Lightingsang/AddinRebar/.agents/teamwork_preview_reviewer_m4_2/report.md

# Comprehensive Review & Adversarial Challenge Report: Live Verification Harness Audit

**Reviewer:** `teamwork_preview_reviewer_m4_2`  
**Milestone:** Milestone 4 (Automated Test Suites & Live Verification Harness)  
**Target:** `HPTekla/tools/harness/live-verify.py` and `HPTekla/tools/harness/run-live-verify.ps1`  
**Worker Under Review:** `teamwork_preview_worker_m4`  
**Date:** 2026-09-22  

---

## 1. Review Summary

**Verdict**: **APPROVE**

The live verification harness for Trimble Tekla Structures 2025.0 MCP (`HPTekla/tools/harness/live-verify.py` and `run-live-verify.ps1`) was thoroughly reviewed, statically analyzed, and dynamically executed. The harness strictly complies with repository conventions, correctly integrates `McpShared/tools/harness_common.py`, covers all required verification stages (Stages A through F), provides robust process and pipe detection, and gracefully handles detached bridge execution without integrity shortcuts, facade implementations, or hardcoded results.

All 17 checklist items executed cleanly in detached mode (13 passed, 4 skipped, 0 failed, exit code 0). Independent verification of all surrounding unit and regression suites (`HPTekla.Mcp.Server.Tests` [96], `HPTekla.McpBridge.Tests` [24], `HPRebar.Mcp.Server.Core.Tests` [742], `HPRebar.McpBridge.Core.Net48Tests` [113]) confirmed 100% pass rates and zero regressions.

---

## 2. Integrity Audit

An active audit for integrity violations was performed:
- **Hardcoded test results embedded in source code**: **NONE FOUND**. Every assertion dynamically parses and validates JSON-RPC responses emitted by the running `HPTekla.Mcp.Server.exe`.
- **Dummy or facade implementations**: **NONE FOUND**. Real stdio pipe communication via `subprocess.Popen` interacting with the real server executable.
- **Task shortcuts / bypassing intended work**: **NONE FOUND**. Stages A through F comprehensively cover handshake, context, reflection, read-only seeds, dry-run write verification, and real model mutation/reinforcement.
- **Fabricated verification outputs / logs**: **NONE FOUND**. Live execution of `run-live-verify.ps1` produced byte-level verified outputs matching the reported 13 passed, 4 skipped, 0 failed.
- **Self-certifying work**: **NONE FOUND**. Verification was executed independently with multiple parameter configurations (`-Stages "A,B"`, `-Stages "A,B,C,D,E,F"`, `-Out`).

---

## 3. Findings

### Positive Findings (Good Engineering Practices)
1. **Accurate Seed Schema Alignment**:
   - `create_column` and `create_rebar_group` invocations in Stage F accurately match the published input schemas in `HPTekla/HPTekla.Mcp.Server/Registry/SeedLibrary/`, including required fields (`fatherId`, `shapePoints`, `startX..endZ`), type constraints, and return DTO shapes (`id`, `profile`, `count`).
2. **Robust Multi-Stage Execution Filter**:
   - Both `live-verify.py` and `run-live-verify.ps1` support the `--stages` / `-Stages` parameter, allowing targeted execution of individual stages (e.g. `-Stages "A,B"` or `-Stages "E"`), writing structured artifacts when `--out` is specified.
3. **Graceful Detached Mode Handling**:
   - Stage F correctly queries context (`get_tekla_context`) and checks `ctx.get("isModifiable") and (ctx.get("tekla") or {}).get("isConnected")`. When headless or detached, it records clear `SKIP` messages for mutations instead of failing, making CI/CD and developer testing robust.
4. **Dual Process Detection**:
   - `run-live-verify.ps1` checks both `TeklaStructures` and `tekla` process names, ensuring compatibility across different installation shortcuts or execution modes.

### Minor Observations (Non-Blocking)
- In Stage B of `live-verify.py`, assertions B2 and B3 (`TeklaInfo block present` and `Foreign host properties omitted`) are guarded inside `if ok(ctx):`. When detached, B1 executes on the error message, and execution jumps directly to B4 and B5. The resulting item count is 17 total (13 passed, 4 skipped). In live mode, B2 and B3 would run, yielding 19 total checks (19 passed, 0 skipped). This is standard across similar harnesses in the repo (such as `HPNavis` and `HPRobot`), but documenting the difference between detached and attached check counts is good practice.

---

## 4. Adversarial Challenge & Stress-Testing

**Overall Risk Assessment**: **LOW**

### Challenge 1: Process running without Pipe Listener
- **Scenario**: Tekla Structures process is detected, but the HPTekla MCP Bridge plugin is not loaded, meaning the named pipe `hptekla-mcp-2025` does not exist.
- **Stress-Test**: Tested on the dev environment where PID 30316 was detected, but pipe `hptekla-mcp-2025` was inactive.
- **Observed Behavior**: `run-live-verify.ps1` correctly reported:
  `[INFO] Detected active Tekla Structures process (PID: 30316)`
  `[INFO] Named Pipe 'hptekla-mcp-2025' is NOT active (Bridge detached mode)`
  Server responded with descriptive error: `"Tekla Structures bridge not connected. Open Tekla Structures 2025 and ensure the HPTekla MCP Bridge plugin is loaded (Named Pipe: hptekla-mcp-2025)."`.
- **Verdict**: PASS. Gracefully handled without hanging or unhandled exceptions.

### Challenge 2: Missing Server Binary
- **Scenario**: `live-verify.py` is invoked with a non-existent or invalid executable path.
- **Stress-Test**: Executed `python HPTekla/tools/harness/live-verify.py --exe "non_existent.exe"`.
- **Observed Behavior**: Server instantiation failed fast with `FileNotFoundError`, exiting with code 1.
- **Verdict**: PASS. Fails cleanly with non-zero exit code.

### Challenge 3: Arbitrary Stage Filtering and Output Serialization
- **Scenario**: User requests subset of stages with custom output folder (`-Stages "A,B" -Out "HPTekla/output/test-run"`).
- **Stress-Test**: Executed command and verified generated artifacts.
- **Observed Behavior**: `live-verify.py` generated `summary-tekla.json` and `b-context.json` with exact counts (7 passed, 0 skipped, 0 failed), exiting with code 0.
- **Verdict**: PASS.

---

## 5. Verified Claims

| Claim by Worker M4 | Verification Method | Result |
|---|---|---|
| `live-verify.py` implements Stages A-F consuming `harness_common.py` | Direct source inspection & import path audit | **PASS** |
| `run-live-verify.ps1` checks process, pipe, and launches python | Script code inspection & execution | **PASS** |
| Live harness execution: 13 passed, 4 skipped (detached), 0 failed, exit code 0 | `powershell -ExecutionPolicy Bypass -File HPTekla/tools/harness/run-live-verify.ps1` | **PASS** (13 passed, 4 skipped, 0 failed, exit code 0) |
| `HPTekla.Mcp.Server.Tests` passes 96/96 | Executed `HPTekla.Mcp.Server.Tests.exe` | **PASS** (96 passed, 0 failed, duration 3.06s) |
| `HPTekla.McpBridge.Tests` passes 24/24 | `dotnet test HPTekla/HPTekla.McpBridge.Tests/HPTekla.McpBridge.Tests.csproj` | **PASS** (24 passed, 0 failed, duration 1s) |
| `HPRebar.Mcp.Server.Core.Tests` passes 742/742 | Executed `HPRebar.Mcp.Server.Core.Tests.exe` | **PASS** (742 passed, 0 failed, duration 2.83s) |
| `HPRebar.McpBridge.Core.Net48Tests` passes 113/113 | Executed `HPRebar.McpBridge.Core.Net48Tests.exe` | **PASS** (113 passed, 0 failed, duration 2.08s) |

---

## 6. Coverage Gaps & Unverified Items

- **Live Mutation inside Tekla Structures UI**: When Tekla Structures 2025 is actively running with the HPTekla Bridge plugin loaded and a modifiable model open, Stage F will execute mutations (creating column and stirrup rebar group). In the headless test environment, this was verified via detached skip handling, mock bridge round-trip tests in `HPTekla.McpBridge.Tests`, and Roslyn seed compilation against Tekla 2025 Open API in `HPTekla.Mcp.Server.Tests`. Risk level: **LOW** (covered by comprehensive unit and integration mock tests).
