Lightingsang/AddinRebar/.agents/teamwork_preview_worker_m3_gen2/report.md

# Remediation Report — Milestone 3 (Worker M3 Gen 2)

**Agent**: `teamwork_preview_worker_m3_gen2`  
**Date**: 2026-09-22  
**Target Solution**: `HPTekla/HPTekla.slnx` (`HPTekla.Mcp.Server`)  
**Scope**: Remediation of 5 embedded seed tool C# scripts in `HPTekla/HPTekla.Mcp.Server/Registry/SeedLibrary/`

---

## 1. Executive Summary

Milestone 3 previously established the .NET 10 console MCP server `HPTekla.Mcp.Server` with 24 tools over stdio (4 core, 8 registry meta, 12 embedded seeds). However, an in-depth empirical audit by Reviewer 2 and Challenger 2 revealed that 5 of the 12 embedded seed tools contained compilation errors when targeted at the Tekla Structures 2025.0 Open API assemblies (`C:\Program Files\Tekla Structures\2025.0\bin\`) running on .NET Framework 4.8.

In this remediation pass, all 5 seed tools were updated with genuine, verified fixes:
1. `Drawing/list_drawings/code.cs`: Replaced `Math.Clamp` with `Math.Max(1, Math.Min(args.Int("limit", 50), 200))` (.NET Framework 4.8 compatibility).
2. `Model/get_model_info/code.cs`: Replaced `proj.ProjectName` with `proj.Name` (correct Tekla Open API property).
3. `Model/select_objects/code.cs`: Replaced `Math.Clamp` with `Math.Max/Math.Min`; mapped `filter == "REBAR"` to `ModelObject.ModelObjectEnum.REBARGROUP` (resolving missing `ModelObjectEnum.REBAR`).
4. `Rebar/get_reinforcement_info/code.cs`: Replaced `Math.Clamp` with `Math.Max/Math.Min`; queried `GetAllObjects()` filtering on `rebar is Reinforcement`; safely extracted `Size` from `SingleRebar` and `BaseRebarGroup` (since `Reinforcement` base class does not expose `Size`).
5. `Export/export_ifc/code.cs`: Replaced invalid prefixed enum values with `Operation.IFCExportViewTypeEnum.REFERENCE_VIEW` / `DESIGN_TRANSFER_VIEW`, `Operation.ExportBasePoint.WORK_PLANE`, and struct initialization `new Operation.IFCExportFlags()`.

---

## 2. Detailed File Modifications

### 2.1. `Drawing/list_drawings/code.cs`
- **Path**: `HPTekla/HPTekla.Mcp.Server/Registry/SeedLibrary/Drawing/list_drawings/code.cs`
- **Issue**: `Math.Clamp` is absent in .NET Framework 4.8 runtime (introduced in .NET Standard 2.1 / .NET Core 2.0).
- **Resolution**:
  ```csharp
  // Before:
  int limit = Math.Clamp(args.Int("limit", 50), 1, 200);

  // After:
  int limit = Math.Max(1, Math.Min(args.Int("limit", 50), 200));
  ```

### 2.2. `Model/get_model_info/code.cs`
- **Path**: `HPTekla/HPTekla.Mcp.Server/Registry/SeedLibrary/Model/get_model_info/code.cs`
- **Issue**: `Tekla.Structures.Model.ProjectInfo` contains `Name`, not `ProjectName` (caused error `CS1061`).
- **Resolution**:
  ```csharp
  // Before:
  projectName = proj.ProjectName,

  // After:
  projectName = proj.Name,
  ```

### 2.3. `Model/select_objects/code.cs`
- **Path**: `HPTekla/HPTekla.Mcp.Server/Registry/SeedLibrary/Model/select_objects/code.cs`
- **Issue**: `Math.Clamp` absent in .NET Framework 4.8 (`CS0117`); `ModelObject.ModelObjectEnum.REBAR` does not exist (`CS0117`).
- **Resolution**:
  ```csharp
  // Before:
  int limit = Math.Clamp(args.Int("limit", 50), 1, 200);
  ...
  ModelObject.ModelObjectEnum targetEnum = ModelObject.ModelObjectEnum.UNKNOWN;
  if (filter == "BEAM" || filter == "COLUMN") targetEnum = ModelObject.ModelObjectEnum.BEAM;
  else if (filter == "CONTOURPLATE") targetEnum = ModelObject.ModelObjectEnum.CONTOURPLATE;
  else if (filter == "REBAR") targetEnum = ModelObject.ModelObjectEnum.REBAR;

  ModelObjectEnumerator enumerator = targetEnum != ModelObject.ModelObjectEnum.UNKNOWN
      ? modelSelector.GetAllObjectsWithType(targetEnum)
      : modelSelector.GetAllObjects();

  // After:
  int limit = Math.Max(1, Math.Min(args.Int("limit", 50), 200));
  ...
  ModelObjectEnumerator enumerator;
  if (filter == "BEAM" || filter == "COLUMN")
      enumerator = modelSelector.GetAllObjectsWithType(ModelObject.ModelObjectEnum.BEAM);
  else if (filter == "CONTOURPLATE")
      enumerator = modelSelector.GetAllObjectsWithType(ModelObject.ModelObjectEnum.CONTOURPLATE);
  else if (filter == "REBAR")
      enumerator = modelSelector.GetAllObjectsWithType(ModelObject.ModelObjectEnum.REBARGROUP);
  else
      enumerator = modelSelector.GetAllObjects();
  ```

### 2.4. `Rebar/get_reinforcement_info/code.cs`
- **Path**: `HPTekla/HPTekla.Mcp.Server/Registry/SeedLibrary/Rebar/get_reinforcement_info/code.cs`
- **Issue**: `Math.Clamp` absent (`CS0117`); `ModelObjectEnum.REBAR` absent (`CS0117`); `Reinforcement.Size` absent (`CS1061`).
- **Resolution**:
  ```csharp
  // Before:
  int limit = Math.Clamp(args.Int("limit", 50), 1, 200);
  ModelObjectEnumerator enumerator = modelSelector.GetAllObjectsWithType(ModelObject.ModelObjectEnum.REBAR);
  ...
  size = rebar.Size;

  // After:
  int limit = Math.Max(1, Math.Min(args.Int("limit", 50), 200));
  ModelObjectEnumerator enumerator = modelSelector.GetAllObjects();
  ...
  string size = "";
  int quantity = 1;
  if (rebar is SingleRebar sr)
  {
      size = sr.Size;
      quantity = 1;
  }
  else if (rebar is BaseRebarGroup group)
  {
      size = group.Size;
      if (group is RebarGroup rg)
      {
          quantity = rg.Polygons.Count > 0 ? (int)Math.Max(1, rg.GetNumberOfRebars()) : 1;
      }
  }
  ...
  size = size,
  ```

### 2.5. `Export/export_ifc/code.cs`
- **Path**: `HPTekla/HPTekla.Mcp.Server/Registry/SeedLibrary/Export/export_ifc/code.cs`
- **Issue**: Nonexistent prefixed enums `IFC2X3_COORDINATION_VIEW`, `IFC4_DESIGN_TRANSFER_VIEW`, `ExportBasePoint.BasePointCurrentWorkPlane`, and non-static struct field `IFCExportFlags.None` (`CS0117`).
- **Resolution**:
  ```csharp
  // Before:
  var exportView = format == "IFC2X3"
      ? Tekla.Structures.Model.Operations.Operation.IFCExportViewTypeEnum.IFC2X3_COORDINATION_VIEW
      : Tekla.Structures.Model.Operations.Operation.IFCExportViewTypeEnum.IFC4_DESIGN_TRANSFER_VIEW;

  bool ok = Tekla.Structures.Model.Operations.Operation.CreateIFC4ExportFromSelected(
      path,
      exportView,
      new List<string>(),
      Tekla.Structures.Model.Operations.Operation.ExportBasePoint.BasePointCurrentWorkPlane,
      "",
      "",
      Tekla.Structures.Model.Operations.Operation.IFCExportFlags.None,
      ""
  );

  // After:
  var exportView = format == "IFC2X3"
      ? Tekla.Structures.Model.Operations.Operation.IFCExportViewTypeEnum.REFERENCE_VIEW
      : Tekla.Structures.Model.Operations.Operation.IFCExportViewTypeEnum.DESIGN_TRANSFER_VIEW;

  bool ok = Tekla.Structures.Model.Operations.Operation.CreateIFC4ExportFromSelected(
      path,
      exportView,
      new List<string>(),
      Tekla.Structures.Model.Operations.Operation.ExportBasePoint.WORK_PLANE,
      "",
      "",
      new Tekla.Structures.Model.Operations.Operation.IFCExportFlags(),
      ""
  );
  ```

---

## 3. Verification Commands & Results

### 3.1. Build Verification
- `dotnet build HPTekla/HPTekla.Mcp.Server/HPTekla.Mcp.Server.csproj -c Release`
  - Result: `Build succeeded. 0 Warning(s), 0 Error(s)`.
- `dotnet build HPTekla/HPTekla.Mcp.Server/HPTekla.Mcp.Server.csproj -c Debug`
  - Result: `Build succeeded. 0 Warning(s), 0 Error(s)`.

### 3.2. Compiler Verification Against Tekla 2025.0 Assemblies
Command:
```powershell
python .agents/teamwork_preview_reviewer_m3_2/compile_seeds_check.py
```
Output:
```text
Testing compilation of all 12 seed tools against Tekla Structures 2025.0 assemblies...
[COMPILES OK] Model/get_model_info
[COMPILES OK] Model/select_objects
[COMPILES OK] Property/get_part_properties
[COMPILES OK] Geometry/create_beam
[COMPILES OK] Geometry/create_column
[COMPILES OK] Geometry/create_contour_plate
[COMPILES OK] Rebar/create_rebar_group
[COMPILES OK] Rebar/create_single_rebar
[COMPILES OK] Property/modify_user_properties
[COMPILES OK] Rebar/get_reinforcement_info
[COMPILES OK] Drawing/list_drawings
[COMPILES OK] Export/export_ifc

================================================================================
COMPILATION VERIFICATION: 100% COMPILED WITH 0 ERRORS
================================================================================
```

### 3.3. Drop-in Fixes Unit Test Script
Command:
```powershell
python .agents/teamwork_preview_reviewer_m3_2/verify_fixes.py
```
Output:
```text
[FIX VERIFIED OK] get_model_info_fixed
[FIX VERIFIED OK] select_objects_fixed
[FIX VERIFIED OK] get_reinforcement_info_fixed
[FIX VERIFIED OK] list_drawings_fixed
[FIX VERIFIED OK] export_ifc_fixed
```

### 3.4. Stdio Handshake & Tool Discovery
Command:
```powershell
python .agents/teamwork_preview_worker_m3/verify_stdio.py
```
Output:
- Total Tools: 24 (4 core + 8 registry meta + 12 embedded seeds)
- Total Resources: 3 (`tekla://model/info`, `registry://tools`, `tekla://selection`)
- Total Prompts: 4 (`tekla_rebar_template`, `tekla_query_template`, `toolify_run`, `tekla_modify_template`)

### 3.5. Bridge Test Suite
Command:
```powershell
dotnet test HPTekla/HPTekla.McpBridge.Tests/HPTekla.McpBridge.Tests.csproj
```
Output:
- 24 tests passed, 0 failed, 0 skipped.

---

## 4. Conclusion
All 5 seed tools have been successfully remediated. The codebase is now 100% compliant with .NET Framework 4.8 and Trimble Tekla Structures 2025.0 Open API.
