Lightingsang/AddinRebar/plans/reports/code-review-2026-09-17-aec-phase-g.md

# Code review — AEC Automation MCP (AutoCAD), phase G: MEP

Date 2026-09-17 · Plan `plans/260916-1140-aec-automation-mcp-autocad/` · Scope: `HPAutoCad.Aec` `Mep/{MepModel,MepNetworkBuilder,MepChecks}.cs`, `Cad/MepService.cs`, `AecTools.Mep.cs`, 3 seeds under `Registry/SeedLibrary/MEP/`, `AutocadHostProfile` (+MEP), `SeedLibraryTests` (43 seeds, shared detection pin), `HostProfileTests`, `MepTests` (4), harness step V (`aec-tools-live.py`).

Verified: `dotnet build HPAutoCad.slnx -c Debug -p:DeployBundle=false` 0 warnings · `dotnet test HPAutoCad.Aec.Tests` 195/195 · `dotnet test HPAutoCad.Mcp.Server.Tests` 241/241 · live harness not re-run (82/82 of 2026-09-17 taken as given; saved output `output/aec-tools-live/mep.json` read) · a scratchpad console against the built `HPAutoCad.Aec.dll` drove `MepNetworkBuilder.Build`, `MepChecks.Check`, `MepService.SystemOf/Describe` with synthetic `MepRun`/`MepNode`s (probes P1–P21, PERF A–E below) and serialised the envelopes with the bridge's options (camelCase + IgnoreCycles + WhenWritingNull; cap 65 536 B, budget 60 000 B).

> **Status 2026-09-17: fixed** — H1, H2, M1–M7, L1–L9 applied (see `plans/260916-1140-aec-automation-mcp-autocad/reports/phase-G-mep-live.md` § Review round); double-line ducts warned, not paired (as recommended); L10 closed by the report. Tests 197 + 241, live 83/83 + 89/89.

## Score: 5.5 / 10

The graph core does what the description says where it was probed: end-to-end joins, tees onto a body, ends inside a node box, crossings counted once per run pair and never connected, three stacked runs = three duplicates, a branch at the joint of two collinear mains joined to both, a zig-zag crossing twice = one crossing, `nearMissMm` below `endpointConnection` refused, near-miss partner chosen among runs and nodes, networks longest-first with ids stable on reversed input, issues after `AuditIssue.Ordered` with `MEP-nnn`, seeds thin shims with the three caps pinned, the shared `detection` block pinned across the three tools, culture-invariant descriptions, files ≤ 154 lines. Held back by two semantic defects that hit the default path of every real plan — a node a run passes *through* (an inline valve, pump, VAV, FCU drawn on a continuous line) is an `orphan_node` because nodes are only tested against run ends (H1); and a node merges every system that touches it, so supply + return + ducts through one AHU are one `mixed` network with a `mixed_system` info, on every piece of equipment (H2) — plus a 2 mm-off duplicate copy that reads as a tee with nothing reported (M1), two issues per facing gap (M2), an O(networks × endpoints) group loop that takes 21 s at the guard on disconnected runs and an O(pairs × segments²) pair phase (M3), and envelopes over the budget at the caps for `connectedTo`/`mixed_system` (M4).

## Findings

### High

| # | Where | Problem | Failure scenario | Pin |
|---|---|---|---|---|
| H1 | `Mep/MepNetworkBuilder.cs:59-70` (nodes tested only against the two run *ends*), `:97-101` (a node no end touched is an orphan), `MepChecks.cs:60-62`, seed `mep_connectivity_check` ("orphan_node … no run reaches") | A node the run passes through is never attached. P1: a 300 mm valve block and a 600 mm pump block centred on a continuous 10 m pipe → `orphans=[PUMP,VALVE]`, `orphan_node [PUMP] warning "equipment PUMP … no run reaches it"`, `orphan_node [VALVE] info`. P15: equipment the run crosses mid-body → warning. P19: a VAV box on the main with the branch ending inside it → **two networks** (`MAIN` alone; `BR+VAV`) although the main runs through the VAV. Inline valves, dampers, pumps, VAVs, FCUs drawn on an unbroken line are the norm in plumbing/HVAC plans. | `mep_connectivity_check {}` on a plumbing floor: one `orphan_node` info per inline valve (100+), one warning per inline pump/strainer/meter ("Draw the run to it"); `mep_detect_network` splits networks at every inline unit and lists the unit under `orphanHandles`. | xUnit: a fitting box centred on a continuous run → not an orphan, in the run's network; equipment the main passes through with a branch ending inside → one network. Fix: after the end pass, for every node query `runIndex` with the node's bounds expanded by `tol.EndpointConnection`, union when any run segment comes within `EndpointConnection` of the node's boundary or has a vertex inside it (`IntersectXY` against the ring's segments / `ContainsPointXY`); record the attachment (`end` / `inline`) on the node; `orphan_node` only when neither. |
| H2 | `MepNetworkBuilder.cs:67` (`union.Join(i, runs.Count + j)` whatever the systems), `MepModel.cs:78` (`System` = "mixed" when > 1), `MepChecks.cs:68-70`, `AecTools.Mep.cs:128` (`mixedNetworks`), plan phase G "networks by system" | A node unions every run that touches it, so systems merge through equipment. P2: CHWS + CHWR pipes and SA + RA ducts into one AHU → `N-001 system=mixed systems=[M-CHWR, M-CHWS, M-DUCT-RETN, M-DUCT-SUPL]` + `mixed_system` info "Check whether the runs really connect (a supply drawn onto a return) or whether the layers of one system are misnamed". Supply and return always meet at equipment; ducts and pipes always meet at an AHU/FCU. With the default (system = layer) every equipment-served network is mixed; a `detection.systems` map cannot help across disciplines. `bySystem` (per run) stays right, `items[].system`, `mixedNetworks` and the `mixed_system` list do not; the tool never delivers "networks by system". | `mep_detect_network {}` on an HVAC floor: one network per AHU cluster, every one `mixed`; `mep_connectivity_check {}` → one `mixed_system` info per AHU/FCU/pump (dozens), hiding the one real "supply drawn onto a return", which the description says the type is for. | xUnit: P2 → separate networks per system (CHW map: 2 networks — CHW pipes, and SA/RA still 2 unless mapped), `mixedNetworks 0`, no `mixed_system`; a CHWS run teeing into a CHWR run → one `mixed_system`. Fix: union runs through a node only when they share a system (group the node's touching runs by `run.System`); a node belongs to every network that touches it (listed in each `nodeHandles`); `mixed_system` fires only on run-to-run (joined/tee) connections across systems — exactly what the description promises. |

### Medium

| # | Where | Problem | Failure scenario | Pin |
|---|---|---|---|---|
| M1 | `MepNetworkBuilder.cs:125` (`IntersectXY(s, t, tol.PointEquality)` must return `Overlap` — collinear within 0.5 mm; `tol.Duplicate` only thresholds the overlap length), `:49-52` (an end within 10 mm of a body is a tee) | An offset copy is a tee, not a duplicate. P3: a 4 m copy of the main 2 mm off-axis → `COPY` ends `tee` to `MAIN` at both ends, `duplicates=0`, nothing reported, network `lengthMm` 14 000 for a 10 m main; at 0.4 mm it is a `duplicate_run`. The phase E M4 lesson (a copy not snapped is the common drafting artefact). | Copied runs a few mm off: no `duplicate_run`, totals inflated, both ends of the copy "connected". | xUnit: 2 mm-offset copy → `duplicate_run 4000`, ends not `tee`. Fix: a pair parallel within `parallelAngle` with offset ≤ `endpointConnection` and shared run > `tol.Duplicate` is a duplicate (compute the shared run by projection, as `CollinearOverlapXY` does); an end landing on a run its own segment is parallel to over > `tol.Duplicate` is not a tee. |
| M2 | `MepChecks.cs:49-53` (one `near_miss` per open end), `MepNetworkBuilder.cs:56,73` (each end finds the other) | A gap between two facing open ends is two issues naming each other. P21: `CHWS` end and `CHWR` start 30 mm apart → `MEP-001 near_miss [CHWR,CHWS] 30` + `MEP-002 near_miss [CHWS,CHWR] 30`; `summary.nearMisses = 2`. Two pipe pieces not snapped end to end is the most common gap. Phase F M2 class. | 40 unsnapped joints → 80 warnings, `nearMisses` doubled; `create_issue_markup` clouds every gap twice. | xUnit: P21 → one `near_miss`, both handles, location at the midpoint. Fix: when both ends are open and each is the other's nearest, emit once (unordered pair). |
| M3 | `MepNetworkBuilder.cs:99-106` (`endpoints.Where(e => e.IsOpen && handles.Contains(e.RunHandle))` per group — O(networks × endpoints), no `ct`), `:81-91` + `:120-136` (`LongestOverlap` and `Crosses` each walk `a.Segments × b.Segments` with no bounds check; `seen` is redundant — `Query` de-duplicates and `k <= i` skips) | PERF A: 20 000 disconnected 400 mm runs → **20.8 s** (5 000 → 1.0 s; 20 000 runs in 100 chains → 0.3 s) — the cost is the group loop, and it ignores `cancel_execution`. PERF D: 60 arcs (113 vertices each) whose bounds overlap → 5.5 s; PERF E: 200 sixty-vertex polyline routes in one plant room → 10.1 s; 400 stacked arcs → 237 s. The seed timeout is 60 s and `MaxElements` admits 20 000. | A tray/pipe plan drafted as thousands of unsnapped LINEs (the input a connectivity check exists for) or a plant room of long polyline routes / sampled arcs → 20–60 s on AutoCAD's main thread, uncancellable in the group phase. | Test: 20 000 disconnected runs < 2 s; 200 × 60-vertex routes < 2 s. Fix: group open ends by run handle once (dictionary) and build `open` per network from it; in the pair phase test segment bounds (or a per-shape segment index above ~16 segments) and compute overlap + crossing in one walk; `ct` in the group loop; drop `seen`. |
| M4 | `MepModel.cs:70` (`ConnectedTo` uncapped), `Cad/MepService.cs:121`, `MepChecks.cs:69` (`mixed_system` 8 handles + every system name in the description), `MepTests.cs:129` (3 `connectedTo`), no issues-page size test | Envelopes at the caps: `mep_endpoint_check` 200 endpoints with `connectedTo` of 6 handles → 57.9 KB (6-char handles), **64.3 KB** (10-char); 8 handles → **61.5 KB** (6-char). A header/manifold where 6–8 runs start at one point is ordinary. Issues page 100 × `mixed_system` (8 handles, 8 systems) → **61.0–65.8 KB**; 5 systems, 10-char handles 59.5 KB — at the budget; under H2 semantics `mixed_system` pages are realistic. | `mep_endpoint_check {includeConnected: true}` on a manifold plan → head-as-text; page 2+ of `mep_connectivity_check` on a plan with many AHUs → over the cap. | Size tests: endpoints at 200 with 8 `connectedTo`; issues at 100 `mixed_system` with 8 systems and 10-char handles < 60 000. Fix: cap `connectedTo` at 4 + `connectedCount`; `mixed_system` handles 4 and systems in the description ≤ 4 ("… and N more"). |
| M5 | `AecTools.Mep.cs:43` (the "no runs found" warning is in `MepDetectNetwork` only), `MepChecks.cs:60-62` (orphans reported whatever `Runs`) | With no runs (fixtures-only plumbing layout, the wrong layer names, `filter.layers` naming the equipment layer) `mep_connectivity_check` lists every fixture/terminal/equipment as an `orphan_node` **warning** and `mep_endpoint_check` says nothing. Phase E M2 class. | A fixture layout with 200 WC/basin blocks and no pipes → 200 warnings over two pages, `success: true`. | Test: `Runs == 0` → the same warning in all three tools and no `orphan_node` (or info). |
| M6 | Seed descriptions (nothing on drafting style; "a duct drawn as a closed rectangle is not a run here"), `Cad/MepService.cs:67` (only closed shapes are set aside) | Double-line ducts — how most 2D HVAC plans are drawn — read as two side-line networks. P9: a duct with an elbow drawn as four side lines → `N-001 [S2,S4]`, `N-002 [S1,S3]`, 4 open ends for 2 real ends, `lengthMm` doubled, no hint. | `mep_detect_network {}` on a double-line HVAC plan: networks per duct side, every real end twice under `open_end`, `totalLengthMm` ×2. | Description: single-line (centreline) drafting. Heuristic warning: when > 30 % of duct runs have a parallel duct run within ~1 500 mm over > 50 % of their length, warn "double-line duct drafting: networks and open ends are per side". Pairing sides into centrelines is a product decision (Unresolved). |
| M7 | `MepNetworkBuilder.cs:47` (`if (k == i) continue;` — the run's own body excluded from both the connection and the nearest search) | A ring main drawn as one polyline whose ends stop 60 mm apart (P4) is `disconnected_run` "connects to nothing at either end" with no near miss; a P-shaped polyline whose end lands on its own body (P5) is likewise disconnected. Phase F M3 class. | An almost-closed loop → the wrong issue type and no gap size; a loop drawn as one polyline is "loose at both ends". | xUnit: P4 → `near_miss 60` (or one `boundary`-style gap); P5 → the end `tee` onto its own body. Fix: test an end against its own segments except the adjacent one, and against its own other end. |

### Low

| # | Where | Problem |
|---|---|---|
| L1 | `MepNetworkBuilder.cs:89` (`MepDuplicate(runs[i].Handle, runs[k].Handle)` in input order), `:56,69` (`d < nearestGap` — first encountered wins a tie) | P16: reversed input → the same duplicates with `handles[0]`/`[1]` swapped → different `AuditIssue.Ordered` order and ids (networks and counts stable). Order the pair by handle; tie-break the nearest by handle. |
| L2 | `Cad/MepService.cs:35-40` (`SystemOf`: first declared pattern wins), `:22-33` (`ParseSystems` accepts a blank key after `Trim`) | P13/P13b: `{CHW:[M-CHW*], HHW:[M-*]}` → `M-CHWS` is CHW; reversed declaration → HHW. Undocumented; document "first match in declaration order" or refuse overlapping patterns; refuse blank system names. |
| L3 | `Cad/MepService.cs:47-56` (`examined` = pass 1; `Classify` builds the text index on each pass), `AecTools.Mep.cs:111` (one truncation text for both passes), `EntityQueryService.TryBuildSelection` (block names never reach the selection engine) | `mep.json`: `examined: 10` while pass 2 scanned every INSERT; the second pass post-filters *every* INSERT in the space by name, so on a furnished plan it hits `maxCandidates` first and the warning blames "runs beyond it"; the text index is built twice per call though no MEP rule uses text (`UsesNearbyText` is set-wide) — pass `(TextIndex.Empty, false)`; sum both passes into `examined`. |
| L4 | Rule set `m-duct-run` / `e-tray-run` (no `ARC`, no `SPLINE` anywhere; `m-duct-run` has no `closed: false`), `m-fitting-block` (`CO-*`, `*-CO-*` on any layer), no riser/cap rule | Description says "open lines, polylines, arcs" for all three run kinds — a curved duct/tray as an ARC is not a run; flex ducts (SPLINE) never are, so their diffusers are orphans; a closed outline on a duct layer is counted under `closedRunsIgnored`, on a pipe layer it is Unknown and not counted; a pipe ending at a riser circle (`M-PIPE-RISR`) is an `open_end`; any `CO-…` block anywhere becomes a Fitting → `orphan_node` info. |
| L5 | `Cad/MepService.cs:64-68` (only `IsPoint` skipped) | P8: a zero-length LINE is a run — alone it is `disconnected_run "0 mm"`, at a junction it joins the network. Drop runs shorter than `tol.TinySegment` with a `tinyRunsIgnored` count. |
| L6 | `Cad/MepService.cs:42` (no check), cf. `RoomService.cs:28` | `filter.space: "all"` merges model and every layout into one graph (riser diagrams in layouts share coordinates with the model). Refuse as the rooms do, or group by space. |
| L7 | `AecTools.Mep.cs:105` (`<` refused, `==` allowed), `MepNetworkBuilder.cs:73` | `nearMissMm == endpointConnection` disables near misses: P14 (10.5 mm gap, nearMissMm 10) → two `disconnected_run`. Say so in the description or require `>`. |
| L8 | `MepChecks.cs:69` (`n.BoundsMm.Center`), `AecTools.Mep.cs:126` (`bySystem` top 20), `SeedLibraryTests.cs:68-70` (comment lists 14 read-only seeds), seed schema `detection.systems` (`type: object`, no `additionalProperties`) | `mixed_system` location may lie on no run; `bySystem` cut undocumented; stale test comment; the AI cannot see the `systems` value shape (`{name: [wildcards]}`) except from example 2 — add `additionalProperties: {type: array, items: {type: string}}`. |
| L9 | `MepNetworkBuilder.cs:72` (`joined` > `tee` > `node`) | P6: two branches starting at one point on the main read `joined` (to each other) though what matters is the tee onto `MAIN` (in `connectedTo`). State = the first thing found; consider ranking the body connection or listing states. Cosmetic. |
| L10 | `phase-G-mep-network.md` (`status: pending`, success criterion unchecked), `plan.md:32` (pending), no `reports/phase-G-mep-live.md` | For the lead/project-manager, not a code finding. |

## Description ⇔ code

| Seed | Mismatch |
|---|---|
| `mep_detect_network` | "open lines, polylines, arcs" — ARC only in the pipe rule, no SPLINE (L4); "touches a node" / node handling — a run *through* a node is not a connection (H1); "system (one, or mixed)" — mixed on every equipment-served network (H2); "runs that only cross each other … counted" ✓ once per pair; `runHandles`/`nodeHandles` first 16, `openEndsMm` first 8 ✓ (52 KB at 30 with 5 systems / 3 kinds / 4 node kinds); summary keys ✓ (+ `examined`, `nearMissMm`, `systems`, `ruleSet`; `bySystem` top 20 unsaid); `filter` "empty = model space, narrowed…" ✓ (`space` alone still narrows); `detection.nearMissMm` "must be ≥" — equal disables (L7); "max 30 networks per page" ✓ pinned. |
| `mep_connectivity_check` | `orphan_node` "no run reaches" — false for inline nodes (H1); `mixed_system` "a network joining runs of several systems" — every network with equipment (H2); `duplicate_run` "drawn over each other" — collinear within 0.5 mm only (M1); `near_miss` — twice per facing gap (M2); `disconnected_run` "one issue for a run loose at both ends with nothing near" ✓ (also requires no branch landing on it — say so); "severity order", `MEP-nnn`, `create_issue_markup` ✓ (markup is category-agnostic); "max 100 issues per page" — 61–66 KB with `mixed_system` items (M4). |
| `mep_endpoint_check` | Item fields ✓; "near misses first" ✓; `connectedTo` uncapped (M4); summary ✓ (+ `examined`, `runs`, `nearMissMm`, `includeConnected`); "max 200 endpoints per page" — over budget at 6+ `connectedTo` (M4). Example 2 (`filter.layers`, `includeConnected`) keys real ✓. |

All three: `transaction: none` ✓, one `AecTools.*` call, every key read with a literal ✓, `limit.maximum` = engine cap ✓, `detection` keys = `MepDetectionKeys` ✓, category `MEP` added and pinned ✓, earlier seeds unchanged (40 → 43, 23 → 26 read-only) ✓.

## Tests — what `MepTests` pins and what is missing

Pinned (4): join / tee / node / crossing with 2 networks and 5 open ends; near miss 50 mm + `disconnected_run` once + duplicate 4000 + orphan terminal warning / fitting info + `MEP-001` + `nearMissMm 20` hides the miss; `SystemOf` wildcards and case, a two-system network `mixed` + `mixed_system`, a parallel run of another system not a duplicate; networks page at 30 and endpoints page at 200 (3 `connectedTo`, 2 systems, one kind) < 60 000 B. `SeedLibraryTests` pins shim shape, `transaction`, "Read-only", `limit.maximum`, the shared detection block, 43 seeds / 26 read-only; `HostProfileTests` pins the category.

Missing: inline node (valve on a continuous run, run through equipment); supply/return through one node; offset duplicate (2 mm); facing-gap pairing; self-gap / end on own body; zero-length run; reversed-input determinism of issues; `MaxElements` refusal; cancellation in the group loop; timing at the guard (20 000 disconnected runs, 60-vertex routes); issues-page size (`mixed_system` with 8 systems); endpoints page with 8 `connectedTo`; `ParseSystems` (scalar instead of array → message, duplicate key, blank key); `Describe(endpoint)` for a run absent from `runs`; `nearMissMm == endpointConnection`; `Narrow` (no layered MEP rules → null; user rule with types only dropped). Harness V never sends `includeConnected` with `offset`, `ruleSet`, `visibleOnly`, `space`, a closed polyline on a run layer, a fitting block by name (pass 2 found nothing — `examined: 10`), an ARC run, an inline node, or two systems through one piece of equipment — so H1/H2 and `closedRunsIgnored` are not exercised live.

## Positive

`MepNetworkBuilder` is short and readable: one spatial-index pass per end with `reach = max(nearMissMm, endpointConnection)`, union-find with path halving, deterministic handle ordering everywhere (`Length` then ordinal), networks id'd after sorting by length so ids survive reversed input (probed), crossings counted once per run pair through `CrossesProperlyXY` (a tee onto a body is not a crossing; a zig-zag crossing twice is one), duplicates require the same system (case-insensitive) and the shared stretch is reported with `from`/`to`; `MepChecks` reuses `AuditIssue`/`Ordered`/`IssueSeverity` so `create_issue_markup` consumes MEP issues unchanged, folds a loose run into one `disconnected_run` instead of two open ends, keeps a main whose branches tee in "attached", uses `CultureInfo.InvariantCulture`; `MepService.Narrow` spends `maxCandidates` on MEP layers/types and fitting block names when the filter names none (the phase F M11 lesson applied) and warns when it narrowed, truncated or dropped closed outlines; `ParseSystems` refuses an empty pattern list and a duplicate key with clear messages; `ReadMep` rejects unknown `detection` keys and `nearMissMm` below the connection tolerance as `ArgumentException`s; the three seeds are thin shims with `MaxNetworkLimit 30` / `MaxIssueLimit 100` / `MaxEndpointLimit 200` pinned to the schema maxima, one shared detection block pinned by a test, and the harness pins counts, handles, the 50 mm gap, the layer map, `endpointConnection 60` merging the short branch, `includeConnected`, and the `nearMissMm` refusal; every file is under 160 lines.

## Recommended order

1. H1 + H2 (one change in `Build`: a node-attachment pass over runs whose segments touch or enter the node; union through a node per system; `orphan_node` only when neither an end nor a body reaches it; `mixed_system` on run-to-run joins across systems only) with the P1/P2/P15/P19 cases as tests.
2. M1 + M2 + M7 (offset duplicates by parallel projection; a self-body test excluding the adjacent segment; pair facing near misses) — tests P3, P4, P5, P21.
3. M3 + M4 (group open ends per run once; segment bounds in the pair phase; `ct`; `connectedTo` ≤ 4 + count; `mixed_system` 4 handles / 4 systems) with the timing and size tests.
4. M5 + M6 + the Lows (no-runs warning in all three tools; single-line statement + double-line heuristic; handle-ordered duplicates and tie-breaks; `space: all` refused; `examined` both passes; empty text index; ARC/SPLINE in the duct/tray rules; tiny runs dropped; `systems` schema value shape), then re-run V with an inline valve on the pipe main, supply + return + duct through one AHU block, a 2 mm-offset copy, two facing ends 30 mm apart, a fitting block named `VALVE-DN50`, a closed polyline on `M-DUCT`, and a double-line duct.

## Unresolved (user decision)

- M6: should double-line ducts be supported (pair parallel side lines within a duct-width band into a centreline run, so networks, lengths and open ends are per duct) or should the tools state single-line drafting and warn when they detect double lines? Recommended: warn now, pair later as its own phase — pairing changes what `runHandles` means.
