Lightingsang/AddinRebar/plans/reports/code-review-2026-09-17-aec-phase-f.md

# Code review — AEC Automation MCP (AutoCAD), phase F: architecture

Date 2026-09-17 · Plan `plans/260916-1140-aec-automation-mcp-autocad/` · Scope: `HPAutoCad.Aec` `Architecture/{RoomLoopFinder,WallGraph,Room,RoomBoundaryChecks,AreaSchedule,AutoDimensionRules}.cs`, `Cad/{RoomService,RoomWriteService(+.Dimensions),EditContext.Layers}.cs`, `AecTools.Architecture.cs`, 5 seeds under `Registry/SeedLibrary/Architecture/`, `AutocadHostProfile` (+Architecture), `SeedLibraryTests` (40 seeds), `ArchitectureTests` (9), harness steps R (`aec-tools-live.py`) and A (`aec-edit-tools-live.py`), the shared `EnsureLayer` refactor in `IssueMarkupService` / `StructuralWriteService`.

Verified: `dotnet build HPAutoCad.slnx -c Debug -p:DeployBundle=false` 0 warnings · `dotnet test HPAutoCad.Aec.Tests` 188/188 · `dotnet test HPAutoCad.Mcp.Server.Tests` 221/221 · live harness not re-run (73/73 + 86/86 of 2026-09-17 taken as given; saved output `output/aec-tools-live/architecture.json` read) · a scratchpad console against the built `HPAutoCad.Aec.dll` drove `RoomLoopFinder`, `RoomBoundaryChecks`, `RoomLabels`, `AreaSchedule`, `AutoDimensionRules`, `RoomWriteService.Render` with synthetic `WallSegment`s (22 probes, P1–P22 below) and serialised the envelopes with the bridge's options (camelCase + IgnoreCycles + WhenWritingNull; cap 65 536 B, budget 60 000 B).

> **Status 2026-09-17: fixed** — H1–H5, M1–M12, L1–L9, L11, L12, L14 applied (see `plans/260916-1140-aec-automation-mcp-autocad/reports/phase-F-architecture-live.md` § Review round); openings, gross area and the number pattern decided as recommended; L10, L13 documented, L15 closed by the report. Tests 191 + 222, live 75/75 + 89/89.

## Score: 5 / 10

The planar-graph core is right where it was probed: crossings, T-junctions, collinear overlaps and coincident duplicates cut and merge into one edge with both handles; a zig-zag (a wall crossing another twice) yields the four faces; a figure-8 pinch node gives two rooms; snapping cascades converge; every directed edge is walked exactly once so a face can neither repeat nor loop forever; 20 000 unit segments build and walk in 0.5 s; ids are stable on reversed input (pinned). The writes are two-phase in the right order (`SpaceId` → layer check → render every tag → `GetObject(ForWrite)` → `EnsureLayer` → append; `SetDatabaseDefaults` before `LayerId`; a refusal leaves the counter at 0 — the harness pins `count() == n_a`), the seeds are thin shims, the read caps are pinned, and the shared `EnsureLayer` is byte-equivalent to the two copies it replaced. Held back by five things that hit the tool's own target inputs: the loop finder has no notion of an opening, so any plan whose walls stop at doors yields zero rooms (single-line) or one merged room per floor (double-line with jambs) (H1); two correctly tiled room outlines are a `room_overlap` warning because `SpatialRelation.Overlaps` counts a shared boundary run, so a plan drawn with outlines gets one warning per adjacent pair (H2); the `Nested` rule drops the room for any inner enclosure — a closet hung off the wall by one partition, a shaft in a hall — and reports only the closet (H3); `arch_auto_dimension_plan` at `MaxDimensions` 200 serialises to 64–66 KB, over the budget and over the cap with 7-digit coordinates, with the dimensions committed (H4, third phase in a row for a write tool); and the overshoot rule silently swallows a real gap whenever the nearest wall's foot coincides with the chain's junction (a jamb 100 mm from a partition end) while it reports an angled overshoot as `open_boundary` critical (H5).

## Findings

### High

| # | Where | Problem | Failure scenario | Pin |
|---|---|---|---|---|
| H1 | `Architecture/RoomLoopFinder.cs:40-67` (faces of the wall graph only), `WallGraph.cs:81-120` (every free end peeled), seed `arch_detect_rooms/tool.json` description ("every bounded face … is a room"; no word on doors), rule set `a-wall-run` (walls only; `a-door-*` objects never enter the graph) | There is no notion of an opening. Probe P2 (single-line room, 900 mm door in one wall): **0 rooms**, two `open_boundary` criticals "no wall within reach". P2b (two rooms, doors in the party wall and the outer wall): 0 rooms, 3 open ends + 1 silent "overshoot". P2c (double-line walls, 200 thick, jamb lines closing the wall cavity at a 900 door): **1 room of 22.98 m²** = both rooms merged through the opening, the outer ring dropped as nested. Walls that stop at door openings are how most plans are drafted; the harness scene has no door in a wall. | `arch_detect_rooms {}` on a real floor plan → `rooms: 0` + one critical per jamb (single-line) or `rooms: 1` per connected block of rooms (double-line); `arch_generate_area_schedule` sums the whole floor into one row; `arch_create_room_tags` puts one tag on the corridor. Explicit outlines still work, which is why the harness passes. | xUnit: P2 → 1 room 24 m² with `openings: 1` (900 mm, S1→S2); P2c → 2 rooms. Fix (recommended, see Unresolved): after peeling, bridge pairs of open ends that face each other within `maxOpeningMm` (default 1 300; collinear within `parallelAngle`, or jamb-to-jamb across a double-line opening) with a virtual edge, re-walk, and report `openings[{fromHandle, toHandle, widthMm}]`; additionally let `Door`-classified objects (swing arc / block bounds) close the gap they sit in. Until then the description must say walls have to be continuous through doors. |
| H2 | `Architecture/RoomBoundaryChecks.cs:68` (`SpatialPredicates.Evaluate(a, b, SpatialRelation.Overlaps)`), `Spatial/SpatialPredicates.cs:58-70` (`Overlaps` = `CollinearOverlaps(...).Count > 0` **or** any vertex inside incl. on the boundary) | Two outlines that share a wall edge — the correct way to draw room outlines — "overlap": probe P21, a 2×2 block of tiled outlines → **6 `room_overlap` warnings** (every pair, the diagonal pair sharing a single corner included). A room outline inside a zone outline reports nothing. | A 60-room plan drawn with `A-ROOM` polylines → ~150 warnings "Room outlines must tile the floor; trim them to the shared wall" for a plan that already does; two pages of noise hide the one real overlap. `create_issue_markup` of the result draws a cloud on every party wall. | xUnit: two outlines sharing an edge → no issue; sharing a corner → no issue; offset by 1 000 → `room_overlap`; one strictly inside the other → (new) `room_inside_room` info. Fix: in `RoomBoundaryChecks` test interior overlap only — a vertex of one strictly inside the other (`DistanceToBoundaryXY > tol.PointEquality`) or a proper crossing (`IntersectionPoints(proper: true)`), never a shared run. |
| H3 | `Architecture/RoomLoopFinder.cs:65` (`nested` = a loop that contains every vertex of another kept loop; `ContainsPointXY` counts boundary points as inside) | The rule meant for the outer line of a double-line wall fires on any inner enclosure. P5 (6×4 m room, a 1.5×1.5 m closet hung off the south wall by one partition): **only the closet is a room** (`nested: 1`), the 24 m² room is gone — the room's face ring runs around the closet, so every closet vertex lies *on* the room ring. P6 (12×8 m hall, free-standing 2×2 m shaft inside): only the shaft (4 m²); the 96 m² hall is dropped. | Any plan with a shaft, a WC cubicle, a kiosk or a duct riser drawn on the wall layer inside a larger room: the large room disappears from `arch_detect_rooms`, the area schedule and the tags; `unlabelled_room` fires for the closet. Undetectable from the summary (`nested` is just a count). | xUnit: P5 → 2 rooms (24 m² incl. or excl. the closet — see Unresolved) and P6 → 2 rooms; the pinned double-line case keeps `nested: 1`. Fix: a container is the outer line of a wall only when every vertex of the nested loop is within `MaxWallThicknessMm` (~500) of the container's ring (or the container's ring is entirely within that band of the nested ring); otherwise keep both, list the inner loop under `islands[]` and report `netAreaMm2`. Adjacent faces (sharing an edge) must never nest — test strictly inside. |
| H4 | `Cad/RoomWriteService.Dimensions.cs:12` (`MaxDimensions` 200), `:64` (`summary.dimensions` echoes every plan: rule, subject, side, 3 points, measurement ≈ 200 B), `AecTools.Architecture.cs:136-137` (200 plans reach the write) | Envelope at the cap: 200 dimensions with 6-digit coordinates **64 350 B**, with 7-digit coordinates (site plans, state-plane drawings in mm) **65 550 B > 65 536** — head-as-text with 200 DIMENSION entities committed; 150 → 49 200 B, 120 → 39 390 B. The comment says "each is ~150 B" — it is ~320 B (items + summary). Same class as phase E H1 / phase D. | `arch_auto_dimension_plan {rules:[{rule:"overall", sides:["bottom","top","left","right"]}]}` on 50 rooms = 200 plans → committed, envelope unreadable, `affectedHandles` lost. | xUnit like `EditResultTests`: `WriteDimensions`-shaped envelope at `MaxDimensions` with 7-digit coordinates < 60 000 B. Fix: `MaxDimensions` 120, and drop `summary.dimensions` when `apply` (items carry `changed: [rule:subject:side, N mm]`) or list only `bySubject`. |
| H5 | `WallGraph.cs:112-116` (overshoot ⇔ the nearest other wall's closest point to the tip is within `roomGap` of the chain's attachment node), `:153-170` (`Describe`: nearest point in any direction, `reach` = 12 × roomGap) | (a) A real gap is swallowed whenever the nearest wall's foot is the junction: P2b — the door-side end of wall `S2` stops 900 mm short, but partition `M1` stands 100 mm from that end and meets `S2` at the junction → `overshoots: 1`, **no open end reported**; P7a — a 150 mm stub hanging off the north wall that misses the partition it should meet by 200 → `overshoots: 1`, nothing reported. (b) An angled wall's overshoot is not recognised: P1 — a 45° wall crossing the room (`Z`, 500 mm past each wall) → 4 `open_boundary` criticals "no wall within reach" (the foot of the perpendicular is 500 mm from the crossing node; `reach` 300 hides the wall it crosses). | (a) `arch_room_boundary_check` says "0 open ends" for a plan whose doors sit next to partitions — exactly where gaps hide; (b) every diagonal wall that overshoots a corner is a critical. | xUnit: P2b → `S2@(3900,0)` reported as `boundary_gap`/`open_boundary`; P7a → `K` reported with `nearestGapMm 200`; P1 → `overshoots: 4`, no open end. Fix: overshoot ⇔ the peeled chain is a single handle whose wall continues past the attachment node (an edge with the same handle on the other side) **and** the chain is shorter than the reach; drop the nearest-foot heuristic. |

### Medium

| # | Where | Problem | Failure scenario | Pin |
|---|---|---|---|---|
| M1 | `WallGraph.cs:167` (`reach = Math.Max(gapMm, tol.RoomGap) * 12` — unnamed multiplier; `gapMm` is always `tol.RoomGap`), `RoomBoundaryChecks.cs:45` (`gap <= maxGapMm`), seed `arch_room_boundary_check` example 2 (`tolerance.roomGap: 0.5, maxGapMm: 500` — "walls up to 500 mm apart count as gaps") | The nearest wall is only reported within 300 mm whatever `maxGapMm` says; with `roomGap: 0.5` the reach is **6 mm**. P9: a 400 mm gap with `maxGapMm: 500` → two `open_boundary` criticals with `valueMm: null` "no wall within reach". The seed's own example never produces a `boundary_gap`. | `maxGapMm` > 300 is a no-op; `roomGap` < 25 turns every open end into "no wall within reach". | xUnit: 400 mm gap + `maxGapMm 500` → `boundary_gap` 400. Fix: pass `maxGapMm` into `Find`/`PeelDangling` as the reach (named constant for the default), independent of `roomGap`. |
| M2 | `RoomBoundaryChecks.cs:42-53` (one issue per open end), `WallGraph.cs:81-120` (both ends of one gap are tips) | One gap = two issues naming each other: P11 → `ARC-001 boundary_gap S+W @(0,0)` and `ARC-002 boundary_gap W+S @(0,200)`. Counts (`bySeverity`, `openEnds`) double; the harness pins `openEnds == 8` for 4 problems. | 30 gaps → 60 warnings, two pages. | xUnit: one gap → one `boundary_gap` (handles both, location at the midpoint or the first tip). Fix: pair open ends whose nearest is each other (unordered handle pair + points within `maxGapMm`) before emitting. |
| M3 | `WallGraph.cs:161` (`if (p.Handle == handle) continue;` in `Describe`), `RoomLoopFinder.cs:87` (`CloseGaps` skips only `ReferenceEquals(other, piece)`) | A polyline outline with a gap (one handle) closes its own gap ≤ roomGap (harness "openroom" 12 mm) but a wider one is reported as **two `open_boundary` criticals "no wall within reach"** because its own segments are excluded from the nearest search: P13 (200 mm gap) → `PL v=null` ×2. Inconsistent with the LINE case (`boundary_gap` 200). | The most common "almost closed" outline (an unclosed polyline) gets the wrong severity and no gap size. | xUnit: P13 → `boundary_gap 200`. Fix: exclude the tip's own *piece* (and its adjacent piece), not its handle. |
| M4 | Room ids are positional (`RoomService.cs:46,55`, sorted `RoomLoopFinder.cs:66`) but the tools that accept `roomIds` do not take the inputs that decide the set: `arch_create_room_tags` / `arch_generate_area_schedule` have no `tolerance` / `minAreaMm2` / `minWidthMm` (`AecTools.Architecture.cs:77,95` pass `ScriptArgs.Empty` / 0), `arch_auto_dimension_plan` has `tolerance` but not the size floors; `maxCandidates` differs (tags: ceiling 100 000; detect/dimension/schedule: 5 000 default) | `arch_detect_rooms {tolerance:{roomGap:50}}` (the seed's own example 2) lists `R-003`; `arch_create_room_tags {roomIds:["R-003"]}` detects with roomGap 25 → a different set → `R-003` is another room or "not a detected room". On a > 5 000-entity plan detect and tags disagree on the candidate set even with default args. | A tag lands on the wrong room; the schedule's `roomIds` filter names the wrong rows. Nothing in the envelope reveals the shift. | xUnit over `RoomService.Select` cannot catch it; pin at the seed level: the four tools share one `roomDetection` argument block (`tolerance`, `minAreaMm2`, `minWidthMm`, `maxCandidates`) — `SeedLibraryTests` asserts the same keys on all four; and/or make the id content-based (hash of the rounded inside point) so an id survives a tolerance change. |
| M5 | `Architecture/Room.cs:79` (`DefaultNumberPattern` `^[A-Z]{0,2}-?\d{1,4}[A-Z]?$`), `:112-116` (first match by distance to the centroid wins) | The default takes every mark: P14 — texts `B01`, `101`, `PHONG KHACH`, `D01`, `C1` in one room → `number = "B01"` (nearest to the centroid). It matches `C1`, `D01`, `W1`, `S-1`, `KT-12`, `R101`, `1` (a grid label) and **not** `P.101`, `1.01`, `01.02` (Vietnamese/European numbering) nor `PHONG 101`. The harness had to narrow it to `^\d{3}$`. | Any plan carrying door/column/window tags inside rooms: the room number is a mark; area rows read "B01 PHONG KHACH". | xUnit with the P14 text set → `101`. Fix (default only, still overridable): letters require a separator — `^(?:[A-Z]{1,3}[-.]\s?)?\d{2,4}[A-Z]?$` (`101`, `A-101`, `P.101`, `1.01` via `[-.]`… yes; `B01`, `C1`, `D01` no) — and expose `numberCandidates[]` so the caller sees what was skipped. |
| M6 | `Cad/RoomService.cs:62-65` (a label = one TEXT/MTEXT record), `Cad/EntityShapeReader.cs:153` (`MText.Text`), `RoomLabels.Apply` (whole string matched) | A two-line MTEXT room tag ("OFFICE\P101" — the usual single-MTEXT tag, and exactly what `arch_create_room_tags` writes) is one label: the number regex cannot match a string with a paragraph break, so `number = null` and `name = "OFFICE⏎101"` (P14b; `Name` carries the break into `{name}` of the next tag). Re-running detect after tagging therefore reads the tool's own tag "OFFICE⏎24 m²" as the name → the second `arch_create_room_tags` renders "OFFICE⏎24 m²\P24 m²" (idempotence). | Plans tagged with multi-line MTEXT (most) → unlabelled or garbage names; tag twice → nested tags. | xUnit: label text "OFFICE\n101" → number 101, name OFFICE. Fix: split MTEXT text on `\P` / `\n` into lines and treat each line as a label (same handle); optionally exclude texts on the tag layer from labelling. |
| M7 | `Room.cs:35-53` (`handles`, `textHandles` unbounded), `AecTools.Architecture.cs:17-18` ("~1.5 KB per room"), `ArchitectureTests.cs:180-195` (size test assumes 12 handles + 6 texts) | Both lists are uncapped and set by the drawing: P22 — 30 rooms × 32 vertices with 40 wall handles + 30 texts each → **60 591 B**; 4 vertices with 60 handles + 200 texts → **77 571 B** (an open-plan office with desk labels; a room drawn from many short wall pieces). The test's 12/6 assumption is the friendly case. | `arch_detect_rooms {}` on an open-plan floor → head-as-text. | Size test at 30 × (32 vertices, 40 handles, 100 texts) < 60 000. Fix: cap `handles` at 32 and `textHandles` at 16 with `handleCount` / `textCount`. |
| M8 | `Architecture/AreaSchedule.cs:12,29` (`MaxRoomsPerRow` 20 per row), `AecTools.Architecture.cs:27` (`MaxAreaRowLimit` 100) | 100 rows × 20 labels: 10-char labels 35.7 KB, 21-char ("A-1204 PHONG LAM VIEC") **57.7 KB**, 30-char **75.7 KB** (P22). Needs ≥ 100 groups of ≥ 20 rooms (a 2 000-room drawing), so rare, but the arithmetic of the two caps ignores the label. | `groupBy: department` on a hospital → over the cap. | Size test at 100 × 20 × 30 chars < 60 000. Fix: `MaxAreaRowLimit` 50, or list `rooms[]` only up to 500 labels per page (`roomsTruncated`). |
| M9 | `Cad/RoomWriteService.cs:38-43` (block existence only), `:93-95` (`BlockService.AppendAttributes` → unmatched tags **warn** after the INSERT is in the database), seed description "Two-phase: every tag renders before anything is written" | Attribute tags are never checked against the definition in phase 1: `attributes: {ROOMNAME: "{name}"}` on a block whose tag is `NAME` → 120 block references inserted with default attribute values, `success: true`, one grouped warning. Same for a block with no attributes at all. The preview (`apply: false`) shows `summary.tags[].text` = the MTEXT format, never the attribute values — a block-tag call cannot be previewed, and an unknown placeholder in the unused `format` refuses a block-tag call. | A typo in one attribute key = 120 useless inserts to undo. | xUnit (pure): `TagPlan` carries `Attributes` in the preview; live: unknown attribute key → `ArgumentException` before any write, `count() == n_a`. Fix: in phase 1 read `AttributeDefinitions(definition)` tags, refuse a key the block does not define (and a block with no attribute definitions when `attributes` is given); skip rendering `format` when `blockName` is set. |
| M10 | `RoomLoopFinder.cs:65` (`loops.Where(l => loops.Any(m => m.Ring.All(...)))` — O(loops² × ring)), `WallGraph.cs:159-165` (`Describe` scans every piece per tip — O(tips × pieces)); no `ct` in `PeelDangling` / `CloseGaps` | P10: graph build + face walk of 20 000 segments 0.5 s, but 1 000 kept faces 0.8 s, 2 025 faces 3.3 s, 4 000 faces 13.9 s, 10 000 faces **80 s** (> the seed's 60 s timeout); 18 000 pieces with 4 000 tips (2 000 door openings) 13.8 s in `Describe` alone, not cancellable. | A large plan with many openings (the H1 case) or many small faces (hatched wall patterns on a wall layer) times out or ignores `cancel_execution` for 14 s. | Test with a 4 000-face grid < 2 s. Fix: pre-filter the nested test by `Box` through `SpatialIndex` (bounds containment first), and query the index within the reach in `Describe` (the overshoot rule of H5 no longer needs the global nearest); `ct` in both loops. |
| M11 | `AecTools.Architecture.cs:146-156` (`ReadRooms` copies `Query.Errors/Warnings` only; `Classification.TextsTruncated` ignored), `Cad/RoomService.cs:27` (`Classify` over the whole filter — every entity type — with `maxCandidates` default 5 000) | (a) > 5 000 TEXT/MTEXT in the space → labels beyond the first 5 000 (handle order) silently missing → `unlabelled_room` info for rooms that are labelled; `classify_aec_entities` warns for the same condition, this tool does not. (b) `arch_detect_rooms {}` classifies *all* model-space entities (furniture, hatches, dimensions) against the 5 000 cap before it sees the last wall; only `truncated: true` says so, and the open ends it then reports are artefacts of the cap. | A furnished floor plan (typically 10–30 k entities) → half the walls missing → dozens of `open_boundary` criticals. | xUnit at the facade level is not possible (needs `Database`); pin by description + a warning string test. Fix: warn on `TextsTruncated` (text of `AecTools.Semantic.cs:43`); when the filter has no `layers`/`types`, pre-filter the query by the union of the rule set's wall + room layer patterns and types so the candidate cap counts walls, not chairs. |
| M12 | `Cad/RoomWriteService.cs:127-136` (`summary.tags[]` echoes room, name, number, text, atMm for every plan; `summary.written[]` echoes room, handle, text, atMm; `items[]` a third time), `AecTools.Architecture.cs:24` (`MaxRoomTags` 120 "each is echoed twice") | 120 tags with 45-char names → **51.4 KB**; a `{number} {name}\P{department}\P{areaM2} m²` format with long Vietnamese names lands within ~5 KB of the budget; the name appears three times per room. Under the cap today (phase E H1 fixed the same shape at 200), but with no margin. | — | Size test at 120 with 80-char texts < 60 000. Fix: after apply, drop `tags` (or keep only `room`, `text` in `written`). |

### Low

| # | Where | Problem |
|---|---|---|
| L1 | `RoomBoundaryChecks.cs:81-84` (`SameRing`: area within `PointEquality × vertexCount` mm²) | Dimensionally odd (mm vs mm²); works for the probed 0.1 mm noise only because the vertex check does the work. Use `tol.PointEquality × perimeter`. |
| L2 | `Cad/RoomService.cs:54` (`OutlineAreaMatch` 0.10) | An outline drawn on the wall centreline vs the inner-face loop of a 200 mm wall differs by ~12 % for a 3×4 m room → both kept (`R-001` outline 13.4 m², `R-002` walls 12 m²), area double-counted. Replace when the loop's inside point is in the outline and the loop's area is ≥ 60 % of the outline's (a zone outline is far larger). |
| L3 | `Cad/RoomService.cs:41-47`, `RoomBoundaryChecks.cs` | A zone/department outline on a room layer that contains room outlines is a room of its own (P21 "zone": no issue) → the schedule sums the zone and its rooms. Report `room_inside_room` info or exclude an outline that contains other outlines' inside points. |
| L4 | `Room.cs:49-50` | `includeOutline: false` → `outlineMm: []`, `outlineTruncated: true` for every room. Report `null`/false when no outline was asked for. |
| L5 | `AreaSchedule.cs:27` (`GroupBy(…, OrdinalIgnoreCase)`) | The group label is whichever spelling comes first (`office` / `Office` / `OFFICE` → "office", P18); rooms per row in input order. Normalise the label (upper-invariant) and sort rooms by id. |
| L6 | `RoomBoundaryChecks.cs:39,47,51,76` (`{g.GapMm:0.#}`, `{end.PointMm.X:0}` in descriptions) | Interpolated with the current culture (Vietnamese Windows → "12,5 mm"). `ValueMm` is numeric so nothing breaks; use `CultureInfo.InvariantCulture` as `Render` does. |
| L7 | `AecTools.Architecture.cs:138` (`probe.Errors` added after `Settle`), `:129-133` | `subject: entities` with an unresolvable handle → `success: true` + `errors: [INVALID_HANDLE]` (the settled flag ignores errors added later). Add them before `Settle` or as warnings. `WriteSpace`'s refusal text speaks of "members" and "marks" for the architecture tools. |
| L8 | `Cad/RoomService.cs:74` (`FirstOrDefault` on a handle shared by two rooms) | `roomIds: ["<party wall handle>"]` selects the first room only; a wall loop replaced by an outline loses its wall handles (`Handles = [outline]`), so "wall/outline handles from arch_detect_rooms" does not always resolve. Select every room carrying the handle. |
| L9 | `RoomLoopFinder.cs:35` (`DefaultMinWidthMm` 600 = area / half perimeter) | A square closet/WC between 0.71 and 1.2 m (area ≥ 0.5 m²) is dropped as a "cavity" (1.1 × 1.1 → 550). Wall cavities are ≤ 400 mm; 450 keeps 1 m closets. |
| L10 | `Cad/RoomWriteService.cs:87-91` | A tag block defined in another unit (`BlockTableRecord.Units`) is inserted at scale 1; positions are converted, the symbol is not (same as `insert_block`). Note in the description or scale by `Units`. `table.Has(blockName)` accepts `*Model_Space` / layout blocks → ARX exception. |
| L11 | `AutoDimensionRules.cs:69-77` (`Bounds` of the outline) | A rotated room (P19 diamond) gets its axis-aligned box dimensioned (5 000 × 5 000 for a 4 243-side square). `ShapeMetrics` has the main axis; the description says "extents of each outline" — say "of its bounding box" or use the OBB. |
| L12 | Rule set `a-wall-run` types `LINE, LWPOLYLINE, POLYLINE` | A curved wall drawn as an ARC is not a wall (harness: "arcs are not walls") → the room is open, two criticals. `EntityShapeReader` samples arcs; add `ARC` (and `ELLIPSE`) to the wall rule. |
| L13 | `RoomLoopFinder.cs:71-103` (`CloseGaps`: index boxes are not updated when an endpoint moves; a corner endpoint that touches its partner is never snapped to a third wall 2 mm away — P3b) | Cascades beyond one hop within `roomGap` can be missed; a room drawn 2 mm off its neighbour keeps a 2 mm sliver (still two rooms). Cosmetic. P8b shows a 500 mm stray line within 25 mm of a corner "stealing" the corner (ring kinked at (500, 17.5)). |
| L14 | `arch_detect_rooms` with `filter.space: "all"` | Walls of model and paper space share one graph (phase-D space-merging class). Group by space or refuse `all`. |
| L15 | `plans/260916-1140-aec-automation-mcp-autocad/plan.md:31`, `phase-F-architecture.md` (`status: pending`, success criterion "on a wall plan" unevidenced), no `reports/phase-F-architecture-live.md` | The plan still says pending; the only wall plan verified is the synthetic A-WALL scene (closed polylines, no door). For the lead/project-manager, not a code finding. |

## Description ⇔ code

| Seed | Mismatch |
|---|---|
| `arch_detect_rooms` | "every bounded face of the remaining plan is a room" — true only for walls continuous through doors (H1); "a wall overshooting a corner is not an open end" — perpendicular overshoots only, and real gaps beside junctions are swallowed too (H5); "faces enclosing another room … are dropped" — includes a room enclosing a closet or hung shaft (H3); `labels` default pattern takes marks (M5); one MTEXT = one label (M6); "max 30 rooms per page" — with uncapped `handles`/`textHandles` (M7); `maxCandidates` counts every entity, text index cap silent (M11); example 2's `tolerance.roomGap: 50` changes the ids the other tools see (M4). |
| `arch_room_boundary_check` | "open_boundary (… no wall within maxGapMm)" — within 300 mm (12 × roomGap), `maxGapMm` cannot widen it and `roomGap: 0.5` narrows it to 6 mm — example 2 is broken (M1); one gap = two `boundary_gap` (M2); a polyline's own gap is `open_boundary` with no value (M3); `room_overlap` on every adjacent outline pair (H2). "max 100 issues per page" ✓ (42.6 KB measured). |
| `arch_create_room_tags` | "Two-phase: every tag renders before anything is written" — attribute keys are checked after the INSERT (M9); "apply: false only decides (summary.tags lists room, name, number, text, atMm)" — for a block tag the attribute values are not listed (M9); `roomIds` "or wall/outline handles" — first room only, replaced loops lose wall handles (L8); tags read back as labels on the next run (M6). Layer/space/locked/frozen/off/Max 120/`dryRun` ✓. |
| `arch_generate_area_schedule` | "largest first" — by room the rows are id-ordered (fine, say so); "max 100 rows per page" — over the cap with 20 long labels per row (M8); group label case (L5). |
| `arch_auto_dimension_plan` | "Max 200 dimensions per call" — 64–66 KB at 200 (H4); "the extents of each outline" — of its bounding box (L11); `rules[].offsetMm` has no `exclusiveMinimum` although ≤ 0 is refused; `subject: entities` errors after `Settle` (L7). `rules` required + `rule` enum/required, examples' keys (`roomIds`, `rules`, `layer`, `subject`, `filter.layers/types`) all real ✓. |

## Tests — what `ArchitectureTests` pins and what is missing

Pinned (9): one rectangle → one 4-vertex room with sorted handles; T-junction + perpendicular overshoot; 20 mm gap closed as a corner / 200 mm gap → both tips open with the nearest named; L-room inside point; island tiny and not subtracted; double-line outer ring nested; collinear overlap + crossing + determinism on reversed input; labels number/name/department incl. custom patterns and an invalid regex; boundary check severity order + ids + duplicate outlines + unlabelled; area schedule by department with percentages + bad `groupBy`; overall rule sides/points + unknown rule/side/empty rules; room page size at 30 × 32 vertices (12 handles, 6 texts). `SeedLibraryTests` pins shim shape, `transaction`, description tokens, `limit.maximum` of the three read seeds, 40 seeds / 23 read-only; `HostProfileTests` pins the category.

Missing: any door opening (single-line, double-line with jambs); tiled outlines → no overlap; adjacent faces never nest / closet-by-stub / hall + shaft; angled overshoot; gap beside a junction (P2b, P7a); reach vs `maxGapMm` and `roomGap` < 25; one gap → one issue; polyline self-gap; default number pattern against marks and dotted numbers; multi-line MTEXT label; `Render` blank-line / fallback / case-insensitive placeholders (harness covers the unknown placeholder only); envelope sizes for boundary issues, area rows at 20 labels, tags at 120, dimensions at 200 with 7-digit coordinates; room page with 40 handles / 100 texts; `RoomService.Select` (unknown id, shared handle); `MaxSegments` refusal; nested-check and `Describe` timing guards; `AreaSchedule` case normalisation; U-shaped inside point (P20 passes: (1500, 1500), depth 1500); `Simplify` on a 179° corner with long legs (P17 passes: kept) and a 60 mm jog 1 mm off (removed — fine). Harness never sends `blockName`/`attributes`, `space`, `onlyUnlabelled`, `roomIds`, `subject: entities`, `layer`/`dimStyle` for dimensions, an explicit room outline, or a plan with a door.

## Positive

`WallGraph` is a clean planar-subdivision: cut parameters gathered through the spatial index, nodes merged by a tolerance grid, one undirected edge per node pair with every drawing handle kept, chains peeled by a queue that handles detached chains and Y-junctions correctly, faces walked by the leftmost turn over each directed edge once (probed: zig-zag → 4 faces, figure-8 → 2 rooms, coincident duplicates → merged handles, 2 mm-offset duplicates → still two rooms, cascading snaps converge, 20 000 unit walls in 0.5 s); `Simplify` keeps a 179° corner with real legs; `InsidePoint` finds a deep interior point of a U; `RoomLabelRules` compile with a 200 ms timeout and turn `RegexMatchTimeoutException` and parse errors into `ArgumentException`s (probed with `^(a+)+$`); `Render` drops blank lines, falls back to the id, is case-insensitive and names the unknown placeholder; `AutoDimensionRules` is a real registry with the rule name/sides/offset validated as the caller's errors and rotated/tiny subjects handled; `AreaSchedule` is pure with exact totals whatever the row cap; `RoomBoundaryChecks` reuses `AuditIssue.Ordered` and the `ARC-` prefix so `create_issue_markup` consumes it unchanged; `WriteTags`/`WriteDimensions` resolve the space id and the layer in phase 1, return before any write on `apply: false`, open the space and create the layer only in phase 2, `SetDatabaseDefaults` before `LayerId`, attributes appended after the reference is database-resident, `MaxRoomTags`/`MaxDimensions` refused before phase 1 with `ArgumentException`; `EditContext.Layers.cs` replaces two identical private copies with the same semantics (byte-equivalent body, colour parameterised) and nothing else in phases D/E changed; `WriteSpace` defaults to the space the rooms were read from (the phase-E M7 lesson applied); seeds are thin shims, every declared key is read with a literal, the Architecture category is added and pinned; the harness drives preview, dryRun, locked layer, unknown placeholder, apply, and the dimension plan/apply with `count()` assertions.

## Recommended order

1. H1 + H5 + M1 + M2 + M3 (one change in `WallGraph.PeelDangling`/`Describe`: reach = `maxGapMm`, pair the two tips of a gap, exclude the tip's own piece not its handle, overshoot = same handle continues past the junction, then bridge facing tips within `maxOpeningMm` / door objects and report `openings[]`).
2. H2 + H3 + L2/L3 (interior-only overlap; nested only within the wall-thickness band, `islands[]` + `netAreaMm2`).
3. H4 + M7 + M8 + M12 (caps: `MaxDimensions` 120 and no `summary.dimensions` after apply; `handles`/`textHandles` caps; area rows; drop `tags` after apply) with size tests pinned like `EditResultTests`.
4. M4 (shared room-detection argument block on all four tools, or content-based ids), M5 + M6 (default pattern with separator rule; MTEXT lines as labels; own tag layer excluded), M9 (attribute keys in phase 1; block preview), M10 + M11, then the Lows; re-run R/A with a scene that has a door in a single-line wall, a double-line wall with jambs, two tiled outlines, a closet hung off a wall, a two-line MTEXT tag, a block tag with a misspelt attribute key, and 7-digit coordinates.

## Unresolved (user decision)

- H1 policy: should rooms be closed across door openings by (a) `Door`-classified objects only, (b) any facing pair of open ends within `maxOpeningMm` (recommended default 1 300, reported as `openings[]`, both together), or should the tool require continuous walls and say so? (a)+(b) is recommended; it changes what "open end" means.
- H3 policy: when a room holds an inner enclosure (closet, shaft), report the room's **gross** area (ring), the **net** area (minus the enclosure), or both? Recommended: both (`areaMm2` gross as today + `netAreaMm2` + `islands[]`), so the schedule can pick.
- M5: is the separator rule (`B01`/`C1`/`D01` are marks, `A-101`/`P.101`/`101` are numbers) acceptable as the default, or should Vietnamese numbering (`P.101`, `1.01`) be preferred over `A-12`? The rule covers both.
