Lightingsang/AddinRebar/plans/reports/code-review-2026-09-17-aec-phase-e.md

# Code review — AEC Automation MCP (AutoCAD), phase E: structural

Date 2026-09-17 · Plan `plans/260916-1140-aec-automation-mcp-autocad/` · Scope: `HPAutoCad.Aec` `Structural/{StructuralMember,GridDetector,StructuralChecks,MemberTagging}.cs`, `Cad/{StructuralService,StructuralWriteService}.cs`, `AecTools.Structural.cs`, 7 seeds under `Registry/SeedLibrary/Structural/`, `AutocadHostProfile` (+Structural), `SeedLibraryTests` (35 seeds), `StructuralTests` (10), harness steps N (`aec-tools-live.py`) and M (`aec-edit-tools-live.py`).

Verified: `dotnet build HPAutoCad.slnx -c Debug -p:DeployBundle=false` 0 warnings · `dotnet test HPAutoCad.Aec.Tests` 170/170 · `dotnet test HPAutoCad.Mcp.Server.Tests` 192/192 · live harness not re-run (68/68 + 75/75 on 2026-09-17 taken as given) · a scratchpad console against the built `HPAutoCad.Aec.dll` ran `GridDetector`, `StructuralChecks`, `MemberTagging` and `StructuralMember.From` over synthetic objects and serialised the envelopes with the bridge's options (`BridgeJson.Options` + `IgnoreCycles`, `MaxDepth 8`; cap `MaxOutputBytes` 65 536 on the value alone, budget 60 000) · attribute/text reading checked in `EntityShapeReader` (INSERT → `Attributes`, `Text` null) and `ClassificationService.BuildTextIndex` (TEXT/MTEXT only).

> **Status 2026-09-17: fixed** — H1–H5, M1–M10, L2/L3/L4/L8/L9/L10/L11/L12/L13 applied (see `plans/260916-1140-aec-automation-mcp-autocad/reports/phase-E-structural-live.md` § Review round); H4 and M9 decided as recommended; L1, L5, L6, L7 documented. Tests 179 + 193, live 68/68 + 78/78.

## Score: 5 / 10

The pure core is the right shape: `StructuralMember` is a record with `Shape`/`Axis` `[JsonIgnore]`d and a `Describe` projection, the three checks are pure and `ct`-aware, ids are assigned after `AuditIssue.Ordered` (stable on reversed input, probed), `WriteTags` is two-phase (`SpaceId` in phase 1, `GetObject(ForWrite)` + `EnsureLayer` only after the atomic gate, `SetDatabaseDefaults` before `LayerId`), every seed is a thin shim with the caps of the check tools pinned to `MaxIssueLimit`, and the harness drives every tool live including apply/preview/idempotence. Held back by: a write tool with no cap on the members it tags whose envelope passes the 64 KB cap at ~250 members while the texts stay committed (H1); `structural_detect_grids` at `limit` > ~130 over the cap and its schema maximum unpinned (H2 — fifth phase in a row for this class); a block member's `MARK` attribute value never read as its existing mark, so `overwrite: false` overwrites it (H3); "overwritten" leaving the old mark text in the drawing (H4); and grid labels read from TEXT only, with no on-axis check, so block bubbles yield no labels and a line without its own bubble takes a perpendicular line's label (H5).

## Findings

### High

| # | Where | Problem | Failure scenario | Pin |
|---|---|---|---|---|
| H1 | `AecTools.Structural.cs:119` (`Read(…, MaxCandidatesCeiling)`, no member cap), `Cad/StructuralWriteService.cs:162-173` (`marks` + `written` per member), seed `structural_tag_members/tool.json` (no `maxCandidates`, no cap documented) | `structural_tag_members` tags every member the filter matches and echoes each three times (`items[]`, `summary.marks[]`, `summary.written[]`, ~245 B/member). Measured with the bridge options: 120 → 29 740 B, 200 → 49 455 B, **300 → 74 082 B, 500 → 123 356 B**. Over the cap the bridge returns head-as-text — but the TEXT entities and the layer are committed. `structural_detect_members` caps at `MaxMemberLimit` 120 for exactly this reason; the write tool has none. | `structural_tag_members {}` on a plan with 300 members (columns + beams + walls of one floor) → 300 texts written, envelope unreadable, `success`/`written` handles lost. | xUnit like `EditResultTests`: `WriteTags`-shaped envelope for N = cap must be < 60 000. Fix: `MaxTagMembers` (200 is 49 KB; 150 is safer) enforced before phase 1 with an `ArgumentException` naming `kinds`/`filter`; drop `summary.marks` when `written` is present (or list only non-assigned outcomes); add `maxCandidates` to the two write seeds. |
| H2 | `AecTools.Structural.cs:31` (`PageBounds(limit, 0, MaxLimit)` = 500), seed `structural_detect_grids/tool.json` `limit.maximum: 500`; `SeedLibraryTests.Aec_seed_page_limits…` has no `structural_detect_grids` row | A `GridLine` is 202 B, an intersection 98 B, and the summary always carries up to `MaxIntersectionsListed` 300 intersections + labels + spacings (~33 KB). Measured: 100 lines + 300 intersections 55 300 B; **200 lines 73 766 B; 500 lines 129 166 B**. No `offset` either, so lines beyond `limit` are unreachable. | A tower plan whose grid layer also carries extension stubs / dimension ticks (each a LINE > 5 mm → a grid line): 200+ "lines" → `structural_detect_grids {limit: 200}` → head-as-text. | Size test at the schema maximum; pin `limit.maximum` to a new `MaxGridLimit` (~120) in `SeedLibraryTests`; add `offset`; cap `intersections` in the summary at ~150 when `items` is a full page. |
| H3 | `Structural/StructuralMember.cs:88` (`Mark` from `Properties["text"]`), `Cad/StructuralService.cs:34,45-53` (`ExistingMark` = TEXT index only), `Classification/AecClassifier.cs:130-135` (`text` only from `record.Text`; attributes in `attributes`), `Cad/EntityShapeReader.cs:137-141` (INSERT → `Attributes`, `Text` null) | A block member's own `MARK` attribute is never its existing mark: `Mark` is null unless a TEXT sits within 300 mm. `Assign` then treats it as unmarked (`assigned`, `existing: null`) and phase 2 writes the new number **into that attribute** — with `overwrite: false`. The description promises "A member that already carries a mark … keeps it and reserves its number unless overwrite is true". | Column blocks with `MARK = C7…C24` (the usual template) → `structural_tag_members {kinds:["column"]}` → every attribute rewritten C1…C18 in reading order, `summary.overwritten = 0`, `keptExisting = 0`. Undo is the only way back. The harness's only attributed block is a door, never a member. | xUnit: `StructuralMember.From` of an INSERT with `Attributes {MARK: "C7"}` → `Mark == "C7"`; live: a column block with `MARK` → `structural_tag_members` → `keptExisting 1`, attribute unchanged. Fix: `Mark = record.Attributes?["MARK"] ?? text ?? ExistingMark(…)` (tag name = `MarkAttributeTag`). |
| H4 | `Cad/StructuralWriteService.cs:78-112` (never erases or edits an existing mark), `Structural/MemberTagging.cs:66` (`Overwritten`), seed description "Renumber members that already carry a mark", outcome `overwritten` | "Overwritten" writes a **second** TEXT at the member's centre and leaves the old one where it was; the old text's handle is not even in the envelope (`existing` is a string). The next `detect_members` picks the nearest text to the centre — the new one — so the tool looks idempotent while the drawing carries two marks per member. Also true for `overwrite: false` on a mark with another prefix (e.g. `C-12` vs prefix `C`, `MatchesPrefix` fails on the hyphen → `overwritten`). | Hand-marked plan (`C-1`…`C-30` beside each column) → `structural_tag_members {kinds:["column"]}` → 30 new `C1…C30` texts at the centres, 30 old `C-n` texts remain → the sheet shows two different marks on every column; `summary.overwritten = 30`. Harness M pins "again keeps 3" (new texts at the centre win), never the old text's fate. | Live: existing off-centre mark + `overwrite:true` → `query_entities {textContains:"C"}` count unchanged (old edited in place) or the old handle listed under `summary.marks[].existingHandle` with a warning. Fix: keep the source text handle on `StructuralMember` (`MarkHandle`); on `overwritten` update that TEXT's `TextString` (two-phase, layer check) instead of creating; for attribute marks the attribute already is the target. |
| H5 | `Structural/GridDetector.cs:47,53-56,86-94` (`LabelNear` over the TEXT index; nearest labelled bubble to either **end** within `reachMm`, no test that the bubble lies on the line's axis), `Cad/ClassificationService.cs:35-40` (index = TEXT/MTEXT) | (a) Bubbles that are INSERTs with an attribute label (the common template) get `Label = null` → `labels: []`, intersections named by handles (probe 2c). (b) A line with no labelled bubble of its own takes the nearest labelled bubble within 2 500 mm of either end **in any direction**: line A (end at 7 500, 0) took bubble "2" drawn at the bottom of grid 2 (6 000, −1 900), 2 421 mm away → `GA: label "2", bubbleHandle B2` (probe 2b). With the example's `reachMm: 4000` the radius covers most corner bubbles. | Mixed drawing (some bubbles blocks, some circles+TEXT) or any partial grid line without a bubble → wrong labels → `column_off_grid` descriptions name the wrong grid, `labels` lists duplicates, intersections `2/2`. | xUnit: INSERT bubble with `Attributes {GRID:"A"}` → label "A"; a line whose only bubble within reach sits off its axis (perpendicular offset > bubble radius) → label null. Fix: `LabelNear` also reads `Record.Attributes` values of INSERT bubbles (first value ≤ `MaxLabelChars`); require `DistanceToLineXY(axis, bubble.Center) ≤ bubble.Radius + tol.RoomGap` before a bubble may label a line. |

### Medium

| # | Where | Problem | Failure scenario | Pin |
|---|---|---|---|---|
| M1 | `GridDetector.cs:43` (every open run > `TinySegment` is a grid line), `:75-80` (spacing from positions), `:62-73` (pairwise intersections) | The short line that joins a bubble to its grid line (the normal way bubbles are attached) is a second grid line with the same label at the same position: probe 2a → 5 lines (`GBS:B:800`), **5 intersections** (`B/1` twice at the same point), `spacingMm.horizontal = [5010, 0]`. `intersectionCount` and `labels` inflate with every stub. | Any grid drawn with stubs; a 20×30 grid → 100 stubs → 100 extra "lines", `spacing` full of zeros, `intersectionCount` ×2. Harness N draws detached circles. | xUnit: line + 800 mm collinear stub + bubble → 1 line, 4 intersections, no 0 spacing. Fix: merge collinear runs of the same direction within `tol.Collinearity` before labelling (keep the longest handle, union the extent); de-duplicate intersections by point. |
| M2 | `StructuralChecks.cs:104-114` (`column_no_grid` per column), `AecTools.Structural.cs:92-100` (no guard when `Intersections.Count == 0`) | With no grid in the drawing (or none classified — wrong layer name) every column is a warning: probe 3b → 5/5 `column_no_grid`. A 400-column drawing returns 400 issues, `success: true`, four pages, all saying the same thing. Input that makes the run meaningless is an `ArgumentException` by the house rule, or one warning. | `structural_column_alignment_check {filter:{layers:["S-COL*"]}}` (grid layer excluded by the filter) → 400 warnings. | xUnit / live: no intersections → 0 issues + warning "no grid intersections found (…); nothing to align to" (or `ArgumentException`). |
| M3 | `StructuralChecks.cs:141-147` (`Intersects` incl. touching → `opening_through_column`) | Touching is intersecting for the predicate, so an opening sharing a column face or touching a corner is "cuts through column" (critical): probe 3c → `OE` (shares the east face) and `OC` (corner only) both `opening_through_column`. A shaft opening drawn tight against a column is the standard detail. | `structural_opening_conflict_check` on a core with 8 lift/shaft openings against the core columns → 8 critical false positives. | xUnit: opening sharing one face → `opening_near_column` with `valueMm 0` (or a `touches` variant, warning); only `Crosses` / vertex-inside → critical. |
| M4 | `StructuralChecks.cs:91` (exclude only `AreCollinearXY(…, tol.Collinearity = 1 mm)`) | A duplicate beam 2 mm beside the first is not collinear → it **supports** the first (gap 2 ≤ 10) and vice-versa: probe 3a → `BR`/`BR2` report nothing while the exact duplicate `BL`/`BR` reports `unsupported_end`. The most common drafting artefact (copy not snapped) hides unsupported ends; the exact one does not — inconsistent. | Beam layer with overlapping near-duplicates → connectivity passes clean. | xUnit: two parallel beams offset 2 mm, no columns → both ends of both beams `unsupported_end`. Fix: exclude a beam support when `AreParallelXY` and `DistanceToLineXY ≤ tol.EndpointConnection` (a parallel beam within the landing tolerance cannot be a support). |
| M5 | `MemberTagging.cs:48-51,63-65` (`taken` = strings; `MatchesPrefix` accepts any digit string) | Numbers are reserved as strings: existing `C01` + `digits 1` → `C1` assigned to another column (probe 4a: `B=C01 kept`, `A=C1`); existing `C2` + `digits 2` → `C02` assigned (4b). Duplicate existing marks (`C2` on two columns) are both `kept_existing` with no warning (4a). | Re-tag after a colleague tagged with a different padding → two columns carry number 1; a copied bay with duplicate marks stays duplicated and the schedule counts `C2` twice. | xUnit: `C01` + digits 1 → next assigned ≠ `C1`; `C2` + digits 2 → ≠ `C02`; duplicates → `summary.duplicateExisting[]` / warning. Fix: reserve `int.Parse(suffix)` per prefix, format on output. |
| M6 | `MemberTagging.cs:36,84` (`Band = Math.Round(y / bandMm)`), `AecTools.Structural.cs:122` (`bandMm = tol.RoomGap * 10`) | Rounding bands split a row at the band boundary: centres y = 124 / 126 / 124 (band 250) order as `HI(126), FAR(124), LO(124)` — the column 2 mm higher comes first, then the row restarts from the left (probe 4e). Boundaries fall on every odd multiple of 125 mm, i.e. on real grid lines (5 125, 7 375 …); a centroid 0.01 mm off flips the band. `× 10` is an unnamed multiplier. | Row of columns on grid y = 5 125: marks run `C1` at the far right, `C2…` from the left. Deterministic, so the harness (rows at 0 / 5 000) never sees it. | xUnit: three members y = 124/126/124 → left-to-right order. Fix: cluster by gap (sort by y desc, new band when the drop exceeds `bandMm`), name the constant (`RowBandMm`). |
| M7 | Seeds `structural_tag_members` / `structural_generate_member_schedule` (`space` default `current`), `StructuralWriteService.cs:30,123`, members read with `filter.Space` default `model` | Members come from model space; the texts/table go to the **current** space. With a layout tab active the marks land in paper space at model-mm coordinates (converted by INSUNITS) — the phase-D H4 class, fixed there with `space: "auto"`. | User on `Layout1` → `structural_tag_members` → 30 texts in paper space kilometres off-sheet, `success: true`. | Live: current tab = layout → texts in model space (or refusal). Fix: default `space` = the members' space (`filter.Space` when single; `auto` = each member's own space; refuse `all` without an explicit space). |
| M8 | `StructuralWriteService.cs:123` (`cx.Space(space)` opens the BTR **ForWrite** before `LayerForCreate` / arg checks), `:79-80` (`WriteTags` phase 2 opens the space and calls `EnsureLayer` even when every tag is `kept_existing`) | `WriteTable` refused on a locked layer has already opened the space for write → the bridge's change counter reports `modified = 1` for a run that wrote nothing (phase-C M2 / phase-D M8 class). `WriteTags` with nothing to write (harness "again") still opens the space and the layer table. | `structural_generate_member_schedule {writeTable:true, layer:"LOCKED"}` → `success:false`, `run.changed.modified = 1`. | Live: refused table → `run.changed.modified == 0`; re-tag with all kept → `changed` empty. Fix: `SpaceId` in phase 1, `GetObject(ForWrite)` in phase 2; skip phase 2 when no outcome is pending. |
| M9 | `Cad/StructuralService.cs:45-53` (`ExistingMark`: any text matching `^[A-Z]{1,3}-?\d{1,4}$` within 300 mm of the **bounds**, nearest to the centre, claimed independently by every member) | A text is claimed by every member within 300 mm of its bounds: a column's `C1` is also the existing mark of the two beams framing into it (a beam's reach box is 6.6 m × 0.6 m), a door tag `D01` or pipe tag `P1` qualifies. Effects: `detect_members.mark`/`marked` wrong, `schedule.marks` lists `C1` under beams, `tag_members` reports `overwritten` for beams that never had a mark (harness M pins "stray C3 text is overwritten"). | Plan with column marks only → `structural_detect_members {kinds:["beam"]}` shows `mark: "C3"` on most beams; `summary.marked` ≈ beams. | xUnit: column with `C1` text + beam ending on it → beam `Mark == null`. Fix: assign each text once to the member whose shape contains its position, else the nearest centre; and only accept prefixes that belong to some kind (`prefixes` ∪ defaults) unless `overwrite`. |
| M10 | `StructuralMember.cs:82-88` + `ShapeMetrics.cs:36-37` (INSERT stand-in = bounds; `GeometricExtents` of a BlockReference includes its attributes), `ShapeMetrics.cs:44-47` (circle → `diameter × diameter`) | A column block whose visible attribute sits beside the symbol measures as `400×900` with an axis (probe 4g) → wrong `section`, a spurious `orientationDeg`, a schedule row per label position. A round column reads `400×400` (probe 4f); `Metrics.IsCircular` is available and unused. (Attribute-in-extents: API behaviour taken from the ARX reference, not driven live.) | Column blocks with a `MARK` attribute placed to the right → `structural_detect_members` sections `400×900`, `400×950`… | Live: column block with an attribute → `section 400×400`; xUnit: CIRCLE column → `Ø400`. Fix: for INSERTs use the block definition's extents (no attributes) or `Bounds` of the reference minus attributes; `Section = "Ø{d}"` when `IsCircular`. |

### Low

| # | Where | Problem |
|---|---|---|
| L1 | `AecTools.Structural.cs:21-22`, seed description "items ~400 B" | Measured 462–467 B per member; 120 members + summary = 56 879–57 479 B — under the cap, 2.5 KB under the budget. Long layer names or `sections` with 20 entries take it over 60 000. Consider 100. |
| L2 | `GridDetector.cs:43` (`Seg(Start, End)`) | A multi-vertex grid polyline (L-shape, jogged line) becomes one skewed line start→end (probe 2e: `GPL` 4 243 mm at 45°). Split polylines into segments or take the longest segment. |
| L3 | `GridDetector.cs:56` (`LabelNear(texts, axis.Mid, tol.RoomGap * 2)`) | "a short TEXT … on the line" is within 50 mm of the exact midpoint; unnamed `× 2`. |
| L4 | `GridDetector.cs:42` + rule `s-grid-line` types `XLINE` | XLINE grids have no shape → silently skipped; the "No grid lines found … pass ruleSet or a filter" warning misleads. Count unbounded grid objects and say so. |
| L5 | `StructuralChecks.cs:44-97` | A wall drawn as a single centreline supports only ends on the line: a beam stopping at the wall **face** (100 mm from the line) is `unsupported_end` critical (probe 3a `BW`). Document, or treat open wall runs with a `wallFaceReachMm`. |
| L6 | `StructuralChecks.cs:69-76` | A free beam is three critical issues (`unsupported_end` × 2 + `beam_without_supports`, pinned by `A_beam_supported_nowhere…`); 200 leftover beam lines = 600 issues over six pages. One issue per beam would do. |
| L7 | `StructuralWriteService.cs:97-107` | A beam/wall tag sits exactly on the line at mid-span (middle-centred, no offset); a slab tag at the centroid of an L-shaped slab may fall outside it. |
| L8 | `AecTools.Structural.cs:121` (`ToDictionary` on `prefixes` keys), `:95-96,105,124,158-159` (≤ 0 → default silently), `StructuralWriteService.cs:127` (unreachable check) | `prefixes {Column, column}` → raw "An item with the same key has already been added" (probe 4h); negative `alignmentToleranceMm`/`clearanceMm`/`textHeightMm`/`rowHeightMm` fall back to defaults without a warning and the schemas carry no `minimum`. |
| L9 | `StructuralWriteService.cs:119-160`, `MemberTagging.cs:73-78` | Table: "Total length (m)" prints `0.00` for columns; the `Marks` cell is unbounded (800 marks → a 6 KB cell in a 3 000 mm column); `writeTable` with zero members draws a title + header table instead of refusing. |
| L10 | `AecTools.Structural.cs:24-54,111-164` | `structural_detect_grids` has no `offset`; `Query.Truncated` is ignored by tag/schedule (a capped scan silently drops members from the schedule); a bubble without text yields `bubbleHandle: null` although the bubble exists. |
| L11 | `AecTools.Structural.cs:95,122`, `GridDetector.cs:47,56` | `alignmentToleranceMm` default = `RoomGap`; band = `RoomGap × 10`; bubble label radius `Max(radius, RoomGap)`; label-on-line `RoomGap × 2` — a room-gap tolerance reused as four unrelated structural constants. Name them. |
| L12 | `StructuralMember.cs:74,85-87` | A closed beam outline reads `300×6000` (probe 4f) where the description promises "L <length> for a run"; beams drawn as lines and as outlines never share a schedule row. `Section` for run-like closed outlines should be width + length. |
| L13 | `StructuralWriteService.cs:89` (`cx.Upgrade(block, out _)`), `:34-38` (layer OFF not warned) | Upgrade failure ignored (attribute write then throws raw); tags on an OFF layer are invisible with no warning (phase-D L7 class). |

## Description ⇔ code

| Seed | Mismatch |
|---|---|
| `structural_detect_grids` | "a short TEXT inside a bubble … or on the line" — attribute labels never read (H5), "on the line" = 50 mm of the midpoint (L3); a bubble in any direction within `reachMm` of an end may label a line (H5); `limit` max 500 breaches the cap, no `offset` (H2); stubs count as lines (M1); XLINE dropped silently (L4). |
| `structural_detect_members` | "mark — an existing mark text … on or within 300 mm of the member" — claimed by every member in reach (M9), a block's own attribute ignored (H3); "items ~400 B" → 462 B (L1); "L <length> for a run" — closed beam outlines report `w×L` (L12); round columns `d×d` (M10). |
| `structural_member_connectivity_check` | "Duplicates of the same beam on the same axis do not count as supports" — only within 1 mm; 2 mm beside, they do (M4). Walls as lines: face landings critical (L5). |
| `structural_column_alignment_check` | ok; with no grid every column is an issue (M2). |
| `structural_opening_conflict_check` | "opening_through_column when the outline intersects a column footprint" — touching a face/corner is "cuts through" (M3). |
| `structural_tag_members` | "keeps it and reserves its number" — the string, not the number (M5); "overwritten" — the old text stays (H4); "into a block reference's MARK attribute when it has one" — but its current value is never the existing mark (H3); `space` default `current` vs members in model (M7); no member cap / `maxCandidates` (H1). Examples nest keys the code reads (`prefixes.column`, `digits`, `textHeightMm`, `overwrite`, `apply`) — ok. |
| `structural_generate_member_schedule` | ok; `writeTable` with no rows draws an empty table (L9); `Total length (m)` 0.00 for footprints (L9). |

## Tests — what `StructuralTests` pins and what is missing

Pinned (10): grid labels/directions/intersections/spacing on a friendly detached-bubble grid; reach extension + far bubble ignored; sections/axes/default prefixes; connectivity landed / 20 mm gap / free end / exact duplicate ignored; free beam = 3 criticals; alignment loose/tight/no-grid-for-one-column; opening through/near/outside; reading order + kept + reserved + renumber + bad `sortBy`; schedule rows. `SeedLibraryTests` pins shim shape, `transaction`, caps of the five read tools (not grids).

Missing: envelope size at the cap for members/grids/tags; INSERT bubble with attribute label; off-axis bubble; collinear stub; multi-vertex grid polyline; near-collinear duplicate beam; beam at a line-wall face; no grid at all; opening touching a face/corner; opening inside a closed wall outline (works, unpinned); `From` for INSERT (attribute mark, bounds) and CIRCLE; `C01` vs digits 1; duplicate existing marks; band boundary order; `start`/`digits` bounds (`ArgumentException`); `ParseKinds` unknown kind warning; `Describe` key set (the description's field list).

## Positive

`StructuralMember.From` derives footprint/run/axis from `ShapeMetrics` with the dominant-direction rule, so a square column has no axis to mis-align on; `Section` is a computed property, `Shape`/`Axis` `[JsonIgnore]`d and never serialised (the item projection is explicit in `Describe`); `MemberKind.Rank`/`DefaultPrefix`/`Supports` centralise the vocabulary and the schedule order; `GridDetector` extends lines by the reach so bubbled lines cross (pinned), sorts by direction → position → handle and names intersections `A/1` with both handles; `StructuralChecks` are pure, `ct`-aware, use the spatial index for supports, exclude the exact self-duplicate, carry a real `locationMm` and a measured `valueMm`, and number after `AuditIssue.Ordered` (critical first, ids stable on reversed input); `MemberTagging.Assign` skips taken numbers per kind and keeps existing marks with a matching prefix; `WriteTags` is two-phase in the right order (`SpaceId` → validation → atomic gate → `GetObject(ForWrite)` → `EnsureLayer` → append), `SetDatabaseDefaults` before `LayerId`, `AdjustAlignment` after append, `apply: false` returns before anything is opened for write, a locked/frozen tag layer is a structured `LAYER_LOCKED`/`LAYER_FROZEN`; attribute writes reuse `BlockService.ValidateAttributes`/`WriteAttributes` (attribute layer checked); `start`/`digits`/`sortBy`/`space`/layer-name refusals are `ArgumentException`s; `StructuralInputs` reports unknown filter/tolerance keys; seeds are thin shims, every declared arg is read with a literal, `Structural` category added and pinned; harness N/M cover every tool live including preview, apply, idempotence, dryRun and the table.

## Recommended order

1. H3 + H4 (one change: `MarkHandle`/attribute provenance on `StructuralMember`, edit in place on overwrite, attribute value as existing mark) with M5 (numeric reservation) and M9 (one owner per text) — they share the "existing mark" model.
2. H1 + H2 (caps: `MaxTagMembers`, `MaxGridLimit` + `offset`, intersections cap, size tests pinned in `SeedLibraryTests`/`EditResultTests`) — one afternoon, same recipe as phases A–D.
3. H5 + M1 (attribute labels, on-axis rule, merge collinear stubs, de-duplicate intersections).
4. M2, M3, M4, M6, M7, M8, M10, then the Lows; re-run N/M with a scene that has block bubbles with attributes, stubs, a column block with `MARK`, an off-centre hand mark, a shaft opening against a column, ≥ 150 grid lines, and the active tab on a layout.

## Unresolved (user decision)

- H4 policy: on `overwrite: true` (and on a mark with another prefix), should the tool **edit the existing TEXT/attribute in place** (recommended — one mark per member, the drafter's placement kept), erase it and write at the centre, or leave it and report its handle so the AI can erase it?
- M9 policy: should an existing mark be accepted only when its letters match a known prefix of *some* kind (defaults ∪ `prefixes`) — recommended, with other short texts reported as `nearbyText` — or keep the regex-only rule?
