Lightingsang/AddinRebar/plans/reports/code-review-2026-09-16-aec-phase-a.md

# Code review — AEC Automation MCP for AutoCAD, phase A (uncommitted)

Date 2026-09-16 · reviewer code-reviewer · read-only (no host launched, no `*.ps1` run) · plan `plans/260916-1140-aec-automation-mcp-autocad/`

## Scope

| Item | Value |
|---|---|
| New | `HPAutoCad/HPAutoCad.Aec/` (23 files, ~2 680 LOC), `HPAutoCad/HPAutoCad.Aec.Tests/` (45 xUnit v3), 5 seeds (`Drawing/get_drawing_context`, `Data/query_entities`, `Data/query_entities_spatial`, `Geometry/measure_geometry`, `Audit/detect_geometry_issues`), harness `tools/harness/aec-tools-live.py` + `run-aec-tools-live.ps1` |
| Modified | `HPAutoCad.McpBridge.csproj`, `BridgeEntry.cs`, `ScriptingSelfCheck.cs`, `AutocadHostProfile.cs`, `HPAutoCad.slnx`, `HPAutoCad.Mcp.Server.Tests/{csproj,SeedLibraryTests.cs}`, `McpShared/HPRebar.Mcp.Contracts/HostScriptContracts.cs` |
| Evidence (controller) | build 0 warnings; 45 + 83 + 128 + 60 + 109 tests green; live AutoCAD 2026 `run-aec-tools-live.ps1` 33/33; regressions 21/21 + 22/22 |
| Evidence (reviewer) | `dotnet build HPAutoCad.Aec` 0 warnings + `dotnet test HPAutoCad.Aec.Tests` 45/45 re-run at 21:05 after the `EntityShapeReader` split (files touched 21:00, i.e. during this review); scratchpad probe against the built `HPAutoCad.Aec.dll` reproduced findings H1, M1, M2, M3, L6, L7 below |
| Not covered | runtime behaviour on mirrored arcs, bulge polylines, hatches with islands, dynamic blocks, paper-space filters (none in the harness scene) |

## Acceptance criteria

| # | Criterion | Verdict | Evidence |
|---|---|---|---|
| a | Geometry maths with tolerances | Pass with edge cases | `IntersectXY` non-parallel branch correct (`GeometryMath.cs:45-52`); collinear branch + `CollinearOverlapXY` touch/overlap split correct (`:39-42`, `:81-87`); `CrossesProperlyXY` excludes endpoints (`:56-63`); `ContainsPointXY` even-odd + boundary robust to a repeated last vertex (`:178-192`); `CentroidXY` uses signed area, sign-correct for CW rings (`:152-175`); `ArcPoints` sagitta step `2·acos(1−e/r)` correct, negative sweep honoured, full circle yields a ring (`PlanShape.cs:85-105`); `Seg.DistanceXY(Seg)` correct incl. degenerate. Edge cases: parallel test is an absolute `1e-12` on a mm² cross product (M1), degenerate-segment asymmetry (L6), `double.Epsilon` as zero test (L8) |
| b | Predicate consistency, `DistanceXY` = 0 on containment, index | **Fail (H1)** on the index; semantics partly inconsistent (M1) | `DistanceXY` returns 0 for containment via `AnyVertexInside` (`SpatialPredicates.cs:20`); `touches` excludes proper crossing and containment (`:48-55`) but **includes collinear overlap**; near-parallel overlapping lines give `intersects=false, overlaps=true, touches=true` (probe); two rings sharing an edge are `overlaps=true` by design (`:56-68`). Index: cell = 2×median clamped (`SpatialIndex.cs:60-62`); `Query` de-dups via `seen` (`:46`); **4096-cell cap truncates coverage to a 64×64 corner and drops hits** (`:69-73`, H1); `Query` walks every cell in range (M3) |
| c | Issue detector | **Fail (H1)** pair miss; semantics OK | pair enumeration `index.Query(a.Bounds, reach)` + `j <= i` skip (`GeometryIssueDetector.cs:104-106`) — correct with a correct index, but with H1 a (small, big) pair is missed whenever the small entity was inserted first (probe: found with BIG first, missed otherwise). `SameVertices` rings any rotation/reversal, chains both directions (`:163-183`); "connected pairs are not gaps" rule correct (`:146`); cap = `Take(maxIssues)` after the fact, ids contiguous (`:46`, `:192`); tessellated/bbox shapes feed `tiny_segment`/`overlapping_segments` false positives (M2) |
| d | AutoCAD adapters | Pass with one **High (H2)** | `ReadPolyline`: arc samples via `GetArcSegmentAt` + `GetSamplePoints(steps+1)` dropping the end point; closed ring with a trailing arc segment correct, no repeated vertex (`EntityShapeReader.cs:201-235`; `:218` is dead code); areas `Mm(area)·MmPerUnit` = du²·mm/du² correct (`:231`, `:240`, `Helpers.cs:30`, `MeasureService.cs:214`); `using var geCurve` (`Helpers.cs:22`); only `Autodesk.AutoCAD.Runtime.Exception` caught — sufficient for `GeometricExtents` (eNullExtents/eInvalidExtents are that type); `SpaceOf` cached by `OwnerId` (`:42-60`), `IsVisible` by layer name (`:63-82`). **`Arc` tessellated from OCS angles as if Normal = +Z (`:122-125`, H2)**. `EntityQueryService`: `DxfCode.BlockName` (2) is the INSERT name — correct, but anonymous for dynamic blocks (M4); `space=current` via `LayoutManager.Current.CurrentLayout` correct ("Model" when the Model tab is active); paging `matched <= offset` / `Records.Count >= limit` keeps counting — correct (`:71-78`); handle-path post-filter re-implements wildcards with `*`/`?` only (L11); `TextOf` on INSERT does a full `Read` (cost, L12). `HandleResolver`: `TryGetObjectId` + `IsErased` correct (`:36-52`). `MeasureService`: `ExactLength`, `ExactArea` (Curve.Closed/Hatch/Region), `GetClosestPointTo(du,false)`, `IntersectWith(OnBothOperands, IntPtr.Zero, IntPtr.Zero)` all correct; success rule OK; `distance` loses handle errors (M5). `DrawingContextReader`: everything that can throw is under `Safe()` or `try`; `ed.CurrentUserCoordinateSystem`/`db.*` cannot throw; counting loops are per-BTR with `ct` per table (acceptable) |
| e | Read-only guarantee | Pass | grep `ForWrite|UpgradeOpen|Erase|AppendEntity|Commit` over `HPAutoCad.Aec/` → 0 hits; all five `tool.json` declare `"transaction": "none"`; `SeedLibraryTests.Aec_seed_is_a_thin_shim_over_the_engine` pins it |
| f | AecTools clamping / warnings / ADR-02 policy | Pass with Low | limits clamped (`AecTools.cs:42-44, 86-87, 133-134`), unknown filter/tolerance/property/issueType keys warned; `ArgumentException` for un-startable requests, `errors[]` for per-handle problems — consistent except M5, L3 (`Math.Clamp` min > max), L4 (handles silently replace filter) |
| g | Contract / compat | Pass | 24 existing seeds untouched (`git status`); `HostScriptContracts.AutocadImports` += `"HPAutoCad.Aec"` only (additive; ADR-01 mentioned `HPAutoCad.Aec.Cad` too — not needed, `AecTools` lives in the root namespace); `AutocadHostProfile.Categories` += Geometry, Audit; bridge `CompilerReferences` adds `typeof(AecTools).Assembly` (`BridgeEntry.cs:118`) and `SeedLibraryTests` adds the same assembly as metadata (`:251`) — mirror holds; analyzer captures any `args.X("literal")` incl. `DoubleOrNull` (`ScriptAnalyzer.cs:93-99`) |
| h | Output size vs 64 KB cap | **Fail (H3)** | compact JSON, nulls dropped (`BridgeJson.cs:14-23`), cap 65 536 B → head-as-text (`AutocadResultSerializer.cs:57-59`). Measured: `detect_geometry_issues` item ≈ 330–352 B → default `limit 200` ≈ 70 KB **over cap**; `query_entities` summary item 188 B (100 → 19 KB OK) but detail item with one tessellated circle ≈ 5.2 KB → 12 items fill the cap, default 100 in detail mode is 8× over |
| i | Repo rules | Pass with Low | file-scoped namespaces, `nullable enable`, `sealed`/`record`/static throughout; all files < 300 lines (largest `EntityShapeReader.cs` 265 after the split, `MeasureService.cs` 272); XML docs on public types; plan references in comments (L9); a few engineering constants outside `GeometryTolerance` (L10) |
| j | Harness | Pass with Low | mm scene via `units.ToDrawing` so imperial templates exercise conversion; isolated registry root, kills only its AutoCAD, drawing never saved; brittle spots: L13 |

## Findings

### High

**H1 — `SpatialIndex` silently drops an oversized item from all but its first 64×64 cells → missed pairs and missed spatial matches**
`HPAutoCad/HPAutoCad.Aec/Spatial/SpatialIndex.cs:69-73`. When a box spans > 4096 cells the loop clamps `x1 = x0 + 63; y1 = y0 + 63`, so the item is only registered in the bottom-left corner of its extent. Cell size = 2 × median item size (`:62`), so in any drawing where small entities dominate (text, symbols, short wall lines → cell 0.4–4 m) every outline/frame/site boundary larger than ~64 cells on both axes is truncated. Probe (200 boxes of 200 mm + one 30 m ring, cell 400): `Query` at the far corner does not return the ring. Consequences: (1) `query_entities_spatial` `within/contains/intersects/…` misses the big target for every source outside that corner (`SpatialQueryService.cs:43,61`); (2) `GeometryIssueDetector.PairwiseChecks` (`GeometryIssueDetector.cs:104-106`) only checks a pair when `Query(a)` returns `b` with `j > i` — probe: `overlapping_segments` between a line and the ring is found when the ring is inserted first and **missed when it is inserted after** (drawing order = insertion order, so results depend on creation order). Fix: keep oversized items in a separate `_oversized` list that `Query` always tests with `Bounds.IntersectsXY(expanded)` (three lines), or rebuild with a larger cell when any item exceeds the cap. Add a test: many small + one huge, query far corner.

**H2 — `Arc` entities are tessellated in the OCS as if the normal were +Z; mirrored arcs come out mirrored**
`HPAutoCad/HPAutoCad.Aec/Cad/EntityShapeReader.cs:122-125`. `Arc.StartAngle/EndAngle` are measured in the entity's OCS; `Arc.Center` is WCS. For `Normal = (0,0,-1)` (every arc produced by MIRROR, common for door swings) the OCS X axis is WCS −X, so `ArcPoints(center, r, startAngle, sweep)` produces the reflection of the real arc about the vertical through the centre: wrong endpoints (→ false `endpoint_gap`), wrong crossings/containment, wrong `closestPoint` fallback. `Circle` (`:118-121`) is only orientation-flipped (harmless). The polyline path is correct because `GetArcSegmentAt` returns a WCS `CircularArc3d`. Fix: sample through `arc.GetGeCurve()` exactly as `SampleCurve` does (`Helpers.cs:14-34`), or transform with `Matrix3d.PlaneToWorld(arc.Normal)`; keep `Mm(arc.Length)` as the exact length. Add a harness scene arc with `Normal = -Vector3d.ZAxis` and assert `measure_geometry closestPoint` / `detect_geometry_issues endpoint_gap` against its `StartPoint`.

**H3 — Default limits breach the bridge's 64 KB output cap; the AI then receives truncated text instead of JSON**
`HPAutoCad.Mcp.Server/Registry/SeedLibrary/Audit/detect_geometry_issues/tool.json:162` (`"default": 200`) and `HPAutoCad/HPAutoCad.Aec/AecTools.cs:22` (`DefaultLimit = 100` also for `mode: detail`), `Model/AecEntityRecord.cs:59-62` (`ToGeometry` emits every tessellated vertex). Measured with realistic handles/layer names: one issue = 330–352 B → 200 issues ≈ 70 KB; one detail record with a tessellated circle (141 vertices at the default chord error) ≈ 5.2 KB, a 10 m circle ≈ 13 KB, a spline up to 15 KB → 12 items fill the cap. Over the cap `AutocadResultSerializer` returns the head as a string (`:57-59`), so `success/count/truncated` are lost. Fix: issues default `limit` 100 (150 max safe); in detail mode cap `geometry.vertices` (e.g. 64, with `verticesTruncated: true` and the count) or lower the detail default to 20; add a size guard test that serialises a worst-case page with `BridgeJson.Options` and asserts `< 60 KB`.

### Medium

**M1 — Predicate semantics are not mutually consistent for near-collinear and edge-sharing geometry**
`Geometry/GeometryMath.cs:33` treats "parallel" as `|r × q| ≤ 1e-12` (absolute, in mm²) — effectively bit-exact. Two lines drawn on top of each other from different sources (`(0,0)-(1000,0)` vs `(500,0.001)-(1500,0.0011)`) take the non-parallel branch, `v` falls outside the slack and `IntersectXY` returns `None`, so `intersects = false` while `overlaps = true` and `touches = true` (probe). Also `touches` (`SpatialPredicates.cs:48-55`) does not exclude collinear overlap, so two overlapping wall lines and two adjacent rooms sharing an edge are both "touches" and "overlaps" (`:56-68`). Suggest: parallel test relative to `tol.ParallelAngle` (`|r×q| ≤ sin(angleTol)·|r|·|q|`), then the collinear branch applies its distance tolerance; `touches` = `distance ≤ EndpointConnection && !proper && !contained && CollinearOverlaps().Count == 0`; document (tool description) that `overlaps` on rings includes shared edges, or split into `shares_edge`.

**M2 — `tiny_segment`/`zero_length`/`overlapping_segments` fire on tessellation chords and bounding-box rectangles**
`Issues/GeometryIssueDetector.cs:60-71, 137-143`; shapes from `EntityShapeReader.cs:118-125` (circles/arcs) and `:136,141,146,151,160` (INSERT/TEXT/MTEXT/DIMENSION/other as bbox rectangles). Chord length at the default chord error is ≈ √(2r) mm, so every circle/arc with r ≤ 12.5 mm (bolt holes, fillets, rebar bends) reports up to 5 `tiny_segment` issues (probe: r = 10 mm circle → 5 issues). A block/text bbox edge lying on a wall/grid line produces `overlapping_segments LINE × INSERT`; a flat block reports `zero_length`. Fix: give `PlanShape` a `Source` (`Exact | Tessellated | BoundingBox`) or `IsApproximate` flag set by the reader; skip the single-shape segment checks for tessellated/bbox shapes and `overlapping_segments` when either side is a bbox.

**M3 — Unbounded cell walks and full pairwise `nearest`**
`Spatial/SpatialIndex.cs:38-50` iterates every cell in the query range: with a small cell (many tiny items) a large query box or a large `maxDistance` costs millions of dictionary lookups per source (probe: 100 items, cell 20, one 200 km query → 2.4 s). `SpatialQueryService.cs:61` uses `index.All()` for `nearest` without `maxDistance` → O(sources × targets) with per-pair segment maths (fine for the 1000×1000 lines in the harness, not for polylines/circles). Fix: in `Query`, if `(cells in range) > _items.Count` scan `_items` linearly; for `nearest` without a radius, search expanding rings around the source cell and stop once the ring distance exceeds the best distance.

**M4 — Dynamic block instances are invisible to `blockNames` filters**
`Cad/EntityQueryService.cs:103` (`DxfCode.BlockName` sees the anonymous `*U12` name) and `:148` (`block.Name` on the handle path), while the record's `blockName` reports the dynamic block's original name (`EntityShapeReader.Helpers.cs:50-61`). A user filtering `blockNames: ["DOOR*"]` gets zero dynamic doors although `query_entities` labels them `DOOR`. Fix: when `BlockNames` is set, drop it from the `SelectionFilter` (keep type INSERT) and post-filter on `BlockName(block)`; or include `*U*` in the selection and post-filter.

**M5 — `measure_geometry distance` hides the real cause when a handle fails**
`Cad/MeasureService.cs:141-160`: with two handles where one is invalid, `entities.Count == 1` and `pointsMm` empty → `throw new ArgumentException("distance needs two points, two handles, or one handle and one point.")` while `result.Errors` already holds the `INVALID_HANDLE`/`ERASED` entry that is then discarded. Same pattern for `intersections` (`:176`). Fix: if `result.Errors.Count > 0` return the envelope with `Success = false` (or include the codes in the exception message).

### Low

- **L1** `Cad/EntityShapeReader.cs:243-250` — hatch footprint takes the first polyline loop regardless of `HatchLoopTypes.Outermost`, and drops `BulgeVertex.Bulge` (rounded loops become chords).
- **L2** `Cad/MeasureService.cs:259` — `Point3dCollection` is a native wrapper; wrap in `using`.
- **L3** `AecTools.cs:44` — `Math.Clamp(maxCandidates, limit + offset, 100_000)` throws `ArgumentException("min > max")` when `offset > 99 900`; clamp offset first or use `Math.Max(maxCandidates, Math.Min(limit + offset, 100_000))`.
- **L4** `AecTools.cs:118` — `handles[]` replaces the whole `filter` object without a warning that `filter.*` was ignored.
- **L5** `Geometry/GeometryTolerance.cs:50` — a non-positive override (`pointEquality: 0`) silently falls back to the default; warn like unknown keys.
- **L6** `Geometry/GeometryMath.cs:36-39` — `IntersectXY(degenerate, seg)` → `None` but `IntersectXY(seg, degenerate)` → `Point` (probe); symmetric callers (`Seg.DistanceXY`) are unaffected, `IntersectionPoints` is not symmetric.
- **L7** `Spatial/SpatialPredicates.cs:98-105` — `IsWithin` on a concave ring accepts a chord whose ends touch the boundary and whose middle is outside (probe: L-shape). Add a midpoint-inside check per inner segment.
- **L8** `Geometry/GeometryMath.cs:156` (+8 other sites) — `<= double.Epsilon` is `== 0`; for `CentroidXY` a ring with area 1e-10 mm² divides by ~0. Use a tolerance-derived epsilon (`tol.PointEquality²`).
- **L9** Plan references in code, against `.claude/rules/review-audit-self-decision.md` §5: `Model/AnalysisResult.cs:41` ("phase C onward" — and `EditResult` is unused in phase A, YAGNI), `HPAutoCad.Mcp.Server.Tests/SeedLibraryTests.cs:68` ("phase-4 / phase-A"), `HPAutoCad.Mcp.Server/Hosts/AutocadHostProfile.cs:31` ("later AEC phases"), harness docstring/header. Reword to describe the why.
- **L10** Engineering constants outside `GeometryTolerance`: `SpatialIndex.cs:62,69,71` (10 / 1 000 000 / 4096 / 63 / median fallback 1000), `PlanShape.cs:92` (720), `Helpers.cs:23` (`ChordError * 20`, 8, 512), `SpatialQueryService.cs:71` (`Take(8)`), `AecTools.cs:70,140` (`Take(20)`, `limit * 4`). Name them (`MaxCellsPerItem`, `MaxArcSteps`, `MaxCurveSamples`, `MaxPointsPerMatch`).
- **L11** `Model/EntityFilter.cs:87-92` — the handle-path post-filter supports only `*`/`?`, while the `SelectionFilter` path honours AutoCAD's full wildcard grammar (`~`, `#`, `@`, `[…]`, `,`); the same pattern can select differently on the two paths.
- **L12** `Cad/EntityQueryService.cs:169-184` — `textContains` on INSERT runs a full `reader.Read` (extents + attributes) per candidate and again for the returned page; read attributes only.
- **L13** Harness `tools/harness/aec-tools-live.py`: `:234` "read-only" check inspects only `ctx` and `badm` (assert `changed.added == 0` on every AEC result instead); `:186` exact float equality `== 5600` / `== 700` after a mm→in→mm round trip (use a tolerance); `:243,248,253` wall-clock thresholds will flake on a slow machine; scene has only a +Z arc, no bulge polyline, hatch, block-with-attributes or paper-space entity, so H2/M2/M4 are unobservable.
- **L14** `Cad/EntityShapeReader.cs:218` — `if (isLast && !pl.Closed)` inside the arc branch is unreachable (an open polyline's last vertex never enters it); delete.
- **L15** `Cad/EntityQueryService.cs:117-119` — an unknown layout name yields a silent empty result; warn "layout X not found".
- **L16** Public mutable arrays (`SpatialRelations.Names`, `GeometryIssueType.All`, `MeasureService.Measures`, `EntityQueryService.PropertyNames`, `EntityFilter.KnownKeys`) — expose as `IReadOnlyList<string>` / `ImmutableArray`.
- **L17** Commit hygiene: `git status` also shows `.mcp.json`, `.mcp.json.bak-20260914-234501`, `.codex/config.toml`, `.claude/hooks/.logs/hook-log.jsonl` — none belong to phase A; do not stage them (CLAUDE.md: never commit local `.mcp.json` edits). `docs/` (codebase summary / architecture) is in the phase file's modify list and is untouched.

## Positive observations

- Clean split: `Geometry/Spatial/Issues/Model` never touch an AutoCAD type and are covered by 45 focused tests; adapters are thin and every AutoCAD call that can throw is contained per entity (`GeometryNote` instead of a failed run).
- Seeds are genuinely data + a shim (`SeedLibraryTests.Aec_seed_is_a_thin_shim_over_the_engine` pins ≤ 12 lines, one `AecTools.` call, `transaction none`, "Read-only" in the description); the bridge/test compile references mirror each other exactly.
- Units contract honoured end to end (`Mm()` at every boundary, areas × `MmPerUnit²`, verified live on an imperial template).
- Exact AutoCAD maths where it matters (`GetDistanceAtParameter`, `Curve.Area`, `GetClosestPointTo`, `IntersectWith`) with the tessellated engine as a documented fallback.
- Handle resolution is typed (`INVALID_HANDLE`/`ERASED`/`NOT_AN_ENTITY`) and never leaks `ObjectId`; paging keeps counting after the page so `count` is exact; `maxCandidates` + `truncated` avoid silent full-drawing walks.
- `ScriptingSelfCheck` now proves the Aec assembly resolves in the bridge's load context, and the harness greps the log line for it.

## Score and verdict

**7 / 10.** The engine is well-structured, tested and read-only by construction, and the five tools work live. Three defects should be fixed before this lands because they invalidate results silently: the spatial index truncation (H1 — order-dependent misses in two tools), mirrored arcs (H2 — wrong geometry for a common entity), and the default page sizes that exceed the 64 KB serializer cap (H3 — the AI gets a string, not JSON). All three are small, local changes with an obvious unit test each; M1–M5 can follow in a phase-A.1 tidy-up before phase B builds classification on top of the same predicates.

**Verdict:** DONE_WITH_CONCERNS — fix H1, H2, H3 (and re-run `HPAutoCad.Aec.Tests` + `run-aec-tools-live.ps1`) before commit; M1/M2 before phase B relies on `touches`/`overlaps` and on the issue detector.
