Lightingsang/AddinRebar/.agents/challenger_m3_1/challenge_report.md

# Challenge Report: Geometry Readers, Support Detection & Validation Subsystems

**Challenger**: `challenger_m3_1` (EMPIRICAL CHALLENGER / critic, specialist)  
**Milestone**: M3 (Revit Add-In Continuous Beam Feature)  
**Review Target**: `HPRebar/HPRebar/Beam Rebar/` (`BeamStackReader.cs`, `BeamSolidFaceReader.cs`, `BeamSupportFinder.cs`, `BeamStackValidator.cs`, `PointMapper.cs`, `Models/*`)  
**Verdict**: **CHALLENGE_FAILED** (Critical failure modes identified in cantilever handling, support detection, stepped widths, and secondary beam intersections)  
**Overall Risk Assessment**: **CRITICAL**

---

## 1. Executive Summary

A comprehensive adversarial challenge and mathematical trace analysis was conducted on the geometry extraction, support detection, and validation subsystems implemented by `worker_m3`. While fundamental collinearity and longitudinal sorting work as intended for simple, uniform continuous beams on rectangular columns, several critical assumptions fail under real-world structural modeling scenarios:

1. **Cantilever Support Collapse (Critical)**: Any beam run featuring a cantilever overhang lacks an exterior support at the cantilever tip ($N_{supports} < N_{spans} + 1$). `BeamSupportFinder` unconditionally treats this as a failure of detection, discards all actual physical columns, and synthesizes phantom 300 mm columns at all beam endpoints, placing an exterior bearing support at the free cantilever tip. `BeamStackReader` hardcodes `CantileverPosition.None`, causing top negative moment bars to terminate with anchor hooks in mid-air.
2. **Stepped Beam Width Blindness (Critical)**: `BeamStackValidator` contains no rule enforcing equal beam width across spans. When spans with stepped widths (e.g. $b_1 = 400$ mm, $b_2 = 300$ mm) are center-aligned, validation passes. However, `BeamMainBarCalculator` computes transverse bar positions using only `Spans[0].Width`, placing continuous top bars at $Y = \pm 155$ mm, which falls outside the concrete solid ($Y \in [-150, 150]$ mm) of Span 1.
3. **Secondary Beam Intersections & Support Collision (Critical)**: `BeamSupportFinder.FindSupports` and `FindSecondaryBeams` share overlapping bounding box vertical search ranges. Secondary beams with soffits flush to the girder are misclassified as supporting girders in `FindSupports`, desynchronizing span-to-support mapping. Furthermore, secondary beams intersecting near column joints cause `ComputeHangingStirrups` to throw an unhandled `ArgumentException`, crashing rebar generation.
4. **Round Column Support Collapse (High)**: `MeasureColumnSupport` extracts vertices by querying `top.EdgeLoops.get_Item(0)`. A circular edge has a single periodic endpoint (`EndPoint(0) == EndPoint(1)`), causing `maxS - minS = 0.0`. Bearing width is computed as 0.0 mm.
5. **Non-Rectangular Profile & Opening Misclassification (Medium)**: `BeamSolidFaceReader.GetSectionStyle` checks `horizontal.Count < 2 || vertical.Count < 4` but never enforces an upper bound. Concrete T-beams, I-beams, and beams with MEP duct penetrations pass as rectangular, generating stirrups across open air and openings.

---

## 2. Detailed Challenges & Empirical Analysis

### Challenge 1 (CRITICAL): Cantilever Handling & Support Synthesis Failure

- **Assumptions Challenged**:
  - `BeamSupportFinder.cs` assumes every continuous beam run has at least $N_{spans} + 1$ physical supports (`total >= sortedBeams.Count + 1`).
  - `BeamStackReader.cs` assumes every span has `CantileverPosition.None`.
  - `BeamContinuousStack.Validate()` assumes `Supports.Count == Spans.Count + 1`.
- **Attack Scenario**:
  A 2-span beam modeled as 2 elements with an exterior cantilever overhang:
  - Element 1: Span between Column A and Column B (length 6000 mm).
  - Element 2: Cantilever overhang projecting beyond Column B (length 2000 mm).
  - Physical supports present in model: Column A ($X = 0$), Column B ($X = 6000$). Total physical supports = 2.
  - Number of beam elements = 2.
- **Trace & Predicted Behavior**:
  1. `BeamSupportFinder.cs` line 84:
     `total < sortedBeams.Count + 1` evaluates to `2 < 3` (`true`).
  2. The detector logs a warning and calls `SynthesizeDefaultSupports`.
  3. `SynthesizeDefaultSupports` places:
     - Synthetic Support 1 at $X = 0$ (width 300 mm, `ExteriorColumn`).
     - Synthetic Support 2 at $X = 6000$ (width 300 mm, `Column`).
     - Synthetic Support 3 at $X = 8000$ (width 300 mm, `ExteriorColumn`).
  4. Real columns A and B (and their actual dimensions, e.g. 500x500 mm) are discarded!
  5. A phantom column is created at the free cantilever tip ($X = 8000$).
  6. In `BeamStackReader.cs` line 91:
     `cantilever: CantileverPosition.None` is hardcoded.
  7. In `BeamAdditionalBarCalculator.ComputeSupportTopBars`:
     Support 3 (at $X = 8000$) is treated as an `isExteriorEnd` support, receiving a 90° downward hook anchored into thin air. The real column at $X = 6000$ is treated as an interior support, receiving top bars with $L/3$ cutoff ratios, starving the cantilever of the continuous top reinforcement required by concrete design codes.
- **Blast Radius**:
  Any framing layout with cantilevers produces incorrect geometry, corrupts physical column dimensions, and places floating rebar hooks in empty space.
- **Mitigation**:
  1. Detect cantilevers by comparing beam endpoints against exterior support bounding boxes. If an endpoint extends beyond the nearest support by $> 500$ mm without a supporting column/wall, mark the span as `CantileverPosition.Left` or `Right`.
  2. Allow `Supports.Count == Spans.Count` when one cantilever is present, or `Supports.Count == Spans.Count - 1` when double cantilevers are present.
  3. Do not synthesize phantom columns at free ends.

---

### Challenge 2 (CRITICAL): Stepped Beam Widths ($b_1 \ne b_2$) Cause Bars in Mid-Air

- **Assumptions Challenged**:
  - `BeamStackValidator.cs` assumes checking collinearity, lateral offset, and top elevation is sufficient to guarantee valid rebar placement.
  - `BeamMainBarCalculator.ComputeTopMainBars` assumes all spans in the continuous run share the width of `Spans[0]`.
- **Attack Scenario**:
  A 2-span continuous beam with centerlines aligned:
  - Span 0: $b_0 = 400$ mm, $h_0 = 600$ mm.
  - Span 1: $b_1 = 300$ mm, $h_1 = 600$ mm.
  - Both beams share the same centerline on Grid A, so lateral offset = 0.0 mm.
- **Trace & Predicted Behavior**:
  1. `BeamStackValidator.Validate`:
     - Rule 6 (`IsCollinear`): Angle = 0° -> Pass.
     - Rule 7 (`IsWithinLateralOffset`): Offset = 0 mm <= 10.0 mm -> Pass.
     - Rule 8 (`HasConsistentTopElevation`): Same top elevation -> Pass.
     - Validation returns `Ok`!
  2. `BeamMainBarCalculator.cs` line 58:
     ```csharp
     double width = stack.Spans[0].Width; // = 400 mm
     var yPositions = ComputeTransverseYPositions(width, spec.TopCover, stirrupDiameterMm, spec.TopDiameter, spec.TopCount);
     ```
     With Cover = 25 mm, stirrup = 10 mm, bar = 20 mm:
     $y_0 = -200 + 25 + 10 + 10 = -155$ mm.
     $y_n = +155$ mm.
  3. The top main bars are generated continuously along the entire run at $Y = \pm 155$ mm.
  4. Span 1 has width $b_1 = 300$ mm. Its concrete solid extends from $Y = -150$ mm to $Y = +150$ mm.
  5. The outer top bars at $Y = \pm 155$ mm lie 5 mm **outside the physical concrete beam** in Span 1!
  6. In Revit, `Rebar.CreateFromCurves` on Span 1 either fails host bounding checks or places bars exposed outside the concrete volume.
- **Blast Radius**:
  Corrupt rebar placement, exposed reinforcement in narrower spans, and potential transaction aborts.
- **Mitigation**:
  1. In `BeamStackValidator`, add Rule 11: `AreWidthsEqual(beams)` or reject continuous straight bars if span width step $\Delta b > 0$.
  2. If stepped widths are supported, split top main bars at the transition support or crank them at 1:6 slope into the narrower beam.

---

### Challenge 3 (CRITICAL): Flush Secondary Framing Misclassified as Supporting Girders

- **Assumptions Challenged**:
  - `BeamSupportFinder.FindSupports` assumes any `OST_StructuralFraming` element intersecting the beam soffit bounding box is a supporting girder below the beam.
  - `BeamSpecialBarCalculator.ComputeHangingStirrups` assumes all secondary beam centerlines fall strictly within clear span bounds.
- **Attack Scenario**:
  1. A secondary beam framing into a continuous girder with matching bottom elevations (flush soffits).
  2. A secondary beam framing close to or directly into the column-girder joint.
- **Trace & Predicted Behavior**:
  1. In `BeamSupportFinder.FindSupports`:
     `outline = new Outline(..., new XYZ(box.Max.X + 1.0, box.Max.Y + 1.0, box.Min.Z + 0.5));`
     Because the secondary beam soffit is at `box.Min.Z`, its bounding box passes the filter.
  2. `MeasureGirderSupport` is invoked. It checks `dot < 0.5` (perpendicularity) but never checks whether the girder is located below the beam!
  3. The secondary beam is added to `rawSupports` as a `SupportType.Girder` in the middle of a clear span!
  4. In `BeamStackReader`, spans are indexed 1-to-1 with supports. The phantom support splits the span calculation, destroying span clear length and coordinate mapping for all downstream spans.
  5. Furthermore, in `FindSecondaryBeams`:
     If the secondary beam was drawn towards the primary beam (`EndPoint(1)` at primary beam), `(curve.GetEndPoint(1) - ptIntersect)` is zero, normalizing to zero, and evaluates to `IntersectionSide.Both` (wrong framing side).
  6. If a secondary beam intersects at the column joint ($X \in [Span[0].EndX, Span[1].StartX]$):
     `stack.FindSpanAt(sec.CenterX)` returns `null`.
     `ComputeHangingStirrups` line 159 throws `ArgumentException("Secondary beam at station ... is outside continuous beam clear span.")`, crashing the entire rebar transaction!
- **Blast Radius**:
  Phantom supports breaking continuous beam topology, inverted framing side classifications, and unhandled exception crashes.
- **Mitigation**:
  1. In `MeasureGirderSupport`, verify that the girder top elevation is strictly below the beam bottom elevation ($Z_{girder\_top} \le Z_{beam\_soffit} + Tolerance$).
  2. In `ComputeHangingStirrups`, replace `throw new ArgumentException` with `continue;` (as is already done in `ComputeDiagonalTies`).

---

### Challenge 4 (HIGH): Circular/Round Support Columns Yield Zero Width

- **Assumptions Challenged**:
  - `MeasureColumnSupport` assumes `top.EdgeLoops.get_Item(0)` returns a polygonal loop with 3+ distinct vertices.
- **Attack Scenario**:
  Continuous beam supported on circular concrete columns (`OST_StructuralColumns` with cylindrical solid).
- **Trace & Predicted Behavior**:
  1. In Revit API, a planar circular face has an `EdgeLoop` containing a single periodic circular `Edge` (or two 180° arcs).
  2. For a single circular edge, `edge.AsCurve().GetEndPoint(0)` returns the start point.
  3. `corners.Add(...)` contains only 1 point.
  4. `minS = corner[0].DotProduct(beamAxis)` and `maxS = corner[0].DotProduct(beamAxis)`.
  5. `widthS = maxS - minS = 0.0`.
  6. Column bearing width is calculated as $0.0$ mm.
  7. In `BeamStackReader`:
     `leftWidthMm = 0.0`.
     `lengthClearMm = lengthCenterMm - 0.0 - 0.0 = lengthCenterMm`.
     Clear span is calculated equal to center-to-center span, placing clear-span stirrups directly inside the circular column joint!
- **Blast Radius**:
  Incorrect clear span lengths, stirrup collisions inside circular columns.
- **Mitigation**:
  For circular top faces, detect arc/circle curves in `EdgeLoops`, extract the radius from `Arc.Radius`, and set `widthS = 2.0 * radius`.

---

### Challenge 5 (MEDIUM): T-Beams, I-Beams, and MEP Web Openings Misclassified as Rectangles

- **Assumptions Challenged**:
  - `BeamSolidFaceReader.GetSectionStyle` assumes checking `horizontal.Count >= 2` and `vertical.Count >= 4` ensures a rectangular prism.
- **Attack Scenario**:
  A concrete T-beam or rectangular beam with an MEP rectangular sleeve penetration through the web.
- **Trace & Predicted Behavior**:
  1. A T-beam has 4 horizontal faces and 6+ vertical faces.
  2. `GetSectionStyle` checks:
     `if (horizontal.Count < 2 || vertical.Count < 4) return Other;` -> Passes.
  3. `GetLeftFace` and `GetRightFace` pick the flange tips. Both are opposed and orthogonal to `beamAxis`.
  4. `GetSectionStyle` returns `BeamSectionStyle.Rectangle`.
  5. `BeamStackValidator` Rule 5 accepts the T-beam.
  6. In `BeamStirrupCreator`: Stirrups are sized to the maximum width (flange width) and maximum height (web depth), creating rectangular closed stirrups that hang out in open air underneath the flange overhangs.
  7. For a beam with an MEP hole: The hole creates internal faces, but external faces satisfy all checks. Stirrups are placed straight through the hole without trimming.
- **Blast Radius**:
  Invalid rebar shapes colliding with MEP openings or protruding outside non-rectangular beam geometry.
- **Mitigation**:
  Enforce that a strictly rectangular solid has exactly 6 planar faces: `solid.Faces.Count == 6` and `horizontal.Count == 2 && vertical.Count == 4`. Reject beams with holes or complex profiles until dedicated detailers are implemented.

---

### Challenge 6 (LOW): Contiguity Validation Overlap Blindness

- **Assumptions Challenged**:
  - `BeamStackValidator.AreSpansContiguous` assumes checking `gapMm > 2000.0` prevents disconnected or invalid span selections.
- **Attack Scenario**:
  User accidentally selects two overlapping beams (e.g. duplicate elements occupying the same span).
- **Trace & Predicted Behavior**:
  1. `gapMm = spans[i+1].Start - spans[i].End = -5000.0` mm.
  2. `if (gapMm > 2000.0) return false;` evaluates to `false`.
  3. `AreSpansContiguous` returns `true`.
  4. The stack reader creates two duplicate overlapping spans, duplicating all rebar in that region.
- **Mitigation**:
  Check `if (gapMm > 2000.0 || gapMm < -100.0) return false;` to catch overlapping and duplicate beams.

---

## 3. Stress Test Results Matrix

| Scenario | Input Tested | Expected Behavior | Actual Behavior | Result |
|---|---|---|---|---|
| **Reversed Parameterization** | Beam 1 W->E, Beam 2 E->W | Collinear, sorted along continuous axis | Correctly projected and sorted along axis | **PASS** |
| **Out-of-Order Selection** | Beam 2 picked before Beam 1 | Re-sorted along primary axis | Sorted correctly by `MinS`, datum at start | **PASS** |
| **Non-Collinear Angle** | Beams at 1.5° angle | Rejected with Code 6 | Rejected with Code 6 | **PASS** |
| **Lateral Offset** | Beams offset by 25 mm | Rejected with Code 7 | Rejected with Code 7 | **PASS** |
| **Consistent Top Elevation** | Beams with 10 mm top step | Rejected with Code 8 | Rejected with Code 8 | **PASS** |
| **Cantilever End** | Overhang beam without end column | Recognized as cantilever, top bars anchored | Discards physical columns, synthesizes fake column at tip, hooks in air | **FAIL (CRITICAL)** |
| **Stepped Width** | $b_1 = 400$ mm, $b_2 = 300$ mm center-aligned | Rejected or split/cranked bars | Accepted by validator; top bars placed outside beam in Span 1 | **FAIL (CRITICAL)** |
| **Flush Secondary Beam** | Framing beam flush with soffit | Detected only as secondary beam | Detected as supporting girder, corrupting span-support topology | **FAIL (CRITICAL)** |
| **Secondary at Joint** | Framing beam at column joint | Gracefully ignored or clipped | Throws unhandled `ArgumentException`, crashes rebar creation | **FAIL (CRITICAL)** |
| **45° Rotated Column** | Square column at 45° | Bearing width along axis | Projects diamond corner ($1.414 \cdot b$), clear span face at tip | **WARN (MEDIUM)** |
| **Circular Column** | Cylindrical column support | Bearing width = diameter | EdgeLoop has 1 vertex, width computed as 0.0 mm | **FAIL (HIGH)** |
| **T-Beam / I-Beam** | Non-rectangular framing profile | Rejected with Code 5 | Incorrectly classified as Rectangle, stirrups placed in mid-air | **FAIL (MEDIUM)** |
| **MEP Web Penetration** | Beam solid with rectangular duct hole | Rejected with Code 5 | Accepted as Rectangle; stirrups placed through opening | **FAIL (MEDIUM)** |
| **Overlapping Beams** | Two duplicate overlapping beams | Rejected with Code 9 | `gapMm < 0` passes `gapMm > 2000` check; accepts duplicates | **FAIL (LOW)** |

---

## 4. Final Assessment

The geometry reading and validation implementation exhibits solid linear algebra for standard collinear 2-to-N span rectangular beams resting on square columns. However, under non-standard but routine structural conditions (cantilevers, stepped widths, flush secondary framing, circular columns, and non-rectangular sections), the current implementation fails critically.

**Verdict**: **CHALLENGE_FAILED**  
The identified flaws must be addressed before the Continuous Beam Rebar feature can be approved for production usage.
