Lightingsang/AddinRebar/HPCivil3d/README.md

# HPCivil3d — Civil 3D 2026 MCP

The fifth HP MCP host: an AI agent scripts **Autodesk Civil 3D 2026** through the shared HP MCP engine (`../McpShared/`).
**Plan complete 2026-09-18** — phases 0–5, verified live on the dev machine (`../plans/260917-1633-civil3d-mcp-2026/reports/phase-04-live-verify.md`).
Civil 3D is an AutoCAD vertical — the same `acad.exe`, R25.1, .NET 8 — so this folder is the AutoCAD bridge
(`../HPAutoCad/`) copied with Civil tokens plus the Civil API on top; it never references `HPAutoCad/`, and a mirror
test (phase 2) keeps the copied files in step. Plan: `../plans/260917-1633-civil3d-mcp-2026/`.

```
Claude Code ──stdio──▶ HPCivil3d.Mcp.Server.exe (net10)  ──pipe hpcivil3d-mcp-2026──▶ HPCivil3d.McpBridge (inside acad.exe /product C3D)
                                                                              guard (AutoCAD + Civil denials) → Roslyn 5.9 in its own load context → Idle → tr → Civil API
```

| Project | TFM | What |
|---|---|---|
| `HPCivil3d.McpBridge.Loader` | net8.0-windows | The assembly the autoloader NETLOADs (`Bundle/PackageContents.xml`, `Platform="Civil3D"`). Creates the isolated load context, starts the bridge by reflection, owns the commands `HPC3DMCPBRIDGE` / `HPC3DMCPSTART` / `HPC3DMCPSTOP` / `HPC3DMCPSTATUS` and the ribbon tab **HPCivil3d ▸ MCP ▸ MCP Bridge**. |
| `HPCivil3d.McpBridge` | net8.0-windows | The bridge: pipe host, script runner (outer/inner transaction, dryRun = abort), `civil` global (`CivilDocument`), Civil units, context, serializer, status window. References `AeccDbMgd`, `AeccPressurePipesMgd`, `AecBaseMgd` from the **installed** Civil 3D (`Directory.Build.props`, never copied). |
| `HPCivil3d.Mcp.Server` | net10 | The stdio MCP server exe: `Civil3dHostProfile`, `execute_civil3d_code`, `get_civil3d_context`, the engine's `inspect_type`/`cancel_execution` + 8 registry tools, prompts `civil3d_query_template`/`civil3d_modify_template`/`toolify_run`, resources `civil3d://document/info`/`civil3d://selection`, and **12 embedded seed tools** (`Registry/SeedLibrary/<Category>/<name>/`, generated by `tools/generate-seed-library.py`) — `tools/list` = 24. Never references the AutoCAD or Civil API. |
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
