Lightingsang/AddinRebar/HPEtabs/HPEtabs.McpBridge/Resources/HPEtabsMcpBridge_256.png

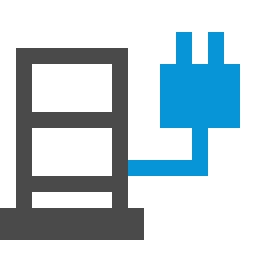
HPEtabs/HPEtabs.McpBridge/Resources/HPEtabsMcpBridge_256.png
