Lightingsang/AddinRebar/HPExcel/HPExcel.McpBridge/Resources/HPExcelMcpBridge_256.png

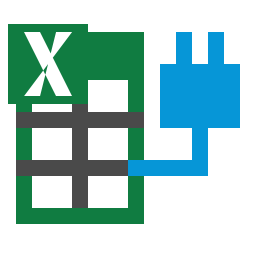
HPExcel/HPExcel.McpBridge/Resources/HPExcelMcpBridge_256.png
