Lightingsang/AddinRebar/HPKata/Distribution/Assets/IMG/Kata-00.png

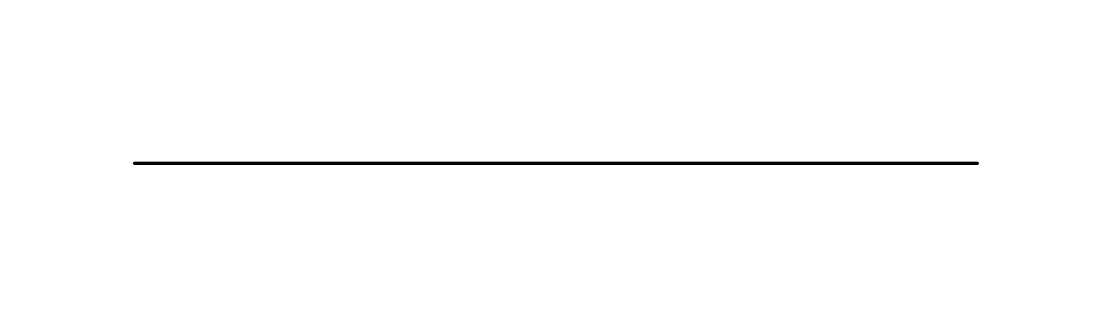
HPKata/Distribution/Assets/IMG/Kata-00.png
