Lightingsang/AddinRebar/HPKata/Distribution/Assets/IMG/Kata-11.png

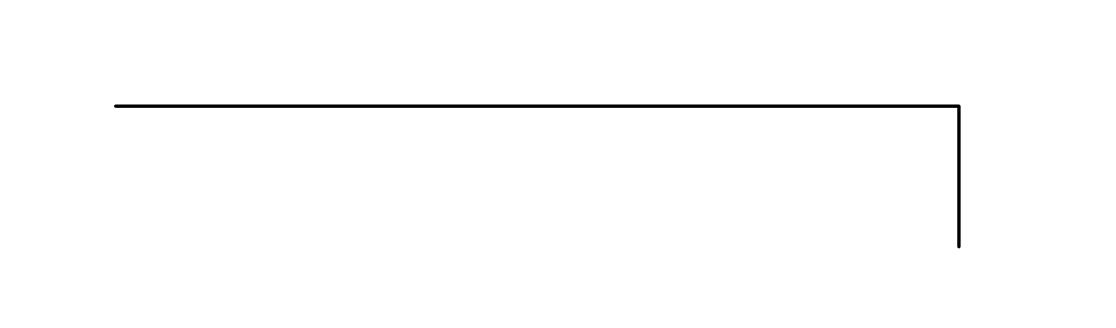
HPKata/Distribution/Assets/IMG/Kata-11.png
