Lightingsang/AddinRebar/HPKata/Distribution/Assets/IMG/Kata-15.png

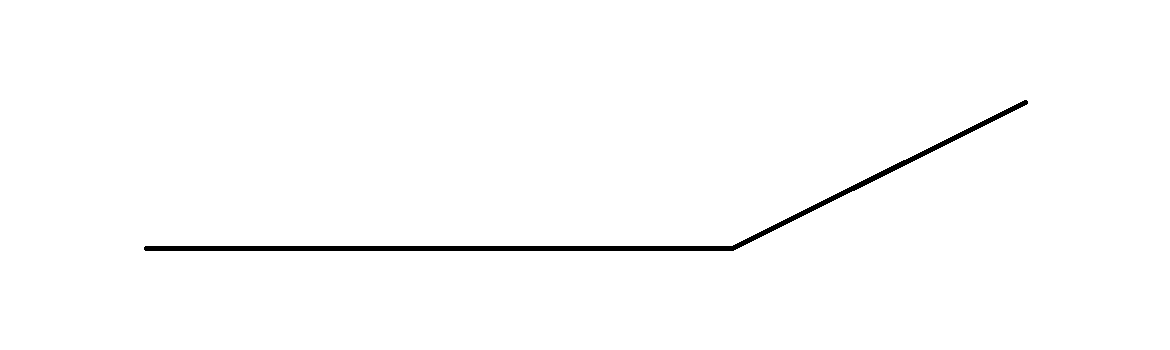
HPKata/Distribution/Assets/IMG/Kata-15.png
