Lightingsang/AddinRebar/HPKata/Distribution/Assets/IMG/Kata-21.PNG

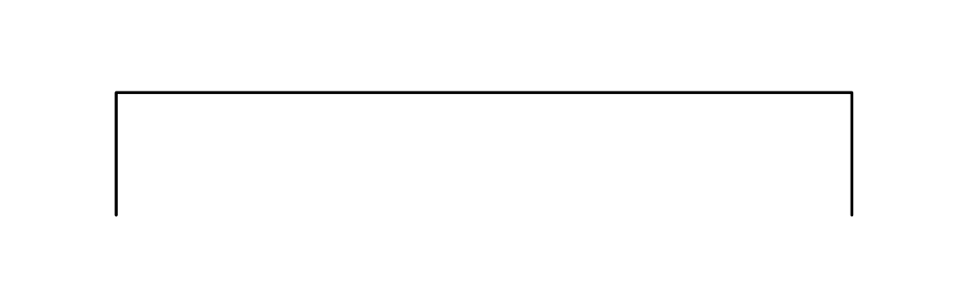
HPKata/Distribution/Assets/IMG/Kata-21.PNG
