Lightingsang/AddinRebar/HPKata/Distribution/Assets/IMG/Kata-22.PNG

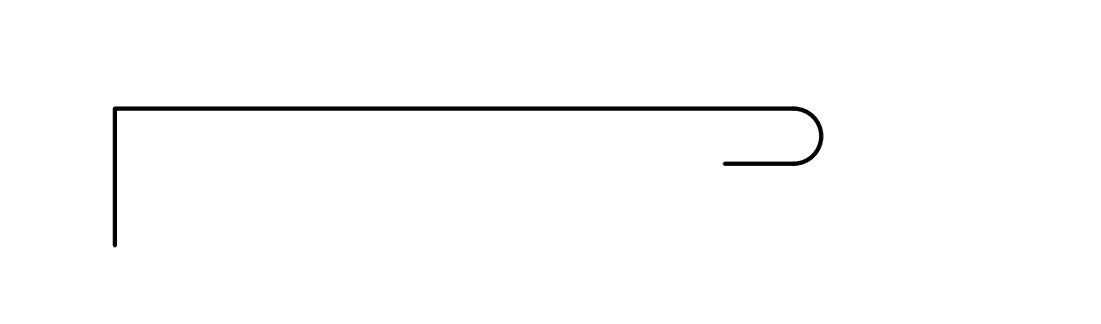
HPKata/Distribution/Assets/IMG/Kata-22.PNG
