Lightingsang/AddinRebar/HPKata/Distribution/Assets/IMG/Kata-24.png

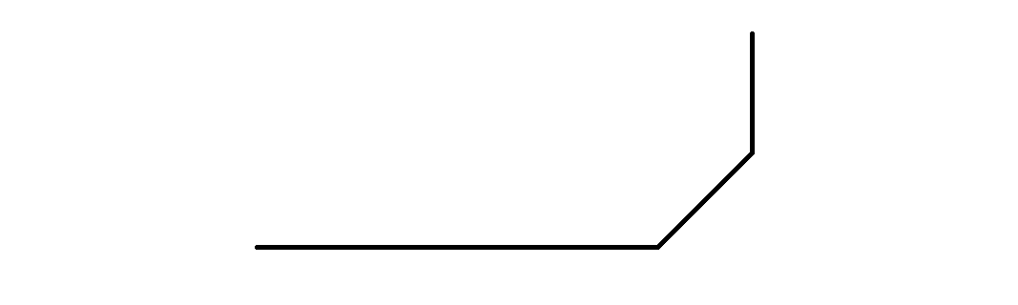
HPKata/Distribution/Assets/IMG/Kata-24.png
