Lightingsang/AddinRebar/HPKata/Distribution/Assets/IMG/Kata-25.png

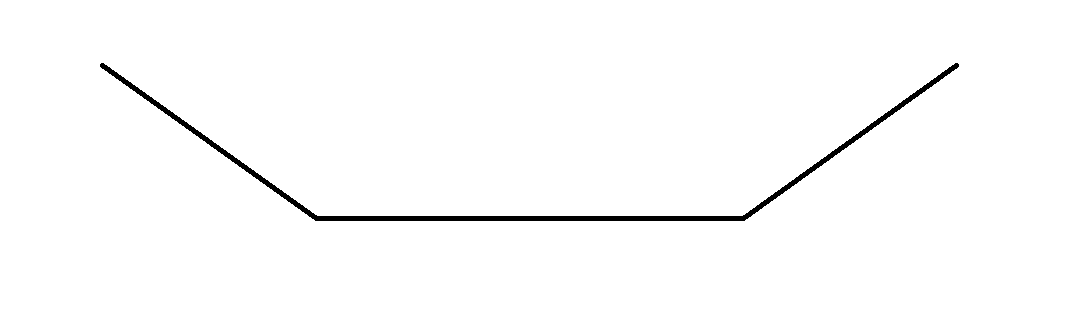
HPKata/Distribution/Assets/IMG/Kata-25.png
