Lightingsang/AddinRebar/HPKata/Distribution/Assets/IMG/Kata-26.PNG

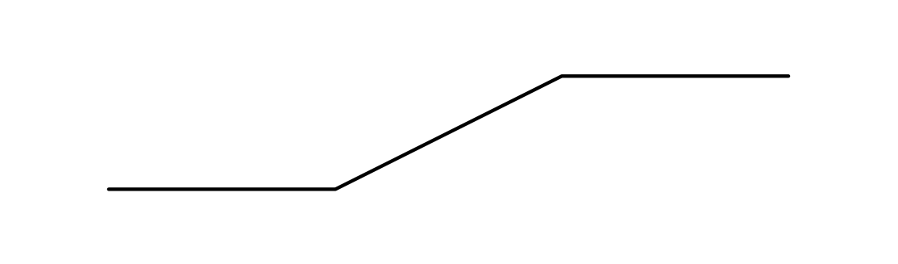
HPKata/Distribution/Assets/IMG/Kata-26.PNG
