Lightingsang/AddinRebar/HPKata/Distribution/Assets/IMG/Kata-27.png

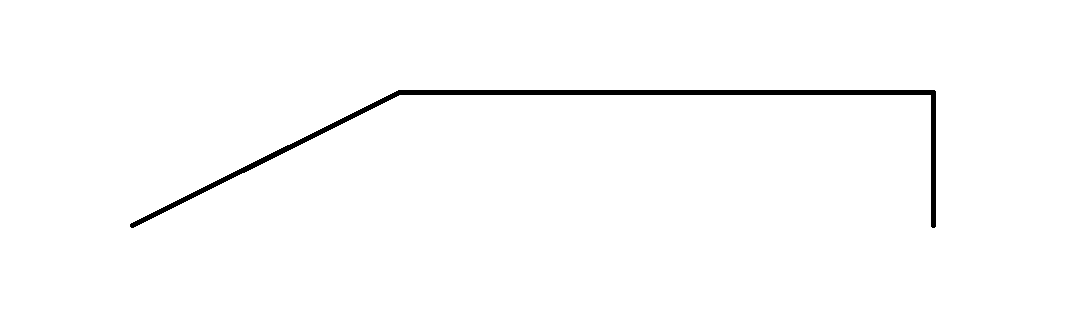
HPKata/Distribution/Assets/IMG/Kata-27.png
