Lightingsang/AddinRebar/HPKata/Distribution/Assets/IMG/Kata-28.png

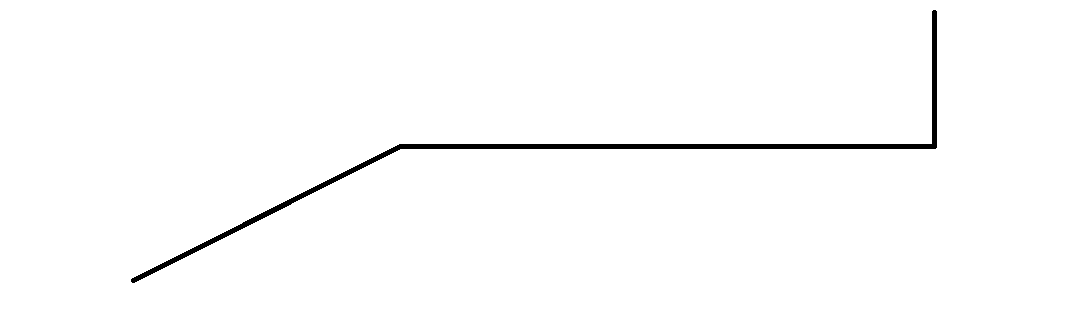
HPKata/Distribution/Assets/IMG/Kata-28.png
