Lightingsang/AddinRebar/HPKata/Distribution/Assets/IMG/Kata-31.png

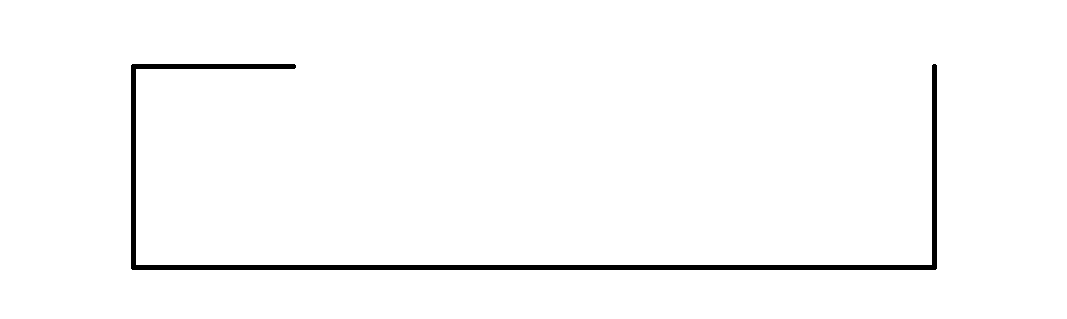
HPKata/Distribution/Assets/IMG/Kata-31.png
