Lightingsang/AddinRebar/HPKata/Distribution/Assets/IMG/Kata-34.PNG

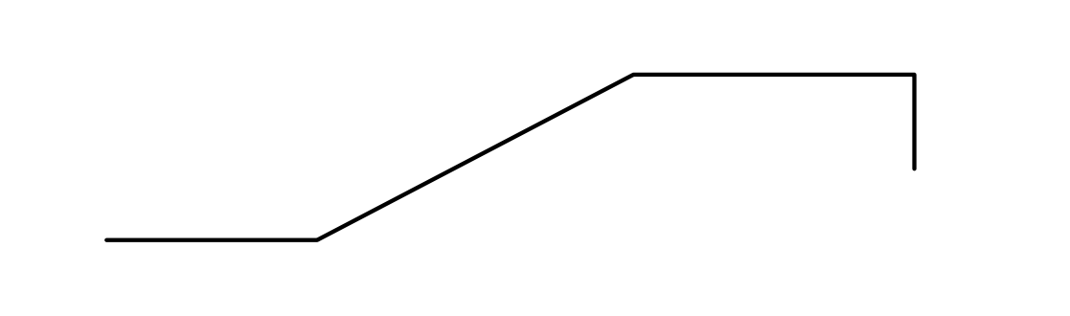
HPKata/Distribution/Assets/IMG/Kata-34.PNG
