Lightingsang/AddinRebar/HPKata/Distribution/Assets/IMG/Kata-35.PNG

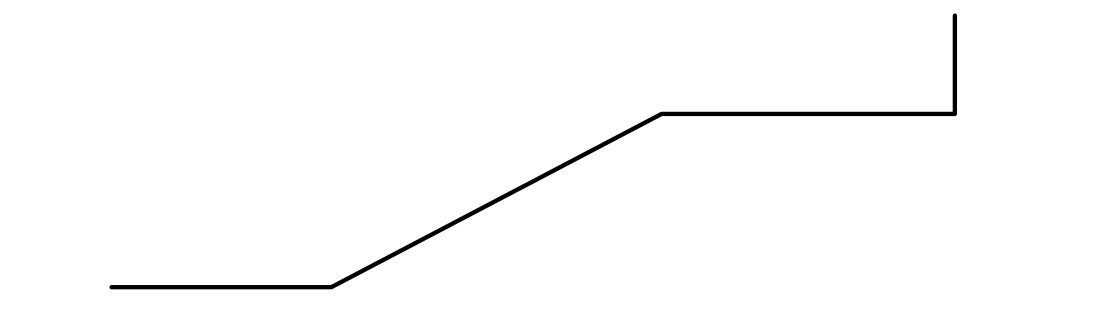
HPKata/Distribution/Assets/IMG/Kata-35.PNG
