Lightingsang/AddinRebar/HPKata/Distribution/Assets/IMG/Kata-36.png

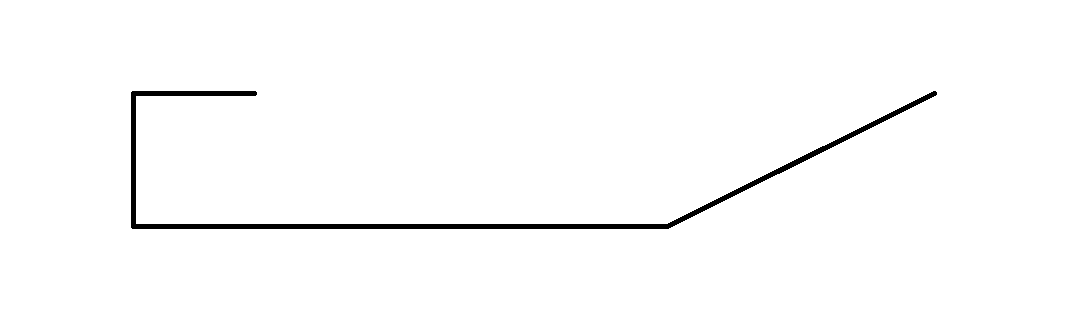
HPKata/Distribution/Assets/IMG/Kata-36.png
