Lightingsang/AddinRebar/HPKata/Distribution/Assets/IMG/Kata-44.png

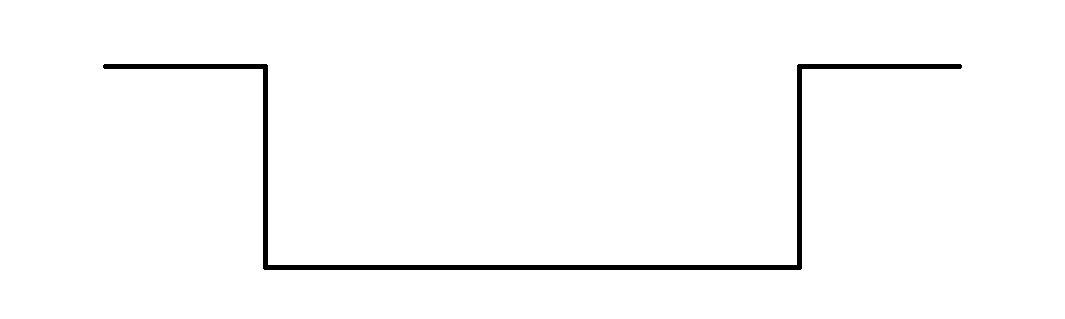
HPKata/Distribution/Assets/IMG/Kata-44.png
