Lightingsang/AddinRebar/HPKata/Distribution/Assets/IMG/Kata-46.PNG

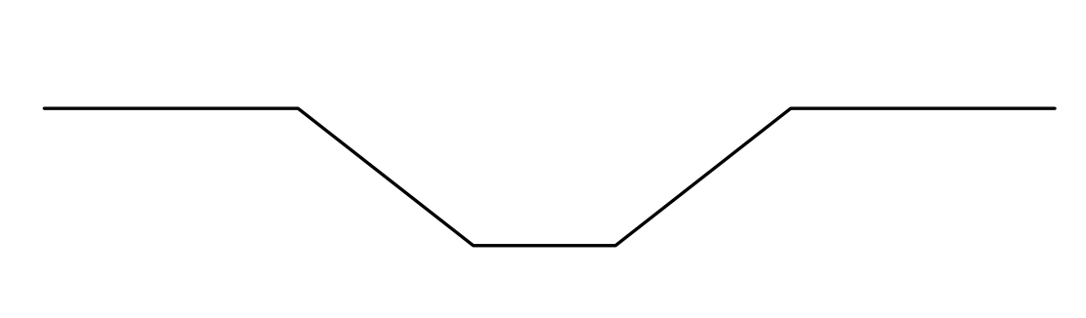
HPKata/Distribution/Assets/IMG/Kata-46.PNG
