Lightingsang/AddinRebar/HPKata/Distribution/Assets/IMG/Kata-47.PNG

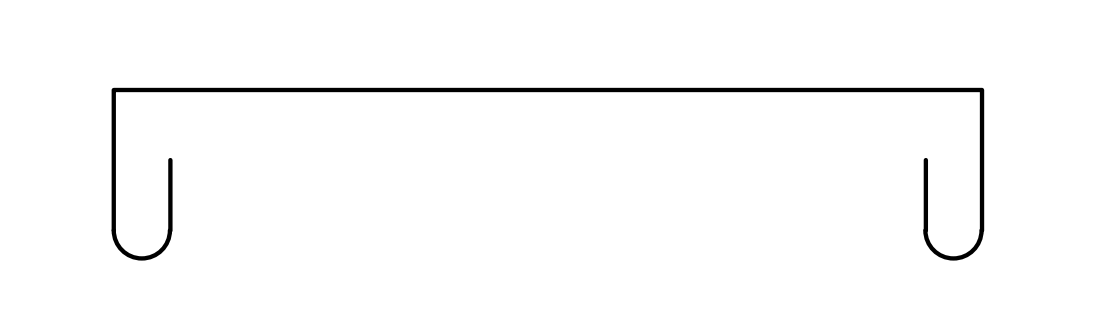
HPKata/Distribution/Assets/IMG/Kata-47.PNG
