Lightingsang/AddinRebar/HPKata/Distribution/Assets/IMG/Kata-51.PNG

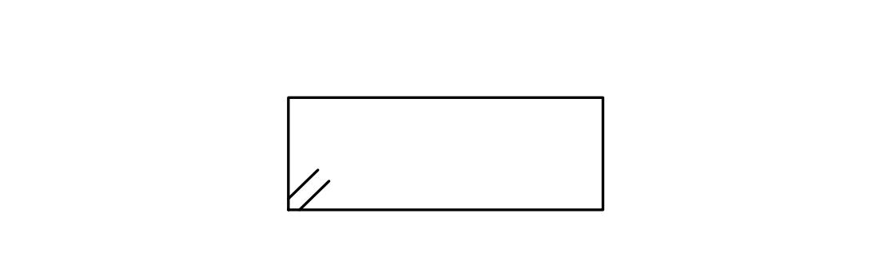
HPKata/Distribution/Assets/IMG/Kata-51.PNG
