Lightingsang/AddinRebar/HPKata/Distribution/Assets/IMG/Kata-67.png

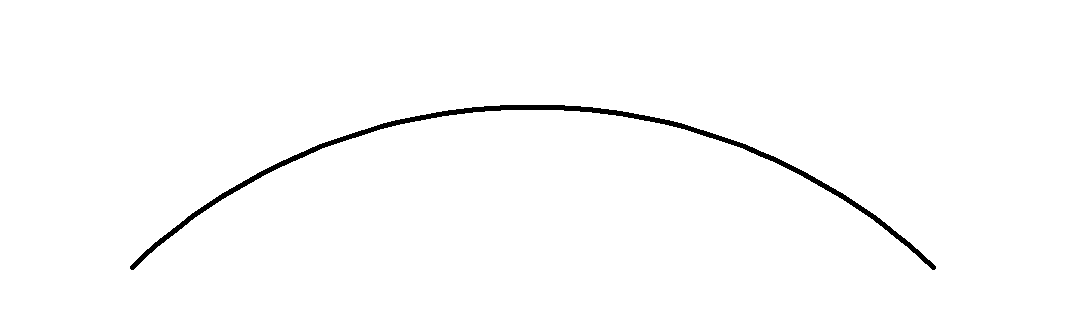
HPKata/Distribution/Assets/IMG/Kata-67.png
