Lightingsang/AddinRebar/HPKata/Distribution/Assets/IMG/Kata-75.png

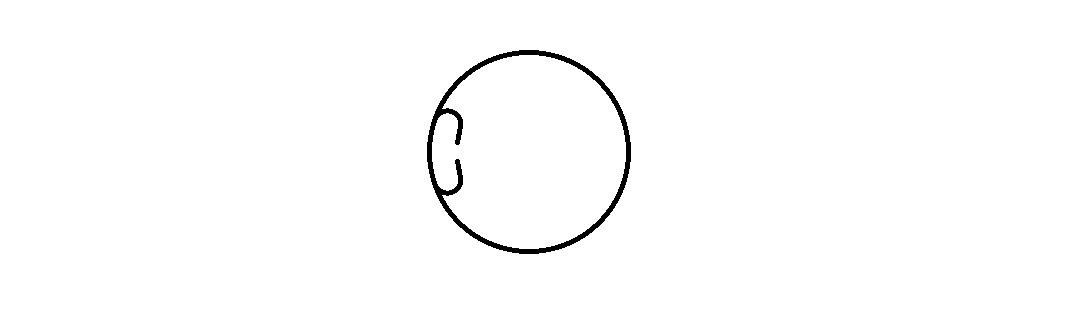
HPKata/Distribution/Assets/IMG/Kata-75.png
