Lightingsang/AddinRebar/HPKata/Distribution/Assets/IMG/Kata-77.png

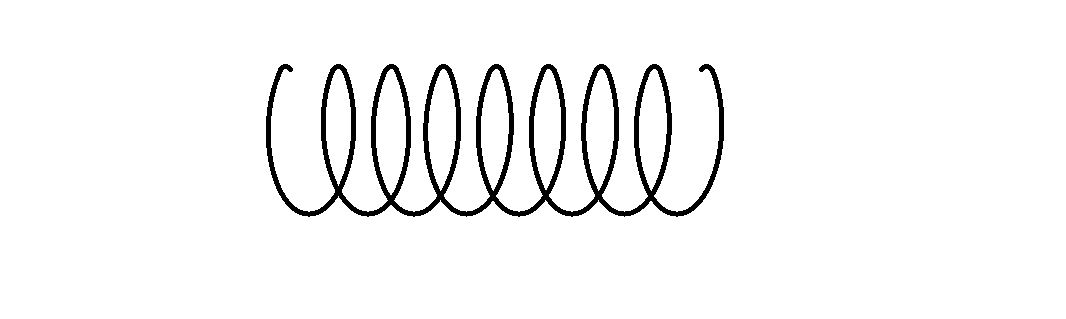
HPKata/Distribution/Assets/IMG/Kata-77.png
