Lightingsang/AddinRebar/HPKata/Distribution/Assets/IMG/Kata-78.png

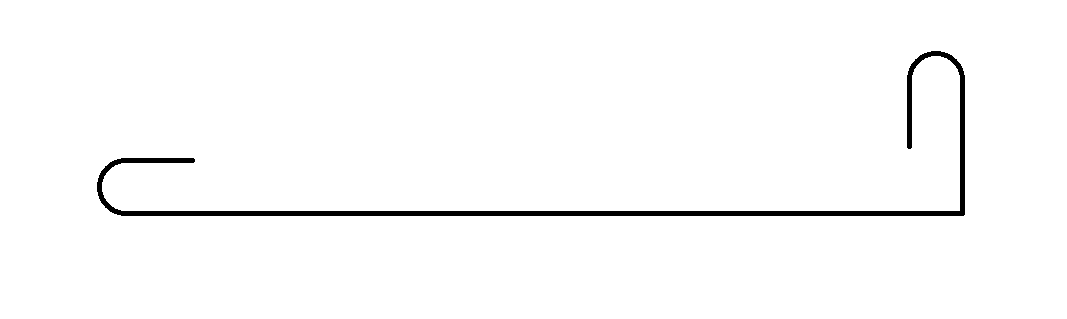
HPKata/Distribution/Assets/IMG/Kata-78.png
