Lightingsang/AddinRebar/HPKata/Distribution/Assets/IMG/Kata-99-13.PNG

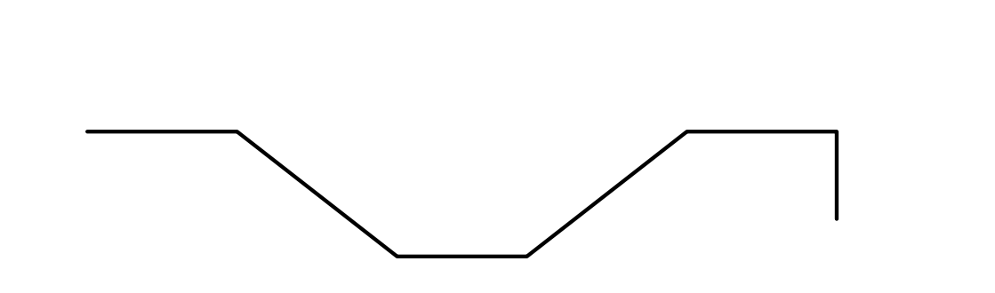
HPKata/Distribution/Assets/IMG/Kata-99-13.PNG
