Lightingsang/AddinRebar/HPKata/Distribution/Assets/IMG/Kata-99-13a.PNG

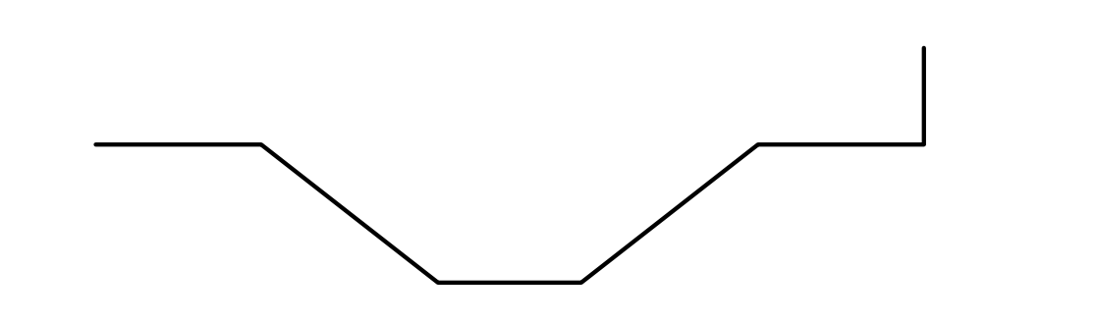
HPKata/Distribution/Assets/IMG/Kata-99-13a.PNG
