Lightingsang/AddinRebar/HPKata/Distribution/Assets/IMG/Kata-99-21.PNG

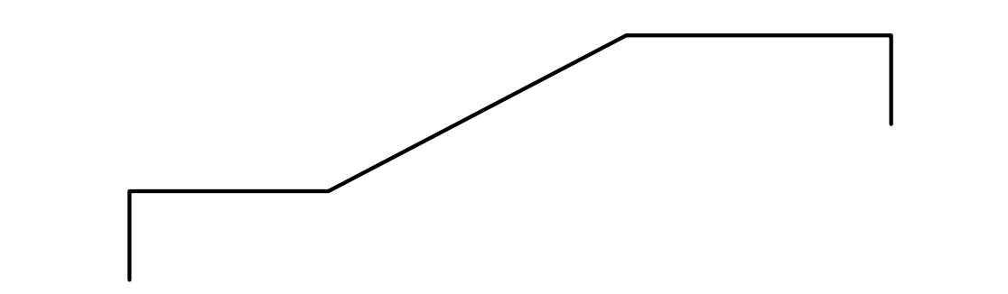
HPKata/Distribution/Assets/IMG/Kata-99-21.PNG
