Lightingsang/AddinRebar/HPKata/Distribution/Assets/IMG/Kata-99-43.PNG

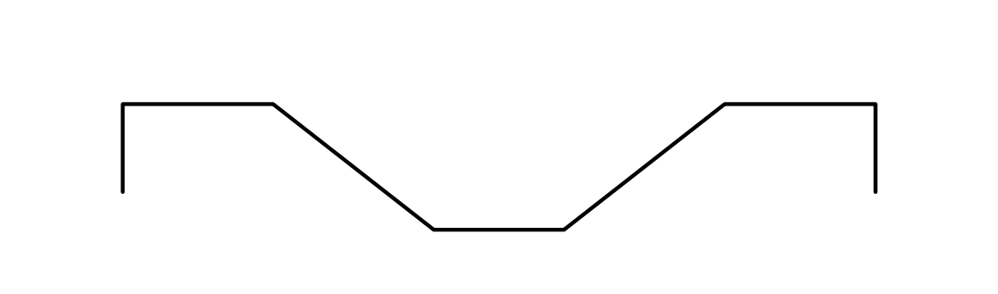
HPKata/Distribution/Assets/IMG/Kata-99-43.PNG
