Lightingsang/AddinRebar/HPKata/Distribution/Assets/IMG/Kata-99-43a.PNG

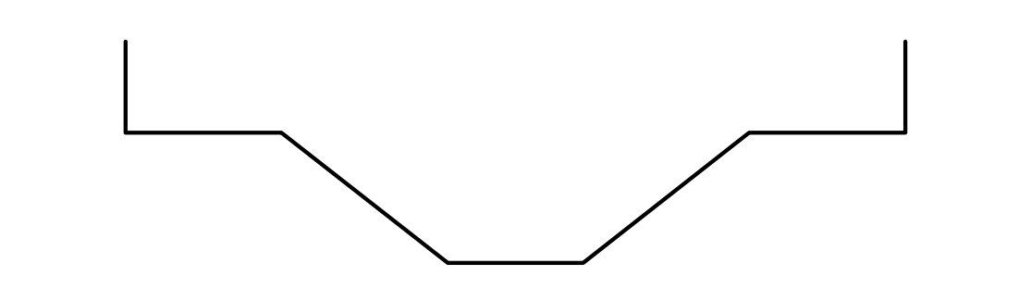
HPKata/Distribution/Assets/IMG/Kata-99-43a.PNG
