Lightingsang/AddinRebar/HPKata/Distribution/Assets/IMG/Kata-99-251a.PNG

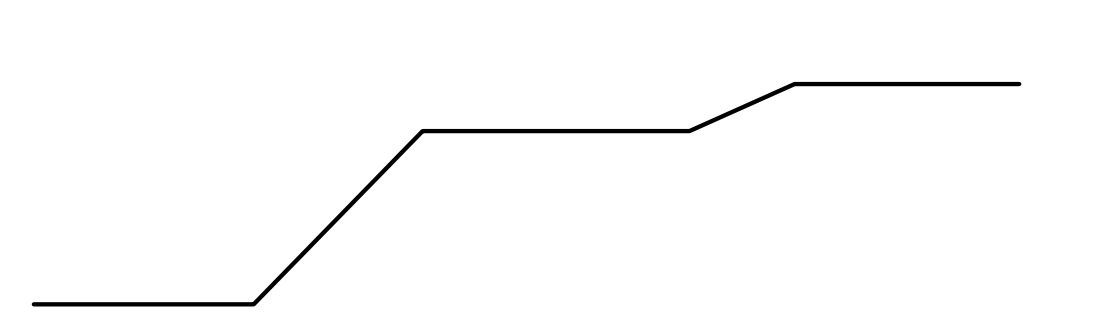
HPKata/Distribution/Assets/IMG/Kata-99-251a.PNG
