Lightingsang/AddinRebar/HPRobot/HPRobot.McpBridge/Resources/HPRobotMcpBridge_256.png

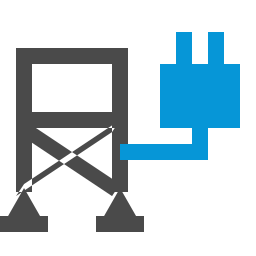
HPRobot/HPRobot.McpBridge/Resources/HPRobotMcpBridge_256.png
