Lightingsang/AddinRebar/HPSap2000/HPSap2000.McpBridge/Resources/HPSap2000McpBridge_256.png

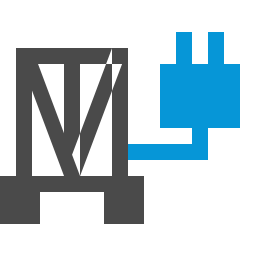
HPSap2000/HPSap2000.McpBridge/Resources/HPSap2000McpBridge_256.png
