Lightingsang/AddinRebar/plans/260916-0005-navisworks-ribbon-tab/reports/ribbon-model.png

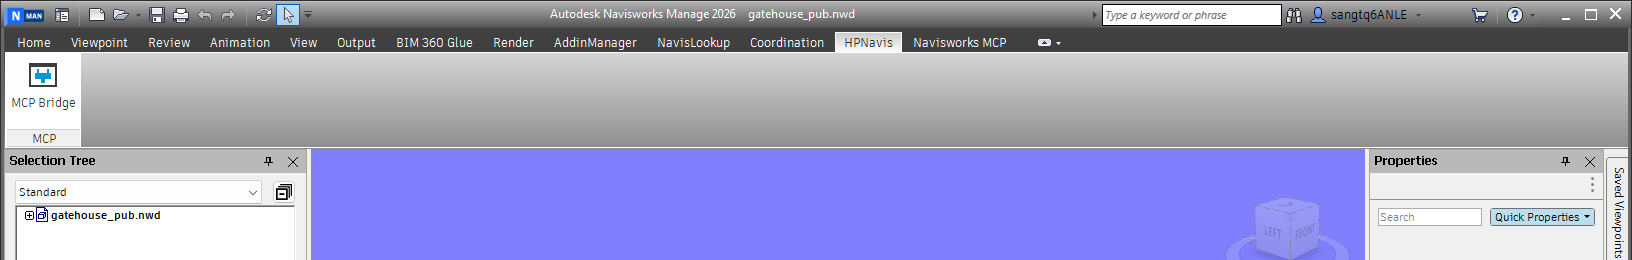
plans/260916-0005-navisworks-ribbon-tab/reports/ribbon-model.png
