Lightingsang/AddinRebar/plans/260916-0005-navisworks-ribbon-tab/reports/ribbon-nodoc.png

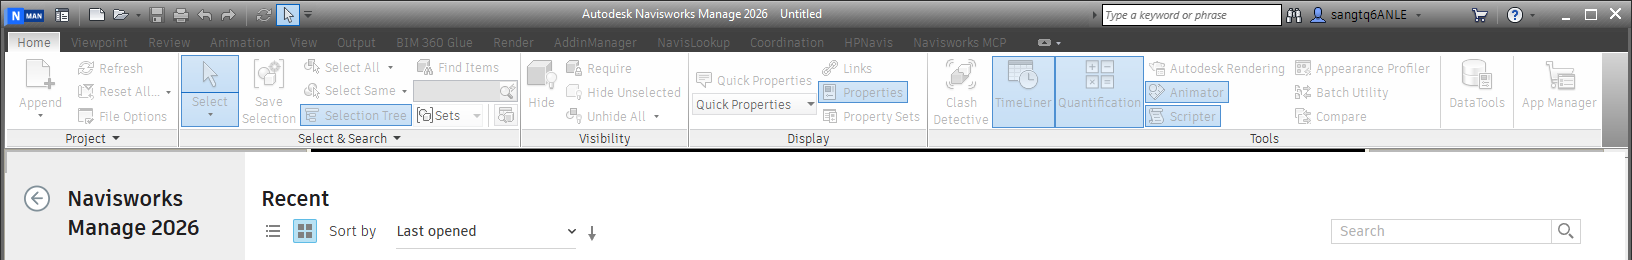
plans/260916-0005-navisworks-ribbon-tab/reports/ribbon-nodoc.png
