Lightingsang/AddinRebar/plans/260919-1910-materialdesign-xaml-adoption/reports/autocad-live/bridge-dark-again.png

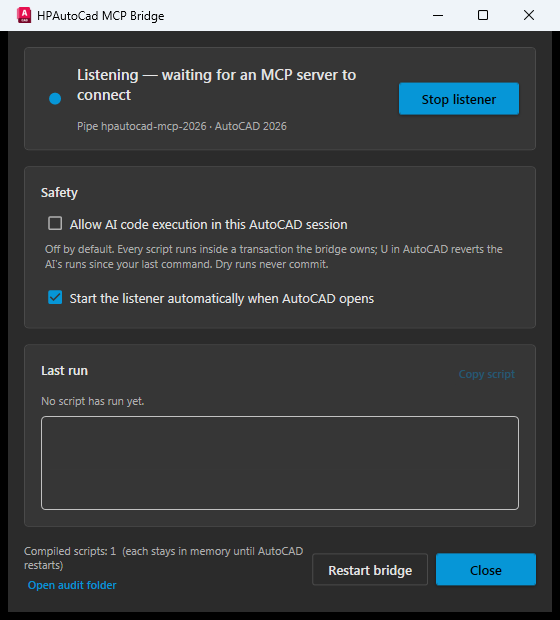
plans/260919-1910-materialdesign-xaml-adoption/reports/autocad-live/bridge-dark-again.png
