Lightingsang/AddinRebar/plans/260919-1910-materialdesign-xaml-adoption/reports/autocad-live/coload/hpgeo-bridge-first.png

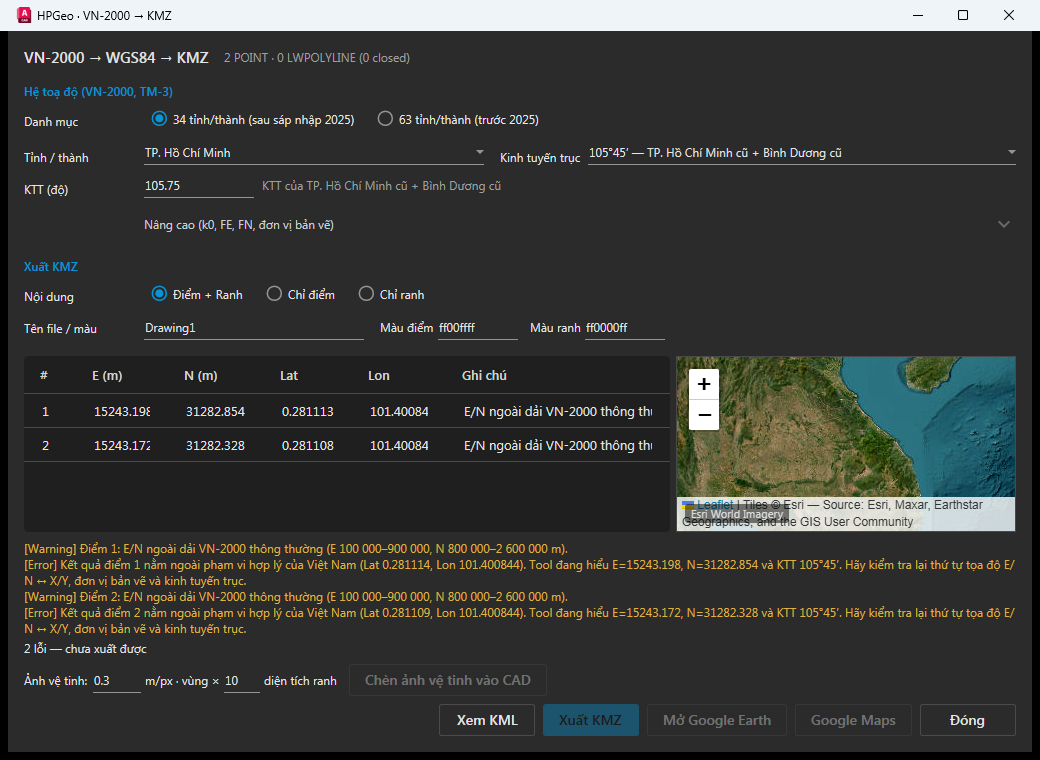
plans/260919-1910-materialdesign-xaml-adoption/reports/autocad-live/coload/hpgeo-bridge-first.png
