Lightingsang/AddinRebar/plans/260919-1910-materialdesign-xaml-adoption/reports/autocad-live/coload/hpgeo-hpgeo-first.png

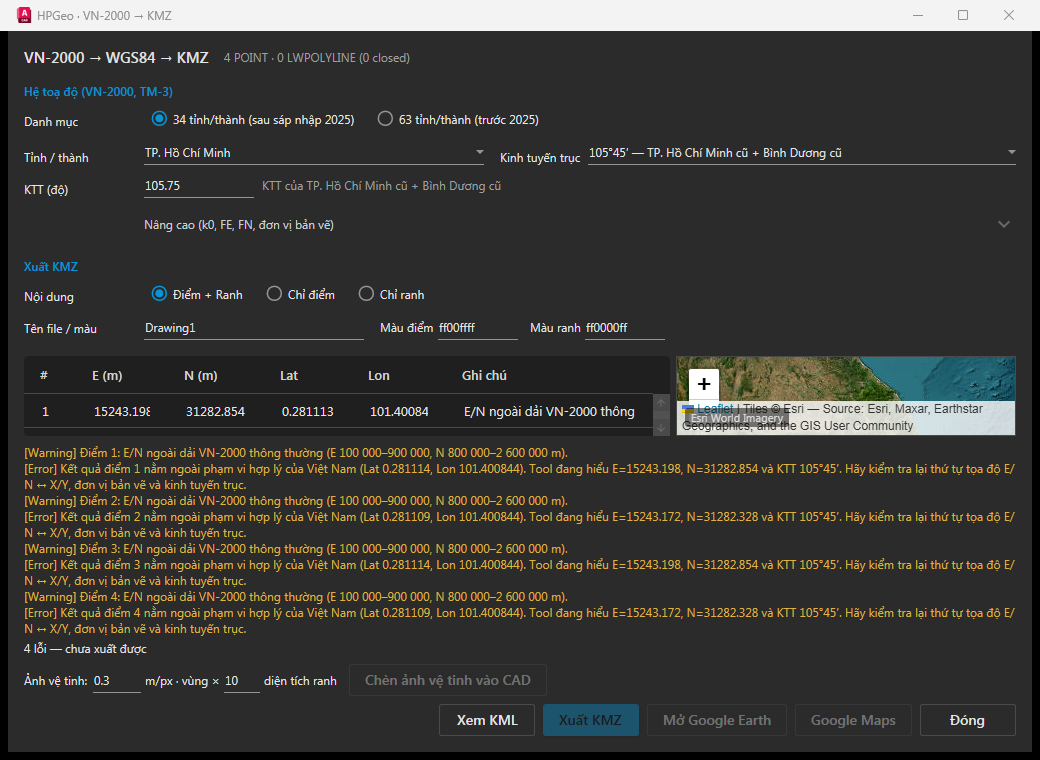
plans/260919-1910-materialdesign-xaml-adoption/reports/autocad-live/coload/hpgeo-hpgeo-first.png
