Lightingsang/AddinRebar/plans/260919-1910-materialdesign-xaml-adoption/reports/civil3d-live/bridge-light-live.png

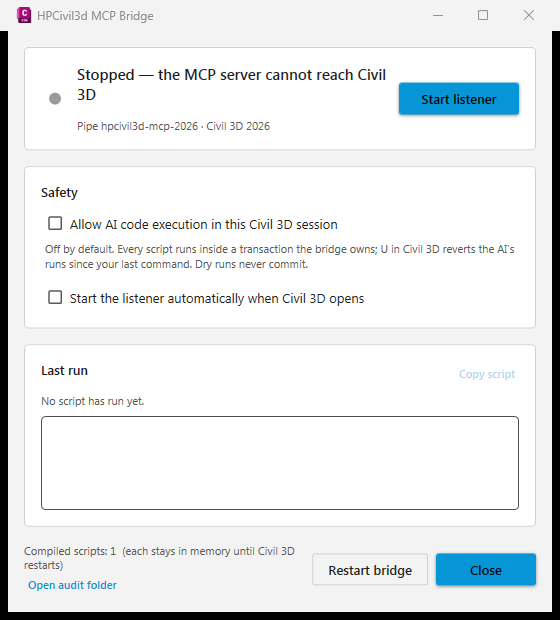
plans/260919-1910-materialdesign-xaml-adoption/reports/civil3d-live/bridge-light-live.png
