Lightingsang/AddinRebar/plans/260919-1910-materialdesign-xaml-adoption/reports/etabs-window-published/etabs-bridge-dark.png

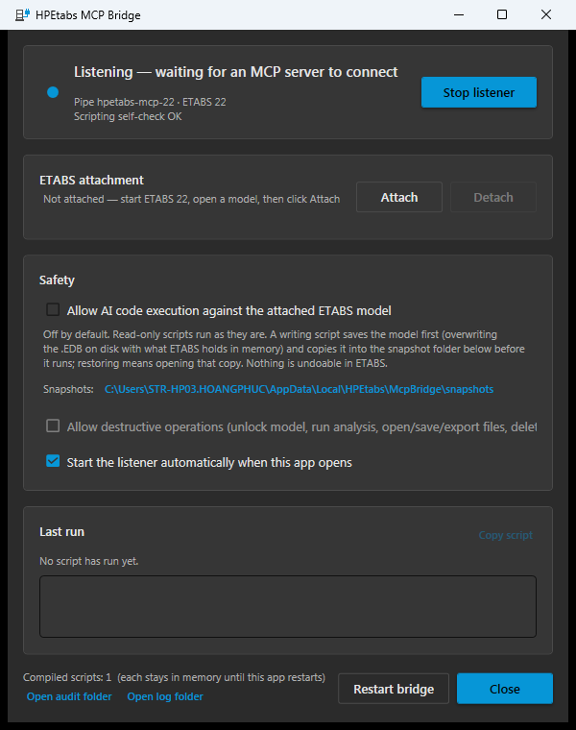
plans/260919-1910-materialdesign-xaml-adoption/reports/etabs-window-published/etabs-bridge-dark.png
