Lightingsang/AddinRebar/plans/260919-1910-materialdesign-xaml-adoption/reports/etabs-window-published/etabs-bridge-light.png

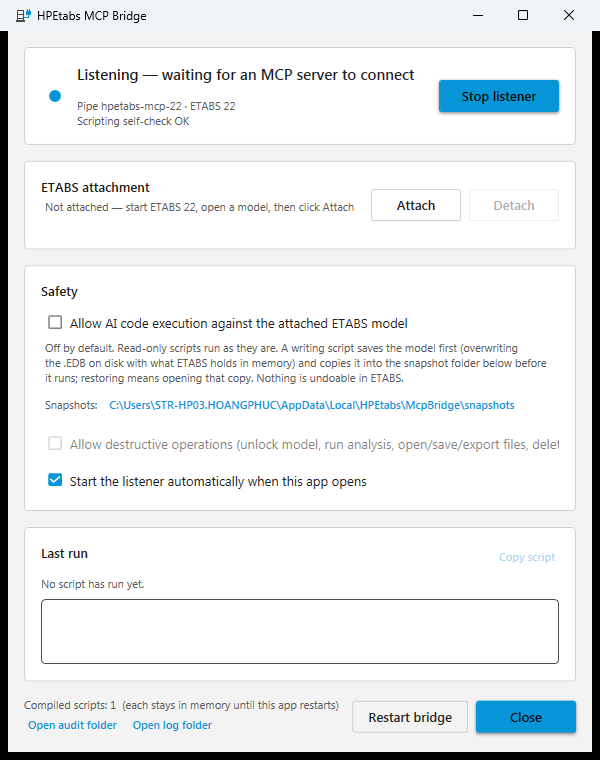
plans/260919-1910-materialdesign-xaml-adoption/reports/etabs-window-published/etabs-bridge-light.png
