Lightingsang/AddinRebar/plans/260919-1910-materialdesign-xaml-adoption/reports/hpgeo-live/combobox-popup.png

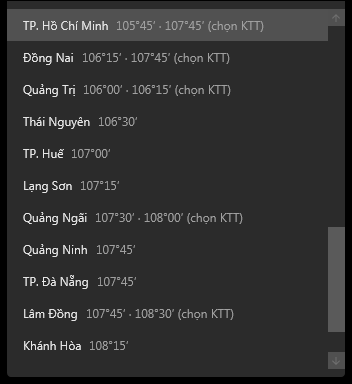
plans/260919-1910-materialdesign-xaml-adoption/reports/hpgeo-live/combobox-popup.png
