Lightingsang/AddinRebar/plans/260919-1910-materialdesign-xaml-adoption/reports/hpgeo-live/dialog-light.png

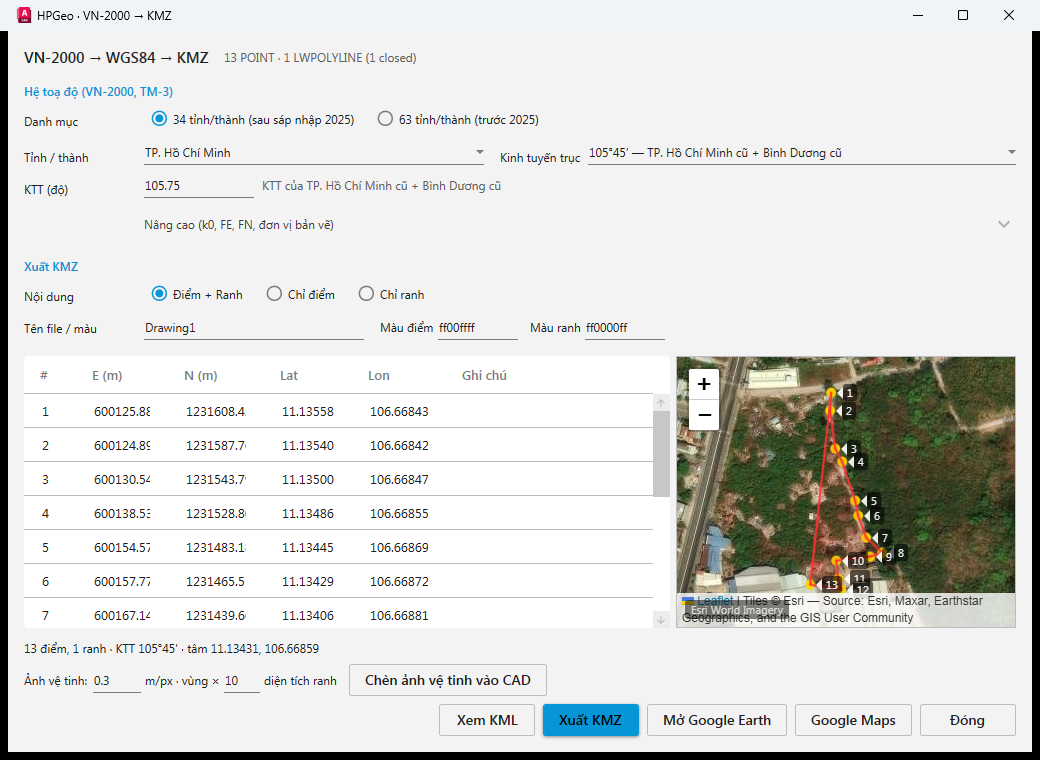
plans/260919-1910-materialdesign-xaml-adoption/reports/hpgeo-live/dialog-light.png
