Lightingsang/AddinRebar/plans/260919-1910-materialdesign-xaml-adoption/reports/revit-bridge-window/revit-mcp-bridge-window.png

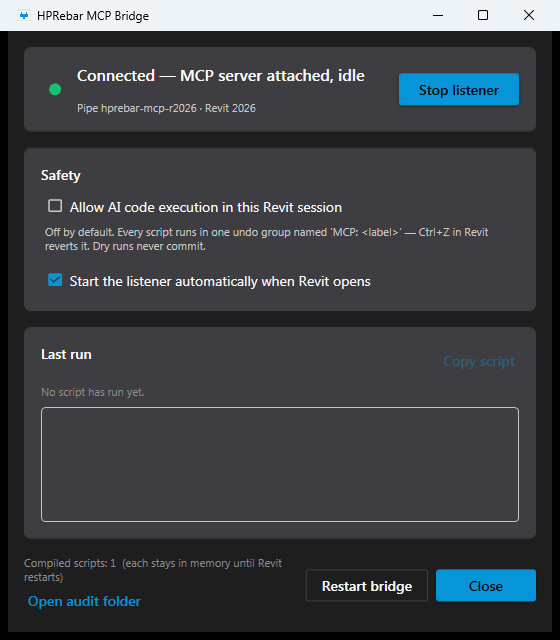
plans/260919-1910-materialdesign-xaml-adoption/reports/revit-bridge-window/revit-mcp-bridge-window.png
