Lightingsang/AddinRebar/plans/260919-1910-materialdesign-xaml-adoption/reports/s0a-r24/s0a-light.png

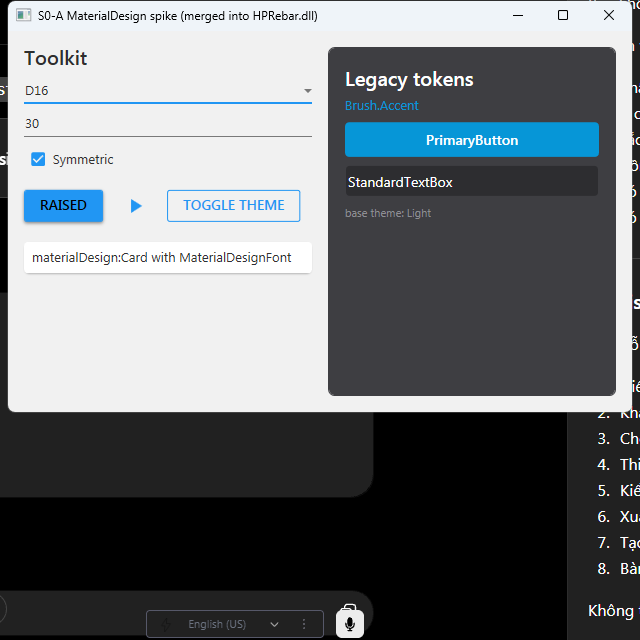
plans/260919-1910-materialdesign-xaml-adoption/reports/s0a-r24/s0a-light.png
