Lightingsang/AddinRebar/HPDcePro/assets/Excel/File V.2020/04. DCE_CheckBasicDesign_2020.xlsm

Sheet: Displ_Wind
DBIM
Project Code / Mã dự án |  |  | - |  |  | Rev.No. |  |  | 00
Project / Dự án |  |  | - |  |  | Date / Ngày |  |  | 2026-09-16
The Client / Chủ đầu tư |  |  | - |  |  | Designer / Thiết kế |  |  | -
Item / Hạng mục |  |  | Chuyển vị giới hạn |  |  | Checker / Kiểm tra |  |  | -
 | MAXIMUM STORY DISPLACEMENT |  |  | Displ | H/500 | MAXIMUM STORY DRIFTS |  |  | Drift | 0.002
 |  |  |  | Global X | Global Y |  |  |  | Global X | Global Y
 |  |  |  | SLS05 | SLS05 |  |  |  | SLS05 | SLS05
 | Story | Z | SLS05-UX | SLS05-UY | Check | Story | Z | X-Dir | Y-Dir | Check | Limit Displ | Limit
 | - | m | m | m | - | - | m | - | - | - | mm | -
 | MAI | 44.1 | 0.001904881889 | 8.461585835e-05 | OK | MAI | 44.1 | 7.263227185e-05 | 5.370261908e-05 | OK | 0.0882 | 0.002
 | AP MAI | 41.1 | 0.001676747387 | 3.348238448e-05 | OK | AP MAI | 41.1 | 0.0002884791613 | 0.0002604391212 | OK | 0.0822 | 0.002
 | T9 | 37.2 | 0.001440056174 | 9.19594101e-06 | OK | T9 | 37.2 | 0.0004671037588 | 0.0003744767074 | OK | 0.0744 | 0.002
 | T8 | 33.3 | 0.001248847982 | 0.0001000305858 | OK | T8 | 33.3 | 0.0005900385367 | 0.0004667069452 | OK | 0.0666 | 0.002
 | T7 | 29.4 | 0.001076843908 | 0.0002050771058 | OK | T7 | 29.4 | 0.0006805638932 | 0.0005401896078 | OK | 0.0588 | 0.002
 | T6 | 25.5 | 0.0009198338971 | 0.0003087580408 | OK | T6 | 25.5 | 0.0007628514254 | 0.0006073169576 | OK | 0.051 | 0.002
 | T5 | 21.6 | 0.0007802473411 | 0.0003906969351 | OK | T5 | 21.6 | 0.0008531567736 | 0.0006699022904 | OK | 0.0432 | 0.002
 | T4 | 17.7 | 0.0006416607217 | 0.000419443443 | OK | T4 | 17.7 | 0.0009348847459 | 0.000702858593 | OK | 0.0354 | 0.002
 | T3 | 12.6 | 0.0004734818748 | 0.0002787920528 | OK | T3 | 12.6 | 0.0008763830418 | 0.0006222978432 | OK | 0.0252 | 0.002
 | T2 | 8.1 | 0.0001630220547 | 4.822880014e-05 | OK | T2 | 8.1 | 0.0006528245753 | 0.0004319772816 | OK | 0.0162 | 0.002
 | T1 | 3 | 2.414343251e-06 | 1.004267169e-06 | OK | T1 | 3 | 4.7155075e-05 | 4.367763236e-05 | OK | 0.006 | 0.002
 | HAM | 0 | 1.299887137e-05 | 6.181854629e-06 |  | HAM | 0 | 9.813366987e-05 | 5.495879681e-05 |  | 0 | 0.002

Sheet: Overturning_Wind
DBIM |  |  |  |  |  |  |  |  |  |  |  |  |  | ULS11_Q3.6
Project Code / Mã dự án |  |  | - |  |  | Rev.No. |  |  | 00 |  |  |  |  | ULS12_Q3.6
Project / Dự án |  |  | - |  |  | Date / Ngày |  |  | 2026-09-16
The Client / Chủ đầu tư |  |  | - |  |  | Designer / Thiết kế |  |  | -
Item / Hạng mục |  |  | Kiểm tra ổn định chống lật. |  |  | Checker / Kiểm tra |  |  | -
OVERTURNING MOMENT SUBJECTED TO WIND LOAD |  |  |  |  |  |  |  | ĐK: MCL/ML≥1.5
MCL-X | ML-X | MCL/ML | Check | MCL-Y | ML-Y | MCL/ML | Check | Case-UX | Case-UY | Diaphragm
8276937.743 | 165380.07 | 50.048 | OK | 12269161.9 | 161162.3217 | 76.129 | OK | SLS08 | SLS09 | D1
Story | Elevation | XCM | YCM | Mass | Wind Force |  | MCL-X | MCL-Y | ML-X | ML-Y
 | (m) | (m) | (m) | (kN) | Vx | Vy | (kNm) | (kNm) | (kNm) | (kNm) | 3.1
MAI | 44.10 | 22.19 | 30.46 | 2683.97 | 185.65 | 181.47 | 59560.80 | 81761.19 | 8762.49 | 8565.34 | 0
AP MAI | 41.10 | 21.20 | 31.24 | 34356.62 | 642.64 | 630.60 | 728352.81 | 1073298.11 | 28404.75 | 27872.65 | 0
T9 | 37.20 | 20.61 | 31.08 | 36188.38 | 679.27 | 666.89 | 745813.10 | 1124639.38 | 27374.58 | 26875.82 | 0
T8 | 33.30 | 20.56 | 31.10 | 35715.89 | 653.80 | 639.55 | 734291.46 | 1110642.85 | 23798.28 | 23279.56 | 0
T7 | 29.40 | 20.56 | 31.10 | 35715.89 | 625.12 | 608.68 | 734291.46 | 1110642.85 | 20316.32 | 19782.07 | 0
T6 | 25.50 | 20.56 | 31.10 | 35715.89 | 590.25 | 571.52 | 734291.46 | 1110642.85 | 16881.25 | 16345.47 | 0
T5 | 21.60 | 20.49 | 31.15 | 35452.64 | 547.89 | 527.43 | 726542.62 | 1104200.59 | 13532.81 | 13027.47 | 0
T4 | 17.70 | 20.51 | 31.05 | 38113.63 | 565.59 | 542.47 | 781595.34 | 1183331.42 | 11764.26 | 11283.39 | 0
T3 | 12.60 | 22.97 | 31.57 | 37654.83 | 512.49 | 485.99 | 864791.87 | 1188663.03 | 8046.08 | 7630.10 | 0
T2 | 8.10 | 20.86 | 32.02 | 32992.82 | 302.06 | 331.02 | 688306.19 | 1056482.05 | 3383.02 | 3707.48 | 0
T1 | 3.00 | 22.74 | 31.86 | 39716.99 | 510.85 | 457.86 | 903069.44 | 1265410.59 | 3116.21 | 2792.97 | 0
HAM | 0.00 | 21.02 | 31.36 | 27409.36 | 1.860410521e-06 | 0.00 | 576031.18 | 859446.98 | 5.767272614e-06 | 0.00 | 0
Base | -3.10 | 0.00 | 0.00 | 0.00 | 0.00 | 0.00 | 0.00 | 0.00 | 0.00 | 0.00 | -3.1 | ETABS 2015,2016,2017 | ETABS 2018 >>
 |  |  |  |  |  |  |  |  |  |  |  | 1. Story Data | 1. Story Definitions
 |  |  |  |  |  |  |  |  |  |  |  | 2. Material list by Story | 2. Material list by Story
 |  |  |  |  |  |  |  |  |  |  |  | 3. Diaphragm Max/Avg Drifts | 3. Diaphragm Max Over Avg Drifts
 |  |  |  |  |  |  |  |  |  |  |  | 4. Story Forces | 4. Story Forces
 |  |  |  |  |  |  |  |  |  |  |  | 5. Centers of Mass and Rigidity | 5. Centers of Mass and Rigidity
 |  |  |  |  |  |  |  |  |  |  |  | 6. Mass Summary by Story | 6. Mass Summary by Story

Sheet: Drifts_EQ
DBIM
Project Code / Mã dự án |  |  | - |  |  |  |  | Rev.No. |  |  | 00
Project / Dự án |  |  | - |  |  |  |  | Date / Ngày |  |  | 2026-09-16
The Client / Chủ đầu tư |  |  | - |  |  |  |  | Designer / Thiết kế |  |  | -
Item / Hạng mục |  |  | Hạn chế chuyển vị ngang |  |  |  |  | Checker / Kiểm tra |  |  | -
MAXIMUM STORY DRIFTS |  | Global X | Global Y | Q |  | Check P-Delta under seismic action |  | Global X | Global Y | Q | Gia Tốc
 |  | ULS11_Q3.6 | ULS12_Q3.6 | 3.9 |  |  |  | ULS11_Q3.6 | ULS12_Q3.6 | 3.9 | 9.81
Cấp hậu quả công trình xây dựng |  |  | C3-a |  |  |  |  | Ɵ < 0.1 |  | NO CHECK
Hệ số triết giảm: |  |  | v = | 0.4 |  |  |  | 0.1 ≤ Ɵ ≤ 0.3 |  | CHECK
chuyển vị ngang tương đối: |  |  | dr.ѵ≤0.005.h | 0.005 |  |  |  | Ɵ > 0.3 |  | FAIL
 |  |  |  |  |  |  |  |  |  |  |  |  |  | ETABS 2015,2016,2017 |  |  | ETABS 2018 >>
 |  |  |  |  |  |  |  |  |  |  |  |  |  | 1. Story Data |  |  | 1. Story Definitions
 |  |  |  |  |  |  |  |  |  |  |  |  |  | 2. Material list by Story |  |  | 2. Material list by Story
 |  |  |  |  |  |  |  |  |  |  |  |  |  | 3. Diaphragm Max/Avg Drifts |  |  | 3. Diaphragm Max Over Avg Drifts
 |  |  |  |  |  |  |  |  |  |  |  |  |  | 4. Story Forces |  |  | 4. Story Forces
 |  |  |  |  |  |  |  |  |  |  |  |  |  | 5. Centers of Mass and Rigidity |  |  | 5. Centers of Mass and Rigidity
 |  |  |  |  |  |  |  |  |  |  |  |  |  | 6. Mass Summary by Story |  |  | 6. Mass Summary by Story
 |  | DRIFTS MODEL 1 |  |  | DRIFTS MODEL 2
Story Name | Z | ULS11_Q3.6-UX | ULS12_Q3.6-UY | Check | ULS11_Q3.6-UX | ULS12_Q3.6-UY | Z | PTOT | VTOT (kN) |  | q |  | Check | DRIFTS | P-Delta
- | m | - | - | - |  |  | m | kN | ULS11_Q3.6 | ULS12_Q3.6 | QX | QY | - | - | - | -
R | 82.2 | 0.001351 | 0.001105 | OK | 0.001351 | 0.001105 | 82.2 | 1404.687033 | 143.977 | 113.8662 | 0.05140512379 | 0.05316326327 | NO CHECK | 0.003205128205 | 0.1 | 0.3
RF | 79.2 | 0.001531 | 0.00115 | OK | 0.001531 | 0.00115 | 79.2 | 5781.331224 | 466.1985 | 388.2187 | 0.07404517733 | 0.06679036981 | NO CHECK | 0.003205128205 | 0.1 | 0.3
L19 | 75.8 | 0.001572 | 0.0012 | OK | 0.001572 | 0.0012 | 75.8 | 9992.997702 | 707.3034 | 569.156 | 0.0866178083 | 0.08216943904 | NO CHECK | 0.003205128205 | 0.1 | 0.3
L18 | 72.4 | 0.001614 | 0.001252 | OK | 0.001614 | 0.001252 | 72.4 | 14204.66418 | 884.4016 | 686.0132 | 0.1010996352 | 0.1011037896 | CHECK | 0.003205128205 | 0.1 | 0.3
L17 | 69 | 0.001649 | 0.001296 | OK | 0.001649 | 0.001296 | 69 | 18416.33066 | 1016.5732 | 766.5887 | 0.1165063805 | 0.1214256115 | CHECK | 0.003205128205 | 0.1 | 0.3
L16 | 65.6 | 0.001677 | 0.00133 | OK | 0.001677 | 0.00133 | 65.6 | 22627.99714 | 1124.1604 | 833.5704 | 0.1316483748 | 0.140805649 | CHECK | 0.003205128205 | 0.1 | 0.3
L15 | 62.2 | 0.001693 | 0.001352 | OK | 0.001693 | 0.001352 | 62.2 | 26839.66361 | 1218.8454 | 894.4 | 0.1453951805 | 0.1582291797 | CHECK | 0.003205128205 | 0.1 | 0.3
L14 | 58.8 | 0.001699 | 0.001364 | OK | 0.001699 | 0.001364 | 58.8 | 31051.33009 | 1302.9909 | 946.2303 | 0.1579053379 | 0.1745670748 | CHECK | 0.003205128205 | 0.1 | 0.3
L13 | 55.4 | 0.001697 | 0.001367 | OK | 0.001697 | 0.001367 | 55.4 | 35262.99657 | 1376.8173 | 987.9819 | 0.1695076683 | 0.1902844714 | CHECK | 0.003205128205 | 0.1 | 0.3
L12 | 52 | 0.001686 | 0.001363 | OK | 0.001686 | 0.001363 | 52 | 39474.66305 | 1444.2473 | 1025.8535 | 0.1797210903 | 0.2045472052 | CHECK | 0.003205128205 | 0.1 | 0.3
L11 | 48.6 | 0.001669 | 0.001354 | OK | 0.001669 | 0.001354 | 48.6 | 43686.32953 | 1513.0945 | 1069.9839 | 0.1879318757 | 0.2156014046 | CHECK | 0.003205128205 | 0.1 | 0.3
L10 | 45.2 | 0.001645 | 0.001338 | OK | 0.001645 | 0.001338 | 45.2 | 47897.996 | 1590.6146 | 1127.8749 | 0.1931892197 | 0.2216037636 | CHECK | 0.003205128205 | 0.1 | 0.3
L9 | 41.8 | 0.00161 | 0.001313 | OK | 0.00161 | 0.001313 | 41.8 | 52109.66248 | 1678.1906 | 1200.457 | 0.1949698507 | 0.2222803055 | CHECK | 0.003205128205 | 0.1 | 0.3
L8 | 38.4 | 0.001561 | 0.001275 | OK | 0.001561 | 0.001275 | 38.4 | 56321.32896 | 1770.2313 | 1282.8597 | 0.1936914225 | 0.2183074332 | CHECK | 0.003205128205 | 0.1 | 0.3
L7 | 35 | 0.001492 | 0.001218 | OK | 0.001492 | 0.001218 | 35 | 60532.99544 | 1859.2029 | 1368.6101 | 0.1894518311 | 0.2100991619 | CHECK | 0.003205128205 | 0.1 | 0.3
L6 | 31.6 | 0.001392 | 0.001135 | OK | 0.001392 | 0.001135 | 31.6 | 64744.66192 | 1942.2973 | 1454.4536 | 0.180963965 | 0.1970446125 | CHECK | 0.003205128205 | 0.1 | 0.3
L5 | 28.2 | 0.001247 | 0.001012 | OK | 0.001247 | 0.001012 | 28.2 | 68956.32839 | 2022.4865 | 1541.7647 | 0.1658133747 | 0.1765229395 | CHECK | 0.003205128205 | 0.1 | 0.3
L4 | 24.8 | 0.001004 | 0.000858 | OK | 0.001004 | 0.000858 | 24.8 | 73167.99487 | 2102.0045 | 1632.3465 | 0.1362968541 | 0.1499894443 | CHECK | 0.003205128205 | 0.1 | 0.3
L3 | 21.4 | 0.0005 | 0.000622 | OK | 0.0005 | 0.000622 | 21.4 | 77379.66135 | 2176.2958 | 1722.0482 | 0.06933356193 | 0.1090025137 | CHECK | 0.003205128205 | 0.1 | 0.3
L2 | 18 | 0.000374 | 0.000324 | OK | 0.000374 | 0.000324 | 18 | 87857.68017 | 2367.6776 | 1963.6934 | 0.05412443497 | 0.05653477506 | NO CHECK | 0.003205128205 | 0.1 | 0.3
GF | 12.5 | 8e-05 | 0.000222 | OK | 8e-05 | 0.000222 | 12.5 | 101272.6923 | 2498.113 | 2144.8597 | 0.012648379 | 0.04088001514 | NO CHECK | 0.003205128205 | 0.1 | 0.3
HAM 1 | 8.5 | 6.6e-05 | 0.000209 | OK | 6.6e-05 | 0.000209 | 8.5 | 115904.9636 | 2608.9 | 2293.2879 | 0.01143544698 | 0.04119593351 | NO CHECK | 0.003205128205 | 0.1 | 0.3
HAM 2 | 4.5 | 7.1e-05 | 0.000207 | OK | 7.1e-05 | 0.000207 | 4.5 | 130537.2349 | 2676.1427 | 2378.7252 | 0.01350666403 | 0.04430217906 | NO CHECK | 0.003205128205 | 0.1 | 0.3
HAM 3 | 0.5 | 6.7e-05 | 6e-05 | OK | 6.7e-05 | 6e-05 | 0.5 | 153626.1951 | 2703.3458 | 2400.9986 | 0.01484920086 | 0.01497232429 | NO CHECK | 0.003205128205 | 0.1 | 0.3
Base | 0 | 0 | 0 |  | 0 | 0 | 0 | 0 | 0 | 0 | #DIV/0! | #DIV/0! | #DIV/0! | 0.003205128205 | 0.1 | 0.3

Sheet: CONCRETE USAGE INDEX
DBIM
Project Code / Mã dự án |  | - |  |  |  | Rev.No. |  |  | 00
Project / Dự án |  | - |  |  |  | Date / Ngày |  |  | 2026-09-16
The Client / Chủ đầu tư |  | - |  |  |  | Designer / Thiết kế |  |  | -
Item / Hạng mục |  | - |  |  |  | Checker / Kiểm tra |  |  | -
CONCRETE USAGE INDEX (CUI)
 | Story | Volume | FloorArea | CUI | Wall | Column | z | Shear Wall+Clumn ratio | SLS01
 | - | m3 | m2 | - | m3 | m3 | m | - | Kn/m2
 | MAI | 129.1 | 91.51 | 1.41 | 66.6851147 | 17.90559953 | 44.1 | 30.81 | 47.59
 | AP MAI | 834.62 | 2464.95 | 0.34 | 19.23409557 | 80.82525565 | 41.1 | 1.04 | 13.32
 | T9 | 786.88 | 2351.56 | 0.33 | 19.23409557 | 78.86490176 | 37.2 | 1.07 | 14.66
 | T8 | 786.88 | 2351.56 | 0.33 | 19.23409557 | 78.86490176 | 33.3 | 1.07 | 14.46
 | T7 | 786.88 | 2351.56 | 0.33 | 19.23409557 | 78.86490176 | 29.4 | 1.07 | 14.46
 | T6 | 786.88 | 2351.56 | 0.33 | 19.23409557 | 78.86490176 | 25.5 | 1.07 | 14.46
 | T5 | 776.54 | 2351.97 | 0.33 | 19.23409557 | 78.86490176 | 21.6 | 1.07 | 14.3
 | T4 | 846.6 | 2362.14 | 0.36 | 25.15227882 | 135.8721195 | 17.7 | 1.34 | 15.69
 | T3 | 1080.6 | 2790.47 | 0.39 | 22.1931872 | 161.0387716 | 12.6 | 1.46 | 10.93
 | T2 | 959.19 | 2343.65 | 0.41 | 25.15227882 | 180.4434079 | 8.1 | 1.72 | 11.97
 | T1 | 1119.28 | 2944.77 | 0.38 | 168.485374 | 102.1672521 | 3 | 3.06 | 15.49 | ETABS 2015,2016,2017 | ETABS 2018 >>
 | HAM | 797.87 | 2592.19 | 0.31 | 15.28864007 | 105.5728272 | 0 | 1.5 | 8.83 | 1. Story Data | 1. Story Definitions
 | SUM | 9691.32 | 27347.89 | 0.35 | - | - | -3.1 | 1.54 | 13.58 | 2. Material list by Story | 2. Material list by Story
 |  |  |  |  |  |  |  |  |  | 3. Diaphragm Max/Avg Drifts | 3. Diaphragm Max Over Avg Drifts
 |  |  |  |  |  |  |  |  |  | 4. Story Forces | 4. Story Forces
 |  |  |  |  |  |  |  |  |  | 5. Centers of Mass and Rigidity | 5. Centers of Mass and Rigidity
 |  |  |  |  |  |  |  |  |  | 6. Mass Summary by Story | 6. Mass Summary by Story

Sheet: CHECK VD
DBIM
Project Code / Mã dự án |  |  |  | - |  |  |  | Rev.No. |  |  |  |  | 00 |  |  | Concrete |  | Limit |  | D.Class | Column | Wall
Project / Dự án |  |  |  | - |  |  |  | Date / Ngày |  |  |  |  | 2026-09-16 |  |  | - | - | D.Class | DCM | DCH | 0.55 | 0.35
The Client / Chủ đầu tư |  |  |  | - |  |  |  | Designer / Thiết kế |  |  |  |  | - |  |  | acc | 1.00 | Column | 0.65 | DCM | 0.65 | 0.40
Item / Hạng mục |  |  |  | Check tỷ số nén |  |  |  | Checker / Kiểm tra |  |  |  |  | - |  |  | gc | 1.20 | Wall | 0.40 | DCL | - | -
Story | Pier | NED_max | CaseCombo | B | H | Ac | Type | BT | fck | acc | gc | fcd | Vd | Check
 |  | kN |  | mm | mm | mm2 | - | - | MPa |  |  | MPa |  | Column | Wall
MAI | C1 | 65.99276389 | ULS12 Min | 450 | 0 | 159043.1281 | Column | B30 | 27.9 | 1.00 | 1.20 | 23.23 | 0.018 | OK
AP MAI | C1 | 856.3978165 | ULS12 Min | 600 | 600 | 360000 | Column | B30 | 27.9 | 1.00 | 1.20 | 23.23 | 0.102 | OK
T9 | C1 | 1752.370696 | ULS12 Min | 600 | 600 | 360000 | Column | B30 | 27.9 | 1.00 | 1.20 | 23.23 | 0.210 | OK
T8 | C1 | 2653.98701 | ULS12 Min | 600 | 600 | 360000 | Column | B30 | 27.9 | 1.00 | 1.20 | 23.23 | 0.317 | OK
T7 | C1 | 3580.66966 | ULS11 Min | 600 | 600 | 360000 | Column | B30 | 27.9 | 1.00 | 1.20 | 23.23 | 0.428 | OK
T6 | C1 | 4520.100357 | ULS11 Min | 600 | 600 | 360000 | Column | B30 | 27.9 | 1.00 | 1.20 | 23.23 | 0.541 | OK
T5 | C1 | 5447.086813 | ULS11 Min | 600 | 600 | 360000 | Column | B30 | 27.9 | 1.00 | 1.20 | 23.23 | 0.651 | NOTOK
T4 | C1 | 6504.589147 | ULS11 Min | 800 | 800 | 640000 | Column | B30 | 27.9 | 1.00 | 1.20 | 23.23 | 0.438 | OK
T3 | C1 | 7503.155549 | ULS11 Min | 800 | 800 | 640000 | Column | B30 | 27.9 | 1.00 | 1.20 | 23.23 | 0.505 | OK
T2 | C1 | 8505.987034 | ULS11 Min | 800 | 800 | 640000 | Column | B30 | 27.9 | 1.00 | 1.20 | 23.23 | 0.572 | OK
T1 | C1 | 1944.316043 | ULS11 Min | 800 | 800 | 640000 | Column | B30 | 27.9 | 1.00 | 1.20 | 23.23 | 0.131 | OK
HAM | C1 | 10096.14285 | ULS11 Min | 800 | 800 | 640000 | Column | B30 | 27.9 | 1.00 | 1.20 | 23.23 | 0.679 | NOTOK
AP MAI | C2 | 861.3970189 | ULS11 Min | 600 | 600 | 360000 | Column | B30 | 27.9 | 1.00 | 1.20 | 23.23 | 0.103 | OK
T9 | C2 | 1915.32674 | ULS12 Min | 600 | 600 | 360000 | Column | B30 | 27.9 | 1.00 | 1.20 | 23.23 | 0.229 | OK
T8 | C2 | 2987.474008 | ULS12 Min | 600 | 600 | 360000 | Column | B30 | 27.9 | 1.00 | 1.20 | 23.23 | 0.357 | OK
T7 | C2 | 4075.13223 | ULS12 Min | 600 | 600 | 360000 | Column | B30 | 27.9 | 1.00 | 1.20 | 23.23 | 0.487 | OK
T6 | C2 | 5181.789806 | ULS12 Min | 600 | 600 | 360000 | Column | B30 | 27.9 | 1.00 | 1.20 | 23.23 | 0.620 | OK
T5 | C2 | 6323.831674 | ULS12 Min | 600 | 600 | 360000 | Column | B30 | 27.9 | 1.00 | 1.20 | 23.23 | 0.756 | NOTOK
T4 | C2 | 7465.516334 | ULS12 Min | 800 | 800 | 640000 | Column | B30 | 27.9 | 1.00 | 1.20 | 23.23 | 0.502 | OK
T3 | C2 | 8447.463512 | ULS12 Min | 800 | 800 | 640000 | Column | B30 | 27.9 | 1.00 | 1.20 | 23.23 | 0.568 | OK
T2 | C2 | 9432.407577 | ULS12 Min | 800 | 800 | 640000 | Column | B30 | 27.9 | 1.00 | 1.20 | 23.23 | 0.635 | OK
T1 | C2 | 10345.25767 | ULS12 Min | 800 | 800 | 640000 | Column | B30 | 27.9 | 1.00 | 1.20 | 23.23 | 0.696 | NOTOK
HAM | C2 | 11254.49332 | ULS12 Min | 800 | 800 | 640000 | Column | B30 | 27.9 | 1.00 | 1.20 | 23.23 | 0.757 | NOTOK
