Lightingsang/AddinRebar/HPKata/Distribution/Assets/Kata ENG.xlsm

Sheet: Vach
Beam width (mm) |  | 800 | Width of edge zone |  | 675 | 1:25 | 1:30 | 1:50 | 1:100 |  |  |  |  |  |  |  |  |  |  |  |  |  |  |  |  |  |  | x | y1 | y2 | x1 | y | x2
Slab thickness (mm) |  | 200 | Column scale |  | 1:30 | 1:20 | 1:25 | 1:30 | 1:40 |  |  |  |  |  |  |  |  |  | Cạnh b | 3000 | Số thứ tự | Tọa độ thép b1 |  |  | Tọa độ thép h1 |  |  | Tọa độ thép b2 |  |  | Tọa độ thép h2
Wall mark |  | V1 | Cross section scale |  | 1:20 |  | FALSE | FALSE | 2 |  |  |  |  |  |  |  |  |  | 675 | 1650 | 1 | -1450 | -250 | 250 | -1450 | -250 | 1450 | -687.5 | -250 | 250 | -825 | -250 | 825
No of wall |  | 1 | Bar cover (mm) |  | 30 | main stirrup | d10a100/200 |  |  |  |  |  |  |  |  |  |  |  | biên | giữa | 2 | -1345.833333 | -250 | 250 | -1450 | -166.6666667 | 1450 | -550 | -250 | 250 | -825 | -166.6666667 | 825
Foundation elevation (m) |  | -5.500 | End bar (d) |  | 15 | add stirrup | d8a400 |  |  |  |  |  |  |  |  |  |  |  | 7 | 11 | 3 | -1241.666667 | -250 | 250 | -1450 | -83.33333333 | 1450 | -412.5 | -250 | 250 | -825 | -83.33333333 | 825
 |  |  |  |  |  |  |  |  |  |  |  |  |  |  |  |  |  |  | Cạnh h | 600 | 4 | -1137.5 | -250 | 250 | -1450 | -2.842170943e-14 | 1450 | -275 | -250 | 250 | -825 | -2.842170943e-14 | 825
Level | Heigh | Wall geometry |  | No of main bar |  |  |  | Bar Diameter | Lap position | Beam depth | Đai tự bố trí |  |  |  |  |  |  |  | Lớp 1 | Lớp 2 | 5 | -1033.333333 | -250 | 250 | -1450 | 83.33333333 | 1450 | -137.5 | -250 | 250 | -825 | 83.33333333 | 825
 | m | Length | Width | Length |  | Width |  |  |  |  | Main stirrup | Edge stirrup | Stirrup C vertical |  | Stirrup C horizontal |  |  |  | 7 | 7 | 6 | -929.1666667 | -250 | 250 | -1450 | 166.6666667 | 1450 | 0 | -250 | 250 | -825 | 166.6666667 | 825
PILECAPS | 1.500 | mm | mm | Edge | Middle | Layer 1 | Layer 2 | mm | mm | mm | đk+kc | đk+kc | đk+kc | Số lượng | đk+kc | Số lượng |  |  | S biên | 104.1666667 | 7 | -825 | -250 | 250 | -1450 | 250 | 1450 | 137.5 | -250 | 250 | -825 | 250 | 825
BASEMENT | 3.000 | 3000 | 600 | 7 | 11 | 7 | 7 | 25 | 150 | 600 | d10a100/200 | d10a100/200 | d10a400 | 2/3 | d10a400 | 2 |  |  | S giữa | 137.5 | 8 | -825 | -250 | 250 | -1450 | 250 | 1450 | 275 | -250 | 250 | -825 | 250 | 825
FLOOR 1 | 3.500 | 3000 | 600 | 7 | 11 | 7 | 7 | 25 | 150 | 600 | d10a100/200 | d10a100/200 | d10a400 | 2/3 | d10a400 | 2 |  |  | S2 | 83.33333333 | 9 | -825 | -250 | 250 | -1450 | 250 | 1450 | 412.5 | -250 | 250 | -825 | 250 | 825
FLOOR 2 | 3.900 | 3000 | 600 | 7 | 11 | 7 | 7 | 25/20 | 150 | 400 | d10a100/200 | d10a100/200 | d10a400 | 2/3 | d10a400 | 2 |  |  | S2 | 83.33333333 | 10 | -825 | -250 | 250 | -1450 | 250 | 1450 | 550 | -250 | 250 | -825 | 250 | 825
FLOOR 3 | 4.600 | 3000 | 600 | 7 | 11 | 7 | 7 | 20 | 150 | 400 | d10a100/200 | d10a100/200 | d10a400 | 2/3 | d10a400 | 2 |  |  | Fix |  | 11 | -825 | -250 | 250 | -1450 | 250 | 1450 | 687.5 | -250 | 250 | -825 | 250 | 825
FLOOR 4 | 3.300 | 3000 | 600 | 7 | 11 | 7 | 7 | 20 | 150 | 600 | d10a100/200 | d10a100/200 | d10a400 | 2/3 | d10a400 | 2 |  |  | 1500 | 1500 | 12 | -825 | -250 | 250 | -1450 | 250 | 1450 | 687.5 | -250 | 250 | -825 | 250 | 825
FLOOR 5 | 3.300 | 3000 | 600 | 7 | 11 | 7 | 7 | 20 | 150 | 400 | d10a100/200 | d10a100/200 | d10a400 | 2/3 | d10a400 | 2 |  |  | -1500 | -1500 | 13 | -825 | -250 | 250 | -1450 | 250 | 1450 | 687.5 | -250 | 250 | -825 | 250 | 825
 |  |  |  |  |  |  |  |  |  |  |  |  |  |  |  |  |  |  | Bao ngoai |  | 14 | -825 | -250 | 250 | -1450 | 250 | 1450 | 687.5 | -250 | 250 | -825 | 250 | 825
 |  |  |  |  |  |  |  |  |  |  |  |  |  |  |  |  |  |  | -1500 | -300 | 15 | -825 | -250 | 250 | -1450 | 250 | 1450 | 687.5 | -250 | 250 | -825 | 250 | 825
 |  |  |  |  |  |  |  |  |  |  |  |  |  |  |  |  |  |  | 1500 | -300 | 16 | -825 | -250 | 250 | -1450 | 250 | 1450 | 687.5 | -250 | 250 | -825 | 250 | 825
 |  |  |  |  |  |  |  |  |  |  |  |  |  |  |  |  |  |  | 1500 | 300 | 17 | -825 | -250 | 250 | -1450 | 250 | 1450 | 687.5 | -250 | 250 | -825 | 250 | 825
 |  |  |  |  |  |  |  |  |  |  |  |  |  |  |  |  |  |  | -1500 | 300 | 18 | -825 | -250 | 250 | -1450 | 250 | 1450 | 687.5 | -250 | 250 | -825 | 250 | 825
 |  |  |  |  |  |  |  |  |  |  |  |  |  |  |  |  |  |  | -1500 | -300 | 19 | -825 | -250 | 250 | -1450 | 250 | 1450 | 687.5 | -250 | 250 | -825 | 250 | 825
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
 |  |  |  |  |  |  |  |  |  |  |  |  |  |  |  |  |  |  |  |  | 48 | 825 | -250 | 250 | -1450 | 250 | 1450 | 687.5 | -250 | 250 | -825 | 250 | 825
 |  |  |  |  |  |  |  |  |  |  |  |  |  |  |  |  |  |  |  |  | 49 | 825 | -250 | 250 | -1450 | 250 | 1450 | 687.5 | -250 | 250 | -825 | 250 | 825
 |  |  |  |  |  |  |  |  |  |  |  |  |  |  |  |  |  |  |  |  | 50 | 825 | -250 | 250 | -1450 | 250 | 1450 | 687.5 | -250 | 250 | -825 | 250 | 825

Sheet: Cot
Beam width (mm) |  | 800 | TRUE |  |  | 1:25 | 1:30 | 1:50 | 1:100 |  |  |  |  |  |  |  |  |  |  |  |  |  |  |  |  |  |  |  |  |  |  |  | x | y1 | y2 | x1 | y | x2
Slab thickness (mm) |  | 200 | Column scale |  | 1:30 | 1:20 | 1:25 | 1:30 | 1:40 |  |  |  |  |  |  |  |  |  |  |  |  |  |  | Cạnh b | 1000 | Số thứ tự | Tọa độ thép b1 |  |  | Tọa độ thép h1 |  |  | Tọa độ thép b2 |  |  | Tọa độ thép h2
Wall mark |  | C1 | Cross section scale |  | 1:20 | FALSE | FALSE | TRUE | 2 |  |  |  |  |  |  |  |  |  |  |  |  |  |  | Lớp 1 | Lớp 2 | 1 | -450 | -350 | 350 | -450 | -350 | 450 | 0 | -233.3333333 | 233.3333333 | -300 | 0 | 300
No of wall |  | 1 | Bar cover (mm) |  | 30 | Main stirrup | d10a100/200 |  |  |  |  |  |  |  |  |  |  |  |  |  |  |  |  | 7 | 7 | 2 | -300 | -350 | 350 | -450 | -233.3333333 | 450 | -300 | -233.3333333 | 233.3333333 | -300 | -116.6666667 | 300
Foundation elevation (m) |  | -5.500 | End bar (d) |  | 15 | add stirrup | d8a400 |  |  |  |  |  |  |  |  |  |  |  |  |  |  |  |  | 1 | 2 | 3 | -150 | -350 | 350 | -450 | -116.6666667 | 450 | -150 | -233.3333333 | 233.3333333 | -300 | -116.6666667 | 300
 |  |  |  |  |  |  |  |  |  |  |  |  |  |  |  |  |  |  |  |  |  |  |  | Cạnh h | 800 | 4 | 0 | -350 | 350 | -450 | 2.842170943e-14 | 450 | -150 | -233.3333333 | 233.3333333 | -300 | -116.6666667 | 300
Level | Heigh | Wall geometry |  | No of main bar |  |  |  | Bar Diameter | Lap position | Beam depth | Main Stirrup | Đai gia cường tự bố trí |  |  |  |  |  |  |  |  |  |  |  | Lớp 1 | Lớp 2 | 5 | 150 | -350 | 350 | -450 | 116.6666667 | 450 | -150 | -233.3333333 | 233.3333333 | -300 | -116.6666667 | 300
 | m | Length | Width | Length |  | Width |  |  |  |  |  | Square stirrup veritcal |  |  | Square stirrup horizontal |  |  | Stirrup C Ver |  | Stirrup C Hor |  |  |  | 7 | 7 | 6 | 300 | -350 | 350 | -450 | 233.3333333 | 450 | -150 | -233.3333333 | 233.3333333 | -300 | -116.6666667 | 300
PILECAPS | 1.500 | mm | mm | Biên | Giữa | Lớp 1 | Lớp 2 | mm | mm | mm | Diameter/spacing | scale | Diameter/spacing | quantity | scale | Diameter/spacing | quantity | Diameter/spacing | quantity | Diameter/spacing | quantity |  |  | 1 | 1 | 7 | 450 | -350 | 350 | -450 | 350 | 450 | -150 | -233.3333333 | 233.3333333 | -300 | -116.6666667 | 300
BASEMENT | 3.000 | 1000 | 800 | 7 | 7 | 7 | 7 | 25 | 150 | 600 | d10a100/200 | 0.5 | d10a400 |  | 0.5 | d10a400 |  | d10a400 | 2 | d10a400 | 2 |  |  | S1 | 150 | 8 | 450 | -350 | 350 | -450 | 350 | 450 | -150 | -233.3333333 | 233.3333333 | -300 | -116.6666667 | 300
FLOOR 1 | 3.500 | 1000 | 800 | 7 | 7 | 7 | 7 | 25 | 150 | 600 | d10a100/200 | 0.5 | d10a400 |  | 0.5 | d10a400 |  | d10a400 | 2 | d10a400 | 2 |  |  | S2 | 116.6666667 | 9 | 450 | -350 | 350 | -450 | 350 | 450 | -150 | -233.3333333 | 233.3333333 | -300 | -116.6666667 | 300
FLOOR 2 | 3.900 | 1000 | 800 | 7 | 7 | 7 | 7 | 25/20 | 150 | 400 | d10a100/200 | 0.5 | d10a400 |  | 0.5 | d10a400 |  | d10a400 | 2 | d10a400 | 2 |  |  | Fix |  | 10 | 450 | -350 | 350 | -450 | 350 | 450 | -150 | -233.3333333 | 233.3333333 | -300 | -116.6666667 | 300
FLOOR 3 | 4.600 | 1000 | 800 | 7 | 7 | 7 | 7 | 20 | 150 | 400 | d10a100/200 | 0.5 | d10a400 |  | 0.5 | d10a400 |  | d10a400 | 2 | d10a400 | 2 |  |  | 500 | 500 | 11 | 450 | -350 | 350 | -450 | 350 | 450 | -150 | -233.3333333 | 233.3333333 | -300 | -116.6666667 | 300
FLOOR 4 | 3.300 | 1000 | 800 | 7 | 7 | 7 | 7 | 20 | 150 | 600 | d10a100/200 | 0.5 | d10a400 |  | 0.5 | d10a400 |  | d10a400 | 2 | d10a400 | 2 |  |  | -500 | -500 | 12 | 450 | -350 | 350 | -450 | 350 | 450 | -150 | -233.3333333 | 233.3333333 | -300 | -116.6666667 | 300
FLOOR 5 | 3.300 | 1000 | 800 | 7 | 7 | 7 | 7 | 20 | 150 | 400 | d10a100/200 | 0.5 | d10a400 |  | 0.5 | d10a400 |  | d10a400 | 2 | d10a400 | 2 |  |  | Bao ngoai |  | 13 | 450 | -350 | 350 | -450 | 350 | 450 | -150 | -233.3333333 | 233.3333333 | -300 | -116.6666667 | 300
 |  |  |  |  |  |  |  |  |  |  |  |  |  |  |  |  |  |  |  |  |  |  |  | -500 | -400 | 14 | 450 | -350 | 350 | -450 | 350 | 450 | -150 | -233.3333333 | 233.3333333 | -300 | -116.6666667 | 300
 |  |  |  |  |  |  |  |  |  |  |  |  |  |  |  |  |  |  |  |  |  |  |  | 500 | -400 | 15 | 450 | -350 | 350 | -450 | 350 | 450 | -150 | -233.3333333 | 233.3333333 | -300 | -116.6666667 | 300
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
 |  |  |  |  |  |  |  |  |  |  |  |  |  |  |  |  |  |  |  |  |  |  |  |  |  | 50 | 450 | -350 | 350 | -450 | 350 | 450 | -150 | -233.3333333 | 233.3333333 | -300 | -116.6666667 | 300

Sheet: Dam
Longitudinal section scale | 1:50 |  |  | Length of between additional bar on 2 layer |  | 500 |  | FALSE |  |  |  | 1:70 | 1:50 | 1:40 | 1:30 | 1:25
Cross section scale | 1:40 |  |  | Top bar length to support (d) |  | 40 |  |  |  |  | Info Author: |  | 1:40 | 1:30 | 1:25 | 1:20
Beam Mark | B01 |  |  | Bottom bar length to support (d) |  | 30 | 0.2 | L from edge of support |  |  | Tam, Nguyen Kha |  | L from edge of support
Quantity | 1 |  |  | Side bar diameter |  | 12 |  |  |  |  | Civil Engineer |  | L from central of support, from edge of support
Beam Depth (mm) | 1000 |  |  | No of side bar |  | 3x4 | 0.25 | L from edge of flat beam |  |  | Phone: 0985373800 |  | L from edge of flat beam
Beam Width (mm) | 500 |  |  | Stirrup bar diameter (mm) |  | 10 | 25 |  |  |  | Email: khatamxd@gmail.com |  | L from central of support, from edge of support
Slab thickness (mm) | 150 |  |  | Main stirrup spacing | Support | a150 | FALSE |  | a500 |  | Work: Designing structure buildings and
Axis |  |  |  |  | Span | a200 |  | 2 |  |  | design spreadsheets link Excel with Autocad
Eccentric axis | -100 |  |  |  | Cantilever | 150 | Cover mainbars/ stirrup |  | 50/25 |  | http://katapro.net
Elevation | +3.300 | Support | Span | Support | Span | Support | Span | Support | Span | Support | Span | Support | Span | Support | Span | Support | Span | Support | Span | Support | Span | Support | Span | Support | Span | Support | Span | Support | Span | Support | Span | Support | Span | Support
Top main Bar | 4f16 | 400 | 6200 | 400 | 6000 | 400 | 6000 | 400 | 6000 | 400
Bottom main Bar | 4f16
Additional top bars | Layer 1 | 2f20 |  | -
 | Layer 2 | 2f20 |  | 2f20 |  | 2f20;2f25 |  | 2f20 |  | 2f20
 | Layer 3
 | Layer 3
Additional bottom bars | Layer 2 |  | 2f20 |  | 2f20 |  | 2f20
 | Layer 1
Beam raise up; main bars |  |  |  | 0 | 100;5f25 | 500;100 | 0 | 500;100
Beam width at gridline |  | 400 |  | 400 | 2f12 | 400 | 600 | 500 |  | 400
Eccentricity between intersected beam and column centroid |  |  |  |  | -100;5f20 |  | 0 | 500
Column axis name |  | 1 |  | 2 | a100/200/50 | 3 |  | 4
Eccentricity of axis to column centroid |  | 0 |  | 0 | a100/200/50 | 0 |  | 0
Stirrup □ |  | Stirrup C | 2 | Stirrup U |  | Stirrup □
Stirrup U |  | Stirrup C | 3
Stirrup C
1
30 | 1 | 2 | 3 | 4 | 5 | 6 | 7 | 8 | 9 |  | 1 | 2 | 3 | 4 | 5 | 6 | 7 | 8 | 9 | 10 | 11 | 12 | 13 | 14 | 15 | 16 | 17 | 18 | 19 | 20
Bao | -250 | 250 | 250 | 550 | 550 | -550 | -550 | -250 | -250 | Thép trên | -190 | -63.33333333 | 63.33333333 | 190 | -190 | -190 | -190 | -190 | -190 | -190 | -190 | -190 | -190 | -190 | -190 | -190 | -190 | -190 | -190 | -190
60 | -350 | -350 | 200 | 200 | 350 | 350 | 200 | 200 | -350 |  | 290 | 290 | 290 | 290 | 290 | 290 | 290 | 290 | 290 | 290 | 290 | 290 | 290 | 290 | 290 | 290 | 290 | 290 | 290 | 290
126.6666667 | -220 | 220 | 220 | -220 | -220 | 550 | -550 | 550 | 4 | Thép dưới | -190 | -63.33333333 | 63.33333333 | 190 | -190 | -190 | -190 | -190 | -190 | -190 | -190 | -190 | -190 | -190 | -190 | -190 | -190 | -190 | -190 | -190
126.6666667 | -320 | -320 | 320 | 320 | -320 | 500 | -550 | 550 | 4 |  | -290 | -290 | -290 | -290 | -290 | -290 | -290 | -290 | -290 | -290 | -290 | -290 | -290 | -290 | -290 | -290 | -290 | -290 | -290 | -290
h dầm (mm) | 700 |  |  | Đai C | 2 | 2 | #VALUE! | -83.33333333 | -83.33333333 | -83.33333333 | -83.33333333 | -83.33333333 | 310 | -310 | -310 | 310 | 310
b dầm (mm) | 500 |  |  | Đai C | 3 | 3 | #VALUE! | 43.33333333 | 43.33333333 | 43.33333333 | 43.33333333 | 43.33333333 | 310 | -310 | -310 | 310 | 310
Thép chịu lực trên | 4f20 |  |  |  |  | #VALUE! | #VALUE! | #VALUE! | #VALUE! | #VALUE! | #VALUE! | #VALUE! | 310 | 310 | 310 | 310 | 310
Thép chịu lực dưới | 4f20 |  |  |  |  | #VALUE! | #VALUE! | #VALUE! | #VALUE! | #VALUE! | #VALUE! | #VALUE! | 310 | 310 | 310 | 310 | 310
 |  |  |  |  |  | #VALUE! | #VALUE! | #VALUE! | #VALUE! | #VALUE! | #VALUE! | #VALUE! | 310 | 310 | 310 | 310 | 310
 |  |  |  |  |  | #VALUE! | #VALUE! | #VALUE! | #VALUE! | #VALUE! | #VALUE! | #VALUE! | 310 | 310 | 310 | 310 | 310
 |  |  |  |  |  | #VALUE! | #VALUE! | #VALUE! | #VALUE! | #VALUE! | #VALUE! | #VALUE! | 310 | 310 | 310 | 310 | 310
 |  |  |  |  |  | #VALUE! | #VALUE! | #VALUE! | #VALUE! | #VALUE! | #VALUE! | #VALUE! | 310 | 310 | 310 | 310 | 310
 |  |  |  |  |  | #VALUE! | #VALUE! | #VALUE! | #VALUE! | #VALUE! | #VALUE! | #VALUE! | 310 | 310 | 310 | 310 | 310
 |  |  |  |  |  | #VALUE! | #VALUE! | #VALUE! | #VALUE! | #VALUE! | #VALUE! | #VALUE! | 310 | 310 | 310 | 310 | 310
 |  |  |  |  |  | #VALUE! | #VALUE! | #VALUE! | #VALUE! | #VALUE! | #VALUE! | #VALUE! | 310 | 310 | 310 | 310 | 310
 |  |  |  |  |  | #VALUE! | #VALUE! | #VALUE! | #VALUE! | #VALUE! | #VALUE! | #VALUE! | 310 | 310 | 310 | 310 | 310
 |  |  |  |  |  | #VALUE! | #VALUE! | #VALUE! | #VALUE! | #VALUE! | #VALUE! | #VALUE! | 310 | 310 | 310 | 310 | 310
 |  |  |  |  |  | #VALUE! | #VALUE! | #VALUE! | #VALUE! | #VALUE! | #VALUE! | #VALUE! | 310 | 310 | 310 | 310 | 310
 |  |  |  |  |  | #VALUE! | #VALUE! | #VALUE! | #VALUE! | #VALUE! | #VALUE! | #VALUE! | 310 | 310 | 310 | 310 | 310
 |  |  |  |  |  | #VALUE! | #VALUE! | #VALUE! | #VALUE! | #VALUE! | #VALUE! | #VALUE! | 310 | 310 | 310 | 310 | 310
 |  |  |  |  |  | #VALUE! | #VALUE! | #VALUE! | #VALUE! | #VALUE! | #VALUE! | #VALUE! | 310 | 310 | 310 | 310 | 310
 |  |  |  |  |  | #VALUE! | #VALUE! | #VALUE! | #VALUE! | #VALUE! | #VALUE! | #VALUE! | 310 | 310 | 310 | 310 | 310
 |  |  |  |  |  | #VALUE! | #VALUE! | #VALUE! | #VALUE! | #VALUE! | #VALUE! | #VALUE! | 310 | 310 | 310 | 310 | 310
 |  |  |  |  |  | #VALUE! | #VALUE! | #VALUE! | #VALUE! | #VALUE! | #VALUE! | #VALUE! | 310 | 310 | 310 | 310 | 310

Sheet: Thong_ke
BAR BENDING SCHEDULE |  |  |  |  |  |  |  |  |  |  |  |  |  |  |  |  |  |  | BAR SUMARY
ITEMS | BAR MARK | BAR SHAPE (mm) |  |  |  |  |  |  |  | Ø (mm) | Chiều dài 1 thanh ko kể nối thép | LENGTH | NO OF ITEMS | NO OF BAR |  | TOTAL | TOTAL | TOTAL/ITEMS | DIAMETER | Ø 0 | Ø 0 | Ø 0 | Ø 0 | Ø 0 | Ø 0 | Ø 0 | Ø 0 | Ø 0 | Ø 0 | Ø 0 | Ø 0 | Ø 0 | Ø 0 | Ø 0 | Ø 0
 |  |  |  |  |  |  |  |  |  |  |  | 1 BAR |  | 1 ITEM | TOTAL | LENGTH | WEIGHT | WEIGHT | LENGTH | 0.00 | 0.00 | 0.00 | 0.00 | 0.00 | 0.00 | 0.00 | 0.00 | 0.00 | 0.00 | 0.00 | 0.00 | 0.00 | 0.00 | 0.00 | 0.00
 |  | TYPE | L1 | L2 | L3 | L4 | L5 | L6 | Ghi chú |  |  | (mm) |  |  |  | (m) | (kg) | (kg) | WEIGHT | 0.00 | 0.00 | 0.00 | 0.00 | 0.00 | 0.00 | 0.00 | 0.00 | 0.00 | 0.00 | 0.00 | 0.00 | 0.00 | 0.00 | 0.00 | 0.00
 |  |  |  |  |  |  |  |  |  |  |  |  |  |  |  |  |  |  | Ø<=10 | 0.00
 |  |  |  |  |  |  |  |  |  |  |  |  |  |  |  |  |  |  | 10<Ø<=18 | 0.00
 |  |  |  |  |  |  |  |  |  |  |  |  |  |  |  |  |  |  | 18<Ø | 0.00

Sheet: To_hop_thep
Excess of bar | Cutting bar describe (Coordinated) |  |  |  | Quy trình tổ hợp thép | Cutting bar describe (waiting for coordinating) |  |  |  |  | Cutting bar sumary |  |  |  |  | Production
 | Ø | Length | Quantity | Bar guidline table | Xét với 1 loại đường kính thép | items | bar mark | Ø | length | quantity | Ø | Length | Quantity | Cutting bar table guidline | Excess of bar | Ø | Length | Quatity
 |  |  |  |  | * Kata lấy dữ liệu từ sheet Kho_thep và table bên phải như sau: | Móng M1 | 7 | 10 | 3165 | 13
 |  |  |  |  | - Ở sheet Kho_thep ta có được các thanh có chiều dài L0=11700, L1, L2... gọi tắc là Li
 |  |  |  |  | - Ở table bên phải ta có được các thanh có chiều dài X1, X2…Các thanh này sinh ra các thanh X11 (=X1+X1), X12 (=X1+X2)…Cuối cùng ta có được tập hợp các thanh gọi tắc là Xi
 |  |  |  |  | * Lệnh vẽ dầm shop và lệnh cắt thép sẽ tính toán vị trí cắt để cho ra nhiều nhất các thanh Yi=Li hoặc Yi=Li-Xi. Còn lại là các thanh Zi
 |  |  |  |  | * Đánh lệnh tổ hợp thép chọn các thanh thép Yi và Zi trên bản vẽ:
 |  |  |  |  | - Các thanh Yi sẽ được đưa vào table bên phải. Cột chiều dài =Li, cột mô tả cách cắt thép =(Yi+Xi). Loại bỏ các thanh Li ra khỏi sheet kho_thep, các thanh Xi ra khỏi table bên phải
 |  |  |  |  | - Các thanh Zi sẽ được đưa vào table bên trái gia nhập vào tập các thanh Xi cho lần tổ hợp thép sau
 |  |  |  |  | * Cuối cùng ta sẽ có 2 tables với các thanh thép nằm ở table bên phải thì lượng hao hụt thép xem như bằng 0. Các thanh thép nằm ở table bên phải chúng ta có thể tự phối hợp thép vì số lượng của nó khá nhỏ.
 |  |  |  |  | Nếu làm theo cách truyền thống, thép không được tính toán vị trí cắt ở bước triển khai bản vẽ shop ta chỉ được các thanh thép ở table bên phải nhưng với số lượng rất lớn dẫn đến khó phối hợp thép. Phát sinh hao hụt lớn

Sheet: Kho_thep
Kho thép đã cắt lẻ cần tận dụng
Ø10 |  | Ø12 |  | Ø14 |  | Ø16 |  | Ø18 |  | Ø20 |  | Ø22 |  | Ø25 |  | Ø28 |  | Ø32 |  | Ø36 |  | Ø40
Length | Quantity | Length | Quantity | Length | Quantity | Length | Quantity | Length | Quantity | Length | Quantity | Length | Quantity | Length | Quantity | Length | Quantity | Length | Quantity | Length | Quantity | Length | Quantity

Sheet: Kata_QS
Drawing nae | Hạng mục | Quantity | Area (m2) -A- | Length (m) -L- | Heigh (m) -H- | Area total (m2) | Total length (m) | Total volume(m3) | Perimeter (m2)
(0) | (1) | (2) | (3) | (4) | (5) | (6) = (3)x(2) | (7)=(4)x(2) | (8)=(3)x(5) | (9)=(4)x(5)

Sheet: Contact Information
Website | http://katapro.net
Contact: | katapro.kinhdoanh@gmail.com
phone: | +8490800054
