Lightingsang/AddinRebar/HPDcePro/assets/Excel/DceSteel/03 General.xlsm

TABLE: Grid Definitions - Grid Lines |  |  |  | ETABS |  |  |  |  |  |  | TABLE: |  | SAP 2000 |  |  |  |  |  |  |  |  | Dùng tổ hợp phím Ctrl + E
Name | Grid Line Type | ID | Ordinate | Angle | X1 | Y1 | X2 | Y2 | Bubble Location | Visible | CoordSys | AxisDir | GridID | XRYZCoord | TAngle | LineType | LineColor | Visible | BubbleLoc | AllVisible | BubbleSize | MODEL DEFINITION -> System Data -> Towers, Stories and Grids -> Table Grid Definitions - Grid Lines
0 |  |  | m | deg | m | m | m | m |  |  |  |  |  | m | Degrees |  |  |  |  |  | m
 |  |  |  |  |  |  |  |  |  |  | GLOBAL | X | X1 | 0 |  | Primary | Gray8Dark | Yes | Start | Yes | 1.25
 |  |  |  |  |  |  |  |  |  |  | GLOBAL | X | X2 | 6 |  | Primary | Gray8Dark | Yes | Start
 |  |  |  |  |  |  |  |  |  |  | GLOBAL | X | X3 | 14 |  | Primary | Gray8Dark | Yes | Start
 |  |  |  |  |  |  |  |  |  |  | GLOBAL | X | X4 | 22 |  | Primary | Gray8Dark | Yes | Start
 |  |  |  |  |  |  |  |  |  |  | GLOBAL | X | X5 | 30 |  | Primary | Gray8Dark | Yes | Start
 |  |  |  |  |  |  |  |  |  |  | GLOBAL | X | X6 | 38 |  | Primary | Gray8Dark | Yes | Start
 |  |  |  |  |  |  |  |  |  |  | GLOBAL | X | X7 | 46 |  | Primary | Gray8Dark | Yes | Start
 |  |  |  |  |  |  |  |  |  |  | GLOBAL | X | X8 | 54 |  | Primary | Gray8Dark | Yes | Start
 |  |  |  |  |  |  |  |  |  |  | GLOBAL | X | X9 | 62 |  | Primary | Gray8Dark | Yes | Start
 |  |  |  |  |  |  |  |  |  |  | GLOBAL | X | X10 | 68 |  | Primary | Gray8Dark | Yes | Start
 |  |  |  |  |  |  |  |  |  |  | GLOBAL | Y | Y1 | 0 |  | Primary | Gray8Dark | Yes | Start
 |  |  |  |  |  |  |  |  |  |  | GLOBAL | Y | Y2 | 7.5 |  | Primary | Gray8Dark | Yes | Start
 |  |  |  |  |  |  |  |  |  |  | GLOBAL | Y | Y3 | 15 |  | Primary | Gray8Dark | Yes | Start
 |  |  |  |  |  |  |  |  |  |  | GLOBAL | Y | Y4 | 22.5 |  | Primary | Gray8Dark | Yes | Start
 |  |  |  |  |  |  |  |  |  |  | GLOBAL | Y | Y5 | 30 |  | Primary | Gray8Dark | Yes | Start
 |  |  |  |  |  |  |  |  |  |  | GLOBAL | Z | Base | -1.5 |  | Primary | Gray8Dark | Yes | Start
 |  |  |  |  |  |  |  |  |  |  | GLOBAL | Z | TRET | 0 |  | Primary | Gray8Dark | Yes | Start
 |  |  |  |  |  |  |  |  |  |  | GLOBAL | Z | COT | 8 |  | Primary | Gray8Dark | Yes | Start
 |  |  |  |  |  |  |  |  |  |  | GLOBAL | Z | MAI | 11 |  | Primary | Gray8Dark | Yes | Start
