Lightingsang/AddinRebar/HPDcePro/assets/Excel/DceSteel/05 Uniform Load Set.xlsm

Sheet: Sheet1
TABLE: Load Pattern Definitions / Load Patterns / Shell Uniform Load Sets |  |  | TABLE: Area Assignments Area Load Assignments - Uniform Load Sets
 |  |  |  |  |  |  |  | TABLE: Load Assignments - Surface Loads
Name | Load Pattern | Load Value | Story | Label | UniqueName | Load Set |  | Area | LoadPat | Dir | UnifLoad | A | B | C
 |  | kN/m² |  |  |  |  |  | Text | Text | Text | kN/m2 | kN/m3 | kN/m3 | kN/m2
B1-BOH | SDL | 2.5 | TF | F3 | 52 | TRL-Roof | 383 | F86 | SDL | Gravity | 3.5 | 0 | 0 | 0
B1-BOH | HTB | 4 | TF | F5 | 1366 | TRL-Roof
B1-Loading Bay | SDL | 1 | RF | F3 | 1367 | Roof
B1-Loading Bay | HTE | 10 | RF | F5 | 1368 | Roof
B1-Lobby | SDL | 2.5 | L20 | F3 | 1369 | L3.Aparterment
B1-Lobby | HTC | 4 | L20 | F5 | 1370 | L3.Aparterment
B1-MEP1 | SDL | 3.8 | L19 | F3 | B3616D | L3.Aparterment
B1-MEP1 | HTB | 7.5 | L19 | F5 | B36177 | L3.Aparterment
B1-Parking | SDL | 1 | L18 | F3 | 1371 | L3.Aparterment
B1-Parking | HTF | 5 | L18 | F5 | 1372 | L3.Aparterment
B1-Parking | WALL | 5 | L17 | F3 | 1373 | L3.Aparterment
B1-Storage | SDL | 2.5 | L17 | F5 | 1374 | L3.Aparterment
B1-Storage | HTE | 5 | L16 | F3 | 1375 | L3.Aparterment
B1-Tank | SDL | 2.5 | L16 | F5 | 1376 | L3.Aparterment
B1-Tank | HTE | 40 | L15 | F7 | B35920 | L3.Aparterment
B1M-MEP1 | SDL | 3.8 | L15 | F8 | B35921 | L3.Aparterment
B1M-MEP1 | HTB | 7.5 | L14 | F9 | B3596F | L3.Aparterment
B2-Parking | SDL | 1 | L13M | F10 | 1377 | L13.Pool
B2-Parking | HTF | 5 | L13 | F10 | B6D436 | L13.Pool Tech
B2-Parking | WALL | 5 | L12 | F11 | B357EC | L3.Aparterment
B3-Parking | SDL | 1 | L11 | F11 | 1381 | L3.Aparterment
B3-Parking | HTF | 5 | L10 | F11 | 1384 | L3.Aparterment
B3-Parking | WALL | 5 | L9 | F11 | 1385 | L3.Aparterment
L1-BOH | SDL | 2.5 | L8 | F11 | 1386 | L3.Aparterment
L1-BOH | HTB | 4 | L7 | F11 | 1408 | L3.Aparterment
L1-Fire Truck | SDL | 15.2 | L6 | F11 | 1378 | L3.Aparterment
L1-Fire Truck | XCH | 21 | L5 | F12 | B3588A | L3.Aparterment
L1-Gallery | SDL | 2.5 | L5 | F13 | B3588B | L3.Aparterment
L1-Gallery | HTC | 4 | L4 | F12 | 1379 | L3.Aparterment
L1-Landscape.1400mm | SDL | 25.7 | L4 | F13 | 1380 | L3.Aparterment
L1-Landscape.1400mm | HTH | 1.5 | L3 | A2 | B357B4 | L3.Aparterment
L1-Lobby | SDL | 2.5 | L3 | A6 | 44 | L3.Aparterment
L1-Lobby | HTC | 4 | L3 | A7 | 43 | L3-Landscape.1400mm
L1-Main Lobby | SDL | 2.5 | L3 | A4 | 39 | L3-Landscape.1400mm
L1-Main Lobby | HTC | 4 | L3 | A8 | 40 | L3-Landscape.1400mm
L1-MEP1 | SDL | 3.8 | L3 | A1 | 42 | L3-Landscape.1400mm
L1-MEP1 | HTB | 7.5 | L3 | A3 | 51 | L3-Landscape.1400mm
L1-Retail | SDL | 2.5 | L2 | F4 | 2 | L2-Retail
L1-Retail | HTC | 4 | L1 | F30 | 23 | L1-Fire Truck
L1-Retail | WALL | 4 | L1 | F31 | 24 | L1-Fire Truck
L1-Staircase | SDL | 3.35 | L1 | F32 | 25 | L1-Fire Truck
L1-Staircase | HTC | 2.5 | L1 | F73 | 22 | L1-Fire Truck
L1-Storage | SDL | 2.5 | L1 | F75 | 28 | L1-Fire Truck
L1-Storage | HTE | 5 | L1 | F35 | 45 | L1-Retail
L1-Toilet | SDL | 2.5 | L1 | F45 | 56 | L1-Fire Truck
L1-Toilet | HTB | 2.5 | L1 | F46 | 57 | L1-Fire Truck
L13.Pool | SDL | 19.5 | L1 | F47 | 58 | L1-Fire Truck
L13.Pool | ALN | 12 | L1 | F48 | 59 | L1-Retail
L13.Pool Tech | SDL | 6.75 | L1 | F49 | 53 | L1-Retail
L13.Pool Tech | HTE | 5 | L1 | F1 | 54 | L1-Retail
L1M-Roof | SDL | 2.5 | L1 | F23 | 1433 | L1-Landscape.1400mm
L1M-Roof | HTH | 0.7 | L1 | F27 | 1434 | L1-Fire Truck
L2-Auditorium | SDL | 5.5 | L1 | F29 | 1435 | L1-Fire Truck
L2-Auditorium | HTC | 4 | L1 | F34 | 1437 | L1-Fire Truck
L2-Cooridoor | SDL | 2.5 | L1 | F42 | 1440 | L1-Retail
L2-Cooridoor | HTC | 5 | L1 | F44 | 1441 | L1-Retail
L2-Loading Bay | SDL | 2.5 | L1 | F50 | 1442 | L1-Retail
L2-Loading Bay | HTE | 10 | L1 | F51 | 1443 | L1-Retail
L2-Lounge | SDL | 2.5 | L1 | F59 | 1451 | L1-Landscape.1400mm
L2-Lounge | HTC | 4 | L1 | F2 | 3 | L1-Fire Truck
L2-MEP1 | SDL | 3.8 | L1 | F25 | 48 | L1-Fire Truck
L2-MEP1 | HTB | 7.5 | L1 | F26 | 49 | L1-Fire Truck
L2-Multifunction | SDL | 2.5 | L1 | F55 | 1410 | L1-Retail
L2-Multifunction | HTC | 4 | L1 | F60 | 1431 | L1-Retail
L2-Office | SDL | 2.5 | L1 | F64 | 1455 | L1-Retail
L2-Office | HTB | 2.5 | L1 | F66 | 1457 | L1-Landscape.1400mm
L2-Orchestra Pit | SDL | 3.2 | L1 | F67 | 1463 | L1-Retail
L2-Orchestra Pit | HTC | 20 | L1 | F68 | 1464 | L1-Retail
L2-Rehearsal | SDL | 3.2 | L1 | F69 | 1465 | L1-Retail
L2-Rehearsal | HTC | 5 | L1 | F71 | 1471 | L1-Retail
L2-Retail | SDL | 2.5 | L1 | F72 | 1472 | L1-Retail
L2-Retail | HTC | 4 | L1 | F74 | 1473 | L1-Retail
L2-Retail | WALL | 4 | L1 | F76 | 1479 | L1-Fire Truck
L2-Stage | SDL | 5.5 | L1 | F77 | 1480 | L1-Fire Truck
L2-Stage | HTC | 10 | L1 | F83 | 1447 | L1-Fire Truck
L2-Staircase | SDL | 3.35 | L1 | F24 | 1570 | L1-Fire Truck
L2-Staircase | HTC | 2.5 | L1 | F33 | 1572 | L1-Fire Truck
L2-Storage | SDL | 2.5 | L1 | F38 | 1573 | L1-Fire Truck
L2-Storage | HTE | 5 | L1 | F39 | 1409 | L1-Retail
L2-Theater Lobby | SDL | 5.5 | L1 | F40 | 1564 | L1-Retail
L2-Theater Lobby | HTC | 4 | L1 | F41 | 1566 | L1-Retail
L2-Toilet | SDL | 2.5 | L1 | F53 | 1567 | L1-Retail
L2-Toilet | HTB | 2.5 | L1 | F54 | 1568 | L1-Retail
L2-Workshop | SDL | 2.5 | L1 | F56 | 1569 | L1-Retail
L2-Workshop | HTE | 5 | L1 | F15 | 13 | L1-Fire Truck
L2M-MEP1 | SDL | 3.8 | L1 | F17 | 47 | L1-Retail
L2M-MEP1 | HTB | 7.5 | L1 | F18 | 1382 | L1-Retail
L2M-Staircase | SDL | 3.35 | L1 | F19 | 1415 | L1-Retail
L2M-Staircase | HTC | 5 | L1 | F20 | 1416 | L1-Fire Truck
L3-Balcony Seating | SDL | 5.5 | L1 | F21 | 1444 | L1-Fire Truck
L3-Balcony Seating | HTC | 4 | L1 | F28 | 1446 | L1-Fire Truck
L3-Canteen | SDL | 2.5 | L1 | F36 | 1449 | L1-Fire Truck
L3-Canteen | HTC | 3 | L1 | F37 | 1495 | L1-Retail
L3-Cooridoor | SDL | 2.5 | L1 | F57 | 1522 | L1-Retail
L3-Cooridoor | HTC | 5 | L1 | F52 | 1394 | L1-Landscape.1400mm
L3-Landscape.1400mm | SDL | 25.7 | L1 | F63 | 1493 | L1-Landscape.1400mm
L3-Landscape.1400mm | HTH | 1.5 | L1 | F78 | 1494 | L1-Landscape.1400mm
L3-MEP1 | SDL | 3.8 | L1 | F80 | 1502 | L1-Landscape.1400mm
L3-MEP1 | HTB | 7.5 | L1 | F14 | 12 | L1-Landscape.1400mm
L3-Multifunction | SDL | 2.5 | L1 | F16 | 29 | L1-Landscape.1400mm
L3-Multifunction | HTC | 4 | L1 | F58 | 46 | L1-Landscape.1400mm
L3-Rehearsal | SDL | 3.2 | L1 | F82 | 1361 | L1-Landscape.1400mm
L3-Rehearsal | HTC | 5 | L1 | F84 | 1364 | L1-Landscape.1400mm
L3-Roof | SDL | 2.5 | L1 | F61 | 1531 | L1-Landscape.1400mm
L3-Roof | HTH | 0.7 | L1 | F86 | 1540 | L1-Landscape.1400mm
L3-Staircase | SDL | 3.35 | L1 | F87 | 1541 | L1-Landscape.1400mm
L3-Staircase | HTC | 5 | L1 | F88 | 1392 | L1-Landscape.1400mm
L3-Storage | SDL | 2.5 | L1 | F89 | 1448 | L1-Landscape.1400mm
L3-Storage | HTE | 5 | B1 | F30 | 1 | B1-Parking
L3-Theater Lobby | SDL | 5.5 | B1 | F31 | 4 | B1-Parking
L3-Theater Lobby | HTC | 4 | B1 | F32 | 6 | B1-Parking
L3-Toilet | SDL | 2.5 | B1 | F73 | 7 | B1-Parking
L3-Toilet | HTB | 2.5 | B1 | F75 | 8 | B1-Parking
L3.Aparterment | SDL | 2.5 | B1 | F35 | 11 | B1-Parking
L3.Aparterment | HTB | 3 | B1 | F45 | 20 | B1-Parking
L3.Aparterment | WALL | 5 | B1 | F46 | 21 | B1-Parking
L3M-MEP1 | SDL | 3.8 | B1 | F47 | 26 | B1-Parking
L3M-MEP1 | HTB | 7.5 | B1 | F48 | 27 | B1-Parking
L3M-Staircase | SDL | 3.35 | B1 | F49 | 18 | B1-Parking
L3M-Staircase | HTC | 5 | B1 | F1 | 19 | B1-Parking
L4-Cooridoor | SDL | 2.5 | B1 | F23 | 31 | B1-Parking
L4-Cooridoor | HTC | 5 | B1 | F27 | 32 | B1-Parking
L4-Gallery | SDL | 2.5 | B1 | F29 | 33 | B1-Parking
L4-Gallery | HTC | 4 | B1 | F34 | 34 | B1-Parking
L4-Kitchen | SDL | 7 | B1 | F42 | 35 | B1-Parking
L4-Kitchen | HTC | 3 | B1 | F44 | 36 | B1-Parking
L4-Landscape.1200mm | SDL | 22.1 | B1 | F50 | 37 | B1-Parking
L4-Landscape.1200mm | HTH | 1.5 | B1 | F51 | 38 | B1-Parking
L4-Lobby | SDL | 2.5 | B1 | F59 | 1609 | B1-Parking
L4-Lobby | HTC | 4 | B1 | F2 | 1387 | B1-Parking
L4-MEP1 | SDL | 3.8 | B1 | F25 | 1388 | B1-Parking
L4-MEP1 | HTB | 7.5 | B1 | F26 | 1389 | B1-Parking
L4-Multifunction | SDL | 2.5 | B1 | F55 | 1390 | B1-Parking
L4-Multifunction | HTC | 4 | B1 | F60 | 1391 | B1-Parking
L4-Restaurant | SDL | 2.5 | B1 | F64 | 1395 | B1-Parking
L4-Restaurant | HTB | 4 | B1 | F66 | 1624 | B1-Parking
L4-Roof | SDL | 2.5 | B1 | F67 | 1398 | B1-Parking
L4-Roof | HTH | 0.7 | B1 | F68 | 1399 | B1-Parking
L4-Staircase | SDL | 3.35 | B1 | F69 | 1400 | B1-Parking
L4-Staircase | HTC | 5 | B1 | F71 | 1401 | B1-Parking
L4-Toilet | SDL | 2.5 | B1 | F72 | 1402 | B1-Parking
L4-Toilet | HTB | 2.5 | B1 | F74 | 1403 | B1-Parking
L4-Warehouse | SDL | 2.5 | B1 | F76 | 1404 | B1-Parking
L4-Warehouse | HTE | 5 | B1 | F77 | 1405 | B1-Parking
L4M-Cooridoor | SDL | 2.5 | B1 | F83 | 1393 | B1-Parking
L4M-Cooridoor | HTC | 5 | B1 | F24 | 1580 | B1-Parking
L4M-MEP1 | SDL | 3.8 | B1 | F33 | 1581 | B1-Parking
L4M-MEP1 | HTB | 7.5 | B1 | F38 | 1582 | B1-Parking
L5-BOH | SDL | 2.5 | B1 | F39 | 1574 | B1-Parking
L5-BOH | HTB | 4 | B1 | F40 | 1575 | B1-Parking
L5-Cafe | SDL | 18.5 | B1 | F41 | 1576 | B1-Parking
L5-Cafe | HTC | 4 | B1 | F53 | 1577 | B1-Parking
L5-Cooridoor | SDL | 2.5 | B1 | F54 | 1578 | B1-Parking
L5-Cooridoor | HTC | 5 | B1 | F56 | 1579 | B1-Parking
L5-Kid Library | SDL | 2.5 | B1 | F15 | 1542 | B1-Parking
L5-Kid Library | HTC | 7.5 | B1 | F17 | 1565 | B1-Parking
L5-Library | SDL | 2.5 | B1 | F18 | 1604 | B1-Parking
L5-Library | HTC | 7.5 | B1 | F19 | 1605 | B1-Parking
L5-Lobby | SDL | 2.5 | B1 | F20 | 1606 | B1-Parking
L5-Lobby | HTC | 4 | B1 | F21 | 1607 | B1-Parking
L5-Lounge | SDL | 2.5 | B1 | F28 | 1571 | B1-Parking
L5-Lounge | HTC | 4 | B1 | F36 | 1601 | B1-Parking
L5-Multifunction | SDL | 2.5 | B1 | F37 | 1602 | B1-Parking
L5-Multifunction | HTC | 4 | B1 | F57 | 1603 | B1-Parking
L5-Office | SDL | 2.5 | B1 | F52 | 1523 | B1-Parking
L5-Office | HTB | 2.5 | B1 | F63 | 1549 | B1-Parking
L5-Roof Outdoor | SDL | 18.5 | B1 | F78 | 1551 | B1-Parking
L5-Roof Outdoor | HTH | 1.5 | B1 | F80 | 1563 | B1-Parking
L5-Staircase | SDL | 3.35 | B1 | F14 | 1626 | B1-Parking
L5-Staircase | HTC | 5 | B1 | F16 | 1637 | B1-Parking
L5-Toilet | SDL | 2.5 | B1 | F58 | 1638 | B1-Parking
L5-Toilet | HTB | 2.5 | B1 | F82 | 1643 | B1-Parking
L5-Warehouse | SDL | 2.5 | B1 | F84 | 1644 | B1-Parking
L5-Warehouse | HTE | 5 | B1 | F61 | 1647 | B1-Parking
L6-Cooridoor | SDL | 2.5 | B1 | F86 | 1648 | B1-Parking
L6-Cooridoor | HTC | 5 | B1 | F87 | 1649 | B1-Parking
L6-Exhibition | SDL | 2.5 | B1 | F88 | 1645 | B1-Parking
L6-Exhibition | HTC | 4 | B1 | F89 | 1646 | B1-Parking
L6-Lobby | SDL | 2.5 | B2 | F30 | 1406 | B1-Parking
L6-Lobby | HTC | 4 | B2 | F31 | 1407 | B1-Parking
L6-Multifunction | SDL | 2.5 | B2 | F32 | 1411 | B1-Parking
L6-Multifunction | HTC | 4 | B2 | F73 | 1412 | B1-Parking
L6-Outdoor | SDL | 3.8 | B2 | F75 | 1413 | B1-Parking
L6-Outdoor | HTC | 4 | B2 | F35 | 1414 | B1-Parking
L6-Outdoor Exhibition | SDL | 14.9 | B2 | F45 | 1419 | B1-Parking
L6-Outdoor Exhibition | HTC | 4 | B2 | F46 | 1420 | B1-Parking
L6-Public Space | SDL | 2.5 | B2 | F47 | 1421 | B1-Parking
L6-Public Space | HTC | 4 | B2 | F48 | 1422 | B1-Parking
L6-Roof | SDL | 2.5 | B2 | F49 | 1417 | B1-Parking
L6-Roof | HTH | 0.7 | B2 | F1 | 1418 | B1-Parking
L6-Staircase | SDL | 3.35 | B2 | F23 | 1425 | B1-Parking
L6-Staircase | HTC | 5 | B2 | F27 | 1426 | B1-Parking
L6-Toilet | SDL | 2.5 | B2 | F29 | 1427 | B1-Parking
L6-Toilet | HTB | 2.5 | B2 | F34 | 1428 | B1-Parking
L6-Warehouse | SDL | 2.5 | B2 | F42 | 1429 | B1-Parking
L6-Warehouse | HTE | 5 | B2 | F44 | 1484 | B1-Parking
L7-Auction | SDL | 2.5 | B2 | F50 | 1485 | B1-Parking
L7-Auction | HTC | 4 | B2 | F51 | 1492 | B1-Parking
L7-Cooridoor | SDL | 2.5 | B2 | F59 | 1650 | B1-Parking
L7-Cooridoor | HTC | 5 | B2 | F2 | 1497 | B1-Parking
L7-Exhibition | SDL | 2.5 | B2 | F25 | 1498 | B1-Parking
L7-Exhibition | HTC | 4 | B2 | F26 | 1499 | B1-Parking
L7-Lobby | SDL | 2.5 | B2 | F55 | 1500 | B1-Parking
L7-Lobby | HTC | 4 | B2 | F60 | 1501 | B1-Parking
L7-Multifunction | SDL | 2.5 | B2 | F64 | 1505 | B1-Parking
L7-Multifunction | HTC | 4 | B2 | F66 | 1651 | B1-Parking
L7-Public Space | SDL | 2.5 | B2 | F67 | 1508 | B1-Parking
L7-Public Space | HTC | 4 | B2 | F68 | 1509 | B1-Parking
L7-Staircase | SDL | 3.35 | B2 | F69 | 1510 | B1-Parking
L7-Staircase | HTC | 5 | B2 | F71 | 1511 | B1-Parking
L7-Toilet | SDL | 2.5 | B2 | F72 | 1512 | B1-Parking
L7-Toilet | HTB | 2.5 | B2 | F74 | 1513 | B1-Parking
L7-Warehouse | SDL | 2.5 | B2 | F76 | 1514 | B1-Parking
L7-Warehouse | HTE | 5 | B2 | F77 | 1515 | B1-Parking
L7-Workshop | SDL | 2.5 | B2 | F83 | 1503 | B1-Parking
L7-Workshop | HTE | 5 | B2 | F24 | 1589 | B1-Parking
Ramp | SDL | 2.5 | B2 | F33 | 1590 | B1-Parking
Ramp | HTF | 5 | B2 | F38 | 1591 | B1-Parking
RL-Roof | SDL | 12 | B2 | F39 | 1583 | B1-Parking
RL-Roof | HTE | 7.5 | B2 | F40 | 1584 | B1-Parking
RL-Staircase | SDL | 3.35 | B2 | F41 | 1585 | B1-Parking
RL-Staircase | HTC | 5 | B2 | F53 | 1586 | B1-Parking
Roof | SDL | 4 | B2 | F54 | 1587 | B1-Parking
Roof | HTH | 0.7 | B2 | F56 | 1588 | B1-Parking
TRL-Roof | SDL | 4.5 | B2 | F15 | 1613 | B1-Parking
TRL-Roof | HTH | 0.7 | B2 | F17 | 1615 | B1-Parking
 |  |  | B2 | F18 | 1608 | B1-Parking
 |  |  | B2 | F20 | 1610 | B1-Parking
 |  |  | B2 | F28 | 1616 | B1-Parking
 |  |  | B2 | F36 | 1617 | B1-Parking
 |  |  | B2 | F37 | 1618 | B1-Parking
 |  |  | B2 | F57 | 1619 | B1-Parking
 |  |  | B2 | F62 | 1612 | B1-Parking
 |  |  | B2 | F79 | 1614 | B1-Parking
 |  |  | B2 | F52 | 1611 | B1-Parking
 |  |  | B2 | F63 | 1632 | B1-Parking
 |  |  | B2 | F78 | 1633 | B1-Parking
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
 |  |  | B3 | F82 | 1667 | B1-Parking
 |  |  | B3 | F84 | 1668 | B1-Parking
 |  |  | B3 | F61 | 1671 | B1-Parking
 |  |  | B3 | F86 | 1672 | B1-Parking
 |  |  | B3 | F87 | 1673 | B1-Parking
 |  |  | B3 | F88 | 1669 | B1-Parking
 |  |  | B3 | F89 | 1670 | B1-Parking

Sheet: Safe21
TABLE: Shell Uniform Load Sets |  |  |  | TABLE: Area Load Assignments - Uniform Load Sets
Name | Load Pattern | Load Value | GUID | Story | Label | UniqueName | Load Set
 |  | kN/m²
01.2-Toilet | SDL | 1.2 |  | 20F | F35 | 1515 | 04.2-Corridor-Public
01.2-Toilet | COL | 0.5 |  | 20F | F53 | 1517 | 05.2-MEP/Typ
01.2-Toilet | BW | 3 |  | 20F | F55 | 1518 | 05.2-MEP/Typ
01.2-Toilet | L | 1.92 |  | 20F | F56 | 1519 | Corridor
02.1-Office/GF | SDL | 1.2 |  | 20F | F57 | 1520 | 05.2-MEP/Typ
02.1-Office/GF | COL | 0.5 |  | 20F | F58 | 1521 | Corridor
02.1-Office/GF | BW | 9.5 |  | 20F | F60 | 1522 | 05.2-MEP/Typ
02.1-Office/GF | L | 2.4 |  | 20F | F28 | 1516 | 04.2-Corridor-Public
02.2-Office/Typ | SDL | 1.2 |  | 20F | F125 | 1555 | 04.2-Corridor-Public
02.2-Office/Typ | COL | 0.5 |  | 20F | F229 | 1531 | Corridor
02.2-Office/Typ | BW | 3.5 |  | 20F | F232 | 1532 | 04.3-Stair
02.2-Office/Typ | L | 2.4 |  | 20F | F233 | 1533 | Corridor
02.3-Utilities | SDL | 1.2 |  | 20F | F234 | 1534 | 04.3-Stair
02.3-Utilities | COL | 0.5 |  | 20F | F235 | 1535 | 04.3-Stair
02.3-Utilities | BW | 0 |  | 20F | F1 | 1560 | GuestRoom
02.3-Utilities | L | 4.79 |  | 20F | F141 | 1563 | GuestRoom
02.4-Kitchen | SDL | 1.2 |  | 20F | F145 | 1536 | Corridor
02.4-Kitchen | COL | 0.5 |  | 20F | F251 | 1539 | 04.2-Corridor-Public
02.4-Kitchen | BW | 0 |  | 20F | F265 | 1544 | GuestRoom
02.4-Kitchen | L | 4.79 |  | 20F | F267 | 1545 | GuestRoom
03.1-Restaurant | SDL | 1.2 |  | 20F | F268 | 1546 | GuestRoom
03.1-Restaurant | COL | 0.5 |  | 20F | F269 | 1547 | GuestRoom
03.1-Restaurant | BW | 0 |  | 20F | F270 | 1548 | GuestRoom
03.1-Restaurant | L | 4.79 |  | 20F | F271 | 1549 | GuestRoom
03.2-Terrace | SDL | 1.2 |  | 20F | F272 | 1550 | GuestRoom
03.2-Terrace | COL | 0.5 |  | 20F | F273 | 1551 | GuestRoom
03.2-Terrace | BW | 0 |  | 20F | F274 | 1552 | GuestRoom
03.2-Terrace | L | 4.79 |  | 20F | F278 | 1556 | 04.2-Corridor-Public
03.3-Conference | SDL | 1.2 |  | 20F | F221 | 1540 | 04.2-Corridor-Public
03.3-Conference | COL | 0.5 |  | 20F | F200 | 1561 | GuestRoom
03.3-Conference | BW | 0 |  | 20F | F222 | 1562 | GuestRoom
03.3-Conference | L | 4.79 |  | 20F | F295 | 1537 | GuestRoom
03.4-HUB | SDL | 1.2 |  | 20F | F299 | 1538 | GuestRoom
03.4-HUB | COL | 0.5 |  | 20F | F301 | 1068 | GuestRoom
03.4-HUB | BW | 0 |  | 20F | F302 | 1541 | GuestRoom
03.4-HUB | L | 4.79 |  | 20F | F303 | 1553 | GuestRoom
03.5-Gym | SDL | 1.2 |  | 20F | F304 | 1554 | GuestRoom
03.5-Gym | COL | 0.5 |  | 20F | F306 | 1101 | GuestRoom
03.5-Gym | BW | 0 |  | 20F | F307 | 1557 | GuestRoom
03.5-Gym | L | 4.79
03.6-Bar | SDL | 1.2
03.6-Bar | COL | 0.5
03.6-Bar | BW | 0
03.6-Bar | L | 4.79
04.1 Public | SDL | 1.2
04.1 Public | COL | 0.5
04.1 Public | BW | 2
04.1 Public | L | 4.79
04.2-Corridor-Public | SDL | 1.2
04.2-Corridor-Public | COL | 0.5
04.2-Corridor-Public | BW | 0
04.2-Corridor-Public | L | 4.79
04.3-Stair | SDL | 4
04.3-Stair | COL | 0.5
04.3-Stair | BW | 0
04.3-Stair | L | 4.79
05.1-MEP/GF | SDL | 1.2
05.1-MEP/GF | COL | 0.5
05.1-MEP/GF | BW | 9.5
05.1-MEP/GF | L | 7.5
05.2-MEP/Typ | SDL | 1.2
05.2-MEP/Typ | COL | 0.5
05.2-MEP/Typ | BW | 4
05.2-MEP/Typ | L | 7.5
05.3-Cooling Tower | SDL | 1.2
05.3-Cooling Tower | COL | 0.5
05.3-Cooling Tower | BW | 0
05.3-Cooling Tower | L | 15
05.4-Chiller Room | SDL | 1.2
05.4-Chiller Room | COL | 0.5
05.4-Chiller Room | BW | 0
05.4-Chiller Room | L | 15
05.5 Genset Room | SDL | 1.2
05.5 Genset Room | COL | 0.5
05.5 Genset Room | BW | 0
05.5 Genset Room | L | 15
05.6 Fire Pump | SDL | 1.2
05.6 Fire Pump | COL | 0.5
05.6 Fire Pump | BW | 0
05.6 Fire Pump | L | 15
06.1-Loading Dock | SDL | 0
06.1-Loading Dock | COL | 0
06.1-Loading Dock | BW | 0
06.1-Loading Dock | L | 11.97
06.2-Driveway | SDL | 0
06.2-Driveway | COL | 0
06.2-Driveway | BW | 0
06.2-Driveway | L | 11.97
06.3-Parking | SDL | 0
06.3-Parking | COL | 0.25
06.3-Parking | BW | 0
06.3-Parking | L | 2.5
07.1-Roof/Not use | SDL | 2.5
07.1-Roof/Not use | COL | 0.5
07.1-Roof/Not use | BW | 0
07.1-Roof/Not use | Lr | 1
07.2-RoofMep | SDL | 2.5
07.2-RoofMep | COL | 0.5
07.2-RoofMep | BW | 0
07.2-RoofMep | L | 5
08.1-Landscape/GF | SDL | 5
08.1-Landscape/GF | COL | 0
08.1-Landscape/GF | BW | 0
08.1-Landscape/GF | L | 4.79
08.2-Landscape/S1m | SDL | 18
08.2-Landscape/S1m | COL | 0.5
08.2-Landscape/S1m | BW | 0
08.2-Landscape/S1m | L | 4.79
08.3-Landscape/S1.5m | SDL | 30
08.3-Landscape/S1.5m | COL | 0.5
08.3-Landscape/S1.5m | BW | 0
08.3-Landscape/S1.5m | L | 4.79
09. WaterTank25 | SDL | 25
09. WaterTank25 | COL | 0.5
09. WaterTank25 | BW | 0
09. WaterTank25 | L | 2
Congregation(22) | SDL | 3
Congregation(22) | COL | 0.5
Congregation(22) | BW | 0
Congregation(22) | L | 4.79
Corridor | SDL | 1.2
Corridor | COL | 0.5
Corridor | BW | 0
Corridor | L | 1.92
GuestRoom | SDL | 1.2
GuestRoom | COL | 0.5
GuestRoom | BW | 4
GuestRoom | L | 1.92
Storage | SDL | 1.2
Storage | COL | 0.5
Storage | BW | 0
Storage | L | 7.5
Swimming(2m) | SDL | 20
Swimming(2m) | COL | 0.5
Swimming(2m) | BW | 0
Swimming(2m) | L | 4.79
WaterTank12 | SDL | 5
WaterTank12 | COL | 0.5
WaterTank12 | BW | 0
WaterTank12 | L | 12
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
