Lightingsang/AddinRebar/HPDcePro/assets/Excel/DceSteel/110 Ve khung cot be tong.xlsm

Sheet: Data
Xà gồ | Bu lông | Loại liên kết k | Loại
Z150 | 12 |  | Thẳng
Z180 | 16 | K-4-0-2 | L
Z200 | 20 | K-4-0-4 | J
Z250 | 24 | K-4-2-2
Z300 | 27 | K-4-2-4
C100 | 30 | K-6-0-2
C150 | 36 | K-6-0-4
C180 | 42 | K-6-0-6
C200 |  | K-6-2-2
C250 |  | K-6-2-4
C300 |  | K-6-2-6
 |  | K-8-0-2
 |  | K-8-0-4
 |  | K-8-2-2
 |  | K-8-2-4
 |  | K-10-0-2
 |  | K-10-0-4
 |  | K-12-0-2

Sheet: VKDHBT
KHUNG K2 |  |  |  |  |  | Tên lệnh Autocad |  |  |  | VKDHBT |  |  |  | CHỨC NĂNG ÁP DỤNG CHO KHUNG ĐẦU HỒI VÀ CỘT CHÍNH LÀ CỘT BÊ TÔNG
Tỉ lệ bản vẽ |  |  |  | 200 |  | Xà gồ mái |  |  | Z200 | 1200 | K/c mép | 50 |  | Liên kết | Chiều dài bản đế | Bố trí | Loại bu lông | ĐK bu lông | Chiều dày Bản đế | Chiều dày Tăng cứng
Cao độ chân cột |  |  |  | 0 | mm | Xà gồ tường |  |  | Z200 | 1200
Thông số về chiều cao mái |  |  |  | Đã tính lớp bao che |  | K/c trục và mép cột thép trái |  |  | 200 | mm |  |  |  | Nách trái | 300 | 4 | J | M 20 | 16 | 10
+ Chiều cao đỉnh mái biên trái |  |  |  | 9000 | mm | K/c trục và mép cột thép phải |  |  | 200 | mm |  |  |  | Nách phải | 300 | 4 | J | M 20
+ Chiều cao đỉnh mái ở giữa |  |  |  | 12000 | mm | Hình dạng vai đỡ máng xối |  |  | Nghiêng |  |  |  |  | Cột giữa |  | 4 | J | M 20 | 16 | 10
+ Chiều cao đỉnh mái biên phải |  |  |  | 9000 | mm
Chiều dày bản đế |  |  |  | Điền bên liên kết nách |  | Cách thể hiện tên kèo |  |  | Tên & Kích thước
Chiều dày lớp vữa |  |  |  | 50 |  | Cách thể hiện tên cột |  |  | Tên & Kích thước
Tổng bề rộng 1/2 nhà bên trái |  |  |  | 39450 | 7.6% | Thông số chiều cao H |  |  | Total | Chiều cao tổng
Tổng bề rộng 1/2 nhà bên phải |  |  |  | 39450 | 7.6%
Tổng bề rộng nhà, B |  |  |  | 78900 | mm
Tên lưới |  | Bảng thông số cột |  |  |  |  |  |  | Bảng thông số kèo |  |  |  |  |  |  | Thông số liên kết |  |  | Thông số cột/kèo: - Nếu điền 1 số thì mặc định chiều cao trái = phải, bề rộng cánh trên = dưới, chiều dày trên = dưới. Ví dụ 200 - Nếu điền 2 số thì mặc định số đầu tiên là trái, số thứ 2 là phải. Phân cách giữa 2 số có thể dùng dấu _ hoặc ; hoặc /. Ví dụ 150_200 hoặc 150;200 hoặc 150/200
 |  | Cột bê tông |  | Thông tin cột thép |  |  |  |  | Phân đoạn | Tên kèo | Chiều dài kèo | Tiết diện thép |  |  |  | Tổng số bu lông | Bolt | Bề dày bản mã liên kết (mm)
 |  | Bề rộng | Chiều cao | Tên cột | Chiều cao | Chiều dày bụng | Bề rộng cánh | Chiều dày cánh |  |  |  | Chiều cao | Chiều dày bụng | Bề rộng cánh | Chiều dày cánh
Hệ lưới | Khoảng cách |  |  |  |  |  |  |  | Bên trái
 |  | B | H |  | H | tw | Bf | Tf | Bên phải |  |  | H | tw | Top / Bot | Top / Bot
(1) | (2) | (3) | (4) | (5) | (6) | (7) | (8) | (9) | (10) | (11) | (12) | (13) | (14) | (15) | (16) | (17) | (18) | (19)
Y1 | 8650 | 500_1000 | 0 | Cột biên nên bỏ qua, kèo ngồi trực tiếp lên cột |  |  |  |  | Đoạn 1 | K1 | 12000 | 300 | 5 | 148 | 8 | 8 | M 20 | 16
Y2 | 8600 | 1000 | 0 | EC1 | 264 | 5 | 164 | 10 | Đoạn 2 | K2 | 9000 | 300 | 5 | 148 | 8 | 8 | M 20 | 16
Y3 | 8600 | 1000 | 0 | EC1 | 264 | 5 | 164 | 10 | Đoạn 3 | K3 |  | 300 | 5 | 148 | 8 | 8 | M 20 | 16
Y4 | 8550 | 1000 | 0 | EC1 | 264 | 5 | 164 | 10 | Đoạn 4 | K4 | 9000 | 300 | 5 | 148 | 8 | 8 | M 20 | 16
Y5 | 5050 | 1000 | 0 | EC1 | 264 | 5 | 164 | 10 | Đoạn 5
Y6 | Đỉnh mái | 1000 | 0 | EC1 | 264 | 5 | 164 | 10 | Nếu có cột giữa tại đỉnh mái thì nhập vào hàng này
Y7 | 5050 | 1000 | 0 | EC1 | 264 | 5 | 164 | 10 | Đoạn 5
Y8 | 8550 | 1000 | 0 | EC1 | 264 | 5 | 164 | 10 | Đoạn 4 | K4 | 9000 | 300 | 5 | 148 | 8 | 8 | M 20 | 16
Y9 | 8600 | 1000 | 0 | EC1 | 264 | 5 | 164 | 10 | Đoạn 3 | K3 |  | 300 | 5 | 148 | 8 | 8 | M 20 | 16
Y10 | 8600 | 1000 | 0 | EC1 | 264 | 5 | 164 | 10 | Đoạn 2 | K2 | 9000 | 300 | 5 | 148 | 8 | 8 | M 20 | 16
Y11 | 8650 | 500_1000 | 0 | Cột biên nên bỏ qua, kèo ngồi trực tiếp lên cột |  |  |  |  | Đoạn 1 | K1 | 12000 | 300 | 5 | 148 | 8 | 8 | M 20 | 16

Sheet: VKBT
KHUNG K2 |  |  |  |  |  | Tên lệnh Autocad |  |  |  | VKBT
Tỉ lệ bản vẽ |  |  |  | 200 |  | Xà gồ mái |  |  | C200 | 1200 | K/c mép | 50 | Liên kết | Chiều dài bản đế | Bố trí | Loại bu lông | ĐK bu lông | Chiều dày Bản đế | Chiều dày Tăng cứng
Cao độ chân cột |  |  |  | 0 | mm | Xà gồ tường |  |  | C200 | 1200
Thông số về chiều cao mái |  |  |  | Đã tính lớp bao che |  | K/c trục và mép cột thép trái |  |  | 200 | mm |  |  | Nách trái | 650 | K-6-0-2 | J | M 24 | 20 | 10
+ Chiều cao đỉnh mái biên trái |  |  |  | 8000 | mm | K/c trục và mép cột thép phải |  |  | 200 | mm |  |  | Nách phải | 650 | K-6-0-2 | J | M 24
+ Chiều cao đỉnh mái ở giữa |  |  |  | 12000 | mm | Hình dạng vai đỡ máng xối |  |  | Ngang |  |  |  | Đỉnh mái (dầm nối + cột giữa) |  |  |  | 20
+ Chiều cao đỉnh mái biên phải |  |  |  | 8000 | mm
Chiều dày bản đế |  |  |  | Điền bên liên kết nách |  | Cách thể hiện tên kèo |  |  | Tên & Kích thước
Chiều dày lớp vữa |  |  |  | 50 |  | Cách thể hiện tên cột |  |  | Tên & Kích thước
Tổng bề rộng 1/2 nhà bên trái |  |  |  | 20000 | 20.0% | Thông số chiều cao H |  |  | Total | Chiều cao tổng
Tổng bề rộng 1/2 nhà bên phải |  |  |  | 20000 | 20.0% |  |  |  |  |  |  |  | Gia cường sườn tăng cứng bản bụng tại kèo thép |  |  | Chiều dày | Bước sườn
Tổng bề rộng nhà, B |  |  |  | 40000 |  |  |  |  |  |  |  |  |  |  |  | 5 | 1500
Tên lưới | Bảng thông số kèo |  |  |  |  |  |  | Thông số liên kết cuối đoạn kèo |  |  |  |  | Bảng thông số cột
 | Phân đoạn | Tên kèo | Chiều dài kèo | Tiết diện thép |  |  |  | Tên liên kết | Số bolt (bên trong) | Đường kính bu lông | Chiều dày mặt bích (mm) | Chiều dày gân cứng tam giác | Vị trí cột | Cột bê tông
 |  |  |  | Chiều cao trái/phải | Chiều dày bụng | B cánh trên/dưới | t cánh trên/dưới |  |  |  |  |  |  | Bề rộng | Chiều cao
 | Bên trái
 | Bên phải |  |  | H | tw | Bf | Tf
(1) | (2) | (3) | (4) | (5) | (6) | (7) | (8) | (9) | (10) | (11) | (12) | (13) | (14) | (15) | (16)
A | Đoạn 1 | K1 | 6000 | 524_324 | 8 | 200 | 12 |  | 8 | M 20 | 20 | 10 | Biên trái | 500_1000 | 0
B | Đoạn 2 | K2 |  | 324 | 8 | 200 | 12 |  | 8 | M 20 | 20 | 10 | Cột giữa
C | Đoạn 3 | K3 | 9000 | 324_624 | 8 | 200 | 12 |  | 8 | M 20 | 20 | 10 | Biên phải | 500_1000 | 0
 | Đoạn 4 | K4 |  |  |  |  |  |  |  |  |  |  | Thông số cột: - Nếu điền 1 số thì mặc định chiều cao trái = phải, bề rộng cánh trên = dưới, chiều dày trên = dưới. Ví dụ 200 - Nếu điền 2 số thì mặc định số đầu tiên là trái, số thứ 2 là phải. Phân cách giữa 2 số có thể dùng dấu _ hoặc ; hoặc /. Ví dụ 150_200 hoặc 150;200 hoặc 150/200
 | Đoạn 5
 | Đỉnh mái | K5 | 1500 | 624;0;624 | 8 | 200 | 12
 | Đoạn 5
 | Đoạn 4
 | Đoạn 3 | K3 | 9000 | 624_324 | 8 | 200 | 12 |  | 8 | M 20 | 20 | 10
 | Đoạn 2 | K2 |  | 324 | 8 | 200 | 12 |  | 8 | M 20 | 20 | 10
 | Đoạn 1 | K1 | 6000 | 324_524 | 8 | 200 | 12 |  | 8 | M 20 | 20 | 12

Sheet: VK3BT
KHUNG K2 |  |  |  |  |  | Tên lệnh Autocad |  |  |  | VK3BT
Tỉ lệ bản vẽ |  |  |  | 150 |  | Xà gồ mái |  | C200 | 1200 | K/c mép | 50 | Liên kết | Vị trí | Loại | Bolt | Bản mã
Cao độ chân cột |  |  |  | 0 | mm | Xà gồ tường |  | C200 | 1200 |  |  | Nách |  |  | M 20 | 20
Thông số về chiều cao mái |  |  |  | Chưa tính lớp bao che |  | K/c trục và mép cột |  |  | 200 |  |  | Đỉnh mái (k cột giữa) |  | 4 | M 20 | 20
+ Chiều cao đỉnh mái biên trái |  |  |  | 10000 | mm | Chiều dày tường biên bao che |  |  | 200 | mm |  | Đỉnh mái (cột giữa) |  | 4 | M 20 | 20
+ Chiều cao đỉnh mái ở giữa |  |  |  | 15000 | mm | Chiều cao tường biên bao che |  |  | 2500 | mm |  | Đỉnh cột giữa |  | 4 | M 20 | 20
+ Chiều cao đỉnh mái biên phải |  |  |  | 10000 | mm | K/c mép tường và mép cột |  |  | 250 | mm
Chiều dày bản đế |  |  |  | 20 |  | Hình dạng vai đỡ máng xối |  |  | Ngang |  |  | Gia cường bản bích liên kết bu lông |  | Max bolt | Chiều dày | Chiều dài
Chiều dày lớp vữa |  |  |  | 50 |  |  |  |  |  |  |  |  |  | 300 | 6 | 180
Chiều cao bệ bê tông |  |  |  | 300 |  |  |  |  |  |  |  | Gia cường sườn tăng cứng bản bụng tại cột |  |  | Chiều dày | Bước sườn
Tổng bề rộng 1/2 nhà bên trái |  |  |  | 55000 | 9.1% | Cách thể hiện tên kèo |  |  | Tên & Kích thước |  |  |  |  |  | 8 | 2000
Tổng bề rộng 1/2 nhà bên phải |  |  |  | 55000 | 9.1% | Cách thể hiện tên cột |  |  | Tên & Kích thước |  |  | Gia cường sườn tăng cứng bản bụng tại kèo thép |  |  | Chiều dày | Bước sườn
Tổng bề rộng nhà, B |  |  |  | 110000 |  | Thông số chiều cao H |  |  | Total | Chiều cao tổng |  |  |  |  | 8 | 2000
Tên lưới |  | Vị trí cột | Bảng thông số cột |  |  |  |  |  |  | Bảng thông số kèo |  |  |  |  |  |  | Thông số liên kết
 |  |  | Cột bê tông |  | Tên cột | Tiết diện thép |  |  |  | Phân đoạn | Tên kèo | Chiều dài kèo | Tiết diện thép |  |  |  | Số bu lông bên trong kèo | Bolt | Bề dày bản mã liên kết (mm)
 |  |  | Bề rộng | Chiều cao |  | Chiều cao | Chiều dày bụng | Bề rộng cánh | Chiều dày cánh |  |  |  | Chiều cao | Chiều dày bụng | Bề rộng cánh | Chiều dày cánh
Hệ lưới | Khoảng cách |  |  |  |  |  |  |  |  | Bên trái
 |  |  |  |  |  | H | tw | Bf | Tf | Bên phải |  |  | H | tw | Top / Bot | Top / Bot
(1) | (2) | (3) | (4) | (5) | (6) | (7) | (8) | (9) | (10) | (11) | (12) | (13) | (14) | (15) | (16) | (17) | (18) | (19) | (20)
A | 25000 | Biên trái | 1000 | 0 | I - | 600 | 6 | 200 | 8 | Đoạn 1 | K1 | 9000 | 900/500 | 6 | 200 | 8 | 4 | M 20 | 16
B | 30000 | Giữa trái | 1000 | 0 | I - | 600 | 5 | 210 | 8 | Đoạn 2 | K2 |  | 500/600 | 6 | 200 | 8 | 4 | M 20 | 16
C | 30000 | Đỉnh mái |  |  |  |  |  |  |  | Đoạn 3 | K3 | 3000 | 600 | 6 | 200 | 8 | 4 | M 20 | 16
D | 25000 | Giữa phải | 1000 | 0 | I - | 600 | 5 | 210 | 8 | Đoạn 4
E |  | Biên phải | 1000 | 0 | I - | 600 | 6 | 200 | 8 | Đỉnh cột | K4 | 12000 | 600;1500;500 | 6 | 250 | 8 | 4 | M 20 | 16
 |  |  |  |  |  |  |  |  |  | Đoạn 6 | K5 | 3000 | 500 | 6 | 200 | 8 | 4 | M 20 | 16
Lưu ý: Từ đoạn 1 đến đoạn 4, phải có 1 đoạn số lẻ để trống Từ đoạn 6 đến đoạn 9, phải co 1 đoạn số lẻ để trống |  |  |  |  |  |  |  |  |  | Đoạn 7 | K6 |  | 500 | 6 | 200 | 8 | 4 | M 20 | 16
 |  |  |  |  |  |  |  |  |  | Đoạn 8 | K7 | 6000 | 500/400 | 6 | 200 | 8 | 4 | M 20 | 16
 |  |  |  |  |  |  |  |  |  | Đoạn 9 | K8 | 6000 | 400 | 6 | 200 | 8 | 4 | M 20 | 16
 |  |  |  |  |  |  |  |  |  | Đỉnh mái | KG | 1500 | 400_600_400 | 6 | 200 | 8
 |  |  |  |  |  |  |  |  |  | Đoạn 9 | K8 | 6000 | 400 | 6 | 200 | 8 | 4 | M 20 | 16
 |  |  |  |  |  |  |  |  |  | Đoạn 8 | K7 | 6000 | 400_500 | 6 | 200 | 8 | 4 | M 20 | 16
 |  |  |  |  |  |  |  |  |  | Đoạn 7 | K6 |  | 500 | 6 | 200 | 8 | 4 | M 20 | 16
 |  |  |  |  |  |  |  |  |  | Đoạn 6 | K5 | 3000 | 500 | 6 | 200 | 8 | 4 | M 20 | 16
 |  |  |  |  |  |  |  |  |  | Đỉnh cột | K4 | 12000 | 500_1500_600 | 6 | 250 | 8 | 4 | M 20 | 16
 |  |  |  |  |  |  |  |  |  | Đoạn 4
 |  |  |  |  |  |  |  |  |  | Đoạn 3 | K3 | 3000 | 600 | 6 | 200 | 8 | 4 | M 20 | 16
 |  |  |  |  |  |  |  |  |  | Đoạn 2 | K2 |  | 600_500 | 6 | 200 | 8 | 4 | M 20 | 16
 |  |  |  |  |  |  |  |  |  | Đoạn 1 | K1 | 9000 | 500_900 | 6 | 200 | 8 | 4 | M 20 | 16
LƯU Ý: ĐỂ THUẬN TIỆN THỐNG KÊ KHỐI LƯỢNG, SỐ LƯỢNG BU LÔNG LÀ NHẬP SỐ TỔNG (TÍNH LUÔN 2 HOẶC 4 CON BU LÔNG NGOÀI BIÊN)
