Lightingsang/AddinRebar/HPDcePro/assets/Excel/DceSteel/120 Mat bang ket cau.xlsm

Sheet: MBLT
Dữ liệu vẽ lưới |  |  |  | THÔNG TIN CHUNG |  |  | MẶT BẰNG MÁI | TRÁI | TRÊN
Grid ID | P. X | Grid ID | P. Y |  |  |  | MẶT BẰNG KHUNG | PHẢI | DƯỚI
X1 | 8000 | Y1 | 9000 | Tên bản vẽ | VN | MẶT BẰNG DẦM SÀN | MẶT BẰNG XÀ GỒ | ALL | ALL
X2 | 8000 | Y2 | 9000 |  | EN |  | MẶT BẰNG DẦM SÀN
X3 | 8000 | Y3 | 9000 | Tỉ lệ bản vẽ |  | 1/200 | MẶT BẰNG CHÂN CỘT
X4 | 8000 | Y4 | 9000 | Dim trục phương X |  | ALL | MẶT BẰNG DẦM DẪN CẦU TRỤC
X5 | 8000 | Y5 | 9000 | Dim trục phương Y |  | ALL | MẶT BẰNG MÓNG
X6 | 8000 | Y6 | 9000 |  |  |  | MẶT BẰNG BU LÔNG NEO
X7 | 8000 | Y7 |  | Vào icon ShopDwg trên thanh công cụ excel để load nhanh dữ liệu lưới trục từ phần mềm CSI vào sheet Excel
X8 | 8000
X9 | 8000
X10 | 8000 |  |  |  |  |  | ANCHOR BOLT PLAN
X11 | 8000 |  |  |  |  |  | COLUMN PLAN
X12 |  |  |  |  |  |  | FOUNDATION PLAN
 |  |  |  |  |  |  | FRAMING PLAN
 |  |  |  |  |  |  | PURLIN PLAN
 |  |  |  |  |  |  | ROOF PLAN

Sheet: MBM
Dữ liệu vẽ lưới |  |  |  | THÔNG TIN CHUNG |  |  |  |  | Trong trường hợp người dùng vẽ không cần liên kết với Etabs, Sap2000 thì cần bổ sung thông tin sau
Grid ID | P. X | Grid ID | P. Y
X1 | 8000 | Y1 | 8000 | Tỉ lệ bản vẽ |  |  | 1/200 |  | Vị trí giằng X | Nhịp 1 | Nhịp 4 | Nhịp 8 | Nhịp 11
X2 | 8000 | Y2 | 9000 | Vẽ lưới (theo dữ liệu bên trái) |  |  | Y
X3 | 8000 | Y3 | 9000 | Khoảng cách từ trục đến mép. |  | Trái | 250
X4 | 8000 | Y4 | 9000 |  |  | Phải | 250
X5 | 8000 | Y5 | 9000 |  |  | Dưới | 0
X6 | 8000 | Y6 | 8000 |  |  | Trên | 0
X7 | 8000 | Y7
X8 | 8000
X9 | 8000
X10 | 8000 |  |  | MẶT BẰNG MÁI |  | LINE | TEXT | Loại tiết diện | Kích thước
X11 | 8000
X12 |  |  |  | Khung đầu hồi | KHUNG K1 | Red | Red
 |  |  |  | Khung giữa | KHUNG K2 | Green | Green
 |  |  |  | Giằng X | BR | Blue | Blue | Rod | 20
 |  |  |  | Giằng dọc | EB | Magenta | Magenta | Thép hộp | 100 4
 |  |  |  | Vào icon ShopDwg trên thanh công cụ excel để load nhanh dữ liệu lưới trục từ phần mềm CSI vào sheet Excel

Sheet: MBXGM
Dữ liệu vẽ lưới |  |  |  |  | THÔNG TIN CHUNG |  |  | MẶT BẰNG XÀ GỒ MÁI |  |  | MẶT BẰNG XÀ GỒ NÓC GIÓ |  |  | Quy định ty giằng
Grid ID | P. X | Grid ID | P. Y | Lap xà gồ |  |  |  |  |  |  |  |  |  | Lmax | n
X1 | 7000 | Y1 | 8000 | 500 | Khoảng cách từ trục đến mép. | Trái | 250 | Bước xà gồ max |  | 1200 | Công trình có nóc gió |  | N | 6000 | 1
X2 | 8000 | Y2 | 9000 | 600 |  | Phải | 250 | Khung đầu hồi | Z200x62x68x20x2.3 | 6.368 | Vị trí nóc gió | Bắt đầu | Y2 | 9000 | 2
X3 | 8000 | Y3 | 9000 | 600 |  | Dưới | 0 | Khung còn lại | Z200x62x68x20x2.0 | 5.537 |  | Kết thúc | Y6 | 12000 | 3
X4 | 8000 | Y4 | 9000 | 600 |  | Trên | 0 | Ty giằng xà gồ | 1 | 12 | Bề rộng nóc gió |  | 5000 | 15000 | 4
X5 | 8000 | Y5 | 9000 | 600 | Tỉ lệ bản vẽ |  | 1/200 | Trục đỉnh mái | X4 | 0 | Z200x62x68x20x2.0 |  | 1200 | 18000 | 5
X6 | 8000 | Y6 | 8000 | 600 |  |  |  | Thanh chống xà gồ | Bố trí | So le | (*) Nóc gió = Cửa trời |  |  | Chỉ sữa giá trị Lmax, không được sữa số lượng ty giằng
X7 | 8000 | Y7 |  | 600 |  |  |  |  | Chiều dài | 300
X8 | 8000 |  |  | 600 |  |  |  |  | 1V | 40 5
X9 | 8000 |  |  | 600 |  |  |  | Nếu tên trục đỉnh mái thuộc cột A thì xà gồ rải theo phương đứng, nếu tên trục đỉnh mái thuộc cột C thì xà gồ rải theo phương ngang
X10 | 8000 |  |  | 600
X11 | 7000 |  |  | 500 | QUY ĐỊNH MÀU SẮC ĐỐI TƯỢNG
X12
 |  |  |  |  | Khung thép |  | Cyan
 |  |  |  |  | Xà gồ |  | Yellow
 |  |  |  |  | Ty giằng |  | White
 |  |  |  |  | Vào icon ShopDwg trên thanh công cụ excel để load nhanh dữ liệu lưới trục từ phần mềm CSI vào sheet Excel

Sheet: FrameSect
BẢNG THÔNG SỐ TÊN CẤU KIỆN
THÉP I |  | THÉP HỘP |  | THÉP ỐNG |  | THÉP C |  | THÉP V |  | Thanh giằng |  | Xà gồ
Tên mô hình | Ký hiệu | Tên mô hình | Ký hiệu | Tên mô hình | Ký hiệu | Tên mô hình | Ký hiệu | Tên mô hình | Ký hiệu | Tên mô hình | Ký hiệu | Tên mô hình | Ký hiệu
1000x10+250x12 | B1 | RHS 200x100x5 | T1 | CHS 114x3 | P1 | C 250x90x9x13 | C1 | L63x63x5 | V1 | Rod12 | Rod12 | C250x2.5 | C250x2.5
1000x12+250x14 | B2 | T125*2.5 | T2 |  |  |  |  | L75x75x6 | V2 | Rod16 | Rod16 | Z250x1.8 | Z250x1.8
1000x12+250x16 | B3 | T125*3.0 | T3 |  |  |  |  | LD(2)120x120x12 | V3 | Rod20 | Rod20
1000x8+250x10 | B4 | T150*3.5 | T4 |  |  |  |  |  |  | Rod24 | Rod24
200x5+150x6 | B5 | T150*4.5 | T5
250x200x6x8 | B6
300x6+185x10 | B7
400x12+400x30 | B8
400x6+185x10 | B9
400x6+200x12 | B10
400x6+250x10 | B11
400x6+250x14 | B12
400x6+400x12 | B13
400x6+400x14 | B14
400x8+400x16 | B15
400x8+400x18 | B16
500x8+250x12 | B17
600x6+200x10 | B18
600x6+215x10 | B19
600x6+215x12 | B20
600x6+250x10 | B21
600x8+200x12 | B22
600x8+250x16 | B23
700x8+250x12 | B24
750x12+350x25 | B25
750x8+300x16 | B26
T400-1000x8+250x10 | B27
T400-600x6+200x12 | B28

Sheet: CSISect
BẢNG THÔNG SỐ TÊN CẤU KIỆN
THÉP I | 16 | Color | THÉP HỘP | 5 | Color | THÉP ỐNG | 5 | Color | THÉP C | 5 | Color | THÉP V | 5 | Color | Thanh giằng | 5 | Color | Xà gồ | 4 | Color
1000x10+250x12 | B1 | Layer | RHS 200x100x5 | T1 | Layer | CHS 114x3 | P1 | Layer | C 250x90x9x13 | C1 | Layer | L75x75x6 | V2 | Layer | Rod24 | Rod24 | Layer
1000x12+250x14 | B2 | Layer
1000x12+250x16 | B3 | Layer
1000x8+250x10 | B4 | Layer
300x6+185x10 | B7 | Layer
400x6+185x10 | B9 | Layer
600x6+200x10 | B18 | Layer
600x6+215x12 | B20 | Layer
600x8+200x12 | B22 | Layer
600x8+250x16 | B23 | Layer
750x12+350x25 | B25 | Layer
750x8+300x16 | B26 | Layer
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
