Lightingsang/AddinRebar/HPDcePro/assets/Excel/DceSteel/15. DCE_ThongKeThep_2020.xlsm

Sheet: HinhDang
CẤU KIỆN | SỐ HIỆU | HÌNH DẠNG KÍCH THƯỚC (mm) |  |  |  |  | TÊN
 |  |  |  | L |  |  | TK1
 |  | L1 |  | L2 |  |  | TK2
 |  |  |  | L1 |  | L2 | TK3
 |  | L1 |  | L2 |  | L3 | TK4
 |  | L1 |  | L2 |  | L3 | TK4DV
 |  | L1 | L2 | L3 | L4 | L5 | TK4R1
 |  | L1 |  | L2 |  |  | TK5
 |  |  |  | L1 |  | L2 | TK6
 |  | L1 |  | L2 |  | L3 | TK7
 |  | L1 | L2 | L3 | L4 | L5 | TK7R1
 |  | M1 |  | L |  | M2 | TK8
 |  | M |  | L1 |  | L2 | TK8A
 |  | M1 |  | L |  | M2 | TK8B
 |  | M |  | L1 |  | L2 | TK9
 |  | L1 | L2 | L3 | L4 | L5 | TK10
 |  |  | L1 | L2 | L3 |  | TK11
 |  |  |  | L1 |  | L2 | TK11A
 |  | L1 |  | L2 | L3 |  | TK12
 |  | L1 |  | L2 | L3 |  | TK12B
 |  | M1 |  | L |  | M2 | TK13
 |  | L1 | L2 | L3 |  | L4 | TK14
 |  | L1 | L2 | L3 | L4 |  | TK15
 |  | L1 | L2 | L3 | L4 |  | TK15A
 |  | L1 | L2 | L4 | L3 | L5 | TK16
 |  | L1 |  | L2 |  | L3 | TK17
 |  | L1 | L2 |  | L3 | L4 | TK18
 |  |  | L1 | L2 | L3 |  | TK19
 |  |  | L4 | L3 | L1 | L2 | TK20
 |  | L3 |  | L2 | L1 |  | TK21
 |  | L1 | L2 | L4 | L3 | L5 | TK22
 |  |  |  | D | M |  | TK23
 |  | M1 | M2 | L1 |  | L2 | TK24
 |  | M |  | L1 |  | L2 | TK25
 |  | M1 | L1 | L2 |  | M2 | TK26
 |  | M | L1 | L2 |  |  | TK27
 |  | L1 |  | L2 |  | M | TK27A
 |  | L1 |  | L2 |  | M | TK27B
 |  | M1 | L1 | L2 | L3 | M2 | TK28
 |  | L1 | M | L2 |  |  | TK29
 |  | L1 | M1 | L2 |  | M2 | TK30
 |  | L1 | L2 | L3 | L4 | M2 | TK31
 |  | M1 | L1 | L2 | L1 | M2 | TK32
 |  | M1 | L1 |  | L2 | M2 | TK33
 |  | L2 | L1 | L3 | M2 |  | TK34
 |  | L2 | L1 | L3 | M2 | L4 | TK35
 |  | L1 | M1 | L2 | M2 | L3 | TK36
 |  | L1 | M | L2 |  | L3 | TK37
 |  | L2 | L1 | L3 | M1 | M2 | TK38
 |  | L1 | L4 | L2 | L3 | L6 | TK39
 |  | M1 | L1 | L3 | L2 | M2 | TK40
 |  | L1 | L2 | L3 | L4 | L5 | TK41
 |  |  | X | L | D |  | TK42
 |  | M1 | L1 | L2 | L3 | M2 | TK43
 |  | L1 | L2 | L3 | L4 | M2 | TK44
 |  | TKT UNKNOWN |  |  |  |  | TKTUnknown

Sheet: TKT_DCE
BẢNG THỐNG KÊ CỐT THÉP |  |  |  |  |  |  |  |  |  |  |  |  |  |  |  |  |  |  |  |  |  |  |  |  |  |  |  |  |  | Thép có đường kính
TÊN CẤU KIỆN | SỐ HIỆU | HÌNH DÁNG, KÍCH THƯỚC |  |  |  |  |  |  |  |  |  |  |  |  |  |  |  |  |  |  |  | Ø (mm) | CHIỀU DÀI THANH | SỐ C.KIỆN | SỐ LƯỢNG |  | TỔNG CHIỀU DÀI | TỔNG KHỐI LƯỢNG |  | Tổng chiều dài
 |  |  |  |  |  |  |  |  |  |  |  |  |  |  |  |  |  |  |  |  |  |  |  |  |  |  |  |  |  | Tổng khối lượng
 |  | Hình dạng . |  |  |  |  | Tên Hình dạng | L | L1 | L2 | L3 | L4 | L5 | L6 | M | M1 | M2 | D | X | handle thép | L nối |  | (mm) |  | 1 CK | T.BỘ | (m) | (kg)
T3B12 | 1 | TKT UNKNOWN |  |  | L=16900 |  | TKTUnknown | 0 | 0 | 0 | 0 | 0 | 0 | 0 | 0 | 0 | 0 | 0 | 0 |  |  | 18 | 16900 | 1 | 2 | 2 | 33.8 | 67.52 | - Thép có đường kính Ø6: Tổng chiều dài 486.33(m), Tổng khối lượng: 107.95(kg).
T3B12 | 2 |  |  | 15600 |  |  | TK1 | 15600 | 0 | 0 | 0 | 0 | 0 | 0 | 0 | 0 | 0 | 0 | 0 |  | 720 | 18 | 16320 | 1 | 2 | 2 | 32.64 | 65.2 | - Thép có đường kính Ø16: Tổng chiều dài 46(m), Tổng khối lượng: 72.61(kg).
T3B12 | 3 |  |  | 4500 |  |  | TK1 | 4500 | 0 | 0 | 0 | 0 | 0 | 0 | 0 | 0 | 0 | 0 | 0 |  | 720 | 18 | 4500 | 1 | 2 | 2 | 9 | 17.98 | - Thép có đường kính Ø18: Tổng chiều dài 308.78(m), Tổng khối lượng: 616.79(kg).
T3B12 | 4 |  |  | 2700 |  |  | TK1 | 2700 | 0 | 0 | 0 | 0 | 0 | 0 | 0 | 0 | 0 | 0 | 0 |  | 720 | 18 | 2700 | 1 | 2 | 2 | 5.4 | 10.79
T3B12 | 5 | 250 | 1500 | 305 | 1500 |  | TK15A | 0 | 250 | 1500 | 305 | 1500 | 0 | 0 | 0 | 0 | 0 | 0 | 0 |  | 720 | 18 | 3555 | 1 | 2 | 2 | 7.11 | 14.2
T3B12 | 6 |  | 4100 | 305 | 950 |  | TK11 | 0 | 4100 | 305 | 950 | 0 | 0 | 0 | 0 | 0 | 0 | 0 | 0 |  | 720 | 18 | 5355 | 1 | 2 | 2 | 10.71 | 21.39
T3B12 | 7 |  |  | 1750 |  | 250 | TK3 | 0 | 1750 | 250 | 0 | 0 | 0 | 0 | 0 | 0 | 0 | 0 | 0 |  | 720 | 18 | 2000 | 1 | 2 | 2 | 4 | 7.99
T3B12 | 8 | 65 |  | 150 |  | 350 | TK9 | 0 | 150 | 350 | 0 | 0 | 0 | 0 | 65 | 0 | 0 | 0 | 0 |  | 0 | 6 | 1130 | 1 | 48 | 48 | 54.24 | 12.04
T3B12 | 9 | 65 |  | 150 |  | 400 | TK9 | 0 | 150 | 400 | 0 | 0 | 0 | 0 | 65 | 0 | 0 | 0 | 0 |  | 0 | 6 | 1230 | 1 | 73 | 73 | 89.79 | 19.93
T3B14 | 1 | 300 |  | 4800 |  | 300 | TK4 | 0 | 300 | 4800 | 300 | 0 | 0 | 0 | 0 | 0 | 0 | 0 | 0 |  | 640 | 16 | 5400 | 1 | 2 | 2 | 10.8 | 17.05
T3B14 | 2 |  |  | 4800 |  |  | TK1 | 4800 | 0 | 0 | 0 | 0 | 0 | 0 | 0 | 0 | 0 | 0 | 0 |  | 640 | 16 | 4800 | 1 | 2 | 2 | 9.6 | 15.15
T3B14 | 3 | 65 |  | 150 |  | 350 | TK9 | 0 | 150 | 350 | 0 | 0 | 0 | 0 | 65 | 0 | 0 | 0 | 0 |  | 0 | 6 | 1130 | 1 | 34 | 34 | 38.42 | 8.53
T3B15 | 1 | TKT UNKNOWN |  |  | L=16900 |  | TKTUnknown | 0 | 0 | 0 | 0 | 0 | 0 | 0 | 0 | 0 | 0 | 0 | 0 |  |  | 18 | 16900 | 1 | 2 | 2 | 33.8 | 67.52
T3B15 | 2 |  |  | 15600 |  |  | TK1 | 15600 | 0 | 0 | 0 | 0 | 0 | 0 | 0 | 0 | 0 | 0 | 0 |  | 720 | 18 | 16320 | 1 | 2 | 2 | 32.64 | 65.2
T3B15 | 3 |  |  | 4500 |  |  | TK1 | 4500 | 0 | 0 | 0 | 0 | 0 | 0 | 0 | 0 | 0 | 0 | 0 |  | 720 | 18 | 4500 | 1 | 2 | 2 | 9 | 17.98
T3B15 | 4 |  |  | 3200 |  |  | TK1 | 3200 | 0 | 0 | 0 | 0 | 0 | 0 | 0 | 0 | 0 | 0 | 0 |  | 720 | 18 | 3200 | 1 | 2 | 2 | 6.4 | 12.78
T3B15 | 5 |  |  | 1250 |  | 250 | TK3 | 0 | 1250 | 250 | 0 | 0 | 0 | 0 | 0 | 0 | 0 | 0 | 0 |  | 720 | 18 | 1500 | 1 | 2 | 2 | 3 | 5.99
T3B15 | 6 | 250 | 1500 | 305 | 1500 |  | TK15A | 0 | 250 | 1500 | 305 | 1500 | 0 | 0 | 0 | 0 | 0 | 0 | 0 |  | 720 | 18 | 3555 | 1 | 2 | 2 | 7.11 | 14.2
T3B15 | 7 |  | 4100 | 305 | 1150 |  | TK11 | 0 | 4100 | 305 | 1150 | 0 | 0 | 0 | 0 | 0 | 0 | 0 | 0 |  | 720 | 18 | 5555 | 1 | 2 | 2 | 11.11 | 22.19
T3B15 | 8 | 65 |  | 150 |  | 350 | TK9 | 0 | 150 | 350 | 0 | 0 | 0 | 0 | 65 | 0 | 0 | 0 | 0 |  | 0 | 6 | 1130 | 1 | 48 | 48 | 54.24 | 12.04
T3B15 | 9 | 65 |  | 150 |  | 400 | TK9 | 0 | 150 | 400 | 0 | 0 | 0 | 0 | 65 | 0 | 0 | 0 | 0 |  | 0 | 6 | 1230 | 1 | 73 | 73 | 89.79 | 19.93
T3B16 | 1 | TKT UNKNOWN |  |  | L=16900 |  | TKTUnknown | 0 | 0 | 0 | 0 | 0 | 0 | 0 | 0 | 0 | 0 | 0 | 0 |  |  | 18 | 16900 | 1 | 2 | 2 | 33.8 | 67.52
T3B16 | 2 |  |  | 15600 |  |  | TK1 | 15600 | 0 | 0 | 0 | 0 | 0 | 0 | 0 | 0 | 0 | 0 | 0 |  | 720 | 18 | 16320 | 1 | 2 | 2 | 32.64 | 65.2
T3B16 | 3 |  |  | 4500 |  |  | TK1 | 4500 | 0 | 0 | 0 | 0 | 0 | 0 | 0 | 0 | 0 | 0 | 0 |  | 720 | 18 | 4500 | 1 | 2 | 2 | 9 | 17.98
T3B16 | 4 |  |  | 3200 |  |  | TK1 | 3200 | 0 | 0 | 0 | 0 | 0 | 0 | 0 | 0 | 0 | 0 | 0 |  | 720 | 18 | 3200 | 1 | 2 | 2 | 6.4 | 12.78
T3B16 | 5 |  |  | 1250 |  | 250 | TK3 | 0 | 1250 | 250 | 0 | 0 | 0 | 0 | 0 | 0 | 0 | 0 | 0 |  | 720 | 18 | 1500 | 1 | 2 | 2 | 3 | 5.99
T3B16 | 6 | 250 | 1500 | 305 | 1500 |  | TK15A | 0 | 250 | 1500 | 305 | 1500 | 0 | 0 | 0 | 0 | 0 | 0 | 0 |  | 720 | 18 | 3555 | 1 | 2 | 2 | 7.11 | 14.2
T3B16 | 7 |  | 4100 | 305 | 1150 |  | TK11 | 0 | 4100 | 305 | 1150 | 0 | 0 | 0 | 0 | 0 | 0 | 0 | 0 |  | 720 | 18 | 5555 | 1 | 2 | 2 | 11.11 | 22.19
T3B16 | 8 | 65 |  | 150 |  | 350 | TK9 | 0 | 150 | 350 | 0 | 0 | 0 | 0 | 65 | 0 | 0 | 0 | 0 |  | 0 | 6 | 1130 | 1 | 48 | 48 | 54.24 | 12.04
T3B16 | 9 | 65 |  | 150 |  | 400 | TK9 | 0 | 150 | 400 | 0 | 0 | 0 | 0 | 65 | 0 | 0 | 0 | 0 |  | 0 | 6 | 1230 | 1 | 73 | 73 | 89.79 | 19.93
T3B17 | 1 | 300 |  | 1700 |  | 300 | TK4 | 0 | 300 | 1700 | 300 | 0 | 0 | 0 | 0 | 0 | 0 | 0 | 0 |  | 640 | 16 | 2300 | 1 | 2 | 2 | 4.6 | 7.26
T3B17 | 2 |  |  | 1700 |  |  | TK1 | 1700 | 0 | 0 | 0 | 0 | 0 | 0 | 0 | 0 | 0 | 0 | 0 |  | 640 | 16 | 1700 | 1 | 2 | 2 | 3.4 | 5.37
T3B17 | 3 | 65 |  | 150 |  | 350 | TK9 | 0 | 150 | 350 | 0 | 0 | 0 | 0 | 65 | 0 | 0 | 0 | 0 |  | 0 | 6 | 1130 | 1 | 14 | 14 | 15.82 | 3.51
T3B18 | 1 | 300 |  | 4100 |  | 300 | TK4 | 0 | 300 | 4100 | 300 | 0 | 0 | 0 | 0 | 0 | 0 | 0 | 0 |  | 640 | 16 | 4700 | 1 | 2 | 2 | 9.4 | 14.84
T3B18 | 2 |  |  | 4100 |  |  | TK1 | 4100 | 0 | 0 | 0 | 0 | 0 | 0 | 0 | 0 | 0 | 0 | 0 |  | 640 | 16 | 4100 | 1 | 2 | 2 | 8.2 | 12.94

Sheet: ToiUuCatThep
BẢNG TỔNG HỢP THÉP |  |  |  |  |  | BẢNG TỔNG HỢP SƠ ĐỒ CẮT THÉP |  |  |  |  |  |  | TỔNG HỢP LƯỢNG THÉP THỪA CẤT KHO |  |  |  |  |  | TỔNG HỢP THÉP CẮT VỤN |  |  |  |  |  | SS KL THÉP THỰC TẾ VÀ KL THÉP THIẾT KẾ |  |  |  |  | KL DC có L >=3000 mm |  | KL DC có 3000>L >=2000 mm
Stt | Tên Ck | Số hiệu | Đường kính | Số lượng | Chiều dài | Đường kính | Lần cắt | Sơ đồ cắt thép | Số lượng | Chiều dài | L thép dùng | Đoạn thừa | Stt | Đường kính | Lần cắt | Số đoạn thừa | Chiều dài |  | Stt | Đường kính | Lần cắt | Số đoạn thừa | Chiều dài | Khối lượng | Đường kính | KL Thiết kế | Khối lượng thực | Khối lượng thép cất kho | Khối lượng thép vụn | 3000 | % hao hụt | 2000 | % hao hụt
1 | DA.C-3 | DA.C-3 # 6 | 10 | 102 | 590 | 32 | 1 | 1*[DA.C-11][DA.C-11 # 7]4725 + 1*[DA.C-7][DA.C-7 # 10]1290 + 1*[DA.C-4][DA.C-4 # 11]2090 + 1*[DA.C-3][DA.C-3 # 1.3]3620 | 10 | 11725 | 11700 | -25 | 1 | 32 | 1293 | 5 | 1980 | 62.50 | 1 | 32 | 972 | 4 | 5 | 0.1262668919 | (1) | (2) | (3) | - | - | (4) | (5)=(3)-(4)/(2) | (6) | (7)=(3)-(4)-(6)/(2)
2 | DA.C-6 | DA.C-6 # 6 | 10 | 264 | 790 | 32 | 2 | 1*[DA.C-11][DA.C-11 # 7]4725 + 1*[DA.C-11][DA.C-11 # 2.1]5710 + 1*[DA.C-7][DA.C-7 # 10]1290 | 10 | 11725 | 11700 | -25 | 2 | 32 | 1294 | 10 | 2000 | 126.27 | 2 | 32 | 973 | 2 | 10 | 0.1262668919 | 10 | 5387.55 | 5460.61 | 79.90 | 0.68 | 0.00 | 1.01 | 0.00 | 1.01
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
449 | DB.C-21 | DB.C-21 # 10 | 14 | 280 | 2170 | 32 | 449 | 1*[DB.C-13][DB.C-13 # 2.3]3170 + 1*[DA.C-34][DA.C-34 # 3]5460 + 1*[DA.C-13][DA.C-13 # 16]3090 | 4 | 11720 | 11700 | -20 |  |  |  |  |  |  | 41 | 18 | 2135 | 1 | 1000 | 1.997581689
450 | DB.C-21 | DB.C-21 # 11 | 14 | 50 | 10260 | 32 | 450 | 1*[DB.C-13][DB.C-13 # 11]1090 + 1*[DB.C-4][DB.C-4 # 4]4430 + 1*[DA.C-26][DA.C-26 # 2.4]6200 | 1 | 11720 | 11700 | -20 |  |  |  |  |  |  | 42 | 18 | 2136 | 6 | 1050 | 12.58476464
451 | DA.C-1 | DA.C-1 # 9.1 | 16 | 194 | 7370 | 32 | 451 | 1*[DB.C-13][DB.C-13 # 11]1090 + 1*[DC.C-13][DC.C-13 # 4.5]6730 + 1*[DA.C-19][DA.C-19 # 2.3]3900 | 2 | 11720 | 11700 | -20 |  |  |  |  |  |  | 43 | 18 | 2137 | 24 | 1050 | 50.33905856
452 | DA.C-1 | DA.C-1 # 9.2 | 16 | 194 | 4030 | 32 | 452 | 1*[DB.C-13][DB.C-13 # 11]1090 + 1*[DB.C-3][DB.C-3 # 5]4780 + 1*[DA.C-16][DA.C-16 # 1.4]5850 | 3 | 11720 | 11700 | -20 |  |  |  |  |  |  | 44 | 18 | 2138 | 12 | 1050 | 25.16952928
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
