Lightingsang/AddinRebar/plans/260919-1910-materialdesign-xaml-adoption/reports/s0b-order-a/geo-dark-combo-open.png

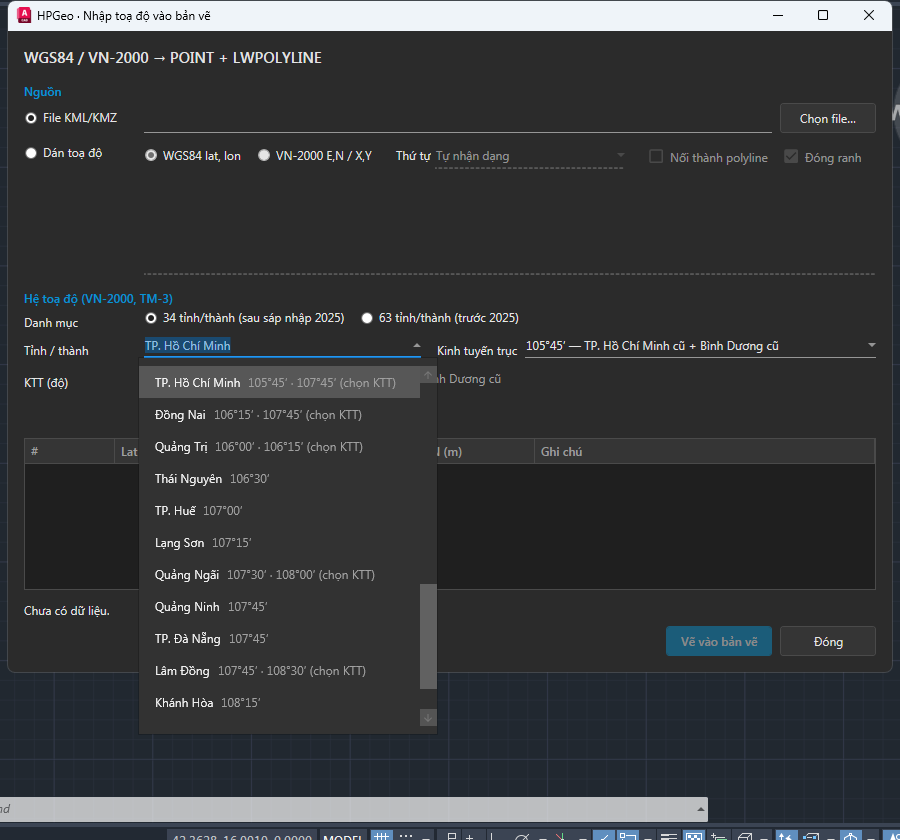
plans/260919-1910-materialdesign-xaml-adoption/reports/s0b-order-a/geo-dark-combo-open.png
