Lightingsang/AddinRebar/plans/260919-1910-materialdesign-xaml-adoption/reports/s0b-order-b/bridge-dark.png

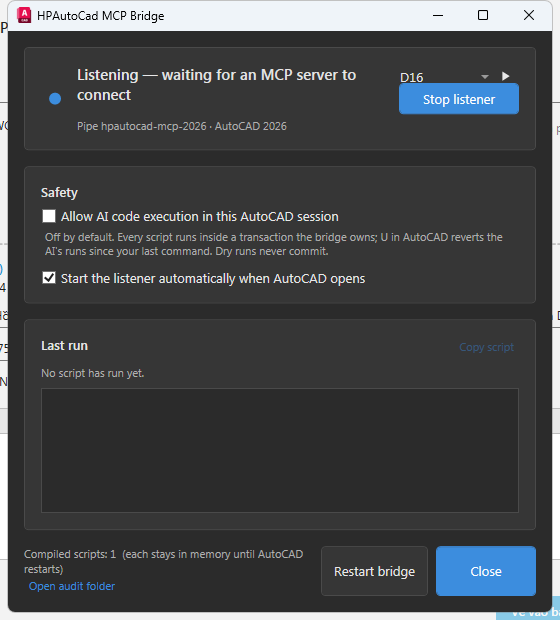
plans/260919-1910-materialdesign-xaml-adoption/reports/s0b-order-b/bridge-dark.png
