Lightingsang/AddinRebar/(list of files, cad)

Other CAD files:
HPDcePro/assets/AutoStr/00.FileDungChung/BlockTenBanVe.dwg
HPDcePro/assets/Cad/Form 1_Steel.dwg
HPKata/Distribution/Assets/Iso_kata.dwg
scratch/MatBang_DaKieng.dwg
HPDcePro/assets/AutoStr/00.FileDungChung/Khung A3.dwg
HPDcePro/assets/Cad/Form 3.dwg
HPDcePro/assets/AutoStr/00.FileDungChung/GhiChuChung 5574 _ A3.dwg
HPDcePro/assets/Cad/Form 2_Steel.dwg
HPDcePro/assets/AutoStr/00.FileDungChung/Chi Tiet Coc 250x250.dwg
HPDcePro/assets/Cad/Form 2_2_Circle3.2.dwg
HPDcePro/assets/Cad/Form 2_2.dwg
HPDcePro/assets/Cad/Form 5.dwg
HPDcePro/assets/Cad/Form 4.dwg
HPDcePro/assets/Cad/Form 1.dwg
HPDcePro/assets/Cad/Form 5_Steel.dwg
HPDcePro/assets/Cad/Form 2_Circle3.2.dwg
HPDcePro/assets/Cad/Form 3_Steel.dwg
HPDcePro/assets/Cad/Form 4_Steel.dwg
HPDcePro/assets/Cad/Form 2.dwg
