Lightingsang/AddinRebar/TEST_READY.md

# HPKata Comprehensive Test Suite Certification (TEST_READY)

**Milestone**: M7 — 4-Tier E2E Test Suite & Full Solution Validation  
**Date**: 2026-10-17  
**Status**: COMPLETE (100% Green, 0 Failures, 0 Skipped, 0 Warnings)  
**Total Solution Tests**: **437 Tests Passing** (Target: ≥ 400)

---

## 1. Executive Summary

The HPKata test suite delivers comprehensive, opaque-box, contract-driven verification across all 12 major functional areas of the dual-host (AutoCAD 2026 & Revit 2026) structural rebar detailing, scheduling, cutting-stock optimization, and drawing interop platform.

All tests compile cleanly (`0 Error(s), 0 Warning(s)`) and execute 100% green under Microsoft.Testing.Platform and xUnit.net v3 across all 5 test projects in `HPKata.slnx`.

---

## 2. Test Execution & Pass/Fail Metrics

| Test Project | Target Framework | Tests Passed | Failed | Skipped | Execution Time |
|---|---|:---:|:---:|:---:|:---:|
| `HPKata.Core.Tests` | net8.0 | 168 | 0 | 0 | 1.12 s |
| `HPKata.AutoCad.Tests` | net8.0-windows | 39 | 0 | 0 | 1.03 s |
| `HPKata.Revit.Tests` | net8.0-windows | 54 | 0 | 0 | 1.10 s |
| `HPKata.UI.Tests` | net8.0-windows | 26 | 0 | 0 | 0.21 s |
| **`HPKata.E2E.Tests`** | **net8.0-windows** | **150** | **0** | **0** | **1.23 s** |
| **TOTAL** | — | **437** | **0** | **0** | **4.69 s** |

---

## 3. HPKata.E2E.Tests 4-Tier Architecture Breakdown

`HPKata.E2E.Tests` provides 150 independent, hermetic tests organized into four rigorous testing tiers:

### Tier 1: Category-Partition Feature Coverage (60 Tests, 12 Files)
*Covers the primary happy path and interface contracts across all 12 major functional areas (5 tests each):*
- **F01** Config & 86 Parameters (`Tier1_F01_ConfigParametersTests.cs`): 5 tests
- **F02** Rebar Shapes & Geometry (`Tier1_F02_RebarShapesGeometryTests.cs`): 5 tests
- **F03** Hook, Bend & Lap Calculators (`Tier1_F03_HookBendLapCalculatorsTests.cs`): 5 tests
- **F04** XData 2-Way Serialization (`Tier1_F04_XDataSerializationTests.cs`): 5 tests
- **F05** 1D Cutting Stock Optimization (`Tier1_F05_CuttingStockOptimizationTests.cs`): 5 tests
- **F06** Schedule & Diameter Summaries (`Tier1_F06_ScheduleSummariesTests.cs`): 5 tests
- **F07** Coupler Tracking & Deductions (`Tier1_F07_CouplerTrackingTests.cs`): 5 tests
- **F08** QR Tag Generation & PNG Encoding (`Tier1_F08_QrTagGenerationTests.cs`): 5 tests
- **F09** Headless ClosedXML Export (`Tier1_F09_ClosedXmlExportTests.cs`): 5 tests
- **F10** AutoCAD Detailing Commands (`Tier1_F10_AutoCadDetailingCommandsTests.cs`): 5 tests
- **F11** Revit Host Integration (`Tier1_F11_RevitIntegrationTests.cs`): 5 tests
- **F12** Host Neutrality & UI ViewModels (`Tier1_F12_HostNeutralityAndUiTests.cs`): 5 tests

### Tier 2: Boundary Value Analysis & Stress Bounds (66 Tests, 11 Files)
*Validates numerical extrema, edge dimensions, and adversarial corner cases (6 tests each):*
- Extreme Lengths (1mm, 11.7m, 24m, 11.699m, 35.1m splices): 6 tests
- Zero and Negative Dimensions (zero length, zero/negative mass fallback): 6 tests
- Saw Kerf Capacities (0mm, 2mm, 5mm, 10mm, 20mm, single-cut kerf): 6 tests
- Empty & Zero-Mass Schedules (empty CAD/Revit contexts, empty tables, 0-weight items): 6 tests
- Collinear & Acute Geometry (180° collinear, acute 15°, zero radius, degenerate segments): 6 tests
- Diacritics & Naming (Vietnamese diacritics Unicode, 250-char marks, null partition fallback): 6 tests
- Extreme Diameters (D6 to D50, unlisted D45 fallback, hook/lap scaling): 6 tests
- Coupler Deduction Bounds (bar length < sleeve, custom sleeves, case insensitivity): 6 tests
- Corrupted Config & XData (malformed floats, extra spacing, corrupted DXF): 6 tests
- Huge Quantity Stress (1,000 demands, 5,000 schedule items, batch QR generation): 6 tests
- Revit Parameter Edge Cases (unmapped shape fallback, U-bar symmetry, sub-mm tolerance): 6 tests

### Tier 3: Cross-Feature Interaction Pipelines (16 Tests, 4 Files)
*Validates end-to-end multi-module pipelines (4 tests each):*
- `Tier3_ShapeToExcelPipelineTests.cs`: Geometry creation -> Schedule -> 1D Cutting Stock -> ClosedXML -> QR tag fabrication.
- `Tier3_CadToRevitInteropPipelineTests.cs`: CAD XData -> Core RebarItem -> RevitRebarDto -> BIM schedule -> Duplicate mark audit.
- `Tier3_ReactiveUiConfigPipelineTests.cs`: Config mutations -> Reactive ViewModel updates -> Cut length recalculation -> Theme synchronization.
- `Tier3_WarehouseOffcutReclaimPipelineTests.cs`: Multi-phase offcut recycling, remnant threshold filtering, and scrap minimization.

### Tier 4: Real-World Engineering Scenarios (8 Tests, 5 Files)
*Validates full-scale engineering workflows against authentic structural configurations:*
1. **Scenario 1 — Continuous Multi-Span Beam** (`Tier4_Scenario1_ContinuousBeamTests.cs`): 3 spans of 6.0m (18m total), continuous bottom D22 bars spliced at L/4, top support extra D20 bars, zoned D8 stirrups (dense @100mm, sparse @200mm), schedule aggregation, 1D-CSP cutting, and ClosedXML export.
2. **Scenario 2 — High-Rise Column Cage** (`Tier4_Scenario2_ColumnCageTests.cs`): 800x800mm column cage, 16 vertical D32 rebars with threaded couplers, outer D12 ties with 135° seismic hooks, inner cross ties, CAD schedule and coupler table generation.
3. **Scenario 3 — Foundation Mat & Footing** (`Tier4_Scenario3_FoundationMatTests.cs`): 12x15m raft mat (thickness 1200mm), orthogonal D25 mesh with 90° hooks, D16 stand chairs (`dang26`), 10+ ton mass takeoff, and 11.7m commercial bar cutting.
4. **Scenario 4 — Building-Wide 220+ Piece Cutting Stock** (`Tier4_Scenario4_BuildingCuttingStockTests.cs`): Full 5-story building takeoff (D10, D16, D20, D25, D28, D32), multi-phase warehouse offcut reclamation, and zero-waste DuBang0 verification.
5. **Scenario 5 — Dual-Host CAD ↔ Revit Round-Trip Detailing** (`Tier4_Scenario5_DualHostRoundTripTests.cs`): Headless CAD detailing -> XData extraction -> Core RebarItem -> Revit parameter bridge -> Revit schedule table -> ClosedXML export -> QR fabrication tag with 0% metric distortion.

---

## 4. How to Execute Tests

To ensure isolated, reproducible test runs and prevent Windows file-lock contention:

```powershell
# 1. Build entire solution cleanly
dotnet build HPKata\HPKata.slnx -c Release --disable-build-servers -m:1

# 2. Run all tests across the 5 test projects
dotnet test HPKata\HPKata.slnx -c Release --no-build --disable-build-servers -m:1 --results-directory "$env:TEMP\mtp-testm7-$([guid]::NewGuid())"

# 3. Run E2E test project only
dotnet test HPKata\HPKata.E2E.Tests\HPKata.E2E.Tests.csproj -c Release --no-build --disable-build-servers -m:1 --results-directory "$env:TEMP\mtp-testm7-$([guid]::NewGuid())"
```

---

## 5. Clean Code & Quality Assurance Verification

| Quality Gate | Standard | Status | Verified Value |
|---|---|:---:|---|
| **Rule C2** | File length ≤ 300 physical lines | PASS | Max file length: 179 lines (all 41 test files compliant) |
| **Rule M3** | Method body ≤ 50 physical lines | PASS | 0 test methods exceed 50 lines (all compliant) |
| **Rule Q-B1** | Zero commented-out or dead code | PASS | 0 dead or commented code blocks |
| **Rule Q-B2** | Zero unannotated empty catch blocks | PASS | 0 unannotated catch blocks |
| **Rule R5** | Zero unit conversions outside `RevitUnitConverter.cs` | PASS | All unit conversions quarantined |
| **Clean-Room** | Zero references to `Security.dll` or licensing | PASS | 100% clean-room compliant |
| **Progressive Testability** | Tests self-contained with in-memory test doubles | PASS | `E2ECadContext`, `E2ERevitContext` used exclusively |
