Lightingsang/AddinRebar/tests/skill-sync/fixtures/I-nested-discovery/claude/bundle/README.md

This container is not a skill because it has no SKILL.md.
