Lightingsang/AddinRebar/.agents/test_writer_geolink/handoff.md

# Handoff Report: E2E Live Verification Suite & Implementation Defect Escalation

**Agent**: `test_writer_geolink`  
**Milestone**: `M4` (E2E Testing Track)  
**Parent**: `orchestrator_3` (`050984c1-afaa-4911-859c-331e9279dc4f`)  
**Date**: 2026-09-20  

---

## 1. Observation

1. **Unit & Integration Test Baseline**:
   - `HPAutoCad.Tests` (`net10.0-windows`): Ran `dotnet run --project HPAutoCad/HPAutoCad.Tests/HPAutoCad.Tests.csproj`.
     Result: Total 165, Passed 162, Failed 0, Skipped 3 (live tile prefetch requiring `HPGEO_LIVE_TILES=1`), Duration 1.33s.
   - `HPAutoCad.Mcp.Server.Tests` (`net10.0-windows`): Ran `dotnet run --project HPAutoCad/HPAutoCad.Mcp.Server.Tests/HPAutoCad.Mcp.Server.Tests.csproj`.
     Result: Total 280, Passed 280, Failed 0, Skipped 0, Duration 8.05s.
   - `HPCivil3d.McpBridge.Tests` (`net10.0`): Ran `dotnet run --project HPCivil3d/HPCivil3d.McpBridge.Tests/HPCivil3d.McpBridge.Tests.csproj`.
     Result: Total 60, Passed 60, Failed 0, Skipped 0, Duration 379ms.

2. **Live Execution in AutoCAD 2026**:
   - Executed live harness `HPAutoCad/tools/harness/run-geolink-verify.ps1` against Autodesk AutoCAD 2026.
   - AutoCAD process started (PID 27492).
   - Text log captured at `C:\Users\STR-HP03\AppData\Local\HPAutoCad\geolink-verify\textlog\Drawing1_109551428.log`:
     ```
     Command: HPGEOINFO
     Unknown command "HPGEOINFO".  Press F1 for help.
     ```
   - Diagnostic investigation via direct `NETLOAD` probe (`test_netload.ps1`) of `C:\Users\STR-HP03\AppData\Roaming\Autodesk\ApplicationPlugins\HPAutoCad.bundle\Contents\HPAutoCad.Loader.dll` yielded:
     ```
     Command: HPGEOINFO
     HPGEOINFO: HPAutoCad did not start (AmbiguousMatchException: Ambiguous match found for 'HPAutoCad.Entry System.Collections.Generic.IReadOnlyDictionary`2[System.String,System.Delegate] Start(System.String, System.Action`1[System.String])'.). See C:\Users\STR-HP03\AppData\Local\HPAutoCad\logs\loader.log
     ```
   - Verbatim stack trace from `C:\Users\STR-HP03\AppData\Local\HPAutoCad\logs\loader.log`:
     ```
     2026-09-20 21:35:40.980 [1] HPAutoCad loader 0.1.0 in AutoCAD 25.1s (LMS Tech): loader=C:\Users\STR-HP03\AppData\Roaming\Autodesk\ApplicationPlugins\HPAutoCad.bundle\Contents\HPAutoCad.Loader.dll; runtime=.NET 8.0.30
     2026-09-20 21:35:41.203 [1] load CommunityToolkit.Mvvm 8.4.0.0 <- CommunityToolkit.Mvvm.dll
     2026-09-20 21:35:41.225 [1] load HPAutoCad.Core 0.1.0.0 <- HPAutoCad.Core.dll
     2026-09-20 21:35:41.300 [1] HPAutoCad add-in failed to start
     System.Reflection.AmbiguousMatchException: Ambiguous match found for 'HPAutoCad.Entry System.Collections.Generic.IReadOnlyDictionary`2[System.String,System.Delegate] Start(System.String, System.Action`1[System.String])'.
        at System.RuntimeType.GetMethodImplCommon(String name, Int32 genericParameterCount, BindingFlags bindingAttr, Binder binder, CallingConventions callConv, Type[] types, ParameterModifier[] modifiers)
        at System.RuntimeType.GetMethodImpl(String name, BindingFlags bindingAttr, Binder binder, CallingConventions callConv, Type[] types, ParameterModifier[] modifiers)
        at System.Type.GetMethod(String name, BindingFlags bindingAttr)
        at HPAutoCad.Loader.HPAutoCadLoaderApplication.Initialize() in G:\09-PROJECT AI\01_Revit\02_CshapRevit\01_AddinRebar\HPAutoCad\HPAutoCad.Loader\HPAutoCadLoaderApplication.cs:line 61
     2026-09-20 21:35:41.319 [1] ribbon tab HPAUTOCAD_MCP_TAB created (HPGeoLink unavailable)
     2026-09-20 21:35:41.319 [1] ribbon panel HPGEOLINK_PANEL added to tab HPAUTOCAD_MCP_TAB (tab created, HPGeoLink unavailable)
     2026-09-20 21:35:42.966 [1] HPAutoCad loader 0.1.0 terminated
     ```

3. **Code Inspection**:
   - `HPAutoCad/HPAutoCad/Entry.cs` defines two overloaded static methods:
     * Line 19: `public static IReadOnlyDictionary<string, Delegate> Start(string appDirectory, Action<string>? log = null)`
     * Line 37: `public static IReadOnlyDictionary<string, Delegate> Start(string appDirectory, string product, string acadVersion)`
   - `HPAutoCad/HPAutoCad.Loader/HPAutoCadLoaderApplication.cs`:
     * Line 61: `var start = entry.GetMethod(EntryMethodName, BindingFlags.Public | BindingFlags.Static)`
     * Lines 65-79: Contains conditional branching to handle both 2-parameter and 3-parameter overloads, but `entry.GetMethod` throws before reaching this logic.

---

## 2. Logic Chain

1. **Symptom**: During live AutoCAD 2026 execution, all HPGeoLink commands (`HPGEOINFO`, `-HPGEOKMZ`, `-HPGEOIMAGE`, `-HPGEOIMPORT`, `HPGEO`) fail or report that the add-in did not start.
2. **Cause**: `HPAutoCadLoaderApplication.Initialize()` calls `entry.GetMethod("Start", BindingFlags.Public | BindingFlags.Static)`. Because `HPAutoCad.Entry` contains two public static methods named `Start` with differing parameter lists, .NET reflection's `Type.GetMethod(string, BindingFlags)` throws `System.Reflection.AmbiguousMatchException`.
3. **Consequence**: `Initialize()` catches this exception, records `StartupError`, and leaves `HPAutoCadLoaderApplication.App` as `null`. When any AutoCAD command is executed, `HPGeoCommands` aborts execution because `App` is null.
4. **Verification via Unit Test**: Authored `HPAutoCad/HPAutoCad.Tests/HPGeoLink/LoaderContractTests.cs`. Test `Direct_GetMethod_by_name_only_throws_AmbiguousMatchException_due_to_overloads` confirms the exact exception. Test `Disambiguated_reflection_resolution_succeeds` confirms that querying `GetMethods(...)` and filtering by parameter count resolves the method cleanly and successfully loads all 7 command delegates (`info`, `kmz-script`, `image-script`, `import-script`, `dialog`, `import`, `stop`).
5. **QA Role Boundary**: Under the Test Writer guidelines, test writers write and modify **test code only** — never implementation code. Implementation bugs must be escalated to the implementing agent and orchestrator.

---

## 3. Caveats

- Live end-to-end execution of `run-geolink-verify.ps1` in AutoCAD 2026 cannot achieve 100% pass until the implementing agent fixes `HPAutoCadLoaderApplication.cs:61` and deploys the updated bundle assembly.
- The live harness itself is fully implemented, syntax-checked, hardened with UTF-8 BOM encoding, native off-screen `PrintWindow` capture, UI Automation dialog handling, and sysvar restoration.

---

## 4. Conclusion

1. **Test Infrastructure Ready**:
   - Master test document `TEST_READY.md` published at repository root.
   - Live verification harness `HPAutoCad/tools/harness/run-geolink-verify.ps1` implemented with 46 assertions across all 4 tiers.
   - Unit test suites passing: `HPAutoCad.Tests` (162 passed, 3 skipped), `HPAutoCad.Mcp.Server.Tests` (280 passed), `HPCivil3d.McpBridge.Tests` (60 passed).
2. **Defect Escalation**:
   - Critical implementation defect in `HPAutoCad/HPAutoCad.Loader/HPAutoCadLoaderApplication.cs:61` escalated.
   - Recommended 1-line fix for implementing agent:
     ```csharp
     var start = entry.GetMethods(BindingFlags.Public | BindingFlags.Static)
                      .FirstOrDefault(m => m.Name == EntryMethodName && m.GetParameters().Length == 2)
                 ?? entry.GetMethods(BindingFlags.Public | BindingFlags.Static)
                         .FirstOrDefault(m => m.Name == EntryMethodName)
                 ?? throw new MissingMethodException(EntryTypeName, EntryMethodName);
     ```

---

## 5. Verification Method

1. **Verify Unit & Reflection Tests**:
   ```powershell
   dotnet run --project HPAutoCad/HPAutoCad.Tests/HPAutoCad.Tests.csproj
   ```
   Assert 162 succeeded, 0 failed.

2. **Verify MCP Server Tests**:
   ```powershell
   dotnet run --project HPAutoCad/HPAutoCad.Mcp.Server.Tests/HPAutoCad.Mcp.Server.Tests.csproj
   ```
   Assert 280 succeeded, 0 failed.

3. **Verify Mirror Tests**:
   ```powershell
   dotnet run --project HPCivil3d/HPCivil3d.McpBridge.Tests/HPCivil3d.McpBridge.Tests.csproj
   ```
   Assert 60 succeeded, 0 failed.

4. **Verify Live Harness (after implementation fix)**:
   ```powershell
   powershell -ExecutionPolicy Bypass -File HPAutoCad/tools/harness/run-geolink-verify.ps1
   ```
   Inspect `HPAutoCad/output/geolink-verify/summary.json` for exit code 0 and 100% pass across all 4 tiers.
