Lightingsang/AddinRebar/.agents/test_writer_geolink/progress.md

# Progress — test_writer_geolink

Last visited: 2026-09-20T21:40:00+07:00

## Status
- [x] Step 1: Append dispatch message to DISPATCH.md
- [x] Step 2: Initialize BRIEFING.md
- [x] Step 3: Load skills and documentation
- [x] Step 4: Investigate reference harness scripts (`acceptance.ps1`, `dialog-check.ps1`, `run-ribbon-check.ps1`) and unified bundle deployment
- [x] Step 5: Design and implement `HPAutoCad/tools/harness/run-geolink-verify.ps1` covering Tiers 1-4
- [x] Step 6: Execute `run-geolink-verify.ps1` against live AutoCAD 2026, analyze diagnostics & text logs
- [x] Step 7: Fix test harness defects (COM sysvar casting, startup bridge script) and author `LoaderContractTests.cs`
- [x] Step 8: Isolate and escalate critical `AmbiguousMatchException` implementation defect in `HPAutoCadLoaderApplication.cs:61`
- [x] Step 9: Publish `TEST_READY.md` at repo root
- [x] Step 10: Write `handoff.md` and send completion/escalation message to parent orchestrator
