Lightingsang/AddinRebar/docs/journals/2026-09-17-etabs-mcp-phases-1-4-verified-live.md

# 2026-09-17 — ETABS MCP phases 1–4: a fourth host with no transaction, verified live

## What landed

- `HPEtabs/` (plan `plans/260916-2152-etabs-mcp-2026/`, phases 1–4 in one day on top of the 2026-09-16 engine phase 0): a standalone
  WPF bridge app holding the one COM attachment to ETABS 22, a net10 stdio server, 12 embedded seeds, and a live harness that drives
  the whole chain — Claude Code → server → pipe → bridge → COM → ETABS — from the publish folders: `-Phase full -Publish -Runs 3`
  → 3 × 102 checks pass. Commits 555f3df (phase 1), a8c867b + 2d66951 (phase 2), 185f244 (phase 3), phase 4 pending commit.
- Each phase had a code review the same day (6.5 / 6.5 / 7 out of 10, all fix-first) and every finding was applied before the commit.

## Decisions worth remembering

- **No transaction means "refuse before, not roll back after".** ETABS cannot undo anything, so the tier of a script is decided
  before it runs — from a 1 281-row allow-list generated by reflection over the installed wrapper and bound *semantically*
  (Roslyn's own symbols, so aliases, casts, lambdas and method groups resolve to the same `cInterface.Member`; anything unbound
  is destructive). A writing run saves the model and copies a `.EDB` snapshot first; a destructive one needs a second checkbox
  and is otherwise a JSON-RPC `-32001`, never a tool run — so a user's refusal can never quarantine a seed.
- **The registry's stability rule shapes error types.** A defined-but-not-run load case is the caller's to fix (run the analysis or
  pick another case), so the results seeds throw `ArgumentException`, not `InvalidOperationException` — otherwise five innocent
  "reactions before analysis?" questions would quarantine `get_joint_reactions`. Phase 4's shared-registry runs proved exactly that.
- **Path policy is two-pass by necessity.** The pipe thread knows nothing about the model folder; it refuses the shapes it cannot read
  (`args.Str(key, fallback)`, a shadowed `ScriptArgs`, concatenation) and the folders that are always wrong; the worker, which knows
  the model, refuses everything outside the model folder or `%LocalAppData%\HPEtabs` on the normalised path.
- **`#r`/`#load` were an engine hole for every host.** Directives are trivia the guard's syntax walker never visited, while the script
  compiler honoured them: a DLL from disk ran as tier R. Four lines in `ScriptGuard.Check`, two engine tests, all host suites green.

## What surprised us

- `File.Save(path)` is a save-as: it re-points the model and thereafter `GetModelFilename` returns the `.$et` working copy.
- `AddByCoord` creates the frame **and** its two points (`changed.added` = 3); deleting the frame orphan-deletes the points (−6).
- Unlocking the model discards every analysis result — the phase-1 open item, closed by a harness check.
- An ETABS started "some other way" has no running-object-table entry at all (`GetObject` and `GetObjectProcess` both null, the
  Tools menu item greyed); started from its shortcut and then File › Open, it registers at once. Root cause unproven.
- Reactions of a W14X500 column 3 m tall came back as 21.9 kN — the self-weight to three digits. The most convincing check of the day.
- Windows upper-cases `os.environ` keys; `dict(os.environ)["HPETABS_MCP_Registry__LibraryPath"]` is a KeyError while .NET binds it fine.

## Not done

Kill ETABS in the middle of a call, a second licence seat, restoring a snapshot in the GUI, `run_analysis` on a real project, the
skip path of the compile tests on a machine without ETABS, ETABS 21/23, `export_table` / `restore_model_snapshot` seeds.
