Lightingsang/AddinRebar/plans/reports/tester-2026-09-16-autocad-ribbon-revit-style.md

# Test Verification Report: AutoCAD MCP Ribbon Refactor to Revit-Style

**Date:** 2026-09-16 | **Scope:** Build + unit tests + PowerShell static check + grep for stale references

---

## Build Status

| Config | Warnings | Errors | Time | Status |
|---|---|---|---|---|
| Debug  | 0 | 0 | 4.0s | ✅ PASS |
| Release| 0 | 0 | 9.6s | ✅ PASS |

**Notes:** No NETSDK1206 or any other warnings. Both configurations build cleanly.

---

## Unit Test Execution

| Test Project | Framework | Total | Passed | Failed | Skipped | Time | Status |
|---|---|---|---|---|---|---|---|
| HPAutoCad.Mcp.Server.Tests | xUnit v3 | 58 | 58 | 0 | 0 | 4.6s | ✅ PASS |
| HPRebar.Mcp.Server.Core.Tests (engine) | xUnit v3 | 128 | 128 | 0 | 0 | 5.3s | ✅ PASS |

**Notes:**
- AutoCAD tests confirmed via direct exe run: `HPAutoCad.Mcp.Server.Tests.exe` produced complete output with all 58 passed
- Engine tests (McpShared) untouched by ribbon refactor; all 128 pass as expected
- xUnit v3 warnings about `CancellationToken` (xUnit1051) in engine tests are pre-existing, not introduced by this change

---

## Static Analysis

### PowerShell Script Parse Check
**File:** `HPAutoCad/tools/harness/run-ribbon-check.ps1`  
**Result:** ✅ PARSE OK

**Logic review** (manual scan):
- No variables used before initialization (results, manual initialized line 21-22; acadPid set by Start-AcadWithBridge)
- Proper error handling with try-catch-finally (lines 44-112)
- AllowExecution checkbox uniqueness check for window counting (line 36) is correct design
- Workspace switch via SetVariable (not SendCommand) — correct per comment
- Log search `[bool]$created.Count -eq 0` correctly handles $null, single string, and array cases
- Process cleanup in finally block (line 111) always runs
- Exit codes (0 = pass, 1 = fail, 2 = fail with manual checks) correctly set (line 120)

**No logic issues detected.**

---

## Reference Cleanup Verification

**Grep patterns checked (HPAutoCad source trees, excluding obj/bin):**
- ~~`status.subscribe`~~ 
- ~~`copyLastScript`~~ 
- ~~`autoStart.get`~~ / ~~`autoStart.set`~~ 
- ~~`Query<`~~
- ~~`OpenPath`~~ 
- ~~`RibbonStatusPresenter`~~ 
- ~~`AddRibbonEntryPoints`~~ 
- ~~`MCP AutoCAD`~~ (old tab name)
- ~~`Bảng điều khiển`~~ (old Vietnamese tab name)

**Result:** ✅ ZERO MATCHES  
**Files scanned:** `.cs`, `.csproj`, `.xml` in HPAutoCad (Loader + Bridge projects)

Deleted files confirmed absent from git diff:
- ❌ `HPAutoCad.McpBridge.Loader/Ribbon/RibbonStatusPresenter.cs` (removed)
- ❌ `HPAutoCad.McpBridge/BridgeEntry.Ribbon.cs` (removed)

---

## Summary Table

| Checkpoint | Expected | Observed | Status |
|---|---|---|---|
| Build Debug | 0 warn, 0 err | 0 warn, 0 err | ✅ |
| Build Release | 0 warn, 0 err | 0 warn, 0 err | ✅ |
| AutoCAD tests | 58 pass | 58 pass | ✅ |
| Engine tests | 128 pass | 128 pass | ✅ |
| PowerShell parse | valid script | parse ok | ✅ |
| Stale references | none | none | ✅ |

---

## Concerns

None. Ribbon refactor is **complete, clean, and backward-compatible** with the shared engine (no engine tests changed; all pass). Live harnesses already ran (ribbon-check 10/10, bridge-unattended 21/21, server-smoke 22/22) by the controller.

---

**Status:** ✅ DONE  
**Summary:** All build, test, and cleanup checks pass. AutoCAD ribbon successfully refactored to one-button Revit-style surface with zero breaking changes to shared MCP engine or AutoCAD bridge logic.  
**Concerns/Blockers:** None.
