Lightingsang/AddinRebar/.agents/teamwork/explorer_m3_beams_fix/BRIEFING.md

# BRIEFING — 2026-10-07T06:42:00Z

## Mission
Investigate and author a mathematically verified fix for grade beam spans with cutback coordinate deviations and floating endpoints in Milestone M3.

## 🔒 My Identity
- Archetype: explorer
- Roles: investigator, geometry remediation analyst
- Working directory: G:\09-PROJECT AI\01_Revit\02_CshapRevit\01_AddinRebar\.agents\teamwork\explorer_m3_beams_fix
- Original parent: 22ab785c-b656-477d-a044-b5c03eddba16
- Milestone: M3

## 🔒 Key Constraints
- Read-only investigation — do NOT implement in production source code (write scripts/reports only in own directory)
- Adhere strictly to ĐIỀU 0: Nguyên Tắc Vàng (Zero Hallucination, Authentic CAD coordinates, Mathematical verification)
- Endpoints must snap directly to authentic footing polygon faces or column grid intersections matching KC-HT-90-TLTT-16.dwg
- No heuristic guessing; every coordinate must trace to CAD geometry

## Current Parent
- Conversation ID: 22ab785c-b656-477d-a044-b5c03eddba16
- Updated: 2026-10-07T06:40:58Z

## Investigation State
- **Explored paths**: None yet
- **Key findings**: None yet
- **Unexplored areas**: ORIGINAL_REQUEST.md, qaqc_m3_audit/handoff.md, reviewer_m3_2/handoff.md, worker_m3_foundation scripts and outputs, DWG source data

## Key Decisions Made
- Initialized briefing and workspace

## Artifact Index
- DISPATCH.md — Dispatch log
- BRIEFING.md — Persistent context
- progress.md — Liveness heartbeat
