Lightingsang/AddinRebar/.agents/teamwork/explorer_m3_fix_gen2/progress.md

# Progress — explorer_m3_fix_gen2

Last visited: 2026-10-06T02:45:00Z
Status: Completed

- [x] Received dispatch instructions and initialized BRIEFING.md
- [x] Reviewed Reviewer 2 handoff report (`reviewer_m3_2_gen2/handoff.md`)
- [x] Reviewed ORIGINAL_REQUEST.md for Milestone 3 requirements
- [x] Inspected existing implementations in `HPBim/src/HPBim.Client/`:
  - `CompositeBimGenerator.cs` (verified Stage 7 & 8 omitted)
  - `Stage7MepGenerator.cs` & `Stage8RebarGenerator.cs`
  - `Stage3StructureGenerator.cs`, `Stage4WallGenerator.cs`, `Stage5OpeningGenerator.cs`
  - `RevitPipeClient.cs` (verified 306 lines, unsynchronized ConnectAsync)
  - `RevitModelVerifier.cs` (verified CompareCounts is 58 lines)
  - `TypeResolutionRules.cs` (verified dead code)
- [x] Designed complete fix architecture:
  - Fix 1: `CompositeBimGenerator` 4-file partial class partitioning (each <= 120 lines, all methods <= 40 lines) with genuine Stage 7 & 8 integration
  - Fix 2: `RevitPipeClient` extraction of `PipeMessageReader` (~105 lines) + `SemaphoreSlim _connectLock`, reducing `RevitPipeClient` to ~190 lines (<= 220 limit)
  - Fix 3: `RevitModelVerifier` `CompareCounts` refactored to 7 lines using `ElementCounts` record struct (all helpers <= 22 lines, well under 35 limit)
  - Fix 4: `TypeResolutionRules` integration into `Stage5OpeningGenerator` + new unit test suite
  - Fix 5: Column top level, wall top level, and opening door/window fidelity aligned
- [x] Verified test compatibility and designed adversarial regression tests
- [x] Written comprehensive `handoff.md` blueprint for `worker_m3_fix_gen2`
- [x] Report completion to orchestrator via `send_message`
