Lightingsang/AddinRebar/.agents/teamwork/worker_m3_fix_gen2/BRIEFING.md

# BRIEFING — 2026-10-06T02:53:30Z

## Mission
Remediate Milestone 3 code quality and test coverage in HPBim.Client: extract PipeMessageReader, refactor RevitPipeClient with _connectLock, decompose CompareCounts in RevitModelVerifier, integrate TypeResolutionRules in Stage5OpeningGenerator, modularize CompositeBimGenerator into 4 partial classes (all 8 stages), add required unit tests, and verify build and tests pass.

## 🔒 My Identity
- Archetype: implementer
- Roles: implementer, qa, specialist
- Working directory: g:\09-PROJECT AI\01_Revit\02_CshapRevit\01_AddinRebar\.agents\teamwork\worker_m3_fix_gen2
- Original parent: 18c3ad8c-1fc9-42cc-83e7-40ab9000587e
- Milestone: Milestone 3 Remediation (M3 Iteration 2)

## 🔒 Key Constraints
- DO NOT CHEAT: Genuine implementations only, no hardcoded test outputs or dummy facades.
- All files in HPBim.Client must be <= 220 lines (strictly adhering to clean code limit <= 250 / <= 300).
- Methods must be <= 50 lines (CompareCounts <= 35 lines, refactored to ~7 lines).
- Build with /warnaserror must succeed with 0 warnings, 0 errors.
- All tests must pass in Release mode.

## Current Parent
- Conversation ID: 18c3ad8c-1fc9-42cc-83e7-40ab9000587e
- Updated: 2026-10-06T02:53:30Z

## Task Summary
- **What to build**: Executed all 7 remediation steps from explorer_m3_fix_gen2/handoff.md:
  1. PipeMessageReader.cs in Connection/ (113 lines)
  2. Refactored RevitPipeClient.cs with SemaphoreSlim _connectLock and delegated to PipeMessageReader (200 lines)
  3. Refactored RevitModelVerifier.cs (CompareCounts decomposed to 7 lines with ElementCounts helper methods, 164 lines)
  4. Integrated TypeResolutionRules into Stage5OpeningGenerator.cs (119 lines)
  5. Modularized CompositeBimGenerator into 4 partial classes with all 8 stages genuine logic (72, 120, 113, 168 lines)
  6. Unit tests added: TypeResolutionRulesTests.cs, CompositeBimGenerator 8 stages test in StageGeneratorTests.cs, Concurrency test in RevitPipeClientAdversarialTests.cs
  7. Build /warnaserror & dotnet test verification: 0 warnings, 0 errors, 216/216 passed.
- **Success criteria**: 0 build warnings/errors, 100% tests green, all files in HPBim.Client <= 200 lines (<= 220 target).
- **Interface contracts**: HP_CLEAN_CODE_CORE.md
- **Code layout**: HPBim/src/HPBim.Client/, HPBim/tests/HPBim.Client.Tests/

## Key Decisions Made
- Extracted PipeMessageReader to handle StreamReader loop, cancellation, and deserialization.
- Added _connectLock in RevitPipeClient guarding ConnectAsync and DisconnectAsync.
- Introduced ElementCounts record struct to cleanly decompose CompareCounts into 4 small helper methods.
- Wired TypeResolutionRules into Stage5OpeningGenerator and CompositeBimGenerator openings stage.
- Partitioned CompositeBimGenerator into 4 partial files to keep each file <= 168 lines while implementing all 8 stages.

## Artifact Index
- DISPATCH.md — Assignment instructions
- BRIEFING.md — This working memory file
- progress.md — Liveness heartbeat and status log
- handoff.md — Final handoff report

## Change Tracker
- **Files modified**:
  - `HPBim/src/HPBim.Client/Connection/PipeMessageReader.cs` (created, 113 lines)
  - `HPBim/src/HPBim.Client/Connection/RevitPipeClient.cs` (refactored, 200 lines)
  - `HPBim/src/HPBim.Client/Verification/RevitModelVerifier.cs` (refactored, 164 lines)
  - `HPBim/src/HPBim.Client/ScriptGenerators/Stage5OpeningGenerator.cs` (updated, 119 lines)
  - `HPBim/src/HPBim.Client/ScriptGenerators/CompositeBimGenerator.cs` (refactored entry point, 72 lines)
  - `HPBim/src/HPBim.Client/ScriptGenerators/CompositeBimGenerator.Stages1To3.cs` (created, 120 lines)
  - `HPBim/src/HPBim.Client/ScriptGenerators/CompositeBimGenerator.Stages4To6.cs` (created, 113 lines)
  - `HPBim/src/HPBim.Client/ScriptGenerators/CompositeBimGenerator.Stages7To8.cs` (created, 168 lines)
  - `HPBim/tests/HPBim.Client.Tests/TypeResolver/TypeResolutionRulesTests.cs` (created, 40 lines)
  - `HPBim/tests/HPBim.Client.Tests/ScriptGenerators/StageGeneratorTests.cs` (updated, 155 lines)
  - `HPBim/tests/HPBim.Client.Tests/Connection/RevitPipeClientAdversarialTests.cs` (updated, 248 lines)
- **Build status**: PASS (0 warnings, 0 errors with /warnaserror)
- **Pending issues**: None

## Quality Status
- **Build/test result**: PASS (216/216 passed, Release & Debug)
- **Lint status**: 0 warnings (/warnaserror)
- **Tests added/modified**: TypeResolutionRulesTests (3 facts), CompositeBimGenerator 8 stages test, Concurrency test (5 parallel connects)

## Loaded Skills
- None
