Lightingsang/AddinRebar/.agents/teamwork/worker_m3_fix_gen2/handoff.md

# Milestone 3 Remediation Handoff Report

**Agent**: `worker_m3_fix_gen2`  
**Roles**: implementer, qa, specialist  
**Target Recipient**: Orchestrator (`18c3ad8c-1fc9-42cc-83e7-40ab9000587e` / "parent")  
**Target Milestone**: Milestone 3 Iteration 2 (Remediation)  
**Status**: TASK_COMPLETE  

---

## 1. Observation

Reviewer 2 (`reviewer_m3_2_gen2/handoff.md`) and Explorer (`explorer_m3_fix_gen2/handoff.md`) identified 6 concrete defects in Milestone 3 code:
1. **Critical Integrity Violation in `CompositeBimGenerator.cs`**: `GetScriptCode()` omitted Stage 7 (MEP) and Stage 8 (Rebars). Atomic dry-run was incomplete.
2. **Major Clean Code Class Limit in `RevitPipeClient.cs`**: Measured at 306 lines (> 250 limit and > 300 hard ceiling).
3. **Major Concurrency Race in `RevitPipeClient.ConnectAsync`**: Concurrent invocations lacked synchronization, risking race conditions and connection leakage.
4. **Major Clean Code Method Limit in `RevitModelVerifier.CompareCounts`**: Spanned 58 lines (> 50 rule M3 ceiling and > 35 target).
5. **Minor Dead Code in `TypeResolutionRules.cs`**: `GetDoorSymbolName` and `GetWindowSymbolName` had 0 call sites.
6. **Minor Script Fidelity Gaps**: Missing top level binding for columns/walls, window sill height handling.

---

## 2. Logic Chain

All 7 blueprint steps from `explorer_m3_fix_gen2/handoff.md` were executed with genuine implementations:

1. **Created `PipeMessageReader.cs`** (`HPBim/src/HPBim.Client/Connection/PipeMessageReader.cs` - 113 lines):
   - Encapsulates background reading from `NamedPipeClientStream` using NDJSON framing and `StreamReader`.
   - Dispatches deserialized `JsonRpcEnvelope` messages to `_onMessageReceived` callback and handles graceful teardown / disconnection.
   - Cleanly implements `IDisposable` and `IAsyncDisposable`.

2. **Refactored `RevitPipeClient.cs`** (`HPBim/src/HPBim.Client/Connection/RevitPipeClient.cs` - 200 lines):
   - Added `SemaphoreSlim _connectLock = new(1, 1)` guarding both `ConnectAsync` and `DisconnectAsync`.
   - Delegated pipe background reading to `PipeMessageReader`.
   - Streamlined formatting so the entire file is exactly **200 lines** (well below the 220 limit and 250 ceiling).

3. **Refactored `CompareCounts` in `RevitModelVerifier.cs`** (`HPBim/src/HPBim.Client/Verification/RevitModelVerifier.cs` - 164 lines):
   - Introduced `private readonly record struct ElementCounts(...)`.
   - Decomposed `CompareCounts` into 4 small, single-responsibility helper methods:
     - `GetExpectedCounts(BimModel exp)` (17 lines)
     - `GetActualCounts(JsonElement el)` (6 lines)
     - `CheckAllDiscrepancies(ElementCounts exp, ElementCounts act)` (22 lines)
     - `CreateReport(ElementCounts e, ElementCounts a, List<string> disc)` (17 lines)
   - `CompareCounts` itself is exactly **7 lines** (<= 35 line target, <= 50 limit).

4. **Integrated `TypeResolutionRules` in `Stage5OpeningGenerator.cs`** (`HPBim/src/HPBim.Client/ScriptGenerators/Stage5OpeningGenerator.cs` - 119 lines):
   - In `Generate()`, populated `symbolName` using `TypeResolutionRules.GetDoorSymbolName` and `TypeResolutionRules.GetWindowSymbolName`.
   - In generated script, queries `FamilySymbol` matching `symbolName` before falling back to `symbolList.FirstOrDefault()`.
   - Eliminates dead code in `TypeResolutionRules.cs`.

5. **Modularized `CompositeBimGenerator` into 4 Partial Classes with All 8 Stages**:
   - `CompositeBimGenerator.cs` (72 lines): Entry point and script orchestration.
   - `CompositeBimGenerator.Stages1To3.cs` (120 lines): Levels, Grids, Columns (with `FAMILY_TOP_LEVEL_PARAM`), Beams, and Slabs.
   - `CompositeBimGenerator.Stages4To6.cs` (113 lines): Walls (with `WALL_HEIGHT_TYPE` and `WALL_TOP_OFFSET`), Openings (Doors & Windows with sill height), and Rooms.
   - `CompositeBimGenerator.Stages7To8.cs` (168 lines): Plumbing Fixtures, Piping Networks, Rebars, and composite return object.
   - 100% genuine execution of all 8 stages, no omitted stages.

6. **Added Comprehensive Unit Tests**:
   - `HPBim/tests/HPBim.Client.Tests/TypeResolver/TypeResolutionRulesTests.cs` (40 lines): Verifies formatting of wall, floor, column, beam, door, and window types, as well as default constants.
   - `CompositeBimGenerator_IncludesAll8StagesInScriptAndArgs` in `StageGeneratorTests.cs`: Asserts all 8 stages and return counts (`fixtures`, `pipes`, `rebars`) are present in script and payload args.
   - `ConnectAsync_ConcurrentCalls_SynchronizesWithoutThrowingOrLeaking` in `RevitPipeClientAdversarialTests.cs` (248 lines): Dispatches 5 concurrent `ConnectAsync` tasks to confirm race-free connection.

7. **Build and Line Count Verification**:
   - `dotnet build HPBim.slnx -c Release /warnaserror`: 0 warnings, 0 errors.
   - `dotnet test HPBim.slnx -c Release`: 216 tests passed (0 failed, 0 skipped).
   - `dotnet test HPBim.slnx`: 216 tests passed in Debug mode as well.
   - Every file in `HPBim.Client` is <= 200 lines (strictly <= 220 limit).

---

## 3. Caveats

- **Active Revit Integration**: As tested previously, Named Pipe unit tests use mocked/loopback named pipes in-process. Live testing in Revit 2026 relies on the existing `HPRebar.McpBridge` pipe `\\.\pipe\hprebar-mcp-r2026`.
- **Pre-existing Code**: `Stage3StructureGenerator.cs` and other stage generators remain unchanged and continue to pass all tests.

---

## 4. Conclusion

All 6 findings from Reviewer 2 have been thoroughly resolved. The codebase is fully compliant with Clean Code rules:
- All `.cs` files in `HPBim.Client` are <= 200 lines (strictly under 220 and 250).
- `CompareCounts` is 7 lines (strictly under 35 and 50).
- `RevitPipeClient` has thread-safe connection synchronization and delegates to `PipeMessageReader`.
- `CompositeBimGenerator` genuinely implements all 8 stages in script generation.
- 0 warnings under `/warnaserror` and 216/216 tests green.

---

## 5. Verification Method

To independently verify the implementation:

1. **Verify Class Line Counts in HPBim.Client**:
   ```powershell
   Get-ChildItem -Recurse -Filter *.cs 'g:\09-PROJECT AI\01_Revit\02_CshapRevit\01_AddinRebar\HPBim\src\HPBim.Client' | Where-Object { $_.FullName -notmatch '\\obj\\' } | ForEach-Object { [PSCustomObject]@{ Lines = (Get-Content $_.FullName).Length; Name = $_.Name } } | Sort-Object Lines -Descending | Format-Table -AutoSize
   ```
   *Expected*: Max file is `RevitPipeClient.cs` at 200 lines; every file is <= 200 lines (<= 220 limit).

2. **Verify Build with `/warnaserror`**:
   ```bash
   dotnet build "g:\09-PROJECT AI\01_Revit\02_CshapRevit\01_AddinRebar\HPBim\HPBim.slnx" -c Release /warnaserror
   ```
   *Expected*: Build succeeded. 0 Warning(s), 0 Error(s).

3. **Verify All Unit Tests**:
   ```bash
   dotnet test "g:\09-PROJECT AI\01_Revit\02_CshapRevit\01_AddinRebar\HPBim\HPBim.slnx" -c Release
   ```
   *Expected*: Total: 216, Failed: 0, Succeeded: 216, Skipped: 0.
