Lightingsang/AddinRebar/docs/project-changelog.md

# Changelog — HPRebar

Ghi lại thay đổi đáng kể. Mục mới nhất ở trên.

## 2026-10-04 — Clean code cho mọi MCP folder + kiểm chất lượng tool AI đề xuất (plan `261004-1005`, ADR-0007)

**Tài liệu:** `docs/clean-code/HP_CLEAN_CODE_CORE.md` (rule host-neutral, giữ nguyên id; thêm P9 và Q-B1…Q-B3 / Q-W1…Q-W5) + 5 phụ lục `docs/clean-code/host-appendix/` (revit, autocad-civil A1–A16, com-standalone CO1–CO14, net48-inprocess NI1–NI12, powerbi PB1–PB8); Revit standard giữ tên file và các id Revit/HPRebar; checklist/workflow/DoD theo host; audit §2a H-01…H-08 (lỗi hành vi host khác, chỉ ghi nhận). **Code (McpShared):** `ScriptQuality` (walker Roslyn trong `ScriptAnalyzer.Analyze`), `AnalyzeResult.QualityAnalysed` + `QualityFindings` (additive), `ToolValidator` chặn `error` / cảnh báo `warning` / bridge cũ = "quality not analysed", sự kiện `quality_checked` gắn hash code, mục "Code quality" trong file review, dòng tương ứng trong thông báo publish ở policy auto. **Test:** engine 793, net48 115, `SeedQualityTests` trong cả 10 server (allowlist pin hash: Excel `read_table` Q-B2 ×2). `tools/list` 10 server không đổi byte nào; verified live Revit 2026 (5/5). `.editorconfig` (chỉ suggestion) cho 10 solution còn thiếu. Bridge của 9 host khác cần redeploy để phân tích chất lượng (CHƯA TEST).

## 2026-10-03 — Clean Code governance cho RevitAddinAI (plan `261003-2133`, chỉ tài liệu)

**Bổ sung:** `docs/clean-code/` — `PRAGMATIC_CLEAN_CODE_RULES.md` (293 rule PCC-001…293 trích từ toàn bộ 15 chương sách *Pragmatic Clean Code*, paraphrase), `REVITADDINAI_CLEAN_CODE_STANDARD.md` (chuẩn ràng buộc [PCC]/[REVIT]/[PROJECT]), `CLEAN_CODE_AUDIT.md` (baseline AUD-001…060 + lỗi hành vi B-01…15), `REFACTORING_PLAN.md` (wave 0–8 + fix track), `TOOL_DEVELOPMENT_WORKFLOW.md` (16 bước + DoD), `CODE_REVIEW_CHECKLIST.md`, `REFACTORING_LOG.md`; `docs/architecture/` — `ARCHITECTURE.md`, `DEPENDENCY_RULES.md`, `adr/0001…0006` (tất cả *Proposed*). CLAUDE.md + AGENTS.md: mục "Clean Code Governance — RevitAddinAI (MANDATORY)". **Không đổi production code**, không build/test (chỉ grep). Chuẩn mới thay thế: `ILogger<T>` inject (code-standards §4) và `doc.NewTransaction` (development-rules) — xem Standard §13.

## 2026-09-19 — AutoCAD family: MaterialDesign cho HPAutoCad, HPCivil3d, HPGeo (phase 4 của plan `260919-1910`)

**HPAutoCad bridge:** toolkit repack vào `HPAutoCad.McpBridge.dll` (target `RepackMaterialDesign`), `Resources/Themes/{MaterialBridge, ThemeDark, ThemeLight}.xaml` + copy helper (`MaterialThemeBridge`, `IHostTheme`, `ThemeInfo`), `Service/AutocadHostTheme` (COLORTHEME sống qua `SystemVariableChanged`); `AutocadThemeSwitcher.cs` + `AutocadThemeLight.xaml` xoá; harness `Set-OptIn` poll 20 s. **HPCivil3d:** port qua 50 token (`patch-phase4b.py`), `mirror-tokens.json` +7 file mirrored, sha csproj re-pin, MirrorTests 60/60. **HPGeo:** `UI/MaterialBridge.xaml` bootstrap, `UI/Theme.xaml` merge nó trước + style re-base (`Button` outlined, `Button.Primary` raised, `Expander` header gọn, `DataGrid.Cell`/`DataGrid.ColumnHeader` keyed), bỏ implicit `TextBox`/`ComboBox` → **popup ComboBox dark đúng (known gap đóng)**; palette thêm 3 brush tên helper đọc (**alias `StaticResource` trong BAML resolve sai entry** → dùng brush thường); `HPGeoHostTheme` thay 2 bản `IsDarkTheme()`; cửa sổ import 900 → 960. **Verified live 2026-09-19:** ribbon 12/12 ×2, bridge 21/21, smoke 22/22, theme flip AutoCAD + Civil 3D 55 → 245 → 55, `dialog-check.ps1` PASS, popup dark 50.1, `acceptance.ps1` 52/52, co-load 2 bundle cả 2 thứ tự 6/6 ×2, isolation AutoCAD 4/4 + Civil 9/9; tests 280 + 225 + 60 + 106 + 158. Harness mới: `autocad-bridge-theme-flip.ps1`, `autocad-coload-check.ps1`, `hpgeo-combobox-popup-check.ps1` (trong `plans/260919-1910-…/reports/`).

## 2026-09-19 — Revit MCP bridge + ETABS bridge: MaterialDesign (phase 3 của plan `260919-1910`)

**Revit MCP bridge:** toolkit repack vào `HPRebar.McpBridge.dll` (target `RepackMaterialDesign`, Roslyn vẫn rời), link 4 file helper + `MaterialBridge.xaml` từ HPRebar (helper assembly-neutral), bản `ThemeSwitcher` thứ 4 xoá, `Buttons.xaml`/`TextBoxes.xaml` xoá hẳn; footer caption wrap. Verified live: cửa sổ mở từ ribbon qua UIA, checkbox opt-in MD → `execute_revit_code` chạy. **ETABS:** `MaterialBridge.xaml` (bridge vocabulary), palette `ThemeLight/ThemeDark.xaml` (dark là mới), `WindowsHostTheme` (Windows app mode, env `HPETABS_MCP_BRIDGE_THEME`), `EtabsTheme.xaml` chỉ còn token; ảnh dark/light từ Debug + publish folder; tests 184 + 81. Harness mới trong `plans/260919-1910-…/reports/`: `revit-open-bridge-window.ps1`, `revit-toggle-optin.ps1`, `revit-answer-unsigned-addin.ps1`, `etabs-window-shot.ps1`.

## 2026-09-19 — HPRebar: MaterialDesignInXAML 5.3.2 (phase 0–2 của plan `260919-1910`) + fix icon Column Rebar

**Thêm:** `MaterialDesignThemes 5.3.2` merge vào `HPRebar.dll`; `Resources/Themes/MaterialBridge.xaml` (CustomColorTheme `#0696D7`/`#E0641E`, MD2 Defaults, 8 style key cũ re-base, `MaterialDesignFont` = Segoe UI), `MaterialThemeBridge` (overlay top-level, MD theo palette HP, icon vector, theme sống theo `Application.ThemeChanged`), `IHostTheme`/`RevitHostTheme`, `ThemeInfo.cs`; gallery off-Revit `HPRebar/tools/theme-gallery/` (net8 + net48, 17/17); 3 test text-level `ThemeTokenCoverageTests`. **Bỏ:** 3 bản `ThemeSwitcher` (feature folders); `Buttons.xaml`/`TextBoxes.xaml` không còn merge. **Sửa:** Column Rebar ném `Cannot locate resource 'resources/icons/columnrebar32.png'` từ commit `a4a2f64` (PNG xoá, `Icon=` còn) — icon giờ là `RibbonIcons` vector qua bridge, test chặn path treo. **Spike (worktree, không merge):** ILRepack go + `ThemeInfo` bắt buộc; DLL toolkit rời trong 2 ALC của một acad.exe **trộn bản** → repack vào từng add-in (phase 3–5); Navis net48 bind đúng theo strong name. Build R23/R24/R26/Release.R26 sạch, R27 giữ 10 lỗi cũ; Core 337, MCP server 109. Verified trong Revit 2026: 3 cửa sổ mở, theme đổi sống. Còn lại (ngoài phạm vi): `StirrupCreator.Place` → `RebarShapeDrivenAccessor.SetLayoutAsNumberWithSpacing` `InternalException` trên cột thử (lỗi domain rebar).

## 2026-09-18 — Civil 3D MCP: skill `hp-mcp-civil3d`

**Bổ sung:** `.claude/skills/hp-mcp-civil3d/` (SKILL.md 130 dòng theo khuôn `hp-mcp-etabs`/`hp-mcp-autocad`: Bước 0 kết nối, quy tắc đơn vị mm ↔ drawing unit, decision tree, bảng seed, ghi với dryRun, contract `execute_civil3d_code`, toolify, bảng lỗi, security policy; `references/tool-catalog.md` sinh từ `tools/list` exe publish (24 tool), `script-contract.md`, `civil-api-cheatsheet.md` (chỉ member đã chạy thật, 1 mục `[unverified]`), `troubleshooting.md`; `scripts/check-civil3d-mcp.ps1` health check read-only, `scripts/generate-tool-catalog.py`; `evals/evals.json` 3 prompt). Mirror `.agents/skills/hp-mcp-civil3d/` bằng `sync-agent-skills.py apply` (drift none). `.claude/rules/skill-domain-routing.md` thêm dòng Civil 3D.

## 2026-09-18 — Civil 3D MCP: phase 5 — publish, docs, `AGENTS.md` regen — **plan hoàn tất**

**Bổ sung:** exe publish `HPCivil3d/output/HPCivil3d.Mcp.Server/HPCivil3d.Mcp.Server.exe` (single-file 7.1 MB; `tools/list` từ exe publish = 24 — `reports/phase-05-tools-list-civil3d-published.json`); bundle deploy lại từ Debug; CLAUDE.md (câu chiều phụ thuộc "six deliverables" + ngoại lệ tooling cross-MCP, hàng `HPCivil3d/`, mục "HPCivil3d MCP Bridge"); `AGENTS.md` regen bằng lệnh `_TO_PORTABLE` (idempotent, `sync-agent-skills.py check` drift none); `docs/codebase-summary.md`, `docs/system-architecture.md`, README HPCivil3d + harness + McpShared. `.mcp.json` entry `hprebar-civil3d` do user tự thêm (untracked).

**Chưa làm (known gaps):** modal Civil khi script chờ; corridor dự án thật (`Rebuild*` deny); data shortcut; pressure parts / point group; `test_tool realRun`; Civil 3D 2025 / .NET 10; follow-up B `AcadShared/` (skill `hp-mcp-civil3d` làm ngay sau — mục trên).

## 2026-09-18 — Civil 3D MCP: phase 4 — live-verify harness, registry loop, isolation hai chiều

**Bổ sung:** `HPCivil3d/tools/harness/run-live-verify.ps1` (PS 5.1) + `live-verify.py`: một phiên stdio qua exe publish trên registry root cách ly — A context 4, E execute matrix 20 + E' 4 (opt-in off / no doc / busy → ESC → retry), S 24 (12 seed trên copy `Profile-5F.dwg` Feet + `Corridor-1a.dwg` Meters, paging, `partsTruncated`, write qua `test_tool` → `run_tool` → `U`), R 21 (MISS → propose `mcp_verify_count_cogo_points` → test → publish → CLI approve → `list_changed` 0.5 s → HIT; fragile → quarantine → restore/newVersion; proposal `RebuildAll` bị guard từ chối; tool `none` mà ghi fail test), X 3 (exe AutoCAD bên cạnh trên root cách ly); isolation: Civil thứ hai "pipe in use", AutoCAD thuần nạp bundle mình + coexist 2 pipe, Advance Steel không nạp gì, harness AutoCAD `-OnlyIsolation` 4/4. `Test-PipeUp` (liệt kê thư mục pipe — `Test-Path` kết nối vào pipe làm tên biến mất thoáng qua). Bug seed `list_pipe_networks` `partLimit` fallback 200 ≠ schema 60 → sửa + test `Schema_defaults_equal_the_code_fallbacks`.

**Review round (7.5/10 → sửa cùng ngày):** exe AutoCAD "bên cạnh" từng ghi `%AppData%\HPAutoCad\McpServer\registry.db` → root cách ly `registry-autocad` + hash 2 root thật trước/sau; SKIP rows thay `Write-Host`; assert default có literal; baseline pipe; audit phải tăng; `status` field; `list_changed ≥ 1`; `open_drawing` fail khi read-only; mọi tool harness `mcp_verify_*`; `Registry-Reset -KeepExisting`; README điều kiện isolation.

**Xác minh:** `-Runs 3 -IncludeIsolation` → **3 × 76 PASS + 8/8**; sau review `-Runs 1 -IncludeIsolation` → **80/80 + 9/9**, 0 skip, 0 fail, registry thật hai sản phẩm không đổi; hồi quy `tools/list` Revit 33 / AutoCAD 62 / Navis 24 / ETABS 24 byte-identical; 9 suite xanh (…/55/106).

## 2026-09-18 — Civil 3D MCP: phase 3 — server profile, 12 seed nhúng, `tools/list` 24

**Bổ sung:** `Civil3dHostProfile` (10 category), `execute_civil3d_code` (1 777 chars), `get_civil3d_context`, prompts/resources `civil3d://`; 12 seed sinh bởi `tools/generate-seed-library.py` (10 `none`: document info, alignments, alignment geometry, profiles, surfaces, surface elevation, corridors, pipe networks, parcels, COGO points; 2 `auto`: `create_cogo_points`, `create_alignment_from_polyline`) — mm ở biên, station/elevation/area theo drawing unit + `drawingUnit`, page cap theo bytes đo được (< 64 KB), `errors[{code,message,handle}]`, `ArgumentException` cho lỗi caller; server tree fenced bởi mirror contract.

**Review round (7/10 → 14/14 sửa):** `partLimit` một budget; `insunitsMismatch` dead-false; nested keys regex; forbidden token `Rebuild(`/`RebuildAll`/`RebuildSnapshot` (không bắt `RebuildAutomatic`); mô tả 2 695 → 1 784.

**Xác minh:** `HPCivil3d.Mcp.Server.Tests` 106 (compile mọi seed với Civil API cài sẵn), `HPCivil3d.McpBridge.Tests` 55; `run-server-smoke.ps1` 28/28 live.

## 2026-09-18 — Civil 3D MCP: phase 2 — runtime Civil, mirror tests, harness pipe + ribbon

**Bổ sung:** `HPCivil3d.McpBridge` deltas: global `civil`, `Civil3dUnitTable` (Meters 1000 / Feet 304.8, INSUNITS fallback, US survey feet = feet), context block `civil3d`, serializer Civil (alias type — `Autodesk.Civil.DatabaseServices` có `Entity`/`DBObject` riêng), `GuardProfile.Civil3d`; `HPCivil3d.McpBridge.Tests` MirrorTests (`tools/mirror-tokens.json`, mutation 1 ký tự → 1 fail); harness `run-bridge-unattended.ps1` (31 check), `run-ribbon-check.ps1`; `Stop-Acad` graceful; `Set-OptIn` retry.

**Xác minh:** pipe 31/31 ×3–4; ribbon 12/12 + 1 MANUAL; review 8/10 → 10 sửa.

## 2026-09-17/18 — Civil 3D MCP: phase 1 — scaffold `HPCivil3d/` + spike với Civil 3D 2026 thật

**Bổ sung:** `HPCivil3d/` (slnx, global.json, `Directory.Build.props` dò `ACAD-9100:409\Location`), Loader + bundle `Platform="Civil3D"`, bridge copy từ AutoCAD, server; `run-spike.ps1` + `spike.py` 8 run (S-01…S-11): bundle chỉ nạp trong Civil 3D, AutoCAD/Advance Steel không nạp, coexist 2 pipe; mọi DWG có `CivilDocument`; `"."` = không zone; `Parcel.Area` có; `PointNotOnEntityException`; `Abort()`/`U` hoàn lại CogoPoint/Alignment/TinSurface vertex/corridor rebuild; SECURELOAD 1 prompt/hash DLL, chặn nạp; harness gotchas (`Documents.Open` trùng → read-only copy, `.dwl` hidden, UIA Popup).

**Review round (7.5/10 → 9 sửa):** bỏ hẳn nhánh nới guard `HPCIVIL3D_MCP_SPIKE`; spike S-10b/c chuyển sang assert guard từ chối `Rebuild`.

## 2026-09-17 — Civil 3D MCP: phase 0 — hằng số engine Civil 3D + sửa bypass `?.` trong guard cho mọi host

**Bổ sung (McpShared, additive):** `PipeNaming.Civil3dHost` (`hpcivil3d-mcp-2026`), `JsonRpcMethods.Civil3dPrefix`, `HostScriptContracts.Civil3dImports/Globals`, `ContextResult.Civil3d`/`Civil3dInfo`, `GuardProfile.Civil3d`/`AnalyzerProfile.Civil3d`; `ScriptGuard` không còn bỏ qua member access qua `?.` (bypass áp dụng cho cả 5 host).

**Xác minh:** `tools/list` Revit 33 / AutoCAD 62 / Navis 24 / ETABS 24 byte-identical trước/sau (`reports/phase-00-*`); Core.Tests xanh.

## 2026-09-17 — ETABS MCP: icon ứng dụng bridge (exe + titlebar)

**Bổ sung:** `HPEtabs/tools/icons/render-app-icon.ps1` (PS 5.1 STA, WPF render một glyph vector → `.ico` 9 cỡ 16..256 PNG-entry + PNG 256 preview): khung kết cấu 3 tầng trên móng + phích MCP có dây cắm vào dầm giữa — cùng họ glyph host + plug `#0696D7` của Revit/AutoCAD/Navis. `HPEtabs.McpBridge.csproj` `<ApplicationIcon>` + `<Resource>`; `EtabsBridgeStatusView.xaml` `Icon="/Resources/HPEtabsMcpBridge.ico"`.

**Xác minh:** build Debug + publish Release OK; exe publish `ExtractAssociatedIcon` 32×32 (212 px ink / 124 px accent); bridge publish khởi động lại (pid mới), titlebar hiện icon (PrintWindow screenshot); attach ETABS + `get_etabs_context` qua MCP server thật OK. Gotcha: Bash heredoc biến `icons\render` thành CR trong comment csproj — dùng `/` trong comment.

## 2026-09-17 — ETABS MCP: phase 4 — `-Phase full` từ publish folder, registry loop live, hồi quy 3 host — **plan hoàn tất**

**Bổ sung:** harness phase `registry` (R1–R19: MISS → ad-hoc → `get_run`/`toolify_run` → `propose_tool` → `test_tool` → `publish_tool` → CLI approve → listed ≤ 0.5 s → gọi theo tên; tool mong manh → quarantine sau 5 fail → `manage_tool restore` + newVersion guarded → 5 `ArgumentException` vẫn published); `run-live-verify.ps1 -Phase full [-Publish] [-Runs n]` (publish 2 exe rồi chạy từ `HPEtabs/output/`, 1 registry root mỗi run, không wipe giữa nhóm); `tools/harness/README.md`; `reports/regression-tools-list-phase-04.py`; seed results: case chưa chạy → `ArgumentException` (không làm seed bị quarantine khi người dùng hỏi trước khi chạy analysis); README `HPEtabs/` status + gotchas; CLAUDE.md known gaps.

**Xác minh:** `-Phase full -Publish -Runs 3` → **3 × 102 PASS, 0 fail, 0 skip** (236 s), self-check OK từ publish folder; hồi quy `tools/list`: Revit 33/33, Navis 24/24, AutoCAD 37/37 identical (3 tool khác = commit AEC 28b075d); suites sau đổi engine: McpShared 164 + 62, Revit 109, Navis 49 + 135, AutoCAD 241, ETABS 81 + 184. Chưa làm (manual): kill ETABS giữa call, licence seat, restore snapshot trong GUI, `run_analysis` project thật. Gotcha: `os.environ` Windows upper-case key; wrapper `-Runs N` dùng chung registry → MISS sai + quarantine tích luỹ (đã tách registry mỗi run).

## 2026-09-17 — ETABS MCP: phase 3 — 12 seed nhúng, `tools/list` 24, verify live kể cả `run_analysis` thật

**Bổ sung:** `HPEtabs.Mcp.Server/Registry/SeedLibrary/**` 12 seed (8 R: model info, stories/grids, structural objects, materials/sections, load definitions, joint reactions, frame forces, modal; 3 W: draw frame, assign section, assign load; 1 D: `run_analysis` 600 s) — chữ ký OAPI đọc bằng reflection từ `ETABSv1.dll`, ghi `tool.json.notes`; `SeedLibraryStructureTests` (38) + `SeedLibraryCompileTests` (25, compile + tier khớp fixture, `Assert.SkipWhen` không ETABS); harness `live-verify.py --phase seeds|seedsdestructive`, `run-live-verify.ps1 -Phase seeds`. Runner: message sau exception W/D phân biệt `changed` 0. Attach: thông báo trường hợp ETABS không đăng ký ROT / elevated.

**Review round (7/10 fix-first → đã sửa cùng ngày):** `assign_frame_load` `CSys` Local cho direction 1–3 (trước không bao giờ áp được); results seeds validate tên trước (`ArgumentException` "labels are not names") và kiểm `GetCaseStatus` ("has no results … run_analysis first"); `run_analysis` validate case trước khi đụng run flag, `success` thật + `errors[CASE_FAILED]`; `get_model_info` kiểm mọi ret + `.$et` → `.EDB`; `get_structural_objects` `matched` trung thực khi truncated; regex cấm `\w*CSVFile`; generator `tools/generate-seed-library.py` vào repo. Server tests 80 → 81; live `-Phase seeds -Runs 2` → 2 × (26 + 9).

**Xác minh:** server tests **81/81**; `tools/list` registry cách ly = 24, 6 category, `_seeds.json`; live ETABS 22 ×3 (`seeds` 20/20 + `seedsdestructive` 9/9): W seeds chạy thật với snapshot, `run_analysis` 14 s trên 2 cột W14X500 ngàm chân → phản lực FZ 21.9 kN = trọng lượng bản thân, frame forces, modal + mass ratio; D off → `-32001` ×5 tool vẫn published; `propose_tool` RunAnalysis / `none`+SetSection bị từ chối; **E10 đóng:** `SetModelIsLocked(false)` xoá kết quả (mọi case "not run"). Gotcha: ETABS mở bằng cách khác thường không đăng ký ROT — mở ETABS trước rồi File › Open.

## 2026-09-17 — ETABS MCP: phase 2 — runtime ghi: tier semantic từ fixture, snapshot `.EDB` vô điều kiện, fingerprint, path policy

**Bổ sung:** `HPEtabs.McpBridge/Resources/etabs-oapi-tiers.txt` (1 281 dòng, 733 R / 446 W / 102 D, sinh bởi `tools/generate-oapi-tier-fixture.ps1` — reflection trên `ETABSv1.dll` cài sẵn, review tay) + `etabs-oapi-index.txt` (1 107 topic CHM, test phủ 100 %); `EtabsTierTable`, `EtabsTierAnalyzer` (**semantic** qua `Script.GetCompilation()` — alias/cast/lambda/method group bind về cùng `cInterface.Member`; member ngoài bảng hoặc không bind = D; đối số path chỉ literal hoặc `args.Str("key")`, khác → `PATH`), `EtabsPathPolicy` (tĩnh: UNC/thư mục bridge/server/ETABS; lúc chạy: tuyệt đối dưới thư mục model hoặc `%LocalAppData%\HPEtabs\`, mọi `args` dạng path), `EtabsSnapshotManager` (presave có điều kiện → `File.Save()` → prerun copy; bucket 5/10; label sanitize; tên file only; budget), `EtabsFingerprint` (9 receiver + lock + file → `Changed(added, 0, deleted)`), `EtabsUnitsPolicy`; `EtabsScriptRunner` viết lại theo ma trận ADR-02; `EtabsExecutor` (+ `.Worker`) — `PATH` → `-32001` → preview (`none`/dryRun trên W/D) → `-32003` → ceiling 600 s cho D; audit `started` ngay trước save, tag `[tier:X] [snapshot:file] [destructive]`. Gỡ gate syntax phase 1 (`EtabsTierGate`) và 3 nút probe spike; cửa sổ có link thư mục snapshot.

**Review round (6.5/10 fix-first → đã sửa cùng ngày):** `args.Str(key, fallback)`, `ScriptArgs` tự tạo/trùng tên, key vắng mặt hoặc non-string không còn qua path policy; **engine** `ScriptGuard.Check` từ chối `#r`/`#load` cho mọi host (trivia — DLL từ đĩa từng chạy ở tier R; McpShared tests 162 → 164, net48 60 → 62); static rule chạy lại trên path chuẩn hoá + `%LocalAppData%\HPEtabs\McpBridge\**` cấm; preview trước check opt-in D (đúng ADR-02); cancel trong lúc save không còn báo timeout; prune theo tên; `nameof`; `Save("")`; receiver refuse = unknown; drive root/ADS; `fullPath` flag; harness mirror `SanitizeLabel`. Bridge tests 166 → **184**; live `-Phase bridge` 48/48 sau sửa.

**Xác minh:** build 0 error; `HPEtabs.McpBridge.Tests` **184/184** (fixture, analyzer 60 row, path policy, snapshot manager trên temp dir, fingerprint/units, executor refusals không cần ETABS chạy), server 17/17; live ETABS 22 model bỏ đi `Project_MCP_TEST.EDB`: `run-live-verify.ps1 -Phase bridge -Runs 2` → 48 check × 2 PASS (75 s): `Save()` ~600 ms trong budget, `AddByCoord` = +3 (frame + 2 point), delete frame = −6 (ETABS xoá point mồ côi), retention prerun 10 / presave 2. Sai lệch ghi trong `reports/phase-02-bridge-runtime.md` (`Move` = W, `cSelect/cView` = R, `Verify*` = R, fixture từ DLL thay CHM, `started` sau path check). Gotcha: `cFile.Save(FileName = "")` optional → `Save()` không screen; PS 5.1 không BOM — không em dash trong chuỗi.

## 2026-09-17 — ETABS MCP: phase 1 — `HPEtabs/` scaffold (bridge app + server) + COM spike với ETABS 22 thật

**Bổ sung:** folder `HPEtabs/` (`HPEtabs.slnx`, `global.json`, `Directory.Build.props` dò thư mục cài qua CLSID `LocalServer32`), `HPEtabs.McpBridge` (WPF net8.0-windows độc lập — không add-in: `EtabsAssemblyResolver` nạp `ETABSv1.dll` từ thư mục cài, `EtabsAttachment` (`Helper.GetObject` qua interface `cHelper`, liveness `Process.Exited` + COM disconnect), `EtabsExecutor` (STA worker + `MainThreadQueue` + control lane), `EtabsTierGate` (R/W/D tĩnh, `PREVIEW`), `EtabsScriptRunner` (ép `kN_mm_C`, restore), serializer, context reader, cửa sổ 2 checkbox + Attach/Detach + 3 probe), `HPEtabs.Mcp.Server` (`EtabsHostProfile` version **22**, 4 core tool, prompts, resources), tests 17 (server, không cần ETABS) + 26 (bridge, cần ETABS), harness `tools/harness/` (`run-live-verify.ps1`, `live-verify.py`, `spike-step.ps1`; không bao giờ điều khiển ETABS).

**Spike E9–E20 (ETABS 22 v22.7.0.4095, OAPI 2.10.0.0):** `Save(path)` = save-as; sau save `GetModelFilename` trả `.$et`; no-model = "(Untitled)"; units ép/restore OK; `GetNameList` ret 0 trên 8 receiver + `GetStories_2` 10 tham số; proxy STA gọi được từ MTA; dialog Define không chặn OAPI; >1 instance → `GetObject` trả instance mới hơn; đóng ETABS → `-32003` trong 0.1 s, Attach lại không restart; guard chặn 7 mẫu kể cả `global::`; `sapModel.File.Save()` → tier D `-32001`. Chưa chốt: "unlock xoá kết quả" (model không có kết quả). W/D chưa chạy (phase 2), chưa seed (phase 3).

**Xác minh:** build 0 warning; tests 17/17 + 26/26; harness `disabled` 2/2 + `detached` 15/15 (Debug ×2, publish ×1), `spike` 6/6, `nomodel`/`modal`/`closed` 1/1; publish server single-file 7.1 MB, bridge folder 21 file không chứa `ETABSv1.dll`. Báo cáo: `plans/260916-2152-etabs-mcp-2026/reports/phase-01-spike.md`.

**Review round (6.5/10 fix-first → đã sửa, cùng ngày):** `EtabsTierGate` **fail-closed** — `sapModel`/`etabs` dùng ngoài chuỗi `sapModel.X.Member(...)` (alias, cast, `?.`, lambda, đối số, so sánh) hoặc sub-object OAPI lấy làm giá trị (`var fo = sapModel.FrameObj;`) = D; mọi thứ dưới `sapModel.Results` = R; prefix D chỉ áp cho receiver bắt nguồn từ global (BCL `StartsWith/Clear/NewLine` không còn bị chặn); `EtabsContextReader` ẩn `(Untitled)`, chuẩn hoá `.$et` → `.EDB`, `isModifiable` cần model; `EtabsAttachment` đặt `_attached` trước `Watch` (ETABS chết lúc attach → lỗi rõ), `IsQuiescent` kiểm `IsWindow`; `_destructiveEnabled` volatile; catch/`DetachIfGone` ngoài exception filter; nhãn probe không còn mã E; harness E12/E15 assert thật, `spike-step.ps1` kiểm `ProcessName` trước khi stop; test row `AnalysisResultsSetup` (không tồn tại) → `DesignResults`. Tests **46/46** (bridge) + 17/17; harness `disabled` 2/2 + `detached` 15/15 ×2, `nomodel` 1/1 (assert mới) với ETABS 22 đang chạy; `spike` E18/`modal`/`closed` chưa chạy lại sau sửa (cần model mở lại / đóng ETABS).

## 2026-09-17 — AutoCAD MCP: AEC phase I — Change sets (5 tool `*_change_set` + `changeSetId` trên 12 write tool) — kế hoạch hoàn tất

**Bổ sung:** change set = danh sách lời gọi write tool được *ghi lại* thay vì áp dụng (mọi write seed nhận `changeSetId`; `ChangeSetRecorder.TryRecord` là dòng đầu của 12 method `AecTools`: kiểm tra tool, `op` hợp lệ — `manage_xrefs` chỉ attach —, mọi handle được nêu phải là entity; lưu `args.Raw.Clone()`), liệt kê bằng `preview_change_set` / `get_change_summary` (`none`), replay trong **một** run bằng `commit_change_set` (`auto`; `WriteToolTable` 12 reader y hệt shim; atomic: op thất bại → `ArgumentException` nêu tên op, bridge abort, không tính vào stability), hoàn tác bằng `rollback_change_set` (`auto`: xoá cái đã tạo, `Erase(false)` cái đã xoá, `CopyFrom` snapshot cho cái đã sửa — cùng handle; dimension / hatch tính lại; `keep` = đóng set giữ công việc). Snapshot = `Entity.Clone()` non-resident tại `ObjectOpenedForModify` lúc commit (bỏ entity mới theo HANDSEED, cap 2 000). `ChangeSets/` thuần: `ChangeSetLedger` (pending → committed → rolled_back | closed, pending → discarded; cap 20 set live — set committed cũ nhất bị đóng khi chạm cap —, 200 op, 64 KB args), `UndoRule` (commit / rollback bị dryRun hoặc `U` hoàn tác được nhận ra ở lần gọi sau khi *mọi* lớp handle đồng ý; fingerprint rộng: layer / màu / linetype / lineweight / style / hình học / text / pattern hatch / dynamic props), `ChangeSetEnvelopes` (envelope commit / rollback dưới cap qua `Settle` / 20 lỗi đầu + đếm theo code). `Cad/ChangeSetStore` theo `Database.UnmanagedObject` + `FingerprintGuid` (wrapper managed mới mỗi request), rơi khi `DocumentToBeDestroyed`, `DropAll` từ `BridgeEntry.Dispose`. 5 seed `ChangeSet/*`, category ChangeSet → server 62 tool (50 seed).

**Review round (6/10 → sửa xong):** trạng thái `closed` + `keep` + tự đóng khi chạm cap; snapshot giữ đến khi bản vẽ xác nhận undo (rollback dryRun → committed lại; rollback dở dang trên layer khoá → vẫn committed); verifier theo mọi lớp handle với fingerprint rộng; envelope commit / rollback dưới cap; abort là `ArgumentException`; xref detach/bind từ chối ghi; kiểm tra handle ở `hatch.boundaryHandles` / `filter.handles` + `op`; identity store theo fingerprint; các Low.

**Xác minh:** build 0 warning; `HPAutoCad.Aec.Tests` 225/225; `HPAutoCad.Mcp.Server.Tests` 280/280 (50 seed); live `run-aec-edit-tools-live.ps1` 109/109 (step Z) + `run-aec-tools-live.ps1` 90/90 (AutoCAD 2026, 2026-09-17); smoke 22/22. Báo cáo `plans/260916-1140-aec-automation-mcp-autocad/reports/phase-I-change-sets-live.md`. Kế hoạch 260916-1140 hoàn tất (A–I).

## 2026-09-17 — AutoCAD MCP: AEC phase H — Coordination (`aec_clash_check`, `aec_create_opening_requests`)

**Bổ sung:** `HPAutoCad.Aec/Coordination/` (`ClashClassifier` — hai hình gặp nhau nghĩa là gì: `hard_clash` critical chỉ khi phần tử MEP xuyên vào cấu kiện hoặc tuyến của hệ khác (cắt / trùng / nằm trong / kết thúc bên trong; tuyến × tuyến cắt mà một đầu nằm trong `endpointConnection` = tee); `contact` info khi biên chỉ chạm — dầm gác mặt cột hoặc tới tâm cột, tee, thiết bị ở đầu ống, cửa trong tường, cấu kiện kết cấu / kiến trúc gặp nhau; `area_overlap` info khi nằm trong hoặc cắt biên `Room` / `StructuralSlab`; vị trí clearance = trung điểm cặp đỉnh–chân vuông góc gần nhất; `ClashDetector` — broad phase `SpatialIndex` nới theo clearance, chỉ ghép cùng space, same-set mỗi cặp một lần, `DistanceXY(upTo)` cho `clearance_clash` warning, `ct` mỗi cặp, cap 200 000 cặp / 200 M cặp đoạn, id `CL-nnnn`; `OpeningPlanner` — giao điểm `proper: false` sắp theo trạm dọc tuyến, đoạn giữa hai trạm liên tiếp có trung điểm nằm hẳn trong outline = một lỗ mở (đỉnh nằm trên mặt tường vẫn qua, xuất phát trên mặt gần vẫn qua, kết thúc bên trong / chạm / chạy dọc mặt thì không), dài hơn `maxChordMm` 1 000 thì đếm bỏ; host là đường: qua khi tuyến đổi bên; kích thước ống 150 / duct 400 / máng 300 + 2 × 50; tối đa 100), `Cad/CoordinationService` (set = `filter` + `aecTypes`, classify một lượt, subject mang space), `Cad/OpeningWriteService` (hai pha: chữ nhật xoay theo host + MLeader `<id>: <routeType> <route> through <hostType> <host> (W×H)` trên `HP-MCP-OPENINGS` ACI 30; preview liệt kê 100 + `truncated`), `AecTools.Coordination` (`MaxClashLimit` 80, `minSeverity` mặc định warning, host mặc định tường + dầm — sàn chọn được, không mặc định —, `RouteSpace`, set rỗng cảnh báo). `SpatialPredicates.DistanceXY(upTo)` lọc theo hộp và dùng chỉ mục đoạn theo hình khi > 4 096 cặp đoạn (cả `IntersectionPoints`). 2 seed `Coordination/*`, category Coordination → server 57 tool (45 seed).

**Review round (5.5/10 → sửa xong):** chạm không còn là critical, giao qua đỉnh vẫn thành lỗ mở và không còn lỗ ma giữa hai lần xuyên, nằm trong sàn / phòng là info, vị trí clearance đúng khe hở, chord dài bỏ + đếm và sàn khỏi host mặc định, hiệu năng chặn theo cặp đoạn (< 2 s cho 60 cung xếp chồng), `MepEquipment` sai tên, không ghép khác space; Low: `Inner` không throw, đoạn zero-length bỏ, preview > 100 vẫn liệt kê, set rỗng cảnh báo, mô tả seed khớp code.

**Xác minh:** build 0 warning; `HPAutoCad.Aec.Tests` 210/210; `HPAutoCad.Mcp.Server.Tests` 253/253 (45 seed); live `run-aec-tools-live.ps1` 90/90 + `run-aec-edit-tools-live.ps1` 96/96 (AutoCAD 2026, 2026-09-17); smoke 22/22. Báo cáo `plans/260916-1140-aec-automation-mcp-autocad/reports/phase-H-coordination-live.md`.

## 2026-09-17 — AutoCAD MCP: AEC phase G — MEP (3 tool `mep_*`)

**Bổ sung:** `HPAutoCad.Aec/Mep/` (`MepNetworkBuilder` — ống/duct/máng cáp = run, thiết bị/fixture/miệng gió/fitting = nút; đầu run nối khi chạm đầu run khác (joined), thân run (tee, kể cả thân của chính nó), hoặc nút, trong `endpointConnection`; nút gắn với mọi run đi xuyên qua (van, bơm, VAV inline); union-find theo run — nút chỉ nối run cùng hệ nên cấp/hồi gặp AHU không gộp; giao cắt không phải nối; run trùng = cùng hệ, song song, lệch ≤ endpointConnection; heuristic duct 2 nét; `MepChecks` — near_miss (một issue cho cặp đầu đối diện), open_end, disconnected_run, orphan_node, duplicate_run, mixed_system, id `MEP-nnn`), `Cad/MepService` (1–2 lượt classify theo layer MEP + tên block fitting, không dựng text index, `space: all` từ chối, hệ thống từ `detection.systems`), `AecTools.Mep` (cap 30 mạng / 150 endpoint / 100 issue, khối `detection` chung), 3 seed `MEP/*` (`none`), category MEP; rule set v4 (run nhận ARC/SPLINE, bỏ pattern `CO-*`).

**Review round (5.5/10 → sửa xong):** nút inline không còn là orphan, nút không gộp hệ thống, bản sao lệch trục là duplicate, cặp đầu đối diện = một near_miss, ring main tự thấy đầu kia, cap envelope (connectedTo ≤ 4, endpoint 150, mixed_system 4 handle), không run → cảnh báo không orphan, cảnh báo duct 2 nét, ct + SpatialIndex, examined cộng 2 lượt, tiny run bỏ + đếm, nearMissMm phải > endpointConnection.

**Xác minh:** build 0 warning; `HPAutoCad.Aec.Tests` 197/197; `HPAutoCad.Mcp.Server.Tests` 241/241 (43 seed); live `run-aec-tools-live.ps1` 83/83 + `run-aec-edit-tools-live.ps1` 89/89 (AutoCAD 2026, 2026-09-17). Báo cáo: `plans/260916-1140-aec-automation-mcp-autocad/reports/phase-G-mep-live.md`.

## 2026-09-17 — AutoCAD MCP: AEC phase F — Architecture (5 tool `arch_*`)

**Bổ sung:** `HPAutoCad.Aec/Architecture/` (`RoomLoopFinder` + `WallGraph` + `OpeningBridger` — phòng = face kín của đồ thị tường: cắt tại giao/T, khép khe ≤ roomGap, bắc cầu cửa đi (hai đầu tường đối diện trên một đường, hoặc hai nét jamb của tường 2 nét, 600–2500 mm), bỏ đoạn cụt (đuôi ≤ 500 mm qua giao là overshoot), lọc face nhỏ / khoang tường / nét ngoài tường đôi; `Room` + `RoomLabelRules` + `RoomLabels` — tên / số / bộ phận từ từng dòng text trong phòng theo regex của người gọi (số mặc định: 2–4 chữ số hoặc chữ + dấu + 3–4 số, không nhận mark B01/C1); `RoomBoundaryChecks` — open_boundary, boundary_gap (một issue mỗi khe), boundary_gap_closed, opening_assumed, room_overlap (chỉ khi lòng chồng nhau), room_inside_room, duplicate_room, unlabelled_room; `AreaSchedule`; `AutoDimensionRules` — khung rule dạng data, rule `overall`), `Cad/RoomService` (một lượt classify, thu hẹp query theo layer tường/phòng của rule set, outline tường minh thay loop trùng, zone bị loại), `Cad/RoomWriteService` (+`.Dimensions`; tag MTEXT / block hai pha, attribute kiểm trước khi ghi; dimension aligned, cap 120), `EditContext.Layers` (CheckAnnotationLayer / EnsureLayer dùng chung D–F), `AecTools.Architecture` (cap 30 phòng/trang, 120 tag, 50 dòng schedule; khối `detection` chung 5 tool), 5 seed `Architecture/*` (3 `none`, 2 `auto`), category Architecture; rule set v3: tường nhận ARC/ELLIPSE.

**Review round (5/10 → sửa xong):** cửa đi (trước đó plan thật ra 0 phòng hoặc gộp hết), outline lát kề nhau không phải overlap, sảnh chứa hộp kỹ thuật không bị bỏ, cap dimension, overshoot không nuốt khe thật, reach = maxGapMm, một issue mỗi khe, polyline hở tự nhận đầu kia, khối detection chung, pattern số mặc định, MTEXT nhiều dòng, cap handles/texts/rows/tags, attribute block kiểm pha 1, SpatialIndex + ct, cảnh báo cắt text/quét.

**Xác minh:** build 0 warning; `HPAutoCad.Aec.Tests` 191/191; `HPAutoCad.Mcp.Server.Tests` 222/222 (40 seed); live `run-aec-tools-live.ps1` 75/75 + `run-aec-edit-tools-live.ps1` 89/89 (AutoCAD 2026, 2026-09-17). Báo cáo: `plans/260916-1140-aec-automation-mcp-autocad/reports/phase-F-architecture-live.md`.

## 2026-09-17 — AutoCAD MCP: AEC phase E — Structural (7 tool `structural_*`) + review round phase D

**Bổ sung:** `HPAutoCad.Aec/Structural/` (`StructuralMember` — tiết diện 400×400 / Ø400 / L 5600, trục, mark từ attribute `MARK`; `GridDetector` — trục lưới gộp đoạn thẳng hàng, bubble tròn/block, nhãn từ TEXT hoặc attribute, bubble phải nằm trên trục; `StructuralChecks` — dầm hụt gối / không gối, cột lệch lưới / không lưới, lỗ mở cắt cột (chỉ khi lòng chồng nhau) / sát cột / ngoài sàn; `MemberTagging` — thứ tự đọc theo dải 250 mm, giữ mark cũ và giữ **số**, mark khác prefix `kept_foreign`, `overwrite` đánh lại tại chỗ, schedule theo loại + tiết diện), `Cad/StructuralService` (một lượt classify, mỗi text mark thuộc đúng một cấu kiện), `Cad/StructuralWriteService` (+`.Table`; hai pha: attribute, sửa text tại chỗ, hoặc TEXT mới trên `S-ANNO-TEXT`; bảng ACAD_TABLE), `AecTools.Structural` (cap `MaxGridLimit` 100, `MaxMemberLimit` 100, `MaxTagMembers` 120, `MaxIntersectionsListed` 200), 7 seed `Structural/*` (5 `none`, 2 `auto`), category Structural; `EntityShapeReader` đo INSERT có attribute bằng extents của block definition (không tính attribute).

**Review round phase E (5/10 → sửa xong):** cap cho tool ghi và cho grid (kèm size test), attribute MARK là mark có sẵn (không bị ghi đè khi `overwrite: false`), "overwritten" sửa text cũ tại chỗ thay vì thêm text thứ hai, bubble block có nhãn, bubble góc không bị lấy nhầm, stub gộp vào trục, không lưới = 1 warning, lỗ mở chạm mặt cột = 0 mm chứ không "through", dầm copy lệch 2 mm không phải gối, số mark giữ theo số, dải hàng theo khoảng cách, space ghi = space đọc, bảng/tag không mở space để ghi trước khi validate, text mark chỉ nhận khi chữ cái là prefix mặc định/đã cho và thuộc một cấu kiện.

**Review round phase D (5.5/10 → sửa xong):** danh sách exempt rỗng không miễn gì (`Exempts`), `MaxIssueLimit` 100, geometry audit theo từng space, markup vẽ trong space của entity (`space: auto`), bán kính giữ nguyên khi có `locationMm`, `IsDependent`/`IsHidden`/`LayersUsedInBlocks`, rule mặc định nới (`S-COLUMNS`, `A-ANNO-TEXT-0.25`, stem `KT` neo), regex timeout = ArgumentException, table finding bỏ qua kèm warning, LAYER_LOCKED có cấu trúc.

**Xác minh:** build 0 warning; `HPAutoCad.Aec.Tests` 179/179; `HPAutoCad.Mcp.Server.Tests` 193/193 (35 seed); live `run-aec-tools-live.ps1` 68/68 + `run-aec-edit-tools-live.ps1` 78/78 (AutoCAD 2026, 2026-09-17). Báo cáo: `plans/260916-1140-aec-automation-mcp-autocad/reports/phase-E-structural-live.md`, `phase-D-qaqc-live.md` § Review round.

## 2026-09-16 — McpShared: ETABS MCP engine constants, profiles, hints (phase 0 — additive only)

**Bổ sung:** `McpShared/` thêm hằng/profile/DTO/hint cho host thứ tư (ETABS 22, chưa code) — `PipeNaming.EtabsHost`, `JsonRpcMethods.EtabsPrefix`, `HostScriptContracts.Etabs{Imports,Globals,HeavyMaxTimeoutSeconds}`, `ContextResult.Etabs` + `EtabsInfo` (10 field), `ExecuteResult.Snapshot` (tên file snapshot), `AnalyzeRequest.Transaction` (forwarded qua `ToolLifecycleService`), `GuardProfile.Etabs`/`AnalyzerProfile.Etabs`, `IHostProfile.BridgeNotConnectedHint`/`TimeoutSemanticsHint` (hint text), `RequestDispatcher`/`McpBridgeHost` optional `executionDisabledMessage`, `McpServerHost.ConfigureOptions` seed `BridgeOptions.HostVersion` (phần engine không apply trước đó), `ScriptGuard.IsDeniedNamespace` strip tiền tố `global::` (pre-existing bypass, vá làm ETABS guard có tác dụng), `ResultFormatter.FromExecute` strip path khỏi `Snapshot`.

**Xác minh:** `tools/list` 3 host (Revit 33, AutoCAD 37, Navisworks 24) byte-identical sau rebuild; 5 test suite nguyên số: McpShared 96 + 60, HPRebar 109, AutoCAD 58, Navisworks 49 (= 372 cũ); McpShared Core.Tests 128 → **162** (thêm 34 test ETABS: `EtabsProfileTests`, `EtabsBridgeMessagesTests`, `EtabsTestProfile`). Build 0 error. Report: `plans/260916-2152-…/reports/phase-00-…`.

## 2026-09-16 — AutoCAD MCP: AEC phase D — QA/QC (`cad_standards_check`, `audit_aec_drawing`, `create_issue_markup`)

**Bổ sung:** `HPAutoCad.Aec/Standards/` (rule set JSON nhúng `cad-standards.default.json` hoặc file project `rules\cad-standards.json` qua `RuleFileLocator` dùng chung; checker thuần trên record + `DrawingTables`: layer_naming, entity_layer, layer_zero, color/linetype/lineweight_override, text_style, text_height, dim_style, block_naming, unused_layer → `STD-nnnn` thứ tự ổn định), `Issues/AuditIssue` (record chung, `Ordered` critical → warning → info, `AtLeast`), `Cad/AuditService` (một query, section geometry + standards, giữ id GEO-/STD-), `Cad/IssueMarkupService` (circle/rectangle/revcloud + MLeader `<id>: <mô tả>` trên layer `HP-MCP-ISSUES` tự tạo, màu theo severity, hai pha), `AecTools.Audit`; record thêm `Style`, `TextHeightMm`. 3 seed → server 40 tool.

**Xác minh:** build 0 warning; `HPAutoCad.Aec.Tests` 141/141; `HPAutoCad.Mcp.Server.Tests` 153/153 (28 seed); live `run-aec-tools-live.ps1` 63/63 (bước T) + `run-aec-edit-tools-live.ps1` 67/67 (bước K). Report `plans/260916-1140-…/reports/phase-D-qaqc-live.md`.

## 2026-09-16 — AutoCAD MCP: AEC phase C — 6 tool ghi (`create_entities_batch`, `update_entities_batch`, `manage_blocks_attributes`, `manage_annotations`, `manage_hatches`, `manage_xrefs`)

**Bổ sung:** `HPAutoCad.Aec/Model/EditResult` (edit envelope + `ItemOutcome` theo thứ tự input), `Cad/EditContext` (layer guard LAYER_LOCKED/LAYER_FROZEN, space, điểm mm, thuộc tính chung), `EntityFactory` / `EntityUpdater` / `BatchEditService` (atomic: validate hết → một item lỗi từ chối cả batch, không ghi gì; lỗi lúc ghi ném → bridge abort; `atomic:false` ghi phần hợp lệ), `BlockService` (định nghĩa, reference, attribute, dynamic property mm/độ), `AnnotationService` (text, mtext, dimension linear/aligned/angular/radial/diameter, mleader; delete chỉ annotation), `HatchService` (boundaryHandles / polygon / seedPoint, NOT_CLOSED, detectBoundary hình học), `XrefService` (list/resolveStatus/attach/detach/reload/unload/bind an toàn), `AecTools.Editing`; 6 seed `transaction: auto`, mô tả nêu side effect + dryRun. Server 37 tool. Harness mới `run-aec-edit-tools-live.ps1` (40 check).

**Review round (6/10 → sửa xong):** mọi write hai pha — pha 1 mở **đọc** (`OpenForEdit`: handle → layer → owner phải là layout, entity trong block definition bị từ chối `UNSUPPORTED_ENTITY`) + validate không mutate (`EntityUpdater.Validate`, `ValidateAttributes` kể cả layer của từng attribute reference), batch atomic bị từ chối để change counter = 0; pha 2 `Upgrade` + `Apply` với `changed` tích luỹ để báo trung thực khi lỗi giữa chừng. Op đơn lẻ từ chối toàn bộ khi có key sai (hatch update, setDynamic, detach); create đơn lẻ trả `EditResult.Refused` có mã thay vì ném. `SetDatabaseDefaults` trước layer/colour (H1); `Associative = true` trước `AppendLoop(ids)` — verified live hatch theo boundary di chuyển. Cap 64 KB: batch 200, references 100/trang, definitions 200, handles 100/20, attribute 8 × 120 ký tự, `Settle` liệt kê 20 lỗi + đếm, warning gộp theo item. `XrefPathPolicy` (đường dẫn đầy đủ, `.dwg`, không `..`, không tự tham chiếu; UNC cảnh báo), `ValidateSymbolName`. `EntityFilter.From` mặc định `space: all` khi có handles. Tách file > 300 dòng thành partial.

**Xác minh:** build 0 warning; `HPAutoCad.Aec.Tests` 122/122; `HPAutoCad.Mcp.Server.Tests` 136/136 (25 seed compile + validate + cap pin); live `run-aec-edit-tools-live.ps1` 62/62 sau review (trước review 40/40 (lần 1: 33/40 — `Hatch.Area` không đọc được trong transaction đang tạo → fallback diện tích boundary; script harness dùng `using var` top-level không compile dạng Roslyn script) — mọi op chạy dryRun + commit, lớp khoá/đóng băng/handle đã xoá trả lỗi có cấu trúc, `U` qua COM hoàn tác trọn batch; regression `run-aec-tools-live.ps1` 55/55. Report `plans/260916-1140-…/reports/phase-C-editing-live.md`.

## 2026-09-16 — AutoCAD MCP: AEC phase B — `classify_aec_entities` + `get_entity_relationships`

**Bổ sung:** `HPAutoCad.Aec/Classification/` (19 loại AEC, 3 discipline; rule JSON: layer/type/block wildcard, closed, size/aspect, regex text, nearby text làm evidence; rule set mặc định nhúng 26 rule AIA/NCS + tiếng Anh + tiếng Việt, override theo project ở `%AppData%\HPAutoCad\McpServer\rules\<name>.json`, validate khi nạp; `AecClassifier` chọn rule tốt nhất + alternatives + Unknown theo yêu cầu), `Relationships/RelationshipDetector` (intersect, connected có gap + confidence, near, inside, contains, touching, aligned/parallel/perpendicular theo trục chính), `Cad/ClassificationService`, `AecTools.Semantic`; 2 seed category `Aec`. Server 31 tool.

**Review round (6.5/10 → sửa xong):** `count` của relationships = tổng số quan hệ thật (`RelationshipOutcome.Total`), khử trùng lặp quan hệ đối xứng ngay trong vòng lặp khi tự-tập; mọi quan hệ có `locationMm` thật (không còn (0,0,0)); aligned/parallel/perpendicular trả `angleDeg` (aligned kèm offset `valueMm`); từ chối > 2 000 000 cặp trục; rule set mặc định v2 neo stem vào ranh giới tên (`*DAM*` từng bắt nhầm M-DAMPER; STRUCT/S-MONG/COTAS/A-CLNG-GRID/P-SANR-FIXT không còn bị xếp sai, CUASO → Window, ONGGIO → Duct); rule file từ chối list null, key sai chính tả, range âm; hoà điểm giữ thứ tự file; hình chữ nhật thay thế của block/text/dimension không phải footprint `closed`; text/attribute cắt 120 ký tự / 8 attribute; `classify_aec_entities` tối đa 50/trang, `get_entity_relationships` tối đa 250 (schema `maximum` khớp engine, test pin); một text index dùng chung cho hai tập + cảnh báo khi cắt 5 000 text; `ruleSet.source` không lộ đường dẫn profile; polyline lặp đỉnh đóng đọc đúng 4 đỉnh.

**Xác minh:** build 0 warning; `HPAutoCad.Aec.Tests` 100/100; `HPAutoCad.Mcp.Server.Tests` 97/97; live `run-aec-tools-live.ps1` 55/55 sau review round (trước review 51/51 (run 1: 47/51 — `AecObject.Record` `required` + `[JsonIgnore]` làm System.Text.Json từ chối serialize, đã sửa + test): 4 cột / 3 dầm / 9 tường / ống / block cửa phân loại đúng với evidence và kích thước, connected dầm→cột kèm gap 7 mm confidence 0.65, intersect ống×dầm, parallel tự-tập khử trùng lặp. Report `plans/260916-1140-…/reports/phase-B-semantic-live.md`.

## 2026-09-16 — AutoCAD MCP: AEC engine `HPAutoCad.Aec` + 5 tool AEC (plan 260916-1140, phase A)

**Bổ sung:** assembly `HPAutoCad.Aec` (net8.0-windows; geometry/spatial/issue thuần + adapter AutoCAD + facade `AecTools`) được bridge tham chiếu và đưa vào Roslyn (`CompilerReferences`, `AutocadImports` += `HPAutoCad.Aec`); 5 seed read-only (`transaction: none`): `get_drawing_context`, `query_entities` (filter wildcard + paging + detail/property selector), `query_entities_spatial` (10 quan hệ, tolerance override), `measure_geometry` (10 phép đo, dùng curve API chính xác), `detect_geometry_issues` (9 loại lỗi, issue `GEO-nnnn` có vị trí/giá trị/tolerance/gợi ý). Envelope camelCase `{success, summary, items, count, offset, truncated, warnings, errors[{code,message,handle}]}`; `GeometryTolerance` tập trung mọi ngưỡng; handle là định danh duy nhất. Server giờ 29 tool (4 core + 8 registry + 17 seed); profile thêm category Geometry, Audit. Test project `HPAutoCad.Mcp.Server.Tests` → net10.0-windows để tham chiếu Aec.

**Xác minh:** build 0 warning; `HPAutoCad.Aec.Tests` 54/54; `HPAutoCad.Mcp.Server.Tests` 83/83 (mọi seed compile với AutoCAD.NET + Aec); McpShared 128 + 60; Revit 109. Live AutoCAD 2026 `run-aec-tools-live.ps1` 42/42 (run 1: 30/33 — đếm sai entity của scene, `success` của measure; run 4 sau review: arc lật OCS −Z, polyline bulge, hatch, block có attribute, lưới 3 000 line: query lọc layer 92 ms, nearest 1000×1000 1.6 s, quét lỗi 158 ms) trên template inch nên chuyển đổi mm được kiểm thật; hồi quy `run-bridge-unattended` 21/21, `run-server-smoke` 22/22. Code review 7/10 → sửa hết 3 High (SpatialIndex bỏ sót item quá khổ, arc OCS −Z bị phản chiếu, trang mặc định vượt cap 64 KB) + 5 Medium + phần lớn Low, có test hồi quy `ReviewRegressionTests`. Chưa republish exe (bị khoá bởi MCP server đang chạy). Kế tiếp: phase B (classify_aec_entities, get_entity_relationships).

## 2026-09-16 — AutoCAD MCP bridge: Ribbon thu về kiểu Revit `HPAutoCad` ▸ `MCP` ▸ `MCP Bridge` (bundle 0.3.0)

**Thay đổi:** Tab `HPAutoCad` (id `HPAUTOCAD_MCP_TAB` giữ nguyên) ▸ panel `MCP` ▸ 1 nút `MCP Bridge` → `BridgeActions.Run("show")` (cùng delegate `HPMCPBRIDGE`), cùng bề mặt với ribbon MCP của Revit và Navisworks. Bỏ 3 panel / 10 nút của 0.2.0 (mọi nút đều là control có sẵn trong cửa sổ trạng thái) → xoá `RibbonStatusPresenter.cs`, `BridgeEntry.Ribbon.cs` (entry point `status.subscribe`/`copyLastScript`/`autoStart.*`/`path`), `BridgeActions.Query/OpenPath`, bước copy README vào bundle. Icon vector `DrawingImage` vẽ trong code (cửa sổ + phích cắm, cùng glyph với Navis; toạ độ chẵn nên 16 px = ½ 32 px; mực `#E6E6E6` theme tối / `#3C3C3C` theme sáng, accent `#0696D7`), tab rebuild khi `COLORTHEME` đổi.

**Xác minh:** `dotnet build HPAutoCad.slnx -c Debug` 0 warning; `run-ribbon-check.ps1` (viết lại) 12/12 PASS + 1 MANUAL (icon — 2 screenshot theo theme, đã xem: sắc nét cả hai): tab đúng 1 lần, vẫn 1 sau đổi workspace và sau đổi COLORTHEME, `MCP Bridge` mở cửa sổ, bấm lần 2 không mở cửa sổ thứ hai, loader.log sạch. Hồi quy: `run-bridge-unattended.ps1` 21/21, `run-server-smoke.ps1` 22/22.

## 2026-09-16 — `McpShared/tools/harness_common.py`: bookkeeping chung cho harness Python

**Thay đổi:** `Checklist` (check/skip/save/finish → PASS/FAIL/SKIP + JSON summary + exit code), `utf8_console()`, `ok`/`short`, re-export `Server`/`mcp_session`; 4 script (`HPNavis` live-verify/seeds-live/server-smoke, `HPAutoCad` live-verify) bỏ ~30 dòng lặp mỗi file và import theo đường tương đối. Shape JSON summary giữ nguyên các key wrapper đọc (`passed`, `total`, `failed`, `phase`…), thêm `skipped`/`skippedNames` ở mọi script. Self-test: `python McpShared/tools/harness_common.py`.

**Xác minh:** Navisworks: `run-server-smoke.ps1` PASS 9/9, `run-seeds-live.ps1` PASS, `run-live-verify.ps1 -WithNoDoc -IncludeIsolation` PASS (main 52, heavy 3, nodoc 1, isolation 3; modal skip vì `SetForegroundWindow` bị từ chối khi người dùng đang thao tác app khác — đường skip có sẵn). AutoCAD: `run-live-verify.ps1 -SkipRevit` wrapper 4 bước 0 fail, main 56/56. Không đổi code C#.

## 2026-09-16 — Harness AutoCAD dùng script stdio chung `McpShared/tools/`

**Thay đổi:** Xóa `HPAutoCad/tools/harness/{mcp-call.py, mcp-session.py}` (chỉ khác bản canonical ở docstring); `live-verify.py` import `../../../McpShared/tools/mcp-session.py`, `run-live-verify.ps1`/`run-server-smoke.ps1` gọi `McpShared/tools/mcp-call.py`; `plans/260915-…/reports/snapshot-tools-list.ps1` cũng trỏ sang đó. Chiều phụ thuộc giữ nguyên: thư mục MCP → `McpShared/`, không có bản copy nào khác trong repo.

**Xác minh:** `python McpShared/tools/mcp-call.py <AutoCAD exe> tools/list` → 24 tools; `HPAutoCad/tools/harness/run-live-verify.ps1 -SkipRevit` live trong AutoCAD 2026: main A–D 56/56, disabled 1/1, nodoc 1/1, busy 2/2 (wrapper 4 bước, 0 fail; Revit không chạy nên E bỏ qua — lần chạy đầy đủ trước đó chỉ fail 2 check E vì bridge Revit chưa mở); `run-server-smoke.ps1` 22/22 (lần đầu pipe không lên vì AutoCAD khởi động sau khi bị kill — hiện tượng môi trường, chạy lại PASS). Sửa kèm: bước nodoc retry `ActiveDocument.Close` 5 lần khi AutoCAD trả `RPC_E_CALL_REJECTED`. Không đổi code C#.

## 2026-09-16 — Navisworks MCP bridge: Ribbon tab "HPNavis" ▸ "MCP" ▸ "MCP Bridge" (plan 260916-0005-navisworks-ribbon-tab)

**Bổ sung:** `HPNavisRibbonPlugin : CommandHandlerPlugin` (`[RibbonLayout("HPNavisRibbon.xaml")]`, `[RibbonTab("ID_HPNAVIS")]`, `[Command("ID_HPNAVIS_MCP_BRIDGE", CallCanExecute = Always)]`) mở/activate cửa sổ bridge — cùng bề mặt 1 nút như ribbon MCP Revit, nhãn English. Layout `Ribbon/en-US/HPNavisRibbon.xaml` (XAML của Navisworks, `<Page Remove>` khỏi WPF markup compile) + `HPNavisRibbon.name`; icon `Ribbon/Images/McpBridge_16|32.png` render pixel-exact từ 1 glyph vector (cửa sổ + phích cắm, ink #3C3C3C / accent #0696D7) bằng `tools/icons/render-ribbon-icons.ps1`. `HPNavisWindowPlugin` → `AddInLocation.None` (hết trùng nút Add-ins, vẫn `ExecuteAddInPlugin`). Deploy target sẵn có copy `en-US\` + `Images\`.

**Xác minh:** `run-ribbon-check.ps1 -WithNoDoc` 2026-09-16: 14 PASS, 0 FAIL, 1 MANUAL (screenshot icon — sắc nét): tab đúng 1 lần, không cửa sổ trước khi bấm, bấm → cửa sổ + log `MCP bridge status window opened`, bấm lần 2 → 1 cửa sổ, không còn mục Add-ins, không ERR/FTL; không có model → Navisworks tự làm mờ mọi tab (start page). Tests `HPNavis.McpBridge.Tests` 135 (+11 `RibbonPluginTests`: attribute ⇔ XAML id ⇔ `.name` ⇔ PNG 16/32 RGBA, `AddInLocation.None`, file copy vào `en-US\`/`Images\`). Hồi quy: `run-live-verify.ps1` + `run-bridge-unattended.ps1` (xem report). Harness: `Find-RibbonTabHeaders`/`Select-RibbonTab` (Invoke → SelectionItem, verify nút hiện) /`Wait-RibbonButtonVisible`/`Count-BridgeWindows`/`Save-RibbonScreenshot`, `Start-NavisworksWithModel -showWindow`.

## 2026-09-15 — Navisworks MCP (plan 260915-0824-navisworks-mcp-2026, phases 0–5)

**Bổ sung:** `HPNavis/` — plugin `HPNavis.McpBridge` (net48) trong Roamer.exe + server `HPNavis.Mcp.Server` (net10, stdio) với `NavisHostProfile`, 24 tools (4 core + 8 registry + 12 seed nhúng: 8 read-only, 3 review edit, 1 heavy `create_and_run_clash_test`), resources `navis://document/info`/`navis://selection`, prompts `navis_query_template`/`navis_review_template`. Engine `McpShared/`: `HPRebar.Mcp.Contracts` multi-target `netstandard2.0;net48`, `HPRebar.McpBridge.Core` `net8.0;net48` (`PipeSecurity` ACL, `MainThreadQueue(expireWithoutTicks)`), `HostScriptContracts.NavisHeavyMaxTimeoutSeconds = 600`, `McpShared/tools/` (script stdio host-neutral). Undo policy commit-rồi-`Rollback()` chỉ khi `NextUndo` là entry của bridge; heavy gate với opt-in thứ hai; quiescence bằng Progress depth + `IsWindowEnabled`.

**Xác minh:** live trong Navisworks Manage 2026: bridge 43 check ×2 + no-doc, server smoke 9/9, seeds 18/18 + 2/2, live-verify 62 pass trên run 2–4 (run 1: 59 + 1 fail ở assertion của harness) (execute matrix, mọi seed, registry loop MISS→propose→test→publish→CLI approve→list_changed 0.5 s→gọi theo tên, quarantine→restore→newVersion, heavy proposal bị từ chối, modal, heavy ON clash 3 015 kết quả + append, no-doc, isolation Roamer thứ hai + gỡ plugin). Hồi quy: Revit 33 / AutoCAD 24 `tools/list` byte-identical với snapshot phase 0 sau rebuild Release; tests 128 + 60 + 109 + 58 + 124 + 49. Chưa làm: Ribbon tab Navisworks (quyết định để sau phase 5).

## 2026-09-14 — AutoCAD MCP bridge: Ribbon tab "MCP AutoCAD" (plan 260914-2204-autocad-ribbon-tab)

**Bổ sung:** Ribbon tab "MCP AutoCAD" (bundle 0.2.0) in the loader via Autodesk.Windows (compile-time only). Tab id `HPAUTOCAD_MCP_TAB`; three panels (Kết nối: status window, start/stop, status, live label; Công cụ: copy last script, tool library; Thiết lập: logs, audit, auto-start toggle, guide); 9 buttons + 1 live label, all forward to bridge entry points (status.subscribe, copyLastScript, autoStart.get/set, path, show/start/stop/status). Entry points cross ALC via BCL types only. No CUIx modification. Tab lifecycle: created once on Ribbon init, re-created after workspace switch (SystemVariableChanged → Idle → EnsureCreated guard), guarded against duplication, removed on Terminate. Icons are vector drawings in code. When bridge unavailable, Ribbon buttons disabled with tooltip.

**Xác minh:** Live run 2026-09-14 via `run-ribbon-check.ps1` 8/8 (UIA automation): tab exactly once, survives workspace round trip, Bật listener → pipe up, Tắt → down, Bảng điều khiển → window, Trạng thái clean. Regressions: bridge 21/21 (`run-bridge-unattended.ps1`), server 22/22 (`run-server-smoke.ps1`, now accepts approved tools ≥ 24). Build 0 warn/err (HPAutoCad.McpBridge.Loader.csproj, -UseWPF, -DeployBundle copy README.md). Tests: 263 total (96 McpShared, 109 HPRebar MCP, 58 AutoCAD). Code: loader 6 files / 398 LOC (BridgeActions 78, McpRibbonTab 181, RibbonStatusPresenter 52, RibbonCommandHandler 27, RibbonIcons 65), bridge BridgeEntry.Ribbon 71; harness +run-ribbon-check.ps1 98 + harness-common.ps1 +49 helper functions.

**Load-bearing gotchas for future work:**
- `UseWPF` on the loader removes implicit `System.IO` using → add explicitly
- AdWindows exposes Ribbon tab header as `Button` with `AutomationId=tab id` (not `TabItem`)
- RibbonButton is `Button` named after its text once tab selected
- `SendCommand('_.WSCURRENT …')` over COM never returns → use `ActiveDocument.SetVariable('WSCURRENT', …)` instead
- Workspace switch drops code-added tabs → loader re-creates them automatically

**Các quyết định:**
- Ribbon entry points BCL-only: `Func<Action<string,string>, Action>` (status.subscribe), `Func<string>` (show/status/copyLastScript/path), `Func<bool>` (autoStart.get), `Action<bool>` (autoStart.set) — no bridge types cross ALC
- Commands + buttons share `BridgeActions` runner to prevent duplication
- Tab never duplicates via `FindTab` guard + `EnsureCreated` logic
- Not on Ribbon: opt-in checkbox (stays in window, OFF on load), tool-run button (server owns tools, never bridge)
- Icons: vector DrawingImage in code, no external image files

**Bước tiếp:**
- Ribbon plan (260914-2204) complete on top of the finished bridge plan (260913-0000, phases 0–5)
- Phases 4–5 known gaps remain: Revit opt-in runtime unverified (harness E1 skipped), Revit 2025, AutoCAD 2026 Update 1.2 (.NET 10), modal dialog + ESC-retry, per-run undo
- Next: user smoke test in live AutoCAD (normal Start menu launch, clicks while command waits, clipboard/Explorer effects)

**Commits:** e5fae0a feat (ribbon + 4 entry points + bundle 0.2.0), phased into [`plans/260914-2204-autocad-ribbon-tab/`](../plans/260914-2204-autocad-ribbon-tab/plan.md).

---

## 2026-09-14 — AutoCAD MCP bridge phase 5: live verification harness + stability-window fixes, plan complete

**Bổ sung:** Live verification harness (unattended) tại `HPAutoCad/tools/harness/` — `run-live-verify.ps1` + `live-verify.py` + `mcp-session.py` (≈560 + 120 + 150 lines) dùng một stdio MCP session để chạy 65 scenario (64 pass + 1 skip) trên registry riêng (isolated `output/live-verify/`) sinh động trong AutoCAD + Revit: execute matrix 18 (none/dryRun/commit, exception, none+modify, manual, guard trên `GetPoint`/`Commit`/`SendStringToExecute`, compile error, `cancel_execution` racing, timeout 5s, **busy → ESC posted → retry automated**, no drawing, audit), every seed 18 (real block, pickfirst set, dryRun), MISS → ad-hoc code + `propose_tool` → `test_tool` → `publish_tool` → CLI approve → `tools/list_changed` in 0.5s → call by name, fragile tool (unguarded `eKeyNotFound`) → 5× fail → quarantine → `manage_tool restore` + `propose_tool newVersion` (guarded, `ArgumentException`) → re-approve → stays published on 5× fail, Revit exe beside (34 tools, Revit lib hash unchanged, opt-in off → E1 skipped), isolation (second AutoCAD fails fast naming host, Civil 3D never loads).

**Stability window fixes (engine, both hosts):** Runs với lỗi `Argument…Exception:` không được tính (là lỗi caller, không tool), window restarts ở lifecycle event cuối (approved/published/restore/proposed_version/imported/status_changed), restored tool không bị re-quarantine bởi lỗi cũ. Hai defect tìm live: (1) seed `insert_block` bị quarantine bởi smoke tests của chính nó — fixed by excluding arg errors; (2) restored tool `mcp_verify_count_block_refs` bị re-quarantine ngay lần chạy đầu — fixed by restarting window at lifecycle event. Harness chạy registry isolated (không chạm `%AppData%` live) với flag `-IncludeIsolation` / `-OnlyIsolation` / `-SkipRevit` / `-UseLiveRegistry`.

**Xác minh:** Live run 2 (sau 2 engine fix) = 64 pass + 1 skip (Revit opt-in off) + isolation 4/4 + bridge regression 21/21; run 3 trên registry isolated: 64 pass + 1 skip. Build zero warn/err. Tests: McpShared 96/96, HPRebar MCP 109/109, AutoCAD 58/58 (263 total). Code review 7.5/10 → 16 actionable findings fixed; majors: the two engine fixes, harness registry isolation, pid-scoped cleanup. Open: Revit opt-in with new engine unverified at runtime (harness E skip); Revit 2025; AutoCAD 2026 U1.2 (.NET 10); modal dialog while waiting; per-run undo; `HPRebar/output/…exe` not republished (locked by running `hprebar-revit` MCP).

**Các quyết định:**
- Stability window logic: lỗi `Argument…Exception` do script tự từ chối đối số là lỗi caller, không phải tool failure → exclude khỏi quarantine check; window restart ở cuối lifecycle event mình = approved/published/restore/proposed_version/imported/status_changed từ bất cứ nguồn (manual edit `tool.json` triggered reload writes event, manual CLI action, etc.)
- Harness: one stdio session vì `notifications/tools/list_changed` chỉ reach running server; registry isolation = env var override LibraryPath + DbPath để server + CLI không chạm user's %AppData%; pid guard cleanup to avoid killing user-opened processes; `-UseLiveRegistry` opt để bypass isolation khi user muốn test on live registry
- Bridge `RequestDispatcher.HostVersion` + pipe-in-use message names host + version; Revit bridge log sink `shared: true` like AutoCAD
- `ToolRegistryDb` split: schema/search (cs) + runs/stability (Runs.cs partial)

**Commits:** d8507e8 feat (harness + engine fixes), 1b2ba8b fix (16 review findings). Plan: [`plans/260913-0000-autocad-mcp-bridge-2026/`](../plans/260913-0000-autocad-mcp-bridge-2026/plan.md) (phases 0–5 of 6 done, **plan complete**).

## 2026-09-14 — AutoCAD MCP bridge phase 4: registry per host profile + 12 seed tools

Bổ sung: Registry engine per `IHostProfile` (categories, reserved names from profile, host stamp); 12 embedded AutoCAD seed tools (6 read-only: list_layers, list_block_definitions, get_entities, list_layouts, get_drawing_info, get_selected_entities; 6 auto-transaction: draw_polyline, draw_circle, add_text, create_layer, insert_block, add_linear_dimension) installed into `%AppData%\HPAutoCad\McpServer\tools-library\` on first run across 7 categories (Drawing, Layer, Block, Annotation, Layout, Data, Generic); `SeedLibraryTests` 58 xUnit tests compile every seed against AutoCAD.NET 25.1.0 with bridge's exact imports/globals (0 skipped); meta-tool descriptions host-neutral (8 engine tools + inspect_type title worded for any host).

**Xác minh:** Live smoke harness `run-server-smoke.ps1` 22/22 (all 12 seeds by name, category filters, dryRun, layer round-trip), code review 7.5/10 with 12 actionable findings fixed the same day (no re-score), zero crashes, no .NET Runtime 1026 event. Tests: McpShared 95/95, HPRebar MCP 106/106, AutoCAD 58/58 (259 total). Build zero warn/err. Registry per host: `registry stats` prints `host: autocad (AutoCAD)` on AutoCAD server. Revit tools/list 34 names/schemas/annotations byte-identical to phase 0 (descriptions of 8 + title differ).

**Các quyết định:**
- `IHostProfile.CliExecutable` names the exe in every human instruction (publish_tool message, _review/*.md, CLI usage banner); defaults from assembly name if not overridden (Revit explicit `HPRebar.Mcp.Server.exe`, AutoCAD `HPAutoCad.Mcp.Server.exe`)
- Seed points as `{x, y}` objects not `[x, y]` arrays; mm at every edge via `ScriptUnits.ToDrawing/ToMm`; guard denies `StartTransaction/Commit/Abort/LockDocument`, `ed.Get*`
- No seed creates missing layer — clear error "run create_layer first"; only the `autocad_modify_template` prompt auto-creates
- Seed contract: no `tr` open/close (guard catches `UsesTransaction`), reads via `GetBlockModelSpaceId`, writes via `db.CurrentSpaceId` + `AppendEntity` + `AddNewlyCreatedDBObject`
- New `Validate(record, analysis, existing, newVersion, profile)` overload; the four-argument overload keeps the Revit behaviour locked (tests unchanged)

**Commits:** 69e3505 feat (engine + 12 seeds), f257071 fix (12 review findings). Plan: [`plans/260913-0000-autocad-mcp-bridge-2026/`](../plans/260913-0000-autocad-mcp-bridge-2026/plan.md) (phases 0–4 of 6 done).

## 2026-09-14 — AutoCAD MCP bridge phase 3: server exe over stdio

Bổ sung: `HPAutoCad.Mcp.Server` (net10 console exe) + `AutocadHostProfile` (12 tools: 4 core + 8 registry, `autocad://` resources, 2 prompts), registry root `%AppData%\HPAutoCad\McpServer\`, pipe `hpautocad-mcp-2026`, env prefix `HPAUTOCAD_MCP_`. Core: `ContextService.Shape` drops `revitVersion`/`isFamily` for non-Revit hosts (wire unchanged, Revit output byte-identical, regression test 89/89).

**Xác minh:** Publish exe 7.4 MB, stdio harness 7/7 ×2 (lead + tester): initialize, 12 tools/list, context without Revit fields, execute none/dryRun/real with runId + hint, get_run from registry.db. Revit exe 34 tools unchanged with Revit 2026 running side-by-side. Build zero warn/err. Tests: AutoCAD 8/8 + McpShared 89/89 + HPRebar MCP 106/106 (203 total). Harness files (`mcp-call.py`, `run-server-smoke.ps1`, `run-bridge-unattended.ps1`, `harness-common.ps1`) live in repo.

**Các quyết định:**
- `revitVersion`/`isFamily` hidden in `ContextService.Shape` (non-Revit hosts); Revit: wire unchanged, output byte-identical
- `IsModifiable` documented in Contracts XML comment + descriptions per host (Revit: transaction open; AutoCAD: writable + quiescent)
- Description length 1717 chars (AutoCAD contract needs `tr`/deny/units/semantics; plan budget ~1200, real budget 1800)
- Harnesses in repo (Python + PowerShell 7.3+, JSON quoting safe, depth guards)
- `.mcp.json` entry user adds (untracked); snippet in `HPAutoCad/README.md` + smoke report

**Những chưa làm:**
- Engine meta-tool descriptions still say "Revit"/`execute_revit_code` (phase 4: host-neutral wording or profile-driven text)
- Seed tools for AutoCAD (phase 4)
- R27 AutoCAD support (not planned)

**Các gaps được chấp nhận:**
- `runId`/`hint` branch exercised only by live smoke, not by xUnit (registry-less `ExecuteCodeService` in tests; phase 4 will add AutoCAD test with temp-dir `ToolManager`)
- Modal dialog while waiting + ESC-then-retry (phase 5 manual)
- Per-run undo (needs `ExecuteInCommandContextAsync`, phase 5)

Plan: [`plans/260913-0000-autocad-mcp-bridge-2026/`](../plans/260913-0000-autocad-mcp-bridge-2026/plan.md) (phases 1–3/6 done).

## 2026-09-14 — AutoCAD MCP bridge phase 2: bridge runtime

Bổ sung: `MainThreadExecutor` (Application.Idle + IsQuiescent, PostMessage WM_NULL wake, busy grace 8 s), `AutocadScriptRunner` (outer = group, inner = `tr`, commit inner trước quyết định outer, dryRun rollback), `DatabaseChangeCounter` (HANDSEED + ObjectOpenedForModify + IsErased, không giữ wrapper), `AutocadContextReader`/`AutocadResultSerializer` (entities, ObjectId handles, units mm ↔ drawing), XAML status window (theme dark/light override, per-session opt-in "Allow AI code execution"), Core `MainThreadQueue` + `BridgeRequestException` + `AutocadInsunits` + guard deny `StartTransaction`/`LockDocument`.

**Xác minh:** Build zero warn/err, tests McpShared 88/88 + HPRebar MCP 106/106, harness unattended 21/21 (lead + tester independent), AutoCAD 2026 R25.1, 234+ audit lines, zero crashes.

**Các quyết định:**
- ADR-03 Accepted (revised): outer transaction = TransactionGroup role, inner = `tr`, inner commit → event fire → count → outer decision; `transaction=manual` chạy như `auto` + cảnh báo, guard deny `StartTransaction` (vì finalizer crash ở GC thread)
- `transaction=none`: vẫn mở transaction (read cần tr ở AutoCAD), luôn abort, sửa như Revit nếu modified
- Undo merged per user command trong lock "HPMCP"; per-run undo out of MVP
- Idle one-shot, busy grace bị cắt bớt (tester #2), bỏ BusyGrace default 10s → enforce deadline

**Những chưa làm:**
- Modal dialog + ESC-then-retry (phase 5 manual)
- Per-run undo (needs `ExecuteInCommandContextAsync`)
- `IsModifiable` semantics document (phase 3)

Plan: [`plans/260913-0000-autocad-mcp-bridge-2026/`](../plans/260913-0000-autocad-mcp-bridge-2026/plan.md) (phases 1–2/6 done).

## 2026-09-14 — AutoCAD MCP bridge phase 1: loader, ALC, bundle, spike

Bổ sung: loader DLL với BridgeLoadContext (Roslyn 5.9 + Immutable 10 riêng, AutoCAD API shared), self-check startup, 4 core command (HPMCPBRIDGE/STATUS/START/STOP) + spike 2 command tạm thời, bundle 24 file / 14 MB → `%AppData%\Autodesk\ApplicationPlugins\`. Spike chạy 5/5 lần ×3 run liên tiếp, cuối cùng unattended (SECURELOAD auto-click, `Document.CloseAndDiscard()` + `Quit()` exit code 0).

**Xác minh:** Build zero warn/err, tests 70+106+334 xUnit pass, live in AutoCAD 2026 (2026-09-14).

**Các quyết định:**
- ADR-02 Accepted: Idle one-shot, timeout hủy subscribe (không để hang), executor rule: complete request trước unsubscribe
- ADR-05 Accepted: SECURELOAD prompt trên mỗi hash loader mới → "Always Load"; signing hoãn tới pack phase
- Spike gated `HPAUTOCAD_MCP_SPIKE=1` env var; xóa ngay khi phase 2 đâm ống listener

**Những chưa làm:**
- Pipe listener + executor (phase 2)
- MCP server exe + tools (phase 3)
- Modal dialog + Dynamo coexistence test
- Multi-version (R26/R27)

Plan: [`plans/260913-0000-autocad-mcp-bridge-2026/`](../plans/260913-0000-autocad-mcp-bridge-2026/plan.md) (phase 1/6 done).

## 2026-09-14 — Tách MCP engine host-neutral, scaffold AutoCAD

Refactor hạ tầng MCP để dùng chung cho Revit + AutoCAD. Tách engine (neutral với host) ra thư mục `McpShared/` cấp cao nhất; tạo scaffold `HPAutoCad/` để bắt đầu bridge AutoCAD.

Plan: [`plans/260913-0000-autocad-mcp-bridge-2026/phase-00-…`](../plans/260913-0000-autocad-mcp-bridge-2026/plan.md) (phase 0 xong; phase 1–5 tiếp theo).

### Thêm

- **`McpShared/`** (thư mục cấp cao nhất, slnx + global.json riêng):
  - `HPRebar.Mcp.Contracts/` (moved từ HPRebar) — netstandard2.0, hợp đồng dây JSON-RPC.
  - `HPRebar.McpBridge.Core/` (moved, refactor) — net8.0, pipe listener/dispatcher, guard/compiler, `BridgeSettingsStore`, `RequestDispatcher` dispatch theo method suffix (`revit.*` vs `autocad.*`), `IHostProfile` interface mới, `HostNeutralityTests`.
  - `HPRebar.Mcp.Server.Core/` (NEW) — net10.0 class lib, `McpServerHost` builder pattern, `HostProfile` abstraction, `ExecuteCodeService`/`ContextService`, Registry engine (`ToolRecord.Host/HostVersions`, SQLite WAL+FTS5), 4 core tool + registry CLI.
  - `HPRebar.Mcp.Server.Core.Tests/` (NEW) — net10.0 xUnit v3, 70 test: host-neutrality, guard/compiler/args/analyzer, HostProfile binding, registry store/db/manager, pipe round-trip fake executor.

- **`HPAutoCad/`** (thư mục cấp cao nhất, slnx + global.json, scaffold):
  - `HPAutoCad.slnx` reference `../McpShared/...` projects only.
  - `README.md` ghi layout, không có project class C# chưa.

### Sửa

| Vấn đề | Xử lý |
|---|---|
| HPRebar.Mcp.Server bị phồng (server + registry + pipe client) | Tách pipe client + registry → McpShared; server nay là thin exe (Program.cs một dòng) |
| Registry instance-per-app (Revit 2026 lúc này) | HostProfile dùng chung, registry root = `%AppData%\<Product>\McpServer` |
| Server build từ HPRebar cwd, khó test riêng | McpShared.slnx độc lập, test từ `cd McpShared && dotnet test` |
| Revit ↔ AutoCAD share pipes/registry mà không có cách select | RequestDispatcher routing: method prefix suffix xác định executor (`revit.execute` ≡ `autocad.execute`, ngoài các tool factory/impl riêng) |

### Bỏ

- HPRebar.Mcp.Server không còn phụ thuộc trực tiếp `HPRebar.McpBridge.Core`, `HPRebar.Mcp.Contracts` (khác HPRebar folder).
- Hard-code "HPRebar"/"Revit" ở vài chỗ error string (engine chỉ biết host qua HostProfile).

### Hoãn

- AutoCAD bridge + server implementation (phase 01–02 chưa làm).

### Giới hạn

- McpShared test chạy từ McpShared cwd (global.json pin), HPRebar test chạy từ HPRebar cwd.
- Revit bridge DLL chưa rebuild → vẫn dùng được exe mới (backward compatible).
- Deploy builder auto-generate `Solutions.HPRebar` via Sourcy thay cho scan repo — phần này cần verify HPAutoCad tương tự.

## 2026-09-04 — Tích hợp NotebookLM (`notebooklm-py`)

Nối `teng-lin/notebooklm-py` 0.8.2 (MIT, unofficial) vào repo trên ba mặt, kèm pipeline nạp tài liệu Revit của repo lên notebook rồi kéo học liệu về.

Plan: [`plans/260904-1038-install-notebooklm-py-integration/`](../plans/260904-1038-install-notebooklm-py-integration/plan.md) · Docs: [`docs/notebooklm-integration.md`](notebooklm-integration.md)

### Thêm

- **Agent skill** `.claude/skills/notebooklm/` + mirror `.agents/skills/notebooklm/` — SKILL.md 60 → 61 ở cả hai cây.
- **MCP server** — `.mcp.json` đầu tiên của repo, 38 tool qua `uvx --from "notebooklm-py[mcp]"`.
- **Python surface** — venv riêng `scripts/.venv`, wrapper `scripts/notebooklm_client.py`, pipeline `scripts/build-notebooklm-course-assets.py` + manifest allow-list.
- **`tests/notebooklm/`** — 24 test `unittest`, chạy được bằng system Python (không cần `notebooklm`, không chạm mạng).
- **`docs/notebooklm-integration.md`** — cài lại từ máy trắng, version pin, bẫy đã dính.

### Sửa

| Vấn đề | Xử lý |
|---|---|
| `privacy-block` chỉ khớp `.env*` và `/credentials/i` — cookie Google đọc thoải mái | Thêm `storage_state.json` + `master_token.json` vào `privacy-checker.cjs` |
| `npx skills add` clone cả repo upstream (111 MB) kèm `CLAUDE.md`/`AGENTS.md` lồng trong `.claude/skills/` | Cắt còn `SKILL.md` + `LICENSE` (28K); ghi bước cắt vào plan |
| `generate_quiz`/`generate_flashcards` không nhận `language` → `TypeError` giữa chừng sau khi quota đã tiêu | `generate_and_wait` lọc kwarg theo chữ ký thật, log cảnh báo khi bỏ |

### Ghi chú

- Credential nằm ngoài worktree (`~/.notebooklm/`) — cố ý, để commit nhầm là bất khả thi về cấu trúc.
- Tài khoản là tier Pro (đo được: 300 source/notebook, 500 notebook), không phải free như plan giả định ban đầu.
- `AGENTS.md` đang lệch `CLAUDE.md`; re-sync là việc của plan `260823`.

## 2026-09-04 — Column Rebar (port từ `R01_ColumnsRebar`)

Feature đầu tiên của HPRebar. Port tool `R01_ColumnsRebar` (~19.5k dòng, .NET 4.8, Revit 2021, MVVM tự viết) sang Nice3point SDK + CommunityToolkit.Mvvm, đa version R23–R27.

Plan: [`plans/260903-2307-port-column-rebar-to-hprebar/`](../plans/260903-2307-port-column-rebar-to-hprebar/plan.md)

### Thêm

- **`HPRebar.Core`** (netstandard2.0) — toán thuần, không reference Revit. 25 file / ~1.5k dòng. 99 test xUnit.
- **`HPRebar.Core.Tests`** — xUnit v3 + Microsoft.Testing.Platform.
- **`HPRebar.Tests`** — TUnit chạy in-process trong Revit. 16 test, hiện skip hết vì thiếu model mẫu.
- **Feature `Column Rebar`** — 77 file / ~6.5k dòng: đọc hình học, 14 rule kiểm tra, tạo thép chủ + đai + đai phụ, tạo view/dimension/bảng thống kê, UI 8 tab, 4 control preview.
- **Theme** — `Resources/Themes/` 8 file, Dark + Light, theo `UIThemeManager` của Revit.
- **Song ngữ EN/VN** — đổi runtime, không đóng dialog.
- **Serilog file sink** → `%LocalAppData%\HPRebar\logs\`, xoay theo ngày, giữ 7 file.
- **`.gitattributes`** — git-lfs cho `*.rvt`/`*.rfa`/`*.rte`; ép LF cho fixture skill-sync.

### Sửa (bug có trong tool gốc)

| # | Bug | Ảnh hưởng |
|---|---|---|
| B1 | `GetErrorColumns` gán `error =` 15 lần không `return` | Báo lỗi **cuối cùng** thay vì lỗi đầu tiên user gặp |
| B2 | `IsnotVerticalColumns` `return` trong vòng `for` | Chỉ kiểm tra cột đầu tiên |
| B3 | 5 chỗ `OrderBy` không gán kết quả | `zb`/`hb` đọc từ mặt dầm bất kỳ, không phải mặt thấp nhất |
| B4 | `BarMainModel.cs:61` `Bar = Bar;` tự gán | Tham số `rebarBarModel` bị vứt |
| B5 | `GetWallBoudingBoxOneColumn` so `ElementId` với `Level` | Luôn true → không bao giờ tìm thấy tường đỡ cột |
| B6 | `double.Parse(UnitFormatUtils.Format(...))` ở 7 chỗ | Đổi đơn vị qua chuỗi, phụ thuộc culture |
| — | `CreateAddVerticalStirrupRectangleType1Item` dùng `BarH` thay `BarV` ở cả 4 chỗ | Đai phụ dọc dựng bằng shape của đai phụ ngang |

### Bỏ

- `WpfCustomControls` + `DSP` (dependency ngoài) — thay bằng CommunityToolkit.Mvvm + `RevitUnits`.
- `System.Windows.Forms.MessageBox` → `TaskDialog`.
- TaskBar (logo / YouTube / Account).
- Start/End section view (bản gốc đã comment out).
- Combobox chọn rebar shape ở tab Setting — bản gốc ép về `M_T1`/`M_T3` nên là UI chết.
- `ViewSchedule` cho detail component — bản gốc lọc field theo tên chuỗi tiếng Anh, hỏng trên Revit khác ngôn ngữ; chỉ phục vụ detail shop vốn chưa làm.

### Hoãn

- **Đường `IsRebar = false`** (thay thép thật bằng Detail Item `DT00..DT07A`) — cần family riêng của tác giả gốc mà repo không có.
- **Detail shop** (`DS*` family) — cùng lý do.
- **Thép gia cường (AddBar)** — chưa có ở Core.
- **Nav icon PathGeometry** — nav hiện chỉ có text.

### Giới hạn — đọc trước khi dùng

**Chưa có phiên bản Revit nào được verify runtime.** Build sạch 5/5 config (Debug + Release, 0 error, 0 warning CS) là bằng chứng duy nhất hiện có.

- Máy dev chỉ cài Revit 2025 + 2026 → R23/R24/R27 **build-only**.
- 16 TUnit test skip hết vì thiếu `HPRebar.Tests/Fixtures/column-stack-2-storey.rvt`.
- Rủi ro cụ thể chưa đo được: hack `SURFACE→LINEAR` trong `DimensionCreator` (undocumented, chưa chạy lần nào), `FormattedText` trên net48, Polyfill `MinBy` trên net48, .NET 10 runtime của R27.
