Lightingsang/AddinRebar/.agents/worker_m1_fix_hpbim/BRIEFING.md

# BRIEFING — 2026-10-06T00:25:00Z

## Mission
Fix the 5 reviewer & challenger issues in HPBim.Core for Milestone 1 Iteration 1.

## 🔒 My Identity
- Archetype: teamwork_preview_worker
- Roles: implementer, qa, specialist
- Working directory: g:\09-PROJECT AI\01_Revit\02_CshapRevit\01_AddinRebar\.agents\worker_m1_fix_hpbim
- Original parent: f21aade0-effc-4aa5-a071-ae17d49dabe3
- Milestone: M1 (Milestone 1 Iteration 1 Fixes)

## 🔒 Key Constraints
- Fix issues in Vector2D, Point2D, Point3D, Polygon2D, QcClashDetector, ClearanceChecker
- Methods <= 50 lines, classes <= 300 lines, 0 empty catches, 0 Revit references in HPBim.Core
- Target netstandard2.0 with Polyfill 11.0.1 and TreatWarningsAsErrors=true
- Genuine implementations, no hardcoding, self-test in handoff

## Current Parent
- Conversation ID: f21aade0-effc-4aa5-a071-ae17d49dabe3
- Updated: 2026-10-06T00:25:00Z

## Task Summary
- **What to build**: Fix 5 items identified in M1 review: Vector2D infinite recursion in JSON, Point2D/Point3D JsonConstructor/property mapping, Polygon2D JsonConstructor & JsonIgnore on computed properties, QcClashDetector multi-storey partition & slicing beam & zero-length wall guard, ClearanceChecker multi-storey opening vs column & zero-length wall guard.
- **Success criteria**: All fixes applied cleanly, builds with 0 errors/warnings on HPBim.slnx -c Release, BimModelSerializer round-trip self-test passes, handoff.md created, progress.md updated.
- **Interface contracts**: HPBim.Core geometry & QC contracts.
- **Code layout**: HPBim/src/HPBim.Core/

## Key Decisions Made
- Added `[JsonIgnore]` and `[JsonConstructor]` to `Vector2D`, `Point2D`, `Point3D`, and `Polygon2D` to ensure seamless JSON serialization and accurate coordinate restoration.
- Added `[JsonIgnore]` on computed properties in `Polygon2D` (`Perimeter`, `SignedArea`, `Area`, `Centroid`, `BoundingBox`, `IsClockwise`, `IsCounterClockwise`, `VertexCount`).
- Fixed `Polygon2D.Contains(pt, includeBoundary)` to return `includeBoundary` when the point lies on any boundary edge so `includeBoundary: false` correctly rejects perimeter boundary points.
- Refactored `QcClashDetector` to check level equality on Column vs Opening and Beam vs Slab, guard against zero-length walls (`wall.Length <= 1e-4`), and decomposed methods so all methods <= 50 lines.
- Updated `ClearanceChecker` to verify level equality on Opening vs Column, guard against zero-length walls, and decomposed methods so all methods <= 50 lines.
- Added `Length` property alias to `WallDef` and `BeamDef`, and `[JsonIgnore]` on all computed DTO properties.

## Artifact Index
- DISPATCH.md — assignment details
- BRIEFING.md — persistent working memory
- progress.md — liveness heartbeat
- handoff.md — final handoff report

## Change Tracker
- **Files modified**:
  * `HPBim/src/HPBim.Core/Geometry/Vector2D.cs`: Added `[JsonConstructor]`, `SquaredLength`, and `[JsonIgnore]` to `Length`, `LengthSquared`, `SquaredLength`, `LeftNormal`, `RightNormal`, `AngleRad`, `AngleDeg`.
  * `HPBim/src/HPBim.Core/Geometry/Point2D.cs`: Added `[JsonConstructor]` to constructor matching `X`, `Y`.
  * `HPBim/src/HPBim.Core/Geometry/Point3D.cs`: Added `[JsonConstructor]` to constructor matching `X`, `Y`, `Z`.
  * `HPBim/src/HPBim.Core/Geometry/Polygon2D.cs`: Added `[JsonConstructor]` on `IReadOnlyList<Point2D> vertices`, `[JsonIgnore]` on computed properties (`Perimeter`, `SignedArea`, `Area`, `Centroid`, `BoundingBox`, `IsClockwise`), and fixed `Contains(pt, includeBoundary)`.
  * `HPBim/src/HPBim.Core/Qc/QcClashDetector.cs`: Added level matching on Column vs Opening and Beam vs Slab, zero-length wall guard, `includeBoundary: false` on slicing beam check, decomposed methods <= 50 lines.
  * `HPBim/src/HPBim.Core/Qc/ClearanceChecker.cs`: Added level matching on Opening vs Column, zero-length wall guard, decomposed methods <= 50 lines.
  * `HPBim/src/HPBim.Core/Models/WallDef.cs`: Added `Length` property alias and `[JsonIgnore]` on computed properties.
  * `HPBim/src/HPBim.Core/Models/BeamDef.cs`: Added `Length` property alias and `[JsonIgnore]` on computed properties.
  * `HPBim/src/HPBim.Core/Models/SlabDef.cs`: Added `[JsonIgnore]` on computed properties.
  * `HPBim/src/HPBim.Core/Models/RoomDef.cs`: Added `[JsonIgnore]` on computed properties.
  * `HPBim/src/HPBim.Core/Models/OpeningDef.cs`: Added `[JsonIgnore]` on computed properties.
  * `HPBim/src/HPBim.Core/Models/AxisGrid.cs`: Added `[JsonIgnore]` on computed properties.
  * `HPBim/src/HPBim.Core/Models/LevelDef.cs`: Added `[JsonIgnore]` on computed properties.
  * `HPBim/src/HPBim.Core/Models/PipeRunDef.cs`: Added `[JsonIgnore]` on computed properties.
  * `HPBim/src/HPBim.Core/Models/RebarDef.cs`: Added `[JsonIgnore]` on computed properties.
  * `HPBim/src/HPBim.Core/Models/BimModel.cs`: Added `[JsonIgnore]` on computed properties.
- **Build status**: PASS (0 warnings, 0 errors, Release netstandard2.0)
- **Pending issues**: none

## Quality Status
- **Build/test result**: PASS (12/12 assertions passed in self-test)
- **Lint status**: 0 warnings (TreatWarningsAsErrors=true)
- **Tests added/modified**: Full self-test suite covering JSON round-trip and all QC edge cases

## Loaded Skills
- None
