Lightingsang/AddinRebar/.agents/worker_m1_fix_hpbim/handoff.md

# Handoff Report - Milestone 1 Iteration 1 Fixes

## 1. Observation
- **Vector2D Serialization Cycle**: `Vector2D.cs` had properties `LeftNormal` and `RightNormal` returning new `Vector2D` instances, along with computed properties `Length`, `LengthSquared`, `AngleRad`, and `AngleDeg`. Without `[JsonIgnore]`, `System.Text.Json` recursed infinitely on `LeftNormal` / `RightNormal` causing `JsonException: A possible object cycle was detected.`
- **Point2D & Point3D Deserialization**: In `Point2D.cs` and `Point3D.cs`, the structs lacked `[JsonConstructor]`. Deserialization of immutable structs in certain contexts defaulted to parameterless struct initialization, causing coordinates to evaluate to `(0, 0)`.
- **Polygon2D Deserialization & Computed Properties**: `Polygon2D.cs` had constructor `Polygon2D(IEnumerable<Point2D> vertices)` which did not directly match property `IReadOnlyList<Point2D> Vertices` for `System.Text.Json`. Computed properties `Perimeter`, `SignedArea`, `Area`, `Centroid`, `BoundingBox`, and `IsClockwise` were not decorated with `[JsonIgnore]`, serializing redundant values. Furthermore, `Contains(pt, includeBoundary = false)` did not return `false` when a point was located directly on a polygon boundary segment.
- **QcClashDetector False Positives**:
  - `DetectColumnOpeningClashes`: Checked 2D spatial intersection between columns and wall openings without verifying storey levels, causing columns on Level 1 to falsely clash with openings on Level 2.
  - `DetectBeamSlabClashes`: Checked `slab.Boundary.Contains(beamMid)` with default `includeBoundary: true` and without checking storey levels, causing perimeter edge beams to trigger slicing clashes and beams on Level 2 to clash with slabs on Level 1.
  - Zero-length walls (`wall.Length <= 1e-4`): Calling `(wall.EndPoint - wall.StartPoint).Normalize()` threw `InvalidOperationException("Cannot normalize a zero-length vector.")`.
- **ClearanceChecker False Positives**:
  - `CheckOpeningToColumnClearances`: Lacked storey level checks, flagging warnings between openings on one level and columns on another.
  - Zero-length walls: Lacked guard before normalizing wall direction vector.
- **Clean Code Rules**: Methods must be <= 50 lines, classes <= 300 lines, 0 empty catches, 0 Revit references in `HPBim.Core`, target `netstandard2.0` with `Polyfill 11.0.1` and `TreatWarningsAsErrors=true`.

## 2. Logic Chain
1. **JSON Cycle Elimination (`Vector2D.cs`)**:
   - Added `[System.Text.Json.Serialization.JsonConstructor]` on `Vector2D(double x, double y)`.
   - Added `[System.Text.Json.Serialization.JsonIgnore]` on `LeftNormal`, `RightNormal`, `Length`, `LengthSquared`, `SquaredLength`, `AngleRad`, and `AngleDeg`.
   - Result: Serialized JSON only outputs `{"x": ..., "y": ...}`, resolving object cycle recursion and round-tripping cleanly.
2. **Coordinate Preservation (`Point2D.cs` & `Point3D.cs`)**:
   - Added `[JsonConstructor]` to `Point2D(double x, double y)` and `Point3D(double x, double y, double z)`.
   - Parameter names `x, y, z` match property names `X, Y, Z`.
   - Result: System.Text.Json reconstructs non-zero coordinates accurately upon deserialization.
3. **Polygon2D Deserialization & Boundary Containment (`Polygon2D.cs`)**:
   - Added `[JsonConstructor]` to `Polygon2D(IReadOnlyList<Point2D> vertices)` and kept `Polygon2D(IEnumerable<Point2D> vertices)` overload.
   - Added `[JsonIgnore]` to `VertexCount`, `Perimeter`, `SignedArea`, `Area`, `Centroid`, `BoundingBox`, `IsClockwise`, and `IsCounterClockwise`.
   - Updated `Contains(Point2D pt, bool includeBoundary = true)`: when `IsPointOnSegment(pt, pi, pj)` is true, it returns `includeBoundary`. When `includeBoundary` is `false`, any point lying on the perimeter boundary returns `false` immediately, correctly distinguishing edge beams from interior slicing beams.
4. **Multi-Storey Partition & Zero-Length Guards (`QcClashDetector.cs`)**:
   - In `DetectColumnOpeningClashes`:
     * Added guard `if (wall.Length <= 1e-4) continue;` before computing direction vector.
     * Added level matching: `if (!string.Equals(col.BaseLevel ?? string.Empty, wall.BaseLevel ?? string.Empty, StringComparison.OrdinalIgnoreCase)) continue;`.
     * Decomposed into `BuildColumnSpatialIndex` and `CheckWallOpeningsClashes` helper methods to ensure every method is strictly <= 50 lines.
   - In `DetectBeamSlabClashes`:
     * Added level matching: `if (!string.Equals(beam.Level ?? string.Empty, slab.Level ?? string.Empty, StringComparison.OrdinalIgnoreCase)) continue;`.
     * Used `slab.Boundary.Contains(beamMid, includeBoundary: false)` so edge perimeter beams never trigger slicing clashes.
5. **ClearanceChecker Level Matching & Decomposition (`ClearanceChecker.cs`)**:
   - In `CheckOpeningToColumnClearances`:
     * Added zero-length wall guard: `if (wall.Length <= 1e-4) continue;`.
     * Added level matching: `if (!string.Equals(col.BaseLevel ?? string.Empty, wall.BaseLevel ?? string.Empty, StringComparison.OrdinalIgnoreCase)) continue;`.
   - In `CheckDoorSwingClearances`:
     * Added zero-length wall guard: `if (wall.Length <= 1e-4) continue;`.
     * Extracted `CheckSingleDoorSwing` helper method to ensure method length <= 50 lines.
     * Added level matching against room tags: `if (!string.IsNullOrEmpty(room.Level) && !string.IsNullOrEmpty(wall.BaseLevel) && !string.Equals(room.Level, wall.BaseLevel, StringComparison.OrdinalIgnoreCase)) continue;`.
6. **DTO Cleanliness**:
   - Added `Length` property alias to `WallDef` and `BeamDef`.
   - Added `[JsonIgnore]` on all computed getters across `WallDef`, `BeamDef`, `SlabDef`, `RoomDef`, `OpeningDef`, `AxisGrid`, `LevelDef`, `PipeRunDef`, `RebarDef`, and `BimModel`.

## 3. Caveats
- No caveats. All 5 reviewer and challenger feedback items were addressed with authentic logic without dummy facades or hardcoded values.

## 4. Conclusion
All issues identified in Milestone 1 Iteration 1 have been resolved:
- `Vector2D`, `Point2D`, `Point3D`, and `Polygon2D` serialize and deserialize cleanly with zero cycle errors and 100% accurate coordinates.
- `Polygon2D.Contains` correctly supports `includeBoundary: false`.
- `QcClashDetector` and `ClearanceChecker` are multi-storey aware and guarded against zero-length walls.
- Code conforms strictly to HP Clean Code Governance (methods <= 50 lines, classes <= 300 lines, 0 empty catches, 0 Revit references in Core, `netstandard2.0` with `TreatWarningsAsErrors=true`).

## 5. Verification Method

### Compilation
Command:
```powershell
dotnet build "g:\09-PROJECT AI\01_Revit\02_CshapRevit\01_AddinRebar\HPBim\HPBim.slnx" -c Release
```
Result: Build succeeded with 0 Warnings and 0 Errors.

### Self-Test Execution
The following self-test was executed via an ephemeral test harness against `HPBim.Core.dll`:
1. `Vector2D`: Serializes without cycles; `LeftNormal`/`Length`/`SquaredLength` excluded from JSON; deserializes `(3, 4)` accurately. (PASS)
2. `Point2D`: Coordinates `(123.456, 789.012)` preserved upon JSON round-trip. (PASS)
3. `Point3D`: Coordinates `(11.1, 22.2, 33.3)` preserved upon JSON round-trip. (PASS)
4. `Polygon2D`: Computed properties excluded from JSON; 4 vertices deserialized; Area (5000.0) preserved. (PASS)
5. `BimModelSerializer`: Full `BimModel` round-trip succeeds with exact coordinates. (PASS)
6. `QcClashDetector` Column vs Opening Multi-storey: Columns on Tang 1 do NOT clash with openings on Tang 2 at same 2D position (0 clashes). (PASS)
7. `QcClashDetector` Column vs Opening Same-level: Column on Tang 1 clashes with opening on Tang 1 (1 clash detected). (PASS)
8. `QcClashDetector` Edge Perimeter Beam: Beam on slab perimeter boundary with `includeBoundary: false` does NOT trigger slicing clash (0 clashes). (PASS)
9. `QcClashDetector` Interior Beam: Beam running through interior of undivided slab triggers slicing clash (1 clash detected). (PASS)
10. `QcClashDetector` Multi-storey Beam vs Slab: Interior beam on Tang 1 does NOT clash with slab on Tang 2. (PASS)
11. `QcClashDetector` Zero-Length Wall: Wall with length 0 does not throw exception. (PASS)
12. `ClearanceChecker`: Multi-storey separation avoids false clearance warnings; zero-length walls do not throw. (PASS)

Overall Self-Test Result: 12/12 assertions PASSED (0 failures).
