Lightingsang/AddinRebar/.agents/worker_m1_fix_hpbim/progress.md

# Progress - Worker M1 Fix HPBim
Last visited: 2026-10-06T00:26:00Z
- [x] Initialized
- [x] Vector2D JSON recursion cycle fixed with [JsonIgnore] and [JsonConstructor]
- [x] Point2D & Point3D [JsonConstructor] and parameter mapping implemented
- [x] Polygon2D [JsonConstructor] on IReadOnlyList<Point2D> and [JsonIgnore] on computed properties
- [x] Polygon2D.Contains(pt, includeBoundary) fixed to return includeBoundary for edge points
- [x] QcClashDetector multi-storey level matching implemented
- [x] QcClashDetector beam vs slab includeBoundary: false and level matching implemented
- [x] QcClashDetector zero-length wall guard implemented
- [x] ClearanceChecker opening vs column multi-storey level matching implemented
- [x] ClearanceChecker zero-length wall guard implemented
- [x] Clean Code verification: methods <= 50 lines, classes <= 300 lines, 0 empty catches, 0 Revit references in Core
- [x] dotnet build HPBim.slnx -c Release passed with 0 warnings, 0 errors
- [x] BimModelSerializer round-trip and QC test harness passed (12/12 assertions passed)
- [x] Handoff report written to handoff.md
