Lightingsang/AddinRebar/.agents/worker_m3_1/changes.md

# Changes Report — Milestone M3: HPRobot Stdio Server & 24 Tools Catalog

**Worker**: worker_m3_1  
**Target Deliverable**: `HPRobot.Mcp.Server` (.NET 10.0 Stdio MCP Server)  
**Parent Orchestrator**: `orchestrator_7`  
**Timestamp**: 2026-09-21T14:38:00Z  

---

## 1. Summary of Changes

Milestone M3 implements the complete stdio MCP server `HPRobot.Mcp.Server` for Autodesk Robot Structural Analysis Professional 2026. The server implements the MCP 2.2.0 protocol over stdio and communicates out-of-process with `HPRobot.McpBridge` across Named Pipe `hprobot-mcp-2026`.

### 2. Files Created & Modified

| File | Change | Description |
|---|---|---|
| `HPRobot/HPRobot.slnx` | Modified | Added `<Project Path="HPRobot.Mcp.Server/HPRobot.Mcp.Server.csproj" />` |
| `HPRobot/HPRobot.Mcp.Server/HPRobot.Mcp.Server.csproj` | Created | .NET 10 console project targeting `net10.0`, referencing `HPRebar.Mcp.Server.Core`, `Interop.RobotOM.dll` (no copy), and embedding 12 seed tool packages |
| `HPRobot/HPRobot.Mcp.Server/Program.cs` | Created | Entry point invoking `McpServerHost.RunAsync(args, new RobotHostProfile())` supporting both MCP stdio and `registry` CLI modes |
| `HPRobot/HPRobot.Mcp.Server/appsettings.json` | Created | Standard configuration with `Bridge:PipeName = "hprobot-mcp-2026"` and `Bridge:HostVersion = 2026` |
| `HPRobot/HPRobot.Mcp.Server/Hosts/Robot/RobotHostProfile.cs` | Created | `IHostProfile` implementation advertising host `"robot"`, method prefix `"robot."`, 300s timeout ceiling, hints, and contracts |
| `HPRobot/HPRobot.Mcp.Server/Hosts/Robot/RobotContextService.cs` | Created | Typed context wrapper service around `ContextService` |
| `HPRobot/HPRobot.Mcp.Server/Hosts/Robot/Tools/GetRobotContextTool.cs` | Created | Core tool `get_robot_context` returning session metadata and active object counts |
| `HPRobot/HPRobot.Mcp.Server/Hosts/Robot/Tools/ExecuteRobotCodeTool.cs` | Created | Core tool `execute_robot_code` with 3-tier safety integration and Roslyn execution contract |
| `HPRobot/HPRobot.Mcp.Server/Hosts/Robot/Resources/RobotResourceProvider.cs` | Created | Resource endpoints `robot://model/info` and `robot://selection` |
| `HPRobot/HPRobot.Mcp.Server/Hosts/Robot/Prompts/RobotPromptProvider.cs` | Created | Roslyn RobotOM prompt templates (`robot_query_template`, `robot_modify_template`, `robot_analysis_template`) |
| `HPRobot/HPRobot.Mcp.Server/Registry/SeedLibrary/**` | Created | 12 embedded seed tool packages (36 files: `tool.json`, `code.cs`, `examples.json` for each seed) |

---

## 3. Catalog Details (24 Tools Total)

### 3.1 4 Core Tools
1. `execute_robot_code`: Execute Roslyn C# code against active Robot instance via COM.
2. `get_robot_context`: Retrieve model metadata, file path, calc state, and object counts.
3. `inspect_type`: Dynamic reflection inspector for API types (provided by engine).
4. `cancel_execution`: Cooperative cancellation mechanism for running scripts (provided by engine).

### 3.2 8 Dynamic Registry Meta Tools
1. `manage_tool`
2. `get_run`
3. `publish_tool`
4. `search_tools`
5. `get_tool`
6. `run_tool`
7. `propose_tool`
8. `test_tool`

### 3.3 12 Embedded Seed Tools
1. `Model/get_model_info`: Read-only model overview, RTD path, calc status, object counts.
2. `Geometry/get_structural_objects`: Query nodes, bars, and panels with coordinates & properties.
3. `Property/get_materials_and_sections`: Query defined materials and cross-section profiles.
4. `Geometry/get_coordinate_systems_and_grids`: Query structural grids and axes.
5. `Load/get_load_definitions`: Query load cases and combinations.
6. `Geometry/draw_bar_by_coords`: Create bar elements with coordinates and section assignment (Tier W).
7. `Geometry/assign_node_support`: Assign nodal supports/restraints (Tier W).
8. `Property/assign_bar_section`: Assign section profile labels to bars (Tier W).
9. `Load/assign_bar_load`: Apply uniform or concentrated forces to bars (Tier W).
10. `Analysis/run_calculations`: Execute FEA calculation engine (Tier D/Heavy, 300s timeout).
11. `Results/get_node_reactions`: Query reaction forces (FX, FY, FZ) and moments (MX, MY, MZ).
12. `Results/get_bar_forces`: Query internal forces diagram along chord points.

---

## 4. Verification Commands & Results

### 4.1 Solution Builds
- `dotnet build HPRobot/HPRobot.slnx -c Debug` -> **PASS** (0 warnings, 0 errors)
- `dotnet build HPRobot/HPRobot.slnx -c Release` -> **PASS** (0 warnings, 0 errors)

### 4.2 MCP Protocol Verification (`mcp-call.py`)
- `tools/list`: Returned **24 tools** (4 core, 8 meta, 12 seeds).
- `resources/list`: Returned **3 resources** (`robot://model/info`, `robot://selection`, `registry://tools`).
- `prompts/list`: Returned **4 prompts** (`robot_query_template`, `robot_modify_template`, `robot_analysis_template`, `toolify_run`).

### 4.3 Regression Safety
- `HPRobot.McpBridge.Tests`: **137/137 tests passed** (0 failed, 0 skipped).
