Lightingsang/AddinRebar/.agents/worker_m4_1/changes.md

# Implementation Changes: HPRobot Automated Test Suites (Milestone 4)

**Worker**: `worker_m4_1`  
**Milestone**: M4 - Automated Test Suites  
**Target Solution**: `HPRobot/HPRobot.slnx`  
**Date**: 2026-09-21  

---

## 1. Projects and Files Created

### 1.1 `HPRobot/HPRobot.Mcp.Server.Tests/HPRobot.Mcp.Server.Tests.csproj`
- Target Framework: `net10.0`
- Output Type: `Exe` (required for Microsoft.Testing.Platform runner under xUnit v3)
- `<UseMicrosoftTestingPlatformRunner>true</UseMicrosoftTestingPlatformRunner>`
- Package References:
  - `xunit.v3` (3.1.0)
  - `xunit.runner.visualstudio` (3.1.5)
  - `Microsoft.Bcl.AsyncInterfaces` (10.0.12) to silence `MSB3277` and unify assembly binding.
- Project References:
  - `..\HPRobot.Mcp.Server\HPRobot.Mcp.Server.csproj`
  - `..\..\McpShared\HPRebar.Mcp.Server.Core\HPRebar.Mcp.Server.Core.csproj`
  - `..\..\McpShared\HPRebar.McpBridge.Core\HPRebar.McpBridge.Core.csproj`
  - `..\..\McpShared\HPRebar.Mcp.Contracts\HPRebar.Mcp.Contracts.csproj`
- Linked Asset:
  - `..\..\McpShared\HPRebar.Mcp.Server.Core.Tests\Fakes\FakeRevitExecutor.cs` linked as `Fakes\FakeRevitExecutor.cs`.

### 1.2 `HPRobot/HPRobot.Mcp.Server.Tests/RobotHostProfileTests.cs` (7 test methods)
- Validates `RobotHostProfile.Instance` properties:
  - `HostId`: `"robot"`
  - `DisplayName`: `"Robot Structural Analysis"`
  - `ServerName`: `"HPRobot MCP"`
  - `DefaultVersion`: `2026`
  - `ValidVersions`: `[2024, 2025, 2026]`
  - `PipeName(2026)`: `"hprobot-mcp-2026"`
  - `Method("execute")`: `"robot.execute"`, `"robot.ping"`, `"robot.context"`, `"robot.cancel"`
  - `MaxTimeoutSeconds`: `300`
  - Script imports and globals (`RobotImports`, `RobotGlobals` with `"robot"`, `"structure"`, `"units"`, `"ct"`, `"log"`, `"progress"`, `"args"`)
  - Hints: Sanitized, no local paths or machine usernames, naming `"HPRobot.McpBridge.exe"`, `"hprobot-mcp-2026"`, `"persisted (no rollback)"`.
- Validates `GetRobotContextTool` description.
- Validates `ExecuteRobotCodeTool` description (character budget < 1800, tiers, preview, dryRun).
- Validates DI configuration and options binding with `McpServerHost.ConfigureOptions`.
- Validates static tool surface: exactly 12 tools (4 core + 8 registry tools), zero foreign host tools.
- Validates resource URIs (`robot://model/info`, `robot://selection`) and prompt templates (`robot_query_template`, `robot_modify_template`, `robot_analysis_template`).

### 1.3 `HPRobot/HPRobot.Mcp.Server.Tests/SeedCatalogTests.cs` (6 test methods, 63 test executions)
- Manifest discovery of all 12 seeds in `typeof(RobotHostProfile).Assembly`:
  - 6 categories: `Analysis`, `Geometry`, `Load`, `Model`, `Property`, `Results`.
  - Transaction modes: 7 `none` (read-only), 5 `auto` (write/destructive).
  - Destructive tag: only on `run_calculations`.
- Theory validating schema conformity for all 12 seeds:
  - Name syntax `^[a-z][a-z0-9_]{2,63}$`
  - Host `"robot"`, hostVersions contains `"2026"`, author `"hprebar"`, status `"published"`.
  - Timeout in range 10..300.
  - Required properties in schema.
- Theory validating examples for all 12 seeds:
  - >= 2 examples per seed.
  - Distinct argument payloads (or distinct titles for 0-argument tools).
  - All args conform to declared schema properties and required properties.
- Theory validating code safety and argument parity for all 12 seeds:
  - Code size < 32 KB and <= 120 lines.
  - Top-level `return` statement.
  - Zero `ScriptGuard` violations under `GuardProfile.Robot`.
  - Argument parity: exact match between `ScriptAnalyzer.Analyze` read keys and declared schema properties.
  - No transaction usage inside seed scripts.
- Theory validating all 12 seeds against `ToolValidator.Validate`.
- Fact validating dynamic tool registry: 4 core + 8 registry + 12 seeds = exactly 24 tools total.

### 1.4 `HPRobot/HPRobot.Mcp.Server.Tests/SeedExecutionTests.cs` (13 test methods)
- Real named pipe round-trip tests using `PipeListener` and `FakeRevitExecutor` on ephemeral pipe `hprobot-mcp-test-{guid}`:
  - `robot.ping`: returns `pong=true`, `2026`, reflects bridge `ExecutionEnabled`.
  - `robot.context`: shapes `RobotInfo` (`isAttached`, `attachedPid`, `structureType`, `barCount`, etc.), hides Revit/foreign properties, handles selection inclusion.
  - Context before attach: reports `isAttached=false`, `isModifiable=false`.
  - Model resource: reads model info snapshot as JSON text without selection.
  - `robot.execute`: forwards code, transaction mode, dryRun, timeout, label, and args; receives snapshot filename (`.rtd`) in response; verifies `rolledBack=false`.
  - Timeout clamping: permits up to 300 s, clamps requests > 300 s down to 300 s.
  - Static preview: handles `PREVIEW` diagnostic error for writing scripts under `dryRun=true`.
  - Refusals: surfaces `ExecutionDisabled` naming `HPRobot MCP Bridge` and `Allow AI execution`.
  - Refusals: surfaces `HeavyOperationsDisabled` naming `Allow heavy/destructive operations`.
  - Error diagnostics: surfaces `Busy`, `NoActiveDocument` naming Robot and `.rtd`.
  - Bridge not connected: error names `HPRobot.McpBridge.exe` and pipe `hprobot-mcp-2026` with no local machine paths.
  - `robot.cancel`: dispatches cancellation to executor.
  - Timeout exception: verifies persistence warning message ("persisted (no rollback)", "snapshot").

### 1.5 `HPRobot/HPRobot.Mcp.Server.Tests/SeedCompilationTests.cs` (4 test methods, 26 test executions)
- Dynamic in-memory Roslyn compilation via `CSharpCompilation.Create`:
  - 3-tier lookup in `FindWrapper()`: `HPROBOT_ROBOT_DIR` → Windows Registry (`HKCR`/`HKLM` `CLSID\{F7870790-CDE5-11D1-8FF1-00A02447BAAE}\LocalServer32`) → `%ProgramFiles%\Autodesk\Robot Structural Analysis Professional 2026\Exe\Interop.RobotOM.dll`.
  - Dynamic skipping via `Assert.SkipWhen(compiled is null, ...)` for environments without Robot.
  - Compiles all 12 seeds against actual `Interop.RobotOM.dll` metadata with 0 errors.
  - Theory validating transaction modes and tags match operation intent.
  - Fact validating compile check rejects API misuse (CS1061) and accepts valid RobotOM API calls.
  - Fact validating ScriptGuard rejects `Application.Quit()` and `Process.Start()`.

---

## 2. Files Modified

### 2.1 `HPRobot/HPRobot.slnx`
- Registered `HPRobot.Mcp.Server.Tests/HPRobot.Mcp.Server.Tests.csproj` directly following `HPRobot.Mcp.Server/HPRobot.Mcp.Server.csproj`.

---

## 3. Verification Summary

1. **Solution Compilation**:
   - `dotnet build HPRobot/HPRobot.slnx -c Debug`: 0 Warnings, 0 Errors.
   - `dotnet build HPRobot/HPRobot.slnx -c Release`: 0 Warnings, 0 Errors.
2. **Server Tests Execution**:
   - `dotnet run --project HPRobot/HPRobot.Mcp.Server.Tests/HPRobot.Mcp.Server.Tests.csproj`: 97/97 tests passed (100% success rate, 0 failed, 0 skipped).
3. **Bridge Tests Execution**:
   - `dotnet run --project HPRobot/HPRobot.McpBridge.Tests/HPRobot.McpBridge.Tests.csproj`: 197/197 tests passed (100% success rate, 0 failed, 0 skipped).
4. **All Solution Tests**:
   - `dotnet test HPRobot.slnx`: 294/294 tests passed (100% success rate, 0 failed, 0 skipped).
5. **McpShared Regression Tests**:
   - `HPRebar.Mcp.Server.Core.Tests`: 613/613 passed.
   - `HPRebar.McpBridge.Core.Net48Tests`: 72/72 passed.
   - Total McpShared: 685/685 passed (100% success rate, zero regressions).
