Lightingsang/AddinRebar/.agents/worker_m4_2/changes.md

# Changes Report: HPRobot Milestone M4 Remediation (Asynchronous Race Condition Resolution)

**Agent**: `worker_m4_2` (HPRobot M4 Remediation Worker)  
**Parent**: Project Orchestrator (`orchestrator_7`, conversation ID: `b32c5a58-8b71-46dd-ba9a-5c9e4b6709de`)  
**Date**: 2026-09-21  
**Target Solution**: `HPRobot/HPRobot.slnx`  
**Write Ownership**: `HPRobot/HPRobot.Mcp.Server.Tests/**`  

---

## 1. Summary of Changes

### Modified File:
`HPRobot/HPRobot.Mcp.Server.Tests/SeedExecutionTests.cs`

### Nature of Change:
In method `Timeout_InformsModelThatChangesMayHavePersisted`:
- **Defect**: The test asserts `Assert.True(_executor.CancelCalls > 0);` immediately after catching `BridgeTimeoutException`. In `RevitBridgeClient.cs`, `TryCancelInRevit` sends the `robot.cancel` JSON-RPC message as an unawaited fire-and-forget task (`_ = SendAsync<CancelResult>(...)`). Under concurrent multi-project execution (`dotnet test HPRobot.slnx`), thread scheduling delays the delivery and dispatch of the cancel message over the named pipe, causing `_executor.CancelCalls` to still be 0 when evaluated synchronously in microsecond time, leading to `Assert.True() Failure` (Exit code 2).
- **Remediation**: Replaced the immediate synchronous assertion with the canonical bounded polling loop (matching `HPExcel` and `HPPowerBi`), with a 3-second deadline, 50ms polling interval, and passing `TestContext.Current.CancellationToken` to avoid `xUnit1051` analyzer warnings. Preserved all preceding error message assertions (`Assert.Contains("persisted (no rollback)", error.Message)`, `Assert.Contains("snapshot", error.Message)`, `Assert.DoesNotContain("nothing has been committed", error.Message)`).

### Exact Code Diff:
```csharp
<<<<
        Assert.Contains("persisted (no rollback)", error.Message);
        Assert.Contains("snapshot", error.Message);
        Assert.DoesNotContain("nothing has been committed", error.Message);
        Assert.True(_executor.CancelCalls > 0);
    }
====
        Assert.Contains("persisted (no rollback)", error.Message);
        Assert.Contains("snapshot", error.Message);
        Assert.DoesNotContain("nothing has been committed", error.Message);

        var deadline = DateTime.UtcNow.AddSeconds(3);
        while (DateTime.UtcNow < deadline && _executor.CancelCalls == 0)
        {
            await Task.Delay(50, TestContext.Current.CancellationToken);
        }
        Assert.True(_executor.CancelCalls > 0, "Cancel() was not called on the executor when client timed out.");
    }
>>>>
```

---

## 2. Flake Verification Table (5/5 Consecutive Solution Test Runs)

| Run | Command | Total | Passed | Failed | Skipped | Exit Code | Result |
|:---:|:---|:---:|:---:|:---:|:---:|:---:|:---:|
| **Run 1** | `dotnet test HPRobot.slnx` | 294 | 294 | 0 | 0 | 0 | **PASS** |
| **Run 2** | `dotnet test HPRobot.slnx` | 294 | 294 | 0 | 0 | 0 | **PASS** |
| **Run 3** | `dotnet test HPRobot.slnx` | 294 | 294 | 0 | 0 | 0 | **PASS** |
| **Run 4** | `dotnet test HPRobot.slnx` | 294 | 294 | 0 | 0 | 0 | **PASS** |
| **Run 5** | `dotnet test HPRobot.slnx` | 294 | 294 | 0 | 0 | 0 | **PASS** |

**Conclusion**: 100% deterministic reproducibility across 5 consecutive runs under concurrent parallel solution execution. Zero flakiness.

---

## 3. Verbatim Terminal Verification Logs

### 3.1 Solution Compilation (Debug Configuration)
```text
Command: dotnet build HPRobot/HPRobot.slnx -c Debug
Output:
  Determining projects to restore...
  All projects are up-to-date for restore.
  HPRebar.Mcp.Contracts -> G:\09-PROJECT AI\01_Revit\02_CshapRevit\01_AddinRebar\McpShared\HPRebar.Mcp.Contracts\bin\Debug\netstandard2.0\HPRebar.Mcp.Contracts.dll
  HPRebar.Mcp.Contracts -> G:\09-PROJECT AI\01_Revit\02_CshapRevit\01_AddinRebar\McpShared\HPRebar.Mcp.Contracts\bin\Debug\net48\HPRebar.Mcp.Contracts.dll
  HPRebar.Mcp.Server.Core -> G:\09-PROJECT AI\01_Revit\02_CshapRevit\01_AddinRebar\McpShared\HPRebar.Mcp.Server.Core\bin\Debug\net10.0\HPRebar.Mcp.Server.Core.dll
  HPRebar.McpBridge.Core -> G:\09-PROJECT AI\01_Revit\02_CshapRevit\01_AddinRebar\McpShared\HPRebar.McpBridge.Core\bin\Debug\net8.0\HPRebar.McpBridge.Core.dll
  HPRebar.McpBridge.Core -> G:\09-PROJECT AI\01_Revit\02_CshapRevit\01_AddinRebar\McpShared\HPRebar.McpBridge.Core\bin\Debug\net48\HPRebar.McpBridge.Core.dll
  HPRobot.McpBridge -> G:\09-PROJECT AI\01_Revit\02_CshapRevit\01_AddinRebar\HPRobot\HPRobot.McpBridge\bin\Debug\net8.0-windows\HPRobot.McpBridge.dll
  HPRobot.Mcp.Server -> G:\09-PROJECT AI\01_Revit\02_CshapRevit\01_AddinRebar\HPRobot\HPRobot.Mcp.Server\bin\Debug\net10.0\HPRobot.Mcp.Server.dll
  HPRobot.McpBridge.Tests -> G:\09-PROJECT AI\01_Revit\02_CshapRevit\01_AddinRebar\HPRobot\HPRobot.McpBridge.Tests\bin\Debug\net8.0-windows\HPRobot.McpBridge.Tests.dll
  HPRobot.Mcp.Server.Tests -> G:\09-PROJECT AI\01_Revit\02_CshapRevit\01_AddinRebar\HPRobot\HPRobot.Mcp.Server.Tests\bin\Debug\net10.0\HPRobot.Mcp.Server.Tests.dll

Build succeeded.
    0 Warning(s)
    0 Error(s)

Time Elapsed 00:00:06.12
Exit Code: 0
```

### 3.2 Solution Compilation (Release Configuration)
```text
Command: dotnet build HPRobot/HPRobot.slnx -c Release
Output:
  Determining projects to restore...
  All projects are up-to-date for restore.
  HPRebar.Mcp.Contracts -> G:\09-PROJECT AI\01_Revit\02_CshapRevit\01_AddinRebar\McpShared\HPRebar.Mcp.Contracts\bin\Release\netstandard2.0\HPRebar.Mcp.Contracts.dll
  HPRebar.Mcp.Contracts -> G:\09-PROJECT AI\01_Revit\02_CshapRevit\01_AddinRebar\McpShared\HPRebar.Mcp.Contracts\bin\Release\net48\HPRebar.Mcp.Contracts.dll
  HPRebar.Mcp.Server.Core -> G:\09-PROJECT AI\01_Revit\02_CshapRevit\01_AddinRebar\McpShared\HPRebar.Mcp.Server.Core\bin\Release\net10.0\HPRebar.Mcp.Server.Core.dll
  HPRebar.McpBridge.Core -> G:\09-PROJECT AI\01_Revit\02_CshapRevit\01_AddinRebar\McpShared\HPRebar.McpBridge.Core\bin\Release\net8.0\HPRebar.McpBridge.Core.dll
  HPRobot.Mcp.Server -> G:\09-PROJECT AI\01_Revit\02_CshapRevit\01_AddinRebar\HPRobot\HPRobot.Mcp.Server\bin\Release\net10.0\HPRobot.Mcp.Server.dll
  HPRebar.McpBridge.Core -> G:\09-PROJECT AI\01_Revit\02_CshapRevit\01_AddinRebar\McpShared\HPRebar.McpBridge.Core\bin\Release\net48\HPRebar.McpBridge.Core.dll
  HPRobot.McpBridge -> G:\09-PROJECT AI\01_Revit\02_CshapRevit\01_AddinRebar\HPRobot\HPRobot.McpBridge\bin\Release\net8.0-windows\HPRobot.McpBridge.dll
  HPRobot.McpBridge.Tests -> G:\09-PROJECT AI\01_Revit\02_CshapRevit\01_AddinRebar\HPRobot\HPRobot.McpBridge.Tests\bin\Release\net8.0-windows\HPRobot.McpBridge.Tests.dll
  HPRobot.Mcp.Server.Tests -> G:\09-PROJECT AI\01_Revit\02_CshapRevit\01_AddinRebar\HPRobot\HPRobot.Mcp.Server.Tests\bin\Release\net10.0\HPRobot.Mcp.Server.Tests.dll

Build succeeded.
    0 Warning(s)
    0 Error(s)

Time Elapsed 00:00:05.84
Exit Code: 0
```

### 3.3 Standalone Server Tests
```text
Command: dotnet run --project HPRobot/HPRobot.Mcp.Server.Tests/HPRobot.Mcp.Server.Tests.csproj
Output:
xUnit.net v3 Microsoft.Testing.Platform Runner v3.1.0+03a071627b (64-bit .NET 10.0.11)

[+97/x0/?0] HPRobot.Mcp.Server.Tests.dll (net10.0|x64)(3s)

Test run summary: Passed! - G:\09-PROJECT AI\01_Revit\02_CshapRevit\01_AddinRebar\HPRobot\HPRobot.Mcp.Server.Tests\bin\Debug\net10.0\HPRobot.Mcp.Server.Tests.dll (net10.0|x64)
  total: 97
  failed: 0
  succeeded: 97
  skipped: 0
  duration: 3s 026ms
Exit Code: 0
```

### 3.4 Standalone Bridge Tests
```text
Command: dotnet run --project HPRobot/HPRobot.McpBridge.Tests/HPRobot.McpBridge.Tests.csproj
Output:
xUnit.net v3 Microsoft.Testing.Platform Runner v3.1.0+03a071627b (64-bit .NET 8.0.30)

[+153/x0/?0] HPRobot.McpBridge.Tests.dll (net8.0|x64) - HPRobot.McpBridge.Tests.SeedLibraryChallengerTests.Seed_Code_CompilesCleanly_AgainstRobotOM(category: "Geometry", name: "get_structural_objects") (3s)

[+175/x0/?0] HPRobot.McpBridge.Tests.dll (net8.0|x64) - HPRobot.McpBridge.Tests.SeedLibraryChallengerTests.Seed_ArgsRead_Match_DeclaredProperties(category: "Geometry", name: "draw_bar_by_coords") (6s)

Test run summary: Passed! - G:\09-PROJECT AI\01_Revit\02_CshapRevit\01_AddinRebar\HPRobot\HPRobot.McpBridge.Tests\bin\Debug\net8.0-windows\HPRobot.McpBridge.Tests.dll (net8.0|x64)
  total: 197
  failed: 0
  succeeded: 197
  skipped: 0
  duration: 8s 524ms
Exit Code: 0
```

### 3.5 Solution Concurrent Test Execution (Single Verbatim Run)
```text
Command: dotnet test "g:\09-PROJECT AI\01_Revit\02_CshapRevit\01_AddinRebar\HPRobot\HPRobot.slnx"
Output:
Running tests from g:\09-PROJECT AI\01_Revit\02_CshapRevit\01_AddinRebar\HPRobot\HPRobot.Mcp.Server.Tests\bin\Debug\net10.0\HPRobot.Mcp.Server.Tests.dll (net10.0|x64)
Running tests from g:\09-PROJECT AI\01_Revit\02_CshapRevit\01_AddinRebar\HPRobot\HPRobot.McpBridge.Tests\bin\Debug\net8.0-windows\HPRobot.McpBridge.Tests.dll (net8.0|x64)
g:\09-PROJECT AI\01_Revit\02_CshapRevit\01_AddinRebar\HPRobot\HPRobot.Mcp.Server.Tests\bin\Debug\net10.0\HPRobot.Mcp.Server.Tests.dll (net10.0|x64) passed (3s 980ms)
g:\09-PROJECT AI\01_Revit\02_CshapRevit\01_AddinRebar\HPRobot\HPRobot.McpBridge.Tests\bin\Debug\net8.0-windows\HPRobot.McpBridge.Tests.dll (net8.0|x64) passed (9s 751ms)

Test run summary: Passed!
  g:\09-PROJECT AI\01_Revit\02_CshapRevit\01_AddinRebar\HPRobot\HPRobot.McpBridge.Tests\bin\Debug\net8.0-windows\HPRobot.McpBridge.Tests.dll (net8.0|x64) passed (9s 751ms)
  g:\09-PROJECT AI\01_Revit\02_CshapRevit\01_AddinRebar\HPRobot\HPRobot.Mcp.Server.Tests\bin\Debug\net10.0\HPRobot.Mcp.Server.Tests.dll (net10.0|x64) passed (3s 980ms)

  total: 294
  failed: 0
  succeeded: 294
  skipped: 0
  duration: 10s 144ms
Exit Code: 0
```

### 3.6 5-Consecutive-Run Solution Test Stress Execution
```text
Command: powershell -ExecutionPolicy Bypass -File "g:\09-PROJECT AI\01_Revit\02_CshapRevit\01_AddinRebar\.agents\worker_m4_2\run_stress_test.ps1"
Output:

========================================================
=== SOLUTION TEST RUN 1 / 5 ===
========================================================

========================================================
=== SOLUTION TEST RUN 2 / 5 ===
========================================================

========================================================
=== SOLUTION TEST RUN 3 / 5 ===
========================================================

========================================================
=== SOLUTION TEST RUN 4 / 5 ===
========================================================

========================================================
=== SOLUTION TEST RUN 5 / 5 ===
========================================================

========================================================
=== FLAKE VERIFICATION SUMMARY (5/5 RUNS PASSED) ===
========================================================

Run Status Total Passed Failed Skipped ExitCode
--- ------ ----- ------ ------ ------- --------
  1 Passed   294    294      0       0        0
  2 Passed   294    294      0       0        0
  3 Passed   294    294      0       0        0
  4 Passed   294    294      0       0        0
  5 Passed   294    294      0       0        0

Exit Code: 0
```

### 3.7 McpShared Regression Baseline Verification

#### Part A: net10 Host-Neutral Server Engine Tests
```text
Command: dotnet run --project McpShared/HPRebar.Mcp.Server.Core.Tests/HPRebar.Mcp.Server.Core.Tests.csproj
Output:
xUnit.net v3 Microsoft.Testing.Platform Runner v3.1.0+03a071627b (64-bit .NET 10.0.11)

[+612/x0/?0] HPRebar.Mcp.Server.Core.Tests.dll (net10.0|x64) - HPRebar.Mcp.Server.Tests.ScriptCompilerTests.Cache_evicts_least_recently_used_beyond_capacity (3s)

Test run summary: Passed! - G:\09-PROJECT AI\01_Revit\02_CshapRevit\01_AddinRebar\McpShared\HPRebar.Mcp.Server.Core.Tests\bin\Debug\net10.0\HPRebar.Mcp.Server.Core.Tests.dll (net10.0|x64)
  total: 613
  failed: 0
  succeeded: 613
  skipped: 0
  duration: 3s 172ms
Exit Code: 0
```

#### Part B: net48 Host-Neutral Bridge Engine Tests
```text
Command: dotnet run --project McpShared/HPRebar.McpBridge.Core.Net48Tests/HPRebar.McpBridge.Core.Net48Tests.csproj
Output:
xUnit.net v3 Microsoft.Testing.Platform Runner v3.1.0+03a071627b (64-bit .NET Framework 4.8.9181.0)

Test run summary: Passed! - G:\09-PROJECT AI\01_Revit\02_CshapRevit\01_AddinRebar\McpShared\HPRebar.McpBridge.Core.Net48Tests\bin\Debug\net48\HPRebar.McpBridge.Core.Net48Tests.exe (.NET Framework 4.8|x64)
  total: 72
  failed: 0
  succeeded: 72
  skipped: 0
  duration: 2s 252ms
Exit Code: 0
```

#### McpShared Combined Total:
**613 (net10) + 72 (net48) = 685 Passed, 0 Failed, 0 Skipped (100% PASS, 0 REGRESSIONS)**
