Lightingsang/AddinRebar/.agents/teamwork/explorer_m2_fix/BRIEFING.md

# BRIEFING — 2026-10-07T03:28:45Z

## Mission
Investigate and design the exact code fix strategy to resolve every single audit violation in M2 (FailFastGate test failures, NaN/Infinity/Whitespace support bypasses, Footing support check, CadSourceSpec default, and CLI command backdoors) and guarantee 314/314 green tests.

## 🔒 My Identity
- Archetype: explorer
- Roles: Teamwork explorer (Read-only investigation)
- Working directory: G:\09-PROJECT AI\01_Revit\02_CshapRevit\01_AddinRebar\.agents\teamwork\explorer_m2_fix
- Original parent: 11067cc4-24c4-4007-9827-ff3e7c0e82f5
- Milestone: M2 Remediation / Fix Strategy

## 🔒 Key Constraints
- Read-only investigation — do NOT implement changes directly in codebase (except reports/artifacts in my own directory)
- Must read ORIGINAL_REQUEST.md (## 2026-10-07T02:05:11Z) and DISPATCH.md
- Formulate exact code fix strategy for FailFastGate.cs, CadSourceSpec.cs, and CLI commands
- Guarantee 314/314 tests pass
- Deliver handoff.md with 5 components and notify parent

## Current Parent
- Conversation ID: 11067cc4-24c4-4007-9827-ff3e7c0e82f5
- Updated: 2026-10-07T03:28:45Z

## Investigation State
- **Explored paths**: `FailFastGateAdversarialProbeTests.cs`, `FailFastGateTests.cs`, `EmpiricalChallengerM2Tests.cs`, `FailFastGate.cs`, `CadSourceSpec.cs`, `BuildGradeBeamNetworkCommand.cs`, `AnalyzeFootingsCommand.cs`, `GenerateGradeBeamsCommand.cs`, `GenerateFoundationSlabsCommand.cs`.
- **Key findings**:
  1. IEEE 754 arithmetic with `NaN` evaluates comparisons to `false`, allowing `NaN` and `Infinity` to bypass `CheckElevations` and `CheckDimensions`.
  2. `CheckSupports` allowed whitespace strings (`new[] { "", "   " }`) because it only checked `Count < 2`.
  3. `CheckSupports` omitted `CoordinationCategory.Footing`.
  4. `CadSourceSpec.CrossCheckPassed` defaulted to `true`.
  5. CLI commands contained optional flags (`--fail-fast`), bypass flags (`--force-unverified`), and speculative fallback defaults (`B_200x400`).
- **Unexplored areas**: None. All audit violations investigated and mapped to exact code remedies.

## Key Decisions Made
- Formulate `IsFinite` helper method (`!double.IsNaN && !double.IsInfinity`) for 100% portable IEEE 754 compliance in netstandard2.0.
- Use `spec.Supports.Where(s => !string.IsNullOrWhiteSpace(s))` for strict support validation across all categories.
- Add `CoordinationCategory.Footing` support check requiring >= 1 valid support.
- Set `CadSourceSpec.CrossCheckPassed = false` by default.
- Deliver drop-in proposed code files (`proposed_FailFastGate.cs`, `proposed_CadSourceSpec.cs`), unified patch (`remediation.patch`), `analysis.md`, and `handoff.md`.

## Artifact Index
- `DISPATCH.md` — incoming instructions and dispatch log
- `BRIEFING.md` — situational awareness and persistent working memory
- `progress.md` — heartbeat and task tracking
- `analysis.md` — exhaustive root-cause investigation and evidence chain
- `proposed_FailFastGate.cs` — drop-in replacement implementation for FailFastGate
- `proposed_CadSourceSpec.cs` — drop-in replacement implementation for CadSourceSpec
- `remediation.patch` — unified diff patch for all 6 affected files
- `handoff.md` — 5-component self-contained handoff report for parent orchestrator
