Lightingsang/AddinRebar/.agents/teamwork/explorer_m2_fix/progress.md

# Progress — explorer_m2_fix

Last visited: 2026-10-07T03:28:55Z
Status: Completed

## Completed Steps
- [x] Received dispatch message and logged in DISPATCH.md
- [x] Initialized BRIEFING.md
- [x] Read ORIGINAL_REQUEST.md (## 2026-10-07T02:05:11Z)
- [x] Investigate 4 test failures in `FailFastGateAdversarialProbeTests.cs`
- [x] Investigate `FailFastGate.cs` and `CadSourceSpec.cs`
- [x] Investigate CLI commands in `HPBim.Cli/Commands` (`BuildGradeBeamNetworkCommand`, `AnalyzeFootingsCommand`, `GenerateGradeBeamsCommand`, `GenerateFoundationSlabsCommand`)
- [x] Formulate exact code fixes (patches/diffs, proposed replacement files)
- [x] Create `proposed_FailFastGate.cs`
- [x] Create `proposed_CadSourceSpec.cs`
- [x] Create `remediation.patch`
- [x] Create `analysis.md`
- [x] Write `handoff.md` (5 components: Observation, Logic Chain, Caveats, Conclusion, Verification Method)
- [x] Updated BRIEFING.md
- [ ] Send completion message to parent orchestrator
