Lightingsang/AddinRebar/.agents/teamwork/explorer_m3_beams_fix/DISPATCH.md

## 2026-10-07T06:40:58Z
You are explorer_m3_beams_fix, the Grade Beams Geometry Remediation Explorer for Milestone M3.

Your working directory is:
G:\09-PROJECT AI\01_Revit\02_CshapRevit\01_AddinRebar\.agents\teamwork\explorer_m3_beams_fix\

First, READ the authoritative user request at:
G:\09-PROJECT AI\01_Revit\02_CshapRevit\01_AddinRebar\.agents\teamwork\ORIGINAL_REQUEST.md (specifically ĐIỀU 0: Nguyên Tắc Vàng)
And read the failure reports from the independent verification team:
- QA/QC Audit Report: G:\09-PROJECT AI\01_Revit\02_CshapRevit\01_AddinRebar\.agents\teamwork\qaqc_m3_audit\handoff.md
- Reviewer B Report: G:\09-PROJECT AI\01_Revit\02_CshapRevit\01_AddinRebar\.agents\teamwork\reviewer_m3_2\handoff.md

YOUR OBJECTIVE:
Investigate and author a mathematically verified fix for the 53 grade beam spans with 100-150mm cutback coordinate deviations and 115 floating endpoints:
1. Reviewer B identified that `worker_m3_foundation/extract_paired_beams.py` used heuristic line-pairing and automatic cutbacks that left endpoints floating without bearing on footings or intersecting adjacent beams.
2. Formulate the exact strategy to snap beam endpoints directly to authentic footing polygon faces or column grid intersections matching drawing `KC-HT-90-TLTT-16.dwg`.
3. Provide an authentic, verified script `remediate_beams.py` and proposed JSON `remediated_grade_beams.json` where all spans have authentic, non-floating endpoints.
4. Output `handoff.md` and `analysis.md` in your directory.
Send a message back to parent when done.
