Lightingsang/AddinRebar/.agents/teamwork/explorer_m3_beams_fix/progress.md

# Progress — explorer_m3_beams_fix

Last visited: 2026-10-07T06:42:00Z

## Status
- [x] Initialized workspace (DISPATCH.md, BRIEFING.md, progress.md)
- [/] Reviewing requirements and failure reports (ORIGINAL_REQUEST.md, qaqc_m3_audit/handoff.md, reviewer_m3_2/handoff.md)
- [ ] Inspecting worker_m3_foundation scripts and beam/footing geometry data
- [ ] Analyzing CAD drawing KC-HT-90-TLTT-16.dwg beam layouts, grid intersections, footing boundaries
- [ ] Developing mathematical snapping & remediation algorithm in `remediate_beams.py`
- [ ] Executing remediation and verifying all endpoints against footing boundaries / column grid intersections
- [ ] Producing `remediated_grade_beams.json`, `analysis.md`, and `handoff.md`
