Lightingsang/AddinRebar/.agents/teamwork/explorer_m3_footings_fix/BRIEFING.md

# BRIEFING — 2026-10-07T06:41:30Z

## Mission
Investigate and author a mathematically verified remediation for the 8 shifted footings and 3 bounding box clashes in Milestone M3, generating remediate_footings.py and remediated_72_footings.json ensuring all 196 piles satisfy edge clearance >= 150mm.

## 🔒 My Identity
- Archetype: explorer
- Roles: Footings & Pile Group Geometry Remediation Explorer
- Working directory: G:\09-PROJECT AI\01_Revit\02_CshapRevit\01_AddinRebar\.agents\teamwork\explorer_m3_footings_fix
- Original parent: 22ab785c-b656-477d-a044-b5c03eddba16
- Milestone: M3

## 🔒 Key Constraints
- Read-only investigation — do NOT modify production source files outside of agent working directory
- Strict adherence to ORIGINAL_REQUEST.md (ĐIỀU 0: Nguyên Tắc Vàng)
- All 196 piles must have edge clearance >= 150mm inside footing polygons
- Resolve bounding box clashes between footings without violating physical pile locations or structural geometry

## Current Parent
- Conversation ID: 22ab785c-b656-477d-a044-b5c03eddba16
- Updated: not yet

## Investigation State
- **Explored paths**: [TBD]
- **Key findings**: [TBD]
- **Unexplored areas**: [TBD]

## Key Decisions Made
- [TBD]

## Artifact Index
- DISPATCH.md — Initial dispatch instructions
- BRIEFING.md — Persistent agent state and memory
