Lightingsang/AddinRebar/.agents/teamwork/explorer_m3_footings_fix/DISPATCH.md

## 2026-10-07T06:40:58Z
You are explorer_m3_footings_fix, the Footings & Pile Group Geometry Remediation Explorer for Milestone M3.

Your working directory is:
G:\09-PROJECT AI\01_Revit\02_CshapRevit\01_AddinRebar\.agents\teamwork\explorer_m3_footings_fix\

First, READ the authoritative user request at:
G:\09-PROJECT AI\01_Revit\02_CshapRevit\01_AddinRebar\.agents\teamwork\ORIGINAL_REQUEST.md (specifically ĐIỀU 0: Nguyên Tắc Vàng)
And read the failure reports from the independent verification team:
- QA/QC Audit Report: G:\09-PROJECT AI\01_Revit\02_CshapRevit\01_AddinRebar\.agents\teamwork\qaqc_m3_audit\handoff.md
- Reviewer B Report: G:\09-PROJECT AI\01_Revit\02_CshapRevit\01_AddinRebar\.agents\teamwork\reviewer_m3_2\handoff.md
- Challenger A Report: G:\09-PROJECT AI\01_Revit\02_CshapRevit\01_AddinRebar\.agents\teamwork\challenger_m3_1\handoff.md

YOUR OBJECTIVE:
Investigate and author a mathematically verified fix for the 8 shifted footings (`ĐC-2-04`, `ĐC-2-10`, `ĐC-2-19`, `ĐC-6-01`, `ĐC-6-04`, `ĐC-3-04`, `ĐC-3-03`, `ĐC-3'-02`):
1. Root Cause: Reviewer B identified a key collision in `generate_72_footings_data.py` on duplicate STT numbers (`{52: 2, 75: 2, 106: 2, 118: 2, 126: 2, 187: 2}`). Because a dictionary comprehension indexed by STT dropped duplicate entries, footing centroids collapsed onto a single pile rather than the group centroid, shifting boundaries by up to 450mm and causing piles P75, P81, P83, P99, P100, P106, P118, P126, P187 to protrude 20mm to 164mm outside the concrete.
2. In addition, resolve the 3 bounding box clashes: `ĐC-2-09` & `ĐC-3-04`, `ĐC-3'-01` & `ĐC-6-01`, `ĐC-6-04` & `ĐC-3'-02`.
3. Provide an authentic, verified script `remediate_footings.py` and proposed JSON `remediated_72_footings.json` where every single one of the 196 piles has positive edge clearance (>= 150mm) inside its footing polygon.
4. Output `handoff.md` and `analysis.md` in your directory.
Send a message back to parent when done.
