Lightingsang/AddinRebar/.agents/teamwork/explorer_m3_footings_fix/progress.md

# Progress — explorer_m3_footings_fix

Last visited: 2026-10-07T06:41:40Z

- [x] Initialized DISPATCH.md and BRIEFING.md
- [ ] Read ORIGINAL_REQUEST.md (ĐIỀU 0)
- [ ] Read audit reports from qaqc_m3_audit, reviewer_m3_2, challenger_m3_1
- [ ] Inspect existing data files and scripts (generate_72_footings_data.py, etc.)
- [ ] Analyze root cause of 8 shifted footings and duplicate STT key collision
- [ ] Analyze 3 bounding box clashes (ĐC-2-09 & ĐC-3-04, ĐC-3'-01 & ĐC-6-01, ĐC-6-04 & ĐC-3'-02)
- [ ] Develop and verify remediate_footings.py
- [ ] Generate remediated_72_footings.json and verify all 196 piles >= 150mm clearance
- [ ] Produce analysis.md and handoff.md
- [ ] Notify parent agent
