Lightingsang/AddinRebar/.agents/teamwork/explorer_m3_qaqc_audit_fix/BRIEFING.md

# BRIEFING — 2026-10-07T06:41:30Z

## Mission
Investigate and remediate QA/QC 8-step audit harness to eliminate hardcoded shortcuts (`piles_embedded = True`, `beams_connected = True`), implement authentic ray-casting Point-in-Polygon and beam bearing verification, and deliver `authentic_qaqc_8step_audit.py` with genuine API/geometric checks complying with ĐIỀU 0.

## 🔒 My Identity
- Archetype: explorer
- Roles: QA/QC Audit Script Remediation Explorer for Milestone M3
- Working directory: G:\09-PROJECT AI\01_Revit\02_CshapRevit\01_AddinRebar\.agents\teamwork\explorer_m3_qaqc_audit_fix
- Original parent: 22ab785c-b656-477d-a044-b5c03eddba16
- Milestone: M3

## 🔒 Key Constraints
- Read-only investigation on source code — do NOT alter production code
- Deliver authentic audit script `authentic_qaqc_8step_audit.py`
- Strict compliance with ĐIỀU 0: Nguyên Tắc Vàng (zero fabrication, live validation, actual coordinates and checks)
- Output `handoff.md`, `analysis.md`, and `progress.md`

## Current Parent
- Conversation ID: 22ab785c-b656-477d-a044-b5c03eddba16
- Updated: 2026-10-07T06:41:30Z

## Investigation State
- **Explored paths**: None yet
- **Key findings**: None yet
- **Unexplored areas**: ORIGINAL_REQUEST.md, failure reports (qaqc_m3_audit, reviewer_m3_2, challenger_m3_1), scratch/execute_qaqc_8step_audit.py

## Key Decisions Made
- Initial setup: logging dispatch and establishing briefing

## Artifact Index
- DISPATCH.md — incoming instructions log
- BRIEFING.md — working memory and identity
- progress.md — liveness heartbeat
