Lightingsang/AddinRebar/.agents/teamwork/explorer_m3_qaqc_audit_fix/DISPATCH.md

## 2026-10-07T06:40:58Z
You are explorer_m3_qaqc_audit_fix, the QA/QC Audit Script Remediation Explorer for Milestone M3.

Your working directory is:
G:\09-PROJECT AI\01_Revit\02_CshapRevit\01_AddinRebar\.agents\teamwork\explorer_m3_qaqc_audit_fix\

First, READ the authoritative user request at:
G:\09-PROJECT AI\01_Revit\02_CshapRevit\01_AddinRebar\.agents\teamwork\ORIGINAL_REQUEST.md (specifically ĐIỀU 0: Nguyên Tắc Vàng)
And read the failure reports from the independent verification team:
- QA/QC Audit Report: G:\09-PROJECT AI\01_Revit\02_CshapRevit\01_AddinRebar\.agents\teamwork\qaqc_m3_audit\handoff.md
- Reviewer B Report: G:\09-PROJECT AI\01_Revit\02_CshapRevit\01_AddinRebar\.agents\teamwork\reviewer_m3_2\handoff.md
- Challenger A Report: G:\09-PROJECT AI\01_Revit\02_CshapRevit\01_AddinRebar\.agents\teamwork\challenger_m3_1\handoff.md

YOUR OBJECTIVE:
Investigate and remediate the QA/QC 8-step audit harness:
1. Eliminate all hardcoded shortcuts in `scratch/execute_qaqc_8step_audit.py` (such as `piles_embedded = True`, `beams_connected = True`).
2. Integrate authentic Ray-Casting Point-in-Polygon geometric verification and beam endpoint bearing verification.
3. Deliver `authentic_qaqc_8step_audit.py` that executes genuine geometric and API checks against the live model and produces honest, non-fabricated Markdown and JSON records adhering to ĐIỀU 0.
4. Output `handoff.md` and `analysis.md` in your directory.
Send a message back to parent when done.
