Lightingsang/AddinRebar/.agents/teamwork/explorer_m3_qaqc_audit_fix/progress.md

# Progress — explorer_m3_qaqc_audit_fix

Last visited: 2026-10-07T06:44:20Z
Status: In Progress - Designing Authentic QA/QC Audit Harness

## Tasks
- [x] Step 1: Log dispatch and setup BRIEFING.md / progress.md
- [x] Step 2: Read ORIGINAL_REQUEST.md (ĐIỀU 0: Nguyên Tắc Vàng)
- [x] Step 3: Read independent verification failure reports:
  - [x] `qaqc_m3_audit/handoff.md`
  - [x] `reviewer_m3_2/handoff.md`
  - [x] `challenger_m3_1/handoff.md`
- [x] Step 4: Examine `scratch/execute_qaqc_8step_audit.py` to identify all hardcoded shortcuts and mock logic
- [ ] Step 5: Design and implement authentic geometric algorithms:
  - Authentic Ray-Casting Point-in-Polygon (2D polygon in XY plane, accounting for cap rotation/bounding box/solid faces)
  - Authentic beam endpoint bearing and support verification (checking beam curve start/end against column/footing bounding boxes or locations)
  - Elimination of all `piles_embedded = True`, `beams_connected = True` shortcuts
  - Real Revit API queries and extraction through HPRebar MCP bridge
- [ ] Step 6: Test/execute `authentic_qaqc_8step_audit.py` or verify its syntax and execution capabilities against the live Revit model
- [ ] Step 7: Author `analysis.md` and `handoff.md`
- [ ] Step 8: Update BRIEFING.md and notify parent via `send_message`
