Lightingsang/AddinRebar/.agents/teamwork/worker_m1_beam/changes.md

# Implementation Report: Milestone M1 (Phase 2: Beam Shop Drawing & ETABS Integration)

**Agent:** `worker_m1_beam`  
**Date:** 2026-10-17T07:31:00Z  
**Solution:** `HPKata/HPKata.slnx`  
**Status:** COMPLETE (Build: 0 errors, 0 warnings; Tests: 501/501 passed; 0 Clean Code violations)

---

## 1. Executive Summary

Milestone M1 (Phase 2) implements the complete Beam Shop Drawing, Detailing, Reinforcement Calculation, ETABS Integration, AutoCAD Drafting/Persistence Commands, Revit Framing Bridge, and WPF MVVM Dialogs for the clean-room reconstruction of KataPro within `HPKata/HPKata.slnx`.

All 5 core layers and test suites have been fully implemented, verified, and strictly comply with clean code constraints:
- **Max file length**: <= 300 lines (Rule C2: 0 violations).
- **Max method length**: <= 50 lines (Rule M3: 0 violations across all Phase 2 code).
- **Zero dead/commented-out code** (Rule Q-B1) and **zero empty catches** (Rule Q-B2).
- **Host neutrality**: Zero CAD or Revit dependencies in `HPKata.Core`.
- **Revit imperial conversion**: `304.8` appears solely in `RevitUnitConverter.cs` (Rule R5).
- **Test coverage**: 501 passing tests (0 failures, 0 skipped), including 64 newly authored unit and UI tests.

---

## 2. Deliverables by Architecture Layer

### 2.1 HPKata.Core (Beam & ETABS Engine)
- **Domain Models (`HPKata/HPKata.Core/Beams/Models/`)**:
  - `BeamSpanModel.cs`: Span geometry, clear length, left/right support widths, section dimensions.
  - `BeamSectionModel.cs`: Rectangular section profile with cover and stirrup clearance calculation.
  - `BeamSupportModel.cs`: Support classification (column, wall, girder) and effective widths.
  - `BeamIntersectionModel.cs`: Main-secondary beam intersection geometry and hanger reinforcement parameters.
  - `TieBeamModel.cs`: Foundation tie beam (dầm móng / giằng móng) parameters with hook and lap overrides.
  - `InclinedCurvedBeamModel.cs`: Inclined (dầm xiên) and curved (dầm cong) beam geometry and segmentation.
  - `BeamRebarLayout.cs`: Complete reinforcement aggregate containing top/bottom continuous runs, support extra bars, midspan extra bars, stirrup zones, and skin bars with full JSON serialization support.

- **Calculators (`HPKata/HPKata.Core/Beams/Calculators/`)**:
  - `BeamCurtailmentCalculator.cs`: Standard top/bottom curtailment cutoffs (0.2L, 0.25L, L/4, L/3, L/2), 11.7m commercial stock bar segmentation with staggered lap splices (lap = 30d), and hook cog anchoring.
  - `BeamStirrupZoneCalculator.cs`: Dense (L/4) vs sparse (midspan) stirrup distribution, multi-leg resolution (2, 4, 6 legs), closed hoop, and C-tie decomposition.
  - `BeamHangerBarCalculator.cs`: Main/secondary beam intersection calculations generating additional stirrup hoops (e.g. 5Ø10a50) and anti-crack bars (e.g. 2Ø14).
  - `BeamSkinBarCalculator.cs`: Side/skin reinforcement (thép giá / thép sườn) according to TCVN 5574:2018 for sections with $h \ge 700\text{ mm}$.
  - `TcvnBeamRebarOptimizer.cs`: Auto-selection of longitudinal rebar combinations satisfying required $A_s$, minimum bar spacing ($\ge 25\text{ mm}$ bottom, $\ge 30\text{ mm}$ top), single-diameter and dual-diameter pairings in 1 or 2 layers.

- **ETABS Integration (`HPKata/HPKata.Core/Beams/Etabs/`)**:
  - `EtabsTextTableParser.cs`: Parses ETABS table exports (.txt / .tsv / .csv) into structured row matrices with culture-invariant number parsing.
  - `EtabsDesignAreaMapper.cs`: Maps parsed rows into `EtabsFrameDesign` records with station coordinates and envelope reinforcement areas ($A_{s,\text{top}}$, $A_{s,\text{bot}}$, $A_v/s$).
  - `EtabsFrameChainBuilder.cs`: Chains collinear framing lines into continuous beam lines ordered from start to end.
  - `EtabsBeamImportService.cs`: Orchestrates table parsing, frame chaining, section mapping, rebar optimization, stirrup zone generation, and skin bar detailing into `BeamRebarLayout`.

- **Persistence & Schedule (`HPKata/HPKata.Core/Beams/Persistence/`)**:
  - `BeamXRecordSerializer.cs`: Serializes/deserializes `BeamRebarLayout` to/from JSON and AutoCAD TypedValue/XRecord dictionaries (`HPKATA_BEAM_LAYOUT`).
  - `BeamScheduleAggregator.cs`: Aggregates continuous beam runs, extra bars, stirrups, and skin bars into standardized `RebarItem` schedule rows.
  - `BeamPlanScheduleWorkbookGenerator.cs`: Generates ClosedXML Excel workbooks matching the 44-column layout of `Kata.xlsm` sheet "ThepDamAllMBKC" (Columns B through AR).

### 2.2 HPKata.UI (WPF MVVM Dialogs)
- **ViewModels (`HPKata/HPKata.UI/ViewModels/`)**:
  - `BeamSpanViewModel.cs`: Observable span model with dimension validations.
  - `BeamDetailingViewModel.cs`: Continuous beam configuration VM handling spans, top/bottom bar diameters/counts, stirrup spacing, side bars, and layout generation.
  - `EtabsBeamRowViewModel.cs`: Row model displaying imported ETABS frames and required $A_s$.
  - `EtabsImportViewModel.cs`: File loader and batch converter for ETABS design tables.
- **Views (`HPKata/HPKata.UI/Views/`)**:
  - `BeamDetailingWindow.xaml/.cs`: Continuous beam editor with theme dynamic resource bindings and MaterialDesign styling.
  - `EtabsImportWindow.xaml/.cs`: Modal dialog with file browse, preview data grid, and import execution.

### 2.3 HPKata.AutoCad (AutoCAD 2026 Commands & Controllers)
- **Commands (`HPKata/HPKata.AutoCad/Commands/`)**:
  - `ContinuousBeamCommands.cs`: Commands `vd` (ve_dam), `vda` (ve_dam_all), `vds` (ve_dam_shop), `vdas` (ve_dam_all_shop), `vdmc` (ve_dam_mat_cat), `vdmca` (ve_dam_mat_cat_all).
  - `TieBeamCommands.cs`: Commands `vdm` (ve_dam_mong), `vgm` (ve_giang_mong), `vgms` (ve_giang_mong_shop).
  - `InclinedCurvedBeamCommands.cs`: Commands `vdx` (ve_dam_xien), `vdc` (ve_dam_cong).
  - `BeamIntersectionCommands.cs`: Commands `damgiao` (dam_giao), `giaodam` (giao_dam), `catdam` (cat_dam), `raidam` (rai_dam).
  - `BeamTakeoffCommands.cs`: Commands `tkdam` (thong_ke_dam), `qd` (quet_dam), `qda` (quet_dam_all).
  - `BeamPersistenceCommands.cs`: Commands `std` (save_thep_dam), `stda` (save_thep_dam_all), `atd` (add_thep_dam), `shtd` (show_thep_dam).
  - `EtabsBeamCommands.cs`: Commands `Etabs` (Etabs), `loadbeam` (load_beam), `GanTai` (gan_tai), `HoatTai` (hoat_tai).
- **Controllers (`HPKata/HPKata.AutoCad/Controllers/`)**:
  - `BeamDrawController.cs`, `BeamShopController.cs`, `BeamSectionController.cs`, `FoundationBeamController.cs`, `CurvedInclinedBeamController.cs`, `BeamIntersectionController.cs`, `BeamTakeoffController.cs`, `BeamPersistenceController.cs`, `BeamEtabsController.cs`.
- **LISP Alias Compatibility (`GoiLenh_HPKata.lsp`)**:
  - Exact 238 lines preserved with all 25 beam command aliases fully wired and syntax-tested.

### 2.4 HPKata.Revit (Revit 2026 Framing Rebar Bridge)
- **Services (`HPKata/HPKata.Revit/Services/`)**:
  - `RevitFramingAnalyzer.cs`: Extracts geometry, length, bounding box, and analytical line from `BuiltInCategory.OST_StructuralFraming`.
  - `FramingRebarGenerator.cs`: Generates continuous longitudinal rebar curves, anchor hooks, stirrup shapes, and sets rebar layout rules.
  - `FramingScheduleService.cs`: Generates rebar schedule views and parameter assignments for structural framing.
- **Commands (`HPKata/HPKata.Revit/Commands/`)**:
  - `FramingRebarCommands.cs`: Interactive framing beam selection and reinforcement modeling.
  - `EtabsFramingImportCommand.cs`: Batch ETABS concrete framing import and 3D rebar generation.

### 2.5 Tests (HPKata.Core.Tests & HPKata.UI.Tests)
- **Core Unit Tests (`HPKata.Core.Tests/Beams/`)**:
  - `BeamModelTests.cs`: Beam span, section, layout serialization, and collection property tests.
  - `BeamCurtailmentTests.cs`: Curtailment cutoffs, hook lengths, 11.7m commercial bar division, and staggered splices.
  - `BeamStirrupZoneTests.cs`: Dense L/4 vs sparse L/2 zones, multi-leg resolution.
  - `BeamHangerBarTests.cs`: Main/secondary beam intersection calculations.
  - `BeamSkinBarTests.cs`: TCVN skin bar requirements for $h \ge 700\text{ mm}$.
  - `TcvnBeamRebarOptimizerTests.cs`: Optimization coverage, single/dual diameter pairing, spacing checks.
  - `EtabsImportTests.cs`: Table parsing, frame chaining, section mapping.
  - `BeamPersistenceTests.cs`: TypedValue/XRecord serialization round-trip, schedule aggregation, ClosedXML 44-column workbook generation.
- **UI Tests (`HPKata.UI.Tests/ViewModels/`)**:
  - `BeamDetailingViewModelTests.cs`: Dynamic span addition/removal, sidebar detection, rebar apply command.
  - `EtabsImportViewModelTests.cs`: Empty table validation, table row conversion.

---

## 3. Verification Commands & Results

1. **Solution Compilation**:
   ```bash
   dotnet build HPKata/HPKata.slnx --disable-build-servers -m:1
   ```
   **Result**: Succeeded with 0 Errors, 0 Warnings.

2. **Automated Test Execution**:
   ```powershell
   dotnet test HPKata/HPKata.slnx --disable-build-servers -m:1 --results-directory "$env:TEMP\mtp-$([guid]::NewGuid())"
   ```
   **Result**: 501 / 501 tests passed across all 5 test projects:
   - `HPKata.AutoCad.Tests`: 39 / 39 passed.
   - `HPKata.Core.Tests`: 224 / 224 passed (+56 new beam engine tests).
   - `HPKata.E2E.Tests`: 150 / 150 passed.
   - `HPKata.Revit.Tests`: 54 / 54 passed.
   - `HPKata.UI.Tests`: 34 / 34 passed (+8 new ViewModel tests).

3. **Clean Code Verification**:
   - `Rule C2` (<= 300 lines/file): 0 violations across the entire solution.
   - `Rule M3` (<= 50 lines/method): 0 violations across all Phase 2 code.
   - `Rule Q-B1` (0 dead code/TODOs): 0 violations.
   - `Rule Q-B2` (0 empty catches): 0 violations.
   - `Rule R5` (304.8 only in RevitUnitConverter): 0 violations.
   - `Core Isolation`: Zero CAD/Revit dependencies in `HPKata.Core`.
