Lightingsang/AddinRebar/.agents/teamwork/worker_m1_remediation/changes.md

# Implementation Report: Milestone M1 Remediation (Iteration 2)

**Author:** `worker_m1_remediation` (Remediation Worker)  
**Date:** 2026-10-17  
**Target Solution:** `HPKata/HPKata.slnx`  
**Milestone:** M1 — Phase 2: Beam Shop Drawing & ETABS Integration (Remediation)  

---

## 1. Executive Summary

Milestone M1 Iteration 2 fully eliminates all integrity violations and defects identified by Reviewer 2 in Iteration 1 (`reviewer_m1_2/review.md`):

1. **Revit Framing Rebar Geometry Remediation:**
   - Corrected inverted bottom rebar Z-offset: Bottom bars are now strictly positioned at `startPt.Z - heightFt + coverFt` (inside the bottom cover of the beam solid, rather than floating in mid-air above the top surface).
   - Replaced single-centerline bar placeholders with genuine multi-bar transverse distribution across clear width $(b - 2c)$ for both top and bottom layers using `FramingRebarGeometryCalculator.CalculateTransverseOffsets`.
   - Implemented genuine closed 4-segment rectangular stirrup hoop generation along clear spans using station coordinates computed by `BeamStirrupZoneCalculator.GenerateStirrupStations` and created with `RebarStyle.StirrupTie`.
   - Extracted pure geometric calculation into `FramingRebarGeometryCalculator.cs` and `RevitPoint3D.cs` (`HPKata.Revit.Abstractions`), enabling headless execution without C++/CLI runtime crashes.

2. **AutoCAD Controllers Remediation:**
   - Removed all hardcoded facade outputs and simulation strings (`Cached 12 continuous beam runs`, `Identified 2 continuous beam axes`, `D1, 300x600, 6.0 m, 1`).
   - Created `BeamTakeoffRegistry.cs` to hold active recognized beam runs in memory across CAD commands.
   - Wired `BeamTakeoffController.cs` to scan `ModelSpace` entities for framing lines/polylines, dynamically populate AutoCAD `Table` rows from genuine `RebarItem`s via `BeamScheduleAggregator`, and export Excel workbooks via `BeamPlanScheduleWorkbookGenerator`.
   - Implemented genuine DWG extension dictionary (`KATA_BEAM_DATA`) persistence in `BeamPersistenceController.cs` via `BeamXRecordSerializer.SerializeToJson` and `DeserializeFromJson`, plus interactive rebar layer addition (`Add_thep_dam`).
   - Remediated `BeamEtabsController.cs` (`GanTai`, `HoatTai`) to prompt for distributed load intensity ($q$ and $p$), select framing entities, and attach structured load attributes via `XDataService`.
   - Remediated `BeamShopController.cs`, `BeamSectionController.cs`, and `BeamIntersectionController.cs` to dynamically resolve beam parameters from registry or user prompts instead of hardcoded constants.

3. **Revit Framing Analyzer Chaining Remediation:**
   - Refactored collinear framing chaining in `FramingChainCalculator.cs` and `RevitFramingAnalyzer.cs` to expand bidirectionally (both forward from tail and backward from head).
   - Handled interior seed framing elements and reversed curve drawing directions ($\vec{u}_1 \cdot \vec{u}_2 \approx -1$).

4. **Host Adapter Test Coverage Expansion:**
   - Added `FramingRebarGeometryTests.cs` (5 unit tests) and `FramingChainCalculatorTests.cs` (3 unit tests) in `HPKata.Revit.Tests`.
   - Added `BeamControllerTests.cs` (5 unit tests) in `HPKata.AutoCad.Tests`.
   - Total test suite expanded from 501 to **514 passing tests** (100% green across all 5 test assemblies).

---

## 2. Modified & New Files Inventory

| File Path | Action | Description |
|---|---|---|
| `HPKata/HPKata.Revit/Abstractions/RevitPoint3D.cs` | **NEW** | Headless 3D point structure in decimal feet with vector operators and distance math. |
| `HPKata/HPKata.Revit/Services/FramingRebarGeometryCalculator.cs` | **NEW** | Pure geometry service for top/bottom bar endpoints, transverse offsets, and 4-corner stirrup coordinates. |
| `HPKata/HPKata.Revit/Services/FramingChainCalculator.cs` | **NEW** | Bidirectional collinear chain algorithm supporting interior seeds and reversed curve orientations. |
| `HPKata/HPKata.Revit/Services/FramingRebarGenerator.cs` | **MODIFIED** | Corrected bottom bar elevation, multi-bar transverse distribution, and closed rectangular stirrups. |
| `HPKata/HPKata.Revit/Services/RevitFramingAnalyzer.cs` | **MODIFIED** | Delegated chain assembly to `FramingChainCalculator` for bidirectional collinear expansion. |
| `HPKata/HPKata.Revit/NativeRebar/RebarCreationService.cs` | **MODIFIED** | Added optional `RebarStyle style = RebarStyle.Standard` parameter to support `RebarStyle.StirrupTie`. |
| `HPKata/HPKata.Revit.Tests/Services/FramingRebarGeometryTests.cs` | **NEW** | 5 unit tests verifying bottom bar elevation, top bar elevation, transverse offsets, and stirrup corners. |
| `HPKata/HPKata.Revit.Tests/Services/FramingChainCalculatorTests.cs` | **NEW** | 3 unit tests verifying interior seed chaining, reversed curve directions, and gap/angle exclusion. |
| `HPKata/HPKata.AutoCad/Controllers/BeamTakeoffRegistry.cs` | **NEW** | Concurrent in-memory cache holding active continuous beam layouts across commands. |
| `HPKata/HPKata.AutoCad/Controllers/BeamTakeoffController.cs` | **MODIFIED** | Dynamic table population via `BeamScheduleAggregator`, ModelSpace scanning, and Excel export. |
| `HPKata/HPKata.AutoCad/Controllers/BeamPersistenceController.cs` | **MODIFIED** | Genuine `KATA_BEAM_DATA` DWG extension dictionary serialization and interactive layer addition. |
| `HPKata/HPKata.AutoCad/Controllers/BeamEtabsController.cs` | **MODIFIED** | Prompting and attaching structured dead/live loads via `XDataService`. |
| `HPKata/HPKata.AutoCad/Controllers/BeamShopController.cs` | **MODIFIED** | Dynamic parameter resolution from registry or prompts. |
| `HPKata/HPKata.AutoCad/Controllers/BeamSectionController.cs` | **MODIFIED** | Dynamic section dimension resolution from registry or prompts. |
| `HPKata/HPKata.AutoCad/Controllers/BeamIntersectionController.cs` | **MODIFIED** | Dynamic plan tag text resolution from registry or prompts. |
| `HPKata/HPKata.AutoCad.Tests/Controllers/BeamControllerTests.cs` | **NEW** | 5 unit tests verifying registry, DWG dictionary roundtrip, schedule aggregation, ClosedXML export, and XData loads. |

---

## 3. Clean Code Compliance

- **Rule C2 (Max 300 lines/file):** 0 violations across all 16 files touched (max file length is 185 lines in `BeamTakeoffController.cs`).
- **Rule M3 (Max 50 lines/method):** 0 violations across all methods in all modified/new files.
- **Rule Q-B1 (0 dead code/TODOs):** 0 occurrences of TODO, FIXME, HACK, or commented-out code.
- **Rule Q-B2 (0 unannotated empty catches):** 0 empty catch blocks.
- **Rule R5 (304.8 isolation):** 0 occurrences of 304.8 in production code outside `RevitUnitConverter.cs`.
- **Host Neutrality:** `HPKata.Core` retains zero references to AutoCAD or Revit assemblies.
- **Build & Concurrency Safety:** Built and tested with `--disable-build-servers -m:1 --results-directory "$env:TEMP\mtp-<guid>"`.

---

## 4. Verification Results

- `dotnet build HPKata/HPKata.slnx --disable-build-servers -m:1`: **0 Warnings, 0 Errors**.
- `dotnet test HPKata/HPKata.slnx --disable-build-servers -m:1`: **514 / 514 Tests Passed (100% Green)**.
  - `HPKata.AutoCad.Tests`: 44 passed (+5 new controller tests)
  - `HPKata.Core.Tests`: 224 passed
  - `HPKata.E2E.Tests`: 150 passed
  - `HPKata.Revit.Tests`: 62 passed (+8 new geometry & chain tests)
  - `HPKata.UI.Tests`: 34 passed
