Lightingsang/AddinRebar/.agents/teamwork/worker_m2_fix/BRIEFING.md

# BRIEFING — 2026-10-07T03:41:00Z

## Mission
Implement HPBim Milestone M2 Remediation: Fix 4 adversarial test failures in FailFastGateAdversarialProbeTests and eliminate speculative fallbacks/bypass flags across HPBim CLI commands, adhering strictly to ĐIỀU 0.

## 🔒 My Identity
- Archetype: worker
- Roles: implementer, qa, specialist
- Working directory: G:\09-PROJECT AI\01_Revit\02_CshapRevit\01_AddinRebar\.agents\teamwork\worker_m2_fix\
- Original parent: 22ab785c-b656-477d-a044-b5c03eddba16
- Milestone: M2 Remediation

## 🔒 Key Constraints
- ĐIỀU 0: Tuyệt đối không giả định, bịa đặt, suy đoán tham số cấu kiện kết cấu. Không gán default type nếu thiếu.
- Fail-Fast là bắt buộc, không được có cờ bypass như `--force-unverified` hay opt-in `--fail-fast`.
- DO NOT CHEAT: không hardcode test outputs, không dummy facades.
- All 314 tests in HPBim.Core.Tests and HPBim.Client.Tests must pass genuinely.

## Current Parent
- Conversation ID: 22ab785c-b656-477d-a044-b5c03eddba16
- Updated: 2026-10-07T03:41:00Z

## Task Summary
- **What to build**: Fix CadSourceSpec default cross-check flag, enhance FailFastGate validation (IsFinite, elevation relation, supports validation), eliminate CLI bypass/speculative defaults in BuildGradeBeamNetworkCommand, AnalyzeFootingsCommand, GenerateGradeBeamsCommand, GenerateFoundationSlabsCommand.
- **Success criteria**: 314/314 tests pass across Core and Client test suites.
- **Interface contracts**: `IFailFastGate`, `CadSourceSpec`, `FailFastCoordinationException`

## Change Tracker
- **Files modified**:
  - `HPBim/src/HPBim.Core/Coordination/CadSourceSpec.cs`: default `CrossCheckPassed = false;`
  - `HPBim/src/HPBim.Core/Coordination/FailFastGate.cs`: IEEE 754 IsFinite checks, support whitespace filtering, footing support requirement
  - `HPBim/src/HPBim.Cli/Commands/BuildGradeBeamNetworkCommand.cs`: unconditional FailFastCoordinationException on unverified items
  - `HPBim/src/HPBim.Cli/Commands/AnalyzeFootingsCommand.cs`: unconditional FailFastCoordinationException on cluster violations
  - `HPBim/src/HPBim.Cli/Commands/GenerateGradeBeamsCommand.cs`: removed `--force-unverified` bypass, eliminated `defaultSymbol` fallback (throws per ĐIỀU 0)
  - `HPBim/src/HPBim.Cli/Commands/GenerateFoundationSlabsCommand.cs`: injected IFailFastGate, blocked `isSpeculativeCluster`, validated footings through gate
  - `HPBim/tests/HPBim.Client.Tests/Connection/RevitPipeClientAdversarialTests.cs`: wrapped server streams in try-catch IOException to prevent test pipe disposal race
- **Build status**: PASS (0 warnings, 0 errors)
- **Pending issues**: None

## Quality Status
- **Build/test result**: PASS. Core tests: 218/218 passed; Client tests: 96/96 passed. Total: 314/314 passed (100%).
- **Lint status**: clean
- **Tests added/modified**: 4 probe tests in Core suite previously failing now 100% pass.

## Key Decisions Made
- Replaced FailFastGate with genuine logic checking IEEE 754 finite values on elevations and dimensions.
- Enforced strict support validation filtering out whitespace/empty strings.
- Enforced zero speculation in CLI commands: removed flags that bypassed Fail-Fast or defaulted missing types.

## Artifact Index
- `handoff.md` — Final handoff report
- `progress.md` — Liveness and task progress tracking
- `DISPATCH.md` — Assignment instructions
