Lightingsang/AddinRebar/.agents/teamwork/worker_m2_fix/progress.md

# Progress — worker_m2_fix

Last visited: 2026-10-07T03:41:30Z
Current Status: Completed

## Tasks
- [x] Read DISPATCH.md and initialize workspace (DISPATCH.md, BRIEFING.md, progress.md)
- [x] Review ORIGINAL_REQUEST.md (ĐIỀU 0) and explorer_m2_fix handoff & analysis artifacts
- [x] Inspect existing files and test baseline
- [x] Apply CadSourceSpec and FailFastGate changes
- [x] Apply CLI commands remediation (BuildGradeBeamNetwork, AnalyzeFootings, GenerateGradeBeams, GenerateFoundationSlabs)
- [x] Fix pipe test race condition in RevitPipeClientAdversarialTests.cs
- [x] Run `dotnet test` on HPBim.Core.Tests and HPBim.Client.Tests
- [x] Verify test results (314/314 passing - 100% GREEN)
- [x] Write handoff.md and report to parent
