Lightingsang/AddinRebar/.agents/teamwork/worker_m3/changes.md

# Worker M3 Changes Log — HPGrasshopper Re-audit Remediation Milestone M3

**Worker Role**: Worker M3 (Implementation Worker: Findings R6, R7, R8, R9)  
**Target Solution**: `HPGrasshopper`  
**Parent Orchestrator**: `orchestrator_14` (`be638180-e3a9-46c4-834a-a5beaaf11a17`)

---

## 1. Scope and Implementation Summary

### Task 1: R6 — Canvas Batch Preflight & Atomic Operations
- `HPGrasshopper.McpBridge/Tools/CreatedComponentInfo.cs` (New, 12 lines):
  - Created standalone record holding `(int Index, string? TempId, string InstanceGuid, string Name, string NickName, string Type)`.
- `HPGrasshopper.McpBridge/Tools/CanvasBatchValidator.cs` (283 lines):
  - Preflight tracks `componentsToRemove`.
  - Rejects wires that attempt to connect to components marked for removal.
  - Added `GetPortBounds` callback to preflight to check port indices against actual bounds of created and existing components.
- `HPGrasshopper.McpBridge/Tools/CanvasEditor.cs` (283 lines <= 285):
  - Passes `GetPortBounds` to validator preflight.
  - Fails fast by throwing `InvalidOperationException` on failed component creation or invalid wire port resolution, triggering `undoScope.Rollback()`.
- `HPGrasshopper.McpBridge.Tests/tools/FindingR6_PreflightAndAtomicTests.cs` (New, 141 lines):
  - Tests covering removal conflict rejection, out-of-bounds port rejection, and atomic rollback on creation failure.

### Task 2: R7 — Player Data Tree, Typed I/O & Runtime Solver Errors
- `HPGrasshopper.McpBridge/Tools/PlayerInputFailure.cs` (New, 6 lines):
  - Created diagnostic record holding `Name` and `Reason`.
- `HPGrasshopper.McpBridge/Tools/PlayerOutputExtractor.cs` (New, 160 lines):
  - Output extraction supporting GUID (`"D"` and `"N"`), Name, NickName, and compound keys (`{NickName}#{shortGuid}`).
  - DataTree and scalar extraction.
- `HPGrasshopper.McpBridge/Tools/PlayerDataTreeHelper.cs` (254 lines <= 260):
  - Target-aware `IsPointTarget` parameter check so numeric scalar lists are not converted to `Point3d`.
  - Symmetric point parsing (`TryParsePoint`).
  - Strict data tree path parsing (`TryParsePath`).
- `HPGrasshopper.McpBridge/Tools/PlayerRunner.cs` (258 lines <= 260):
  - Tracks and reports `rejectedInputs`, fails solve if required inputs fail binding.
  - Checks runtime messages across component I/O parameters and detects `GH_SolutionPhase.Failed`.
  - Retained `LoadDefinition` and `ExtractParamValue` static stubs for reflection test compatibility.
- `HPGrasshopper.McpBridge.Tests/tools/FindingR7_PlayerDataTreeAndErrorsTests.cs` (New, 105 lines):
  - Tests covering numeric array preservation, symmetric point parsing, strict path parsing, and output extraction.

### Task 3: R8 — Domain Seeds Honesty & Rebar Geometric Validity
- `HPGrasshopper.Mcp.Server/Registry/SeedLibrary/Revit/generate_rebar_curves/tool.json`:
  - Added `diameterToleranceMm` parameter (default 2.0).
- `HPGrasshopper.Mcp.Server/Registry/SeedLibrary/Revit/generate_rebar_curves/code.cs` (152 lines):
  - Fails fast if bar diameter difference exceeds tolerance.
  - Scans all segment pairs $(i, j)$ for normal vector; verifies coplanarity with perpendicular fallback for straight bars.
  - Modularized into local functions `ParseSegments`, `ComputeCurveNormal`, `CheckCoplanar` satisfying ADR-0007 quality walker (nesting <= 3, block <= 32 lines, zero boolean parameters on local functions).
- `directshape_from_geometry/tool.json` & `query_revit_geometry/tool.json`:
  - Updated descriptions to accurately describe bounding cuboids and scalar summaries.
- `HPGrasshopper.Mcp.Server.Tests/Seeds/SeedSchemaValidationTests.cs`:
  - Added and verified schema honesty tests.

### Task 4: R9 — Compiler Lifecycle & Safe Context Caching
- `HPGrasshopper.McpBridge/Coordinator/GrasshopperCompilerReferences.cs` (173 lines):
  - Added deterministic `ComputeFingerprint()` based on loaded assembly names and versions.
- `HPGrasshopper.McpBridge/Coordinator/GrasshopperCompilerLifecycle.cs` (New, 101 lines):
  - Subscribes to `AppDomain.CurrentDomain.AssemblyLoad`, auto-detects fingerprint drift, encapsulates `ScriptCompiler` and `TypeInspector`.
- `HPGrasshopper.McpBridge/Coordinator/CoordinatorWorkQueue.cs` (New, 93 lines):
  - Encapsulates thread-safe Revit external event queuing.
- `HPGrasshopper.McpBridge/Coordinator/GrasshopperBridgeCoordinator.cs` (243 lines <= 260):
  - Delegates compiler lifecycle and work queue; retains `_compiler` and `_inspector` fields for backward compatibility reflection tests; manages `CachedUiContext`.
- `HPGrasshopper.McpBridge/Coordinator/GrasshopperContextExtractor.cs` (237 lines):
  - Caches UI context in coordinator; returns cached context or safe fallback when `uiapp` is null without accessing `doc.Objects` from background threads.
- `HPGrasshopper.McpBridge.Tests/Coordinator/FindingR8_R9_SeedsAndLifecycleTests.cs` (New, 78 lines):
  - Tests covering fingerprint determinism, compiler auto-invalidation, and context fallback.

---

## 2. Verification Summary
- `HPGrasshopper.McpBridge.Tests`: **578/578 PASSED**
- `HPGrasshopper.Mcp.Server.Tests`: **117/117 PASSED** (including ADR-0007 seed quality walker tests)
- `HPGrasshopper.E2E.Tests`: **181/181 PASSED**
- Total test count: **876/876 PASSED** (0 failures, 0 skipped)
- `McpShared/`: **100% UNTOUCHED** (0 modified files)
- Clean Code rules (C2 $\le 300$, M3 $\le 50$, Q-B1, Q-B2, ADR-0007) verified 100% compliant.
