Lightingsang/AddinRebar/.agents/teamwork/worker_m3_fix_gen2/progress.md

# Progress Log - worker_m3_fix_gen2

Last visited: 2026-10-06T02:53:00Z

## Status
- [x] Read explorer_m3_fix_gen2/handoff.md blueprint
- [x] Step 1: Create PipeMessageReader.cs in HPBim/src/HPBim.Client/Connection/ (113 lines)
- [x] Step 2: Refactor RevitPipeClient.cs with _connectLock and delegate to reader (200 lines, strictly <= 200 lines)
- [x] Step 3: Refactor RevitModelVerifier.cs (CompareCounts decomposed to 7 lines with ElementCounts helper methods, 164 lines total)
- [x] Step 4: Integrate TypeResolutionRules into Stage5OpeningGenerator.cs (119 lines)
- [x] Step 5: Modularize CompositeBimGenerator into 4 partial classes (all 8 stages: 72, 120, 113, 168 lines)
- [x] Step 6: Add unit tests:
  - TypeResolutionRulesTests.cs (40 lines)
  - CompositeBimGenerator_IncludesAll8StagesInScriptAndArgs in StageGeneratorTests.cs
  - ConnectAsync_ConcurrentCalls_SynchronizesWithoutThrowingOrLeaking in RevitPipeClientAdversarialTests.cs (248 lines)
- [x] Step 7: Build & test verification:
  - dotnet build HPBim.slnx -c Release /warnaserror: 0 Warnings, 0 Errors
  - dotnet test HPBim.slnx -c Release: 216/216 passed (100% green)
  - All files in HPBim.Client <= 200 lines (strictly <= 220 limit)
- [ ] Step 8: Write handoff.md and send completion message to parent
