Lightingsang/AddinRebar/.agents/teamwork/worker_m3_remediation/changes.md

# Milestone M3 Remediation Changes Report

**Agent**: `worker_m3_remediation`  
**Parent Agent**: `a7a2dbbb-6b7d-4279-98cd-1216d8280d80`  
**Milestone**: M3 (Phase 4: Foundation, Slab, Stair & Lintel Detailing) — Iteration 2  
**Date**: 2026-10-17T11:27:00Z  

---

## 1. Executive Summary

This remediation resolves the two Rule M3 method length violations identified by `reviewer_m3_1` in `review.md`:
1. `HPKata.Core/Foundations/Calculators/PileCoordinateGenerator.cs`: `GenerateLayout` (previously 83 physical lines) refactored into private helper methods (`GenerateSmallGroupPiles`, `GenerateMediumGroupPiles`, `GenerateArbitraryGridPiles`, `AddGridPiles`), bringing `GenerateLayout` to 26 physical lines and all helper methods to $\le 32$ physical lines (file total: 137 lines).
2. `HPKata.Core.Tests/Stairs/StairRebarCalculatorTests.cs`: `CalculateStairRebar_StandardFlight_GeneratesExpectedItems` (previously 53 physical lines) refactored by extracting standard flight model instantiation into `CreateStandardFlight()`, bringing the test method to 34 physical lines and the helper to 22 physical lines (file total: 113 lines).

Full solution build compiles with **0 warnings, 0 errors**, and all **743/743 tests** across all 5 test projects pass 100% green.

---

## 2. Detailed File Modifications

### File 1: `HPKata/HPKata.Core/Foundations/Calculators/PileCoordinateGenerator.cs`
- **Location**: `HPKata/HPKata.Core/Foundations/Calculators/PileCoordinateGenerator.cs`
- **Problem**: `GenerateLayout` was 83 physical lines (lines 13–95), violating Rule M3 ($\le 50$ physical lines per method).
- **Remediation**:
  - Extracted `GenerateSmallGroupPiles` (32 lines, lines 40–71) for pile counts 1..5.
  - Extracted `GenerateMediumGroupPiles` (29 lines, lines 73–101) for pile counts 6..9.
  - Extracted `GenerateArbitraryGridPiles` (21 lines, lines 103–123) for arbitrary pile grids (pile counts $\ge 10$).
  - Extracted `AddGridPiles` (10 lines, lines 125–134) for symmetrical 2D pile arrays.
  - `GenerateLayout` (26 lines, lines 13–38) now performs parameter validation, spacing/edge distance initialization, and cleanly delegates to the appropriate helper method.
- **Physical Line Counts**:
  - `GenerateLayout`: 26 lines ($\le 50$, PASS)
  - `GenerateSmallGroupPiles`: 32 lines ($\le 50$, PASS)
  - `GenerateMediumGroupPiles`: 29 lines ($\le 50$, PASS)
  - `GenerateArbitraryGridPiles`: 21 lines ($\le 50$, PASS)
  - `AddGridPiles`: 10 lines ($\le 50$, PASS)
  - Entire file: 137 physical lines ($\le 300$, Rule C2 PASS)
- **Behavioral & Mathematical Invariance**:
  - Exact coordinates, recommended dimensions ($L, B$), and centroid at $(0, 0)$ are preserved byte-for-byte.
  - Zero dead code, zero TODOs/placeholders, zero unannotated catch blocks.

### File 2: `HPKata/HPKata.Core.Tests/Stairs/StairRebarCalculatorTests.cs`
- **Location**: `HPKata/HPKata.Core.Tests/Stairs/StairRebarCalculatorTests.cs`
- **Problem**: `CalculateStairRebar_StandardFlight_GeneratesExpectedItems` was 53 physical lines (lines 12–64), violating Rule M3 ($\le 50$ physical lines per method).
- **Remediation**:
  - Extracted model creation into private helper `CreateStandardFlight()` (22 lines, lines 47–68).
  - Reduced `CalculateStairRebar_StandardFlight_GeneratesExpectedItems` (34 lines, lines 12–45) to calling `CreateStandardFlight()` and asserting rebar cut lengths, marks, diameters, and counts.
- **Physical Line Counts**:
  - `CalculateStairRebar_StandardFlight_GeneratesExpectedItems`: 34 lines ($\le 50$, PASS)
  - `CreateStandardFlight`: 22 lines ($\le 50$, PASS)
  - Entire file: 113 physical lines ($\le 300$, Rule C2 PASS)
- **Behavioral & Mathematical Invariance**:
  - All test inputs, parameters, and assertions are identical.
  - Zero dead code, zero TODOs/placeholders.

---

## 3. Build & Test Verification

### 3.1 Solution Build
```powershell
dotnet build HPKata/HPKata.slnx --disable-build-servers -m:1
```
- **Result**: `Build succeeded. 0 Warning(s), 0 Error(s). Time Elapsed: 00:00:14.69`

### 3.2 Full Test Suite Execution
```powershell
dotnet test HPKata/HPKata.slnx --disable-build-servers -m:1 --results-directory "$env:TEMP\mtp-$([guid]::NewGuid())"
```
- **Results across all 5 test projects**:
  - `HPKata.AutoCad.Tests`: 58 passed, 0 failed, 0 skipped
  - `HPKata.Core.Tests`: 394 passed, 0 failed, 0 skipped
  - `HPKata.E2E.Tests`: 155 passed, 0 failed, 0 skipped
  - `HPKata.Revit.Tests`: 83 passed, 0 failed, 0 skipped
  - `HPKata.UI.Tests`: 53 passed, 0 failed, 0 skipped
- **Total**: **743 passed, 0 failed, 0 skipped (100% green)**.

---

## 4. Clean Code Governance Compliance Matrix

| Rule | Requirement | Result | Evidence |
|---|---|---|---|
| **Rule C2** | File length $\le 300$ physical lines | **PASS** | `PileCoordinateGenerator.cs` = 137 lines; `StairRebarCalculatorTests.cs` = 113 lines |
| **Rule M3** | Method length $\le 50$ physical lines | **PASS** | Max method in `PileCoordinateGenerator.cs` is 32 lines; max in `StairRebarCalculatorTests.cs` is 34 lines |
| **Rule Q-B1** | 0 dead code, 0 commented-out code, 0 TODOs | **PASS** | Ripgrep search for `TODO`, `FIXME`, `HACK` returns 0 results |
| **Rule Q-B2** | 0 unannotated empty catch blocks | **PASS** | Zero unannotated catch blocks |
| **Rule R5** | `304.8` constant strictly in `RevitUnitConverter.cs` | **PASS** | Ripgrep confirms `304.8` strictly in `RevitUnitConverter.cs` (lines 8, 12) |
| **Host Neutrality** | Zero Autodesk references in `HPKata.Core` | **PASS** | `HPKata.Core` has zero references to Autodesk.AutoCAD.* or Autodesk.Revit.* |
| **Concurrency Guard** | Never weaken MTP isolation | **PASS** | `--disable-build-servers -m:1` and unique `--results-directory` strictly used |
