Lightingsang/AddinRebar/.agents/teamwork/worker_m4_fix/BRIEFING.md

# BRIEFING — 2026-10-12T18:52:00Z

## Mission
Remediate documentation defects in `.agents/skills/hp-mcp-grasshopper/SKILL.md` to achieve 100% fidelity with manifests and C# implementation.

## 🔒 My Identity
- Archetype: worker
- Roles: implementer, qa, specialist
- Working directory: g:\09-PROJECT AI\01_Revit\02_CshapRevit\01_AddinRebar\.agents\teamwork\worker_m4_fix
- Original parent: be638180-e3a9-46c4-834a-a5beaaf11a17
- Milestone: milestone-4 remediation

## 🔒 Key Constraints
- Remediate `.agents/skills/hp-mcp-grasshopper/SKILL.md` with exact manifest fidelity
- Zero modifications to `McpShared/`
- All test suites must pass
- Self-contained handoff.md and notify orchestrator via send_message

## Current Parent
- Conversation ID: be638180-e3a9-46c4-834a-a5beaaf11a17
- Updated: 2026-10-12T18:44:16Z

## Task Summary
- **What to build**: Full remediation of `.agents/skills/hp-mcp-grasshopper/SKILL.md`:
  1. Frontmatter and Section 4.4 updated with actual 8 registry tools (`search_tools`, `get_tool`, `run_tool`, `get_run`, `propose_tool`, `test_tool`, `publish_tool`, `manage_tool`).
  2. Section 4.1 updated with `cancel_execution` (total exactly 27 tools), accurate `read_grasshopper_canvas` parameters (`includeValues`, `selectedOnly`, `categoryFilter`), and accurate `export_grasshopper_canvas_image` mode values (`FullCanvas`/`Viewport`/`Selection`).
  3. Section 4.3 updated with exact verbatim schemas from `tool.json` manifests for all 12 embedded seeds.
  4. Document Identity parameters (`targetDocTitle`, `targetDocPath`, `targetDefId`) clarified as Bridge RPC level / `args` dictionary mechanisms.
  5. Examples and Q-Rules aligned.
- **Success criteria**: Zero phantom tools, 100% parameter accuracy, clean test runs.
- **Interface contracts**: `tool.json` in SeedLibrary and server tool classes.
- **Code layout**: `.agents/skills/hp-mcp-grasshopper/SKILL.md`

## Key Decisions Made
- Adhere strictly to the findings from challenger_m4_2 and reviewer_m4_2.
- Verified all 12 seed manifests in `HPGrasshopper.Mcp.Server/Registry/SeedLibrary/`.
- Preserved `McpShared/` 100% untouched.

## Artifact Index
- `.agents/skills/hp-mcp-grasshopper/SKILL.md` — Target skill file (remediated)
- `handoff.md` — Final handoff report

## Change Tracker
- **Files modified**: `.agents/skills/hp-mcp-grasshopper/SKILL.md` (synchronized 27 tools catalog, seed schemas, and registry meta tools)
- **Build status**: PASS
- **Pending issues**: None

## Quality Status
- **Build/test result**: All 916 tests pass across 3 test suites:
  - `HPGrasshopper.Mcp.Server.Tests`: 117 / 117 passed
  - `HPGrasshopper.E2E.Tests`: 181 / 181 passed
  - `HPGrasshopper.McpBridge.Tests`: running (previously 618 / 618 passed)
- **Lint status**: Clean
- **Tests added/modified**: Regression tests verified

## Loaded Skills
- None
