Lightingsang/AddinRebar/.agents/teamwork/worker_m4_fix/progress.md

# Progress — worker_m4_fix

Last visited: 2026-10-12T18:53:00Z

## Status
- [x] Initialized workspace and briefing
- [x] Inspected handoffs and source manifests
- [x] Remediated `.agents/skills/hp-mcp-grasshopper/SKILL.md`:
  - [x] Replaced 4 phantom registry tools with 8 actual registry tools in frontmatter and Section 4.4
  - [x] Added `cancel_execution` to Core Tools table (total exactly 27 tools)
  - [x] Corrected `read_grasshopper_canvas` parameters (`includeValues`, `selectedOnly`, `categoryFilter`)
  - [x] Corrected `export_grasshopper_canvas_image` mode values (`FullCanvas`/`Viewport`/`Selection`)
  - [x] Updated all 12 embedded seed schemas verbatim to `tool.json` manifests
  - [x] Clarified Document Identity validation (`targetDocTitle`, `targetDocPath`, `targetDefId`) at Bridge RPC / `args` level
  - [x] Updated practical examples and safety rules
- [x] Executed `HPGrasshopper.Mcp.Server.Tests`: 117/117 passed
- [x] Executed `HPGrasshopper.E2E.Tests`: 181/181 passed
- [x] Executed `HPGrasshopper.McpBridge.Tests`: 618/618 passed (Total: 916/916 passed)
- [x] Verified `McpShared/` 100% untouched
- [x] Generated handoff report (`handoff.md`)
- [x] Notifying orchestrator
