Lightingsang/AddinRebar/.agents/teamwork/worker_m4_fix2/BRIEFING.md

# BRIEFING — 2026-10-12T19:15:30Z

## Mission
Remediate the Critical Finding in PublicRouteRegressionTests.cs and implement genuine verification for PlayerRunner.CollectRuntimeMessages when GH_SolutionPhase.Failed.

## 🔒 My Identity
- Archetype: worker
- Roles: implementer, qa, specialist
- Working directory: g:\09-PROJECT AI\01_Revit\02_CshapRevit\01_AddinRebar\.agents\teamwork\worker_m4_fix2\
- Original parent: be638180-e3a9-46c4-834a-a5beaaf11a17
- Milestone: Milestone M4

## 🔒 Key Constraints
- Remediate Critical Finding in PublicRouteRegressionTests.cs (remove lines 130–135 dead facade setup, rename Test 5, clarify Test 8).
- Implement genuine verification for PlayerRunner.CollectRuntimeMessages when GH_SolutionPhase.Failed without mocks.
- Expose `internal static List<string> CollectRuntimeMessages(IEnumerable<IGH_DocumentObject> objects)` in PlayerRunner.cs.
- Keep file lengths <= 300 lines (Rule C2), method lengths <= 50 lines (Rule M3).
- 0 dead code (Rule Q-B1), 0 unannotated catch (Rule Q-B2).
- Zero edits to McpShared/ (strict invariance).
- Integrity Mandate: genuine logic only, no dummy facade implementations, no hardcoded test shortcuts.

## Current Parent
- Conversation ID: be638180-e3a9-46c4-834a-a5beaaf11a17
- Updated: 2026-10-12T19:15:30Z

## Task Summary
- **What to build**: Fix facade test in `PublicRouteRegressionTests.cs`, expose and genuinely test `PlayerRunner.CollectRuntimeMessages(IEnumerable<IGH_DocumentObject> objects)`.
- **Success criteria**: All tests pass across `HPGrasshopper.McpBridge.Tests`, `HPGrasshopper.Mcp.Server.Tests`, `HPGrasshopper.E2E.Tests`; Clean Code rules satisfied; McpShared untouched.
- **Interface contracts**: `PlayerRunner.cs`, `PublicRouteRegressionTests.cs`, `PlayerIntegrationTests.cs`.
- **Code layout**: `HPGrasshopper/`

## Key Decisions Made
- Exposing `internal static List<string> CollectRuntimeMessages(IEnumerable<IGH_DocumentObject> objects)` delegating to `CollectRuntimeDiagnostics(objects).errors`.
- Removing dead facade setup variables from `PublicRouteRegressionTests.cs` and renaming Test 5 to `SolveError_DispatcherPropagatesErrorPayload` to truthfully describe what it verifies.
- Adding comprehensive, non-mocked tests in new file `PlayerIntegrationTests.cs` (92 lines) to verify component solver error capturing directly.

## Artifact Index
- `.agents/teamwork/worker_m4_fix2/DISPATCH.md` — assignment
- `.agents/teamwork/worker_m4_fix2/BRIEFING.md` — memory index
- `.agents/teamwork/worker_m4_fix2/progress.md` — progress tracking
- `.agents/teamwork/worker_m4_fix2/handoff.md` — final handoff report

## Change Tracker
- **Files modified**:
  - `HPGrasshopper/HPGrasshopper.McpBridge/Tools/PlayerRunner.cs` — exposed `CollectRuntimeDiagnostics` & `CollectRuntimeMessages` overload accepting `IEnumerable<IGH_DocumentObject>`.
  - `HPGrasshopper/HPGrasshopper.McpBridge.Tests/Host/PublicRouteRegressionTests.cs` — removed dead facade lines, renamed Test 5, clarified Test 8.
  - `HPGrasshopper/HPGrasshopper.McpBridge.Tests/tools/PlayerIntegrationTests.cs` — new test suite with genuine non-mocked verification for `CollectRuntimeMessages` and diagnostics.
- **Build status**: All test suites passing 100% (624 + 117 + 181 = 922 passed).
- **Pending issues**: None

## Quality Status
- **Build/test result**: PASS (HPGrasshopper: 922 tests passed; McpShared: 1047 tests passed)
- **Lint status**: 0 violations (C2: all <= 300 lines; M3: all <= 50 lines; Q-B1: 0 dead code; Q-B2: 0 unannotated catch)
- **Tests added/modified**: 6 new tests in `PlayerIntegrationTests.cs`
