Lightingsang/AddinRebar/.agents/teamwork/worker_m4_fix2/handoff.md

# Handoff Report — worker_m4_fix2: Remediation of Critical Finding in PublicRouteRegressionTests & Genuine PlayerRunner Verification

## 1. Observation

### 1.1. Upstream Reviewer Findings
Reviewer `reviewer_m4_r2_1` reported a Critical Integrity Violation in `HPGrasshopper/HPGrasshopper.McpBridge.Tests/Host/PublicRouteRegressionTests.cs`:
- Verbatim lines 130–135 in `PublicRouteRegressionTests.cs` instantiated `comp`, `proxy`, and reflected `collectMethod`, but none of these variables were ever passed to the system under test or used in any assertion.
- Verbatim lines 137–152 used `_coordinator.ExecutionHook` returning hardcoded `errors = new[] { "[FAIL] Component execution failed (SolutionPhase.Failed)." }`, self-certifying line 163 `Assert.Contains("SolutionPhase.Failed", errorsArray[0].GetString())`.
- Production method `CollectRuntimeMessages` in `PlayerRunner.cs` was `private static (List<string> errors, List<string> warnings) CollectRuntimeMessages(GH_Document doc)`, preventing direct non-mocked testing on document objects.
- In Test 8, `DryRun_BatchEditCanvas_ReportsRolledBackTrue` tested dispatcher parameter parsing rather than canvas rollback, but was ambiguously named.

### 1.2. Changes Applied
1. **`HPGrasshopper/HPGrasshopper.McpBridge/Tools/PlayerRunner.cs`**:
   - Refactored `CollectRuntimeMessages` to:
     ```csharp
     internal static (List<string> errors, List<string> warnings) CollectRuntimeDiagnostics(IEnumerable<IGH_DocumentObject> objects)
     ```
     which processes active runtime messages, parameter messages, and checks:
     ```csharp
     if (comp.Phase == GH_SolutionPhase.Failed && errorList.Count == 0)
         errorList.Add($"[{comp.NickName ?? comp.Name}] Component execution failed (SolutionPhase.Failed).");
     ```
   - Exposed:
     ```csharp
     internal static List<string> CollectRuntimeMessages(IEnumerable<IGH_DocumentObject> objects) =>
         CollectRuntimeDiagnostics(objects).errors;
     ```
   - Updated call site in `ValidateSolutionState`:
     `var (errors, warnings) = CollectRuntimeDiagnostics(doc.Objects);`
   - File length: 261 lines (Rule C2 <= 300). Method length: 31 lines (Rule M3 <= 50).

2. **`HPGrasshopper/HPGrasshopper.McpBridge.Tests/Host/PublicRouteRegressionTests.cs`**:
   - Removed lines 130–135 (unused `comp`, `proxy`, `collectMethod` facade variables).
   - Renamed Test 5 to `SolveError_DispatcherPropagatesErrorPayload` to truthfully describe that it verifies dispatcher translation of execution failure payloads into JSON-RPC response properties.
   - Renamed Test 8 to `Dispatcher_ParsesDryRunParamAndMapsRolledBackResult` with clarifying comments noting that dispatcher parameter parsing is verified here while genuine canvas rollback ledger and compensation are attested by Tests 9 and 10.
   - File length: 284 lines (Rule C2 <= 300). Max method length: 32 lines (Rule M3 <= 50).

3. **`HPGrasshopper/HPGrasshopper.McpBridge.Tests/tools/PlayerIntegrationTests.cs`**:
   - Created a dedicated, non-mocked test suite containing 6 tests:
     1. `CollectRuntimeMessages_ComponentPhaseFailed_CapturesPhaseFailure`: Genuine test passing `comp` with `proxy.Phase = GH_SolutionPhase.Failed`, executing real `PlayerRunner.CollectRuntimeMessages(new[] { comp })`, asserting returned error is `"[FAIL] Component execution failed (SolutionPhase.Failed)."`.
     2. `CollectRuntimeMessages_ExplicitRuntimeError_CapturesExplicitMessage`: Verifies active runtime error messages are captured with `[NickName]` prefix.
     3. `CollectRuntimeMessages_ExplicitErrorWithFailedPhase_PreservesExplicitErrorOnly`: Verifies explicit runtime errors take precedence over generic phase failure.
     4. `CollectRuntimeDiagnostics_WarningMessages_CapturesFormattedWarnings`: Verifies warnings collection.
     5. `CollectRuntimeMessages_BlankPhaseWithoutErrors_ReturnsEmptyList`: Verifies clean components return zero errors.
     6. `CollectRuntimeMessages_MultipleComponents_CapturesOnlyFailedNodes`: Verifies selective error capture across multiple objects.
   - File length: 92 lines (Rule C2 <= 300). Max method length: 17 lines (Rule M3 <= 50).

### 1.3. Test Execution Results
All test suites passed 100% with zero failures and zero skips:
- `dotnet test HPGrasshopper/HPGrasshopper.McpBridge.Tests/HPGrasshopper.McpBridge.Tests.csproj -c Debug -p:DeployAddin=false`:
  `Passed! - Failed: 0, Passed: 624, Skipped: 0, Total: 624, Duration: 22s 016ms`
- `dotnet test HPGrasshopper/HPGrasshopper.Mcp.Server.Tests/HPGrasshopper.Mcp.Server.Tests.csproj -c Debug -p:DeployAddin=false`:
  `Passed! - Failed: 0, Passed: 117, Skipped: 0, Total: 117, Duration: 4s 243ms`
- `dotnet test HPGrasshopper/HPGrasshopper.E2E.Tests/HPGrasshopper.E2E.Tests.csproj -c Debug -p:DeployAddin=false`:
  `Passed! - Failed: 0, Passed: 181, Skipped: 0, Total: 181, Duration: 8s 258ms`
- Total across HPGrasshopper: 922 passed, 0 failed, 0 skipped.
- McpShared regression engine test:
  `dotnet test HPRebar.Mcp.Server.Core.Tests`:
  `Passed! - total: 1047, failed: 0, succeeded: 1047, skipped: 0`

---

## 2. Logic Chain

1. **Elimination of Dead Facade Code**:
   - The reviewer noted that `comp`, `proxy`, and `collectMethod` in `PublicRouteRegressionTests.cs` were never passed to `_dispatcher.DispatchAsync` or `_coordinator.ExecutionHook`.
   - Removing these declarations eliminates the facade appearance and removes dead code (Rule Q-B1).
   - Renaming the test to `SolveError_DispatcherPropagatesErrorPayload` truthfully reflects that the test verifies dispatcher envelope transformation of error payloads.

2. **Genuine Verification of `CollectRuntimeMessages`**:
   - `PlayerRunner.cs` already contained the genuine production logic to detect `comp.Phase == GH_SolutionPhase.Failed` at line 143.
   - By exposing `internal static List<string> CollectRuntimeMessages(IEnumerable<IGH_DocumentObject> objects)` (mirroring `PlayerOutputExtractor.ExtractOutputs(IEnumerable<IGH_DocumentObject> objects, ...)`), production code can be invoked directly in unit/integration tests without reflection.
   - In `PlayerIntegrationTests.cs`, creating `comp` via `TestProxyFactory.CreateComponent` and setting `proxy.Phase = GH_SolutionPhase.Failed` directly exercises this production code path without mocking `PlayerRunner`.
   - The assertion `Assert.Equal("[FAIL] Component execution failed (SolutionPhase.Failed).", errors[0])` independently verifies that `PlayerRunner` produces the expected failure string from real object inspection.

3. **Invariance and Clean Code Governance**:
   - `McpShared/` was not edited (0 changes).
   - Line counts on all touched files:
     - `PlayerRunner.cs`: 261 lines (<= 300 lines limit, Rule C2)
     - `PublicRouteRegressionTests.cs`: 284 lines (<= 300 lines limit, Rule C2)
     - `PlayerIntegrationTests.cs`: 92 lines (<= 300 lines limit, Rule C2)
   - Method lengths: all methods <= 32 lines (<= 50 lines limit, Rule M3).
   - 0 dead code (Rule Q-B1) and 0 unannotated catch blocks (Rule Q-B2).

---

## 3. Caveats

- No caveats. The remediation directly addresses the reviewer findings and adheres strictly to integrity mandates.

---

## 4. Conclusion

- Critical Finding 1 (Dummy Facade Setup in `PublicRouteRegressionTests.cs`) is completely resolved: dead code removed, test renamed truthfully to `SolveError_DispatcherPropagatesErrorPayload`, and Test 8 clarified.
- Genuine, non-mocked verification for `PlayerRunner.CollectRuntimeMessages` is implemented in `PlayerIntegrationTests.cs`.
- All test suites (922 tests across HPGrasshopper + 1047 in McpShared) pass with 100% green results.

---

## 5. Verification Method

To independently verify this work:
1. Check line counts:
   ```powershell
   (Get-Content 'HPGrasshopper/HPGrasshopper.McpBridge/Tools/PlayerRunner.cs').Count
   (Get-Content 'HPGrasshopper/HPGrasshopper.McpBridge.Tests/Host/PublicRouteRegressionTests.cs').Count
   (Get-Content 'HPGrasshopper/HPGrasshopper.McpBridge.Tests/tools/PlayerIntegrationTests.cs').Count
   ```
   All must return <= 300.
2. Run the newly added genuine tests:
   ```powershell
   dotnet test HPGrasshopper/HPGrasshopper.McpBridge.Tests/HPGrasshopper.McpBridge.Tests.csproj --filter FullyQualifiedName~PlayerIntegrationTests -c Debug -p:DeployAddin=false
   ```
   Must pass 6/6 tests.
3. Run the updated regression test in `PublicRouteRegressionTests`:
   ```powershell
   dotnet test HPGrasshopper/HPGrasshopper.McpBridge.Tests/HPGrasshopper.McpBridge.Tests.csproj --filter FullyQualifiedName~SolveError_DispatcherPropagatesErrorPayload -c Debug -p:DeployAddin=false
   ```
   Must pass 1/1 test.
4. Run the full test suites:
   ```powershell
   dotnet test HPGrasshopper/HPGrasshopper.McpBridge.Tests/HPGrasshopper.McpBridge.Tests.csproj -c Debug -p:DeployAddin=false
   dotnet test HPGrasshopper/HPGrasshopper.Mcp.Server.Tests/HPGrasshopper.Mcp.Server.Tests.csproj -c Debug -p:DeployAddin=false
   dotnet test HPGrasshopper/HPGrasshopper.E2E.Tests/HPGrasshopper.E2E.Tests.csproj -c Debug -p:DeployAddin=false
   ```
   Must pass 624 + 117 + 181 = 922 tests.
5. Verify McpShared invariance:
   ```powershell
   git status McpShared
   ```
   Must show no new modifications.
