Lightingsang/AddinRebar/.agents/teamwork/worker_m4_fix2/progress.md

# Progress — worker_m4_fix2

Last visited: 2026-10-12T19:15:00Z

## Current Status
- Remediated Critical Finding (Integrity Violation) in `PublicRouteRegressionTests.cs`:
  - Removed lines 130–135 (unused comp/proxy/collectMethod facade variables).
  - Renamed Test 5 to `SolveError_DispatcherPropagatesErrorPayload`.
  - Renamed Test 8 to `Dispatcher_ParsesDryRunParamAndMapsRolledBackResult` with clarifying comments on dispatcher envelope parsing vs genuine rollback verified by Tests 9 & 10.
  - Line count verified: 284 lines (<= 300 lines, Rule C2).
- Implemented Genuine Component Solver Error Verification in `PlayerRunner.cs`:
  - Exposed `internal static List<string> CollectRuntimeMessages(IEnumerable<IGH_DocumentObject> objects)` delegating to `CollectRuntimeDiagnostics(objects).errors`.
  - Updated `ValidateSolutionState` to invoke `CollectRuntimeDiagnostics(doc.Objects)`.
  - Line count verified: 261 lines (<= 300 lines, Rule C2).
- Created `PlayerIntegrationTests.cs`:
  - Implemented genuine non-mocked test `CollectRuntimeMessages_ComponentPhaseFailed_CapturesPhaseFailure` directly exercising `proxy.Phase = GH_SolutionPhase.Failed` through `PlayerRunner.CollectRuntimeMessages(new[] { comp })`.
  - Added 5 additional tests covering explicit runtime error messages, error prioritization over failed phase, warning diagnostics, blank phase, and multi-component error filtering.
  - Line count verified: 92 lines (<= 300 lines, Rule C2).
- Test Execution Results:
  - `HPGrasshopper.McpBridge.Tests`: 624 passed, 0 failed, 0 skipped.
  - `HPGrasshopper.Mcp.Server.Tests`: 117 passed, 0 failed, 0 skipped.
  - `HPGrasshopper.E2E.Tests`: 181 passed, 0 failed, 0 skipped.
  - Total across HPGrasshopper: 922 passed.
  - Shared Engine `HPRebar.Mcp.Server.Core.Tests`: 1047 passed.
- Governance:
  - Clean Code: C2 <= 300 lines, M3 <= 50 lines, Q-B1 0 dead code, Q-B2 0 unannotated catch.
  - ZERO edits to `McpShared/`.
