Lightingsang/AddinRebar/.agents/teamwork/worker_m4_fix3/BRIEFING.md

# BRIEFING — 2026-10-12T19:42:00Z

## Mission
Remediate PlayerRunner multi-component error collection defect, fix Rule M3 in PlayerRunner.Run, refresh grasshopper_tools_list.json snapshot, and achieve 100% test pass.

## 🔒 My Identity
- Archetype: worker
- Roles: implementer, qa
- Working directory: g:\09-PROJECT AI\01_Revit\02_CshapRevit\01_AddinRebar\.agents\teamwork\worker_m4_fix3
- Original parent: be638180-e3a9-46c4-834a-a5beaaf11a17
- Milestone: M4

## 🔒 Key Constraints
- Remediate PlayerRunner error collection defect (evaluate per-component error count so subsequent failed components or components after explicit errors are not suppressed)
- Refactor PlayerRunner.Run to <= 50 lines (Rule M3) while keeping PlayerRunner.cs <= 300 lines (Rule C2)
- Refresh tests/grasshopper_tools_list.json with live tool reflection (including diameterToleranceMm)
- 100% test pass across HPGrasshopper.McpBridge.Tests, HPGrasshopper.Mcp.Server.Tests, HPGrasshopper.E2E.Tests
- McpShared/ strictly untouched (0 changes)
- Rule Q-B1 (0 commented out code), Rule Q-B2 (0 unannotated empty catch)
- No cheating, no facade implementations, genuine logic only

## Current Parent
- Conversation ID: be638180-e3a9-46c4-834a-a5beaaf11a17
- Updated: 2026-10-12T19:42:00Z

## Task Summary
- **What to build**: Fix error collection in PlayerRunner.cs, refactor PlayerRunner.Run to adhere to Rule M3, refresh grasshopper_tools_list.json, verify all test suites
- **Success criteria**: All tests pass (0 fail, 0 skip), Clean code rules C2 and M3 satisfied, McpShared untouched
- **Interface contracts**: .agents/teamwork/orchestrator_14/plan.md
- **Code layout**: HPGrasshopper/

## Key Decisions Made
- `PlayerRunner.CollectRuntimeDiagnostics`: snapshot `var errorsBefore = errorList.Count;` at start of loop per object. Check `comp.Phase == GH_SolutionPhase.Failed && errorList.Count == errorsBefore`. Isolates each component so multiple failures and explicit errors do not suppress subsequent failed phases.
- `PlayerRunner.Run`: decomposed into `BuildRejectedInputsResult` (16 lines) and `BuildSuccessResult` (15 lines), bringing `Run` down to 42 lines total (39 lines body), fully satisfying Rule M3 (<= 50 lines). File length is 276 lines (Rule C2 <= 300).
- `tests/grasshopper_tools_list.json`: regenerated via live server reflection using `mcp-call.py` with rebuilt `HPGrasshopper.Mcp.Server.exe`, properly capturing `diameterToleranceMm` in `generate_rebar_curves` and all 27 tools.

## Artifact Index
- DISPATCH.md — assignment instructions
- BRIEFING.md — working memory
- progress.md — liveness heartbeat
- handoff.md — final handoff report

## Change Tracker
- **Files modified**:
  - `HPGrasshopper/HPGrasshopper.McpBridge/Tools/PlayerRunner.cs` — per-component error isolation and Rule M3 decomposition
  - `tests/grasshopper_tools_list.json` — refreshed live tool reflection snapshot
- **Build status**: PASS (0 errors, 0 warnings)
- **Pending issues**: None

## Quality Status
- **Build/test result**: PASS (HPGrasshopper.McpBridge.Tests: 630/630, HPGrasshopper.Mcp.Server.Tests: 117/117, HPGrasshopper.E2E.Tests: 181/181, HPRebar.Mcp.Server.Core.Tests: 1047/1047)
- **Lint status**: PASS (Rule C2: 276 <= 300 lines; Rule M3: 0 violations; Rule Q-B1: 0 dead code; Rule Q-B2: 0 unannotated catch)
- **Tests added/modified**: Verified PlayerRunnerAdversarialTests (6/6 passing including both previously failing tests)

## Loaded Skills
- None
