Lightingsang/AddinRebar/.agents/teamwork/worker_m4_fix3/DISPATCH.md

# DISPATCH — worker_m4_fix3

## Task Objective
Remediate the Critical finding in `PlayerRunner.cs` (multi-component error suppression), fix Rule M3 method length in `PlayerRunner.Run`, update `tests/grasshopper_tools_list.json`, and ensure 100% test pass across all suites.

## Context & Inputs
- Original Request: `g:\09-PROJECT AI\01_Revit\02_CshapRevit\01_AddinRebar\.agents\teamwork\ORIGINAL_REQUEST.md`
- Scope Document: `g:\09-PROJECT AI\01_Revit\02_CshapRevit\01_AddinRebar\.agents\teamwork\orchestrator_14\plan.md`
- Auditor Handoff: `g:\09-PROJECT AI\01_Revit\02_CshapRevit\01_AddinRebar\.agents\teamwork\auditor_m4_r3\handoff.md`
- Reviewer Handoffs:
  - `g:\09-PROJECT AI\01_Revit\02_CshapRevit\01_AddinRebar\.agents\teamwork\reviewer_m4_r3_1\handoff.md`
  - `g:\09-PROJECT AI\01_Revit\02_CshapRevit\01_AddinRebar\.agents\teamwork\reviewer_m4_r3_2\handoff.md`
- Failing Tests: `HPGrasshopper/HPGrasshopper.McpBridge.Tests/tools/PlayerRunnerAdversarialTests.cs`

## Specific Remediation Instructions
1. `PlayerRunner.cs` Error Collection Fix:
   - In `CollectRuntimeDiagnostics(IEnumerable<IGH_DocumentObject> objects)` (around line 143):
     Replace global check `errorList.Count == 0` with local component check (e.g. `var errorsBefore = errorList.Count; ... if (comp.Phase == GH_SolutionPhase.Failed && errorList.Count == errorsBefore)` or `var componentHasExplicitErrors = false; ... if (comp.Phase == GH_SolutionPhase.Failed && !componentHasExplicitErrors)`).
   - This ensures that:
     (a) Every component that fails with `GH_SolutionPhase.Failed` is recorded if it has no explicit runtime errors of its own.
     (b) Explicit errors on earlier components do not suppress failed phases on subsequent components.
2. Rule M3 Fix in `PlayerRunner.Run`:
   - `PlayerRunner.Run` is currently 60 lines (> 50 lines limit, Rule M3).
   - Decompose `PlayerRunner.Run` into focused helper methods (e.g., `PrepareDocument`, `ExecuteDocumentSolve`) such that NO method exceeds 50 lines.
   - Ensure `PlayerRunner.cs` total file length remains <= 300 lines (Rule C2).
3. Snapshot Refresh:
   - Refresh `tests/grasshopper_tools_list.json` to ensure `generate_rebar_curves` includes `diameterToleranceMm` matching `tool.json` manifests and live reflection.
4. Test Verification:
   - Run `PlayerRunnerAdversarialTests` to confirm both previously failing tests now pass.
   - Run all test suites: `HPGrasshopper.McpBridge.Tests`, `HPGrasshopper.Mcp.Server.Tests`, `HPGrasshopper.E2E.Tests`.
   - Verify 100% passing tests (0 failures, 0 skips).
   - Ensure `McpShared/` remains strictly untouched.

MANDATORY INTEGRITY WARNING:
DO NOT CHEAT. All implementations must be genuine. DO NOT hardcode test results, create dummy/facade implementations, or circumvent the intended task. A teamwork_preview_auditor will independently verify your work. Integrity violations WILL be detected and your work WILL be rejected.

Write your report to `handoff.md` and notify orchestrator (`be638180-e3a9-46c4-834a-a5beaaf11a17`) via `send_message`.
