Lightingsang/AddinRebar/.agents/teamwork/worker_m4_fix3/handoff.md

# Handoff Report — worker_m4_fix3

## 1. Observation

### 1.1. Upstream Audit & Review Defects
1. **Multi-Component Error Suppression in `PlayerRunner.CollectRuntimeDiagnostics`**:
   - File: `HPGrasshopper/HPGrasshopper.McpBridge/Tools/PlayerRunner.cs` lines 141–145.
   - Line 143 evaluated `if (comp.Phase == GH_SolutionPhase.Failed && errorList.Count == 0)`.
   - Because `errorList` was the global accumulator, whenever component $C_1$ reported an error or failed, `errorList.Count` became $\ge 1$. For any subsequent component $C_2$ with `comp.Phase == GH_SolutionPhase.Failed`, `errorList.Count == 0` evaluated to `false`, silently suppressing $C_2$'s failure.
   - Resulted in 2 failing adversarial unit tests in `HPGrasshopper.McpBridge.Tests/tools/PlayerRunnerAdversarialTests.cs`:
     - `CollectRuntimeMessages_MultipleFailedComponents_CapturesAllFailedComponents` (Expected 2, Actual 1).
     - `CollectRuntimeMessages_ExplicitErrorOnFirstComponent_DoesNotSuppressFailedPhaseOnSecond` (Expected 2, Actual 1).
2. **Rule M3 Violation in `PlayerRunner.Run`**:
   - Method `PlayerRunner.Run` spanned 60 lines total (body 57 lines), violating Clean Code Rule M3 ($\le 50$ lines/method).
3. **Snapshot Staleness in `tests/grasshopper_tools_list.json`**:
   - `generate_rebar_curves` in `tests/grasshopper_tools_list.json` was missing `diameterToleranceMm` parameter, causing `python tests/challenger_m4_r3_crosscheck.py` to fail.

### 1.2. Implemented Code Modifications
1. **`HPGrasshopper/HPGrasshopper.McpBridge/Tools/PlayerRunner.cs`**:
   - In `CollectRuntimeDiagnostics`:
     - Introduced `var errorsBefore = errorList.Count;` at the start of each object iteration.
     - Changed line 143 condition to:
       ```csharp
       if (comp.Phase == GH_SolutionPhase.Failed && errorList.Count == errorsBefore)
           errorList.Add($"[{comp.NickName ?? comp.Name}] Component execution failed (SolutionPhase.Failed).");
       ```
     - Per-component isolation ensures that subsequent failed components and components after explicit errors are accurately recorded.
   - In `PlayerRunner.Run`:
     - Extracted input rejection handling into `BuildRejectedInputsResult(Stopwatch sw, int appliedCount, List<PlayerInputFailure> rejectedInputs)` (16 lines).
     - Extracted success formatting into `BuildSuccessResult(Stopwatch sw, int appliedCount, Dictionary<string, object?> results)` (15 lines).
     - Reduced `PlayerRunner.Run` to 42 lines total (span lines 16–57, body 39 lines), fully compliant with Rule M3 ($\le 50$ lines).
     - Total file length of `PlayerRunner.cs` is 276 lines, fully compliant with Rule C2 ($\le 300$ lines).
2. **`tests/grasshopper_tools_list.json`**:
   - Rebuilt `HPGrasshopper.Mcp.Server` to embed updated seed manifests.
   - Re-generated `tests/grasshopper_tools_list.json` via live server reflection using `python McpShared/tools/mcp-call.py HPGrasshopper/HPGrasshopper.Mcp.Server/bin/Debug/net10.0/HPGrasshopper.Mcp.Server.exe tools/list --out tests/grasshopper_tools_list.json`.
   - `diameterToleranceMm` is now present for `generate_rebar_curves`, matching `tool.json` and `SKILL.md`.

### 1.3. Verification Results
1. **Clean Code AST Verification (`scratch/verify_clean_code_ast.py`)**:
   - `python scratch/verify_clean_code_ast.py "HPGrasshopper/HPGrasshopper.McpBridge/Tools"`:
     - `RULE C2 FILE LENGTH AUDIT (Max <= 300 lines): 0 violations` (PASS)
     - `STRICT RULE M3 VIOLATIONS (> 50 LINES): 0 violations` (PASS: `PlayerRunner.Run` is 42 lines total, body 39 lines)
   - `python scratch/verify_qb_clean_code.py`:
     - `Commented-out code violations: 0` (Rule Q-B1 PASS)
     - `Unannotated empty catch violations: 0` (Rule Q-B2 PASS)
2. **Cross-Check Harness (`tests/challenger_m4_r3_crosscheck.py`)**:
   - `python tests/challenger_m4_r3_crosscheck.py` exited with code 0:
     - `[1] Server reflection tools loaded: 27`
     - `[2] SKILL.md tools parsed: 27`
     - `[3] Phantom Tools & Completeness Cross-Check: ZERO PHANTOM TOOLS (PASS)`
     - `[4] Cross-checking 12 Seed Manifests: ALL EMPIRICAL SCHEMA AND PHANTOM CROSS-CHECKS PASSED 100%!`
3. **Unit & Adversarial Tests (`PlayerRunnerAdversarialTests.cs`)**:
   - `& 'G:\09-PROJECT AI\01_Revit\02_CshapRevit\01_AddinRebar\HPGrasshopper\HPGrasshopper.McpBridge.Tests\bin\Debug\net10.0-windows7.0\HPGrasshopper.McpBridge.Tests.exe' --filter-class "*PlayerRunnerAdversarialTests*"`:
     - `total: 6, failed: 0, succeeded: 6, skipped: 0` (PASS)
4. **Full Test Suites**:
   - `HPGrasshopper.McpBridge.Tests`: **630 passed**, 0 failed, 0 skipped (Duration: 22s 266ms).
   - `HPGrasshopper.Mcp.Server.Tests`: **117 passed**, 0 failed, 0 skipped (Duration: 4s 620ms).
   - `HPGrasshopper.E2E.Tests`: **181 passed**, 0 failed, 0 skipped (Duration: 8s 151ms).
   - `HPRebar.Mcp.Server.Core.Tests`: **1,047 passed**, 0 failed, 0 skipped (Duration: 3s 904ms).
5. **`McpShared/` Invariance**:
   - Zero `.cs` files modified in `McpShared/` during worker session (`Get-ChildItem -Recurse McpShared/ -Filter *.cs | Where-Object { $_.LastWriteTime -gt (Get-Date).AddHours(-2) }` returned 0).

---

## 2. Logic Chain

1. **Error Collection Invariance**:
   - By capturing `var errorsBefore = errorList.Count;` immediately before inspecting each `IGH_DocumentObject`, any error accumulated from prior components or objects is excluded from the current object's evaluation.
   - If `comp.Phase == GH_SolutionPhase.Failed` and `errorList.Count == errorsBefore`, it confirms that the current component did not produce any active runtime error messages, triggering the generic `SolutionPhase.Failed` message.
   - When the next component is evaluated, `errorsBefore` reflects the updated count, preventing earlier components from blocking the capture of subsequent failed components.
   - Direct empirical execution proves both previously failing adversarial tests (`CollectRuntimeMessages_MultipleFailedComponents_CapturesAllFailedComponents` and `CollectRuntimeMessages_ExplicitErrorOnFirstComponent_DoesNotSuppressFailedPhaseOnSecond`) pass 100%.

2. **Clean Code Rule Compliance**:
   - Extracting `BuildRejectedInputsResult` and `BuildSuccessResult` eliminates multi-line anonymous type object initializers from `PlayerRunner.Run`, decreasing method line length from 60 lines to 42 lines (body 39 lines), well below the 50-line limit of Rule M3.
   - The total line count of `PlayerRunner.cs` is 276 lines, below the 300-line ceiling of Rule C2.

3. **Tool Reflection Synchronization**:
   - Rebuilding `HPGrasshopper.Mcp.Server` embedded the updated manifest for `generate_rebar_curves` (which includes `diameterToleranceMm`).
   - Running live reflection via `mcp-call.py` updated `tests/grasshopper_tools_list.json` without manually tampering with schemas.
   - Empirical validation with `tests/challenger_m4_r3_crosscheck.py` confirmed 100% agreement across reflection, seed manifests, and `SKILL.md`.

---

## 3. Caveats

- No caveats. All 3 test suites in `HPGrasshopper` and core engine tests in `McpShared` pass with zero failures and zero skips. All Clean Code requirements (C2, M3, Q-B1, Q-B2) and `McpShared/` invariance are satisfied.

---

## 4. Conclusion

- Critical defect in `PlayerRunner.cs` error collection is **fully resolved**.
- Rule M3 method length violation in `PlayerRunner.Run` is **fully resolved** (42 lines span / 39 lines body).
- Rule C2 file length is maintained at 276 lines ($\le 300$).
- Tool reflection snapshot in `tests/grasshopper_tools_list.json` is **fully updated and verified** via live reflection.
- 100% passing test status achieved:
  - `HPGrasshopper.McpBridge.Tests`: 630 / 630 PASS (0 fail, 0 skip).
  - `HPGrasshopper.Mcp.Server.Tests`: 117 / 117 PASS (0 fail, 0 skip).
  - `HPGrasshopper.E2E.Tests`: 181 / 181 PASS (0 fail, 0 skip).
  - `HPRebar.Mcp.Server.Core.Tests`: 1,047 / 1,047 PASS (0 fail, 0 skip).
- Work product is ready for re-review and final auditor certification.

---

## 5. Verification Method

To independently verify this remediation:
1. Verify Clean Code AST metrics on `PlayerRunner.cs`:
   ```powershell
   python scratch/verify_clean_code_ast.py "HPGrasshopper/HPGrasshopper.McpBridge/Tools"
   (Get-Content HPGrasshopper\HPGrasshopper.McpBridge\Tools\PlayerRunner.cs).Count
   ```
   Expect: 0 Rule M3 violations, 276 total lines ($\le 300$).

2. Verify Reflection Schema & Phantom Tools:
   ```powershell
   python tests/challenger_m4_r3_crosscheck.py
   ```
   Expect: Exit code 0, "ALL EMPIRICAL SCHEMA AND PHANTOM CROSS-CHECKS PASSED 100%!".

3. Verify Adversarial & Full Test Suites:
   ```powershell
   & 'G:\09-PROJECT AI\01_Revit\02_CshapRevit\01_AddinRebar\HPGrasshopper\HPGrasshopper.McpBridge.Tests\bin\Debug\net10.0-windows7.0\HPGrasshopper.McpBridge.Tests.exe' --filter-class "*PlayerRunnerAdversarialTests*"
   dotnet test HPGrasshopper/HPGrasshopper.McpBridge.Tests/HPGrasshopper.McpBridge.Tests.csproj -c Debug -p:DeployAddin=false
   dotnet test HPGrasshopper/HPGrasshopper.Mcp.Server.Tests/HPGrasshopper.Mcp.Server.Tests.csproj -c Debug -p:DeployAddin=false
   dotnet test HPGrasshopper/HPGrasshopper.E2E.Tests/HPGrasshopper.E2E.Tests.csproj -c Debug -p:DeployAddin=false
   ```
   Expect: 100% passing tests (630 + 117 + 181 = 928 passed, 0 failed, 0 skipped).

4. Verify McpShared Invariance:
   ```powershell
   Get-ChildItem -Recurse McpShared/ -Filter *.cs | Where-Object { $_.LastWriteTime -gt (Get-Date).AddHours(-2) }
   ```
   Expect: 0 files.
