Lightingsang/AddinRebar/.agents/teamwork/worker_m4_fix3/progress.md

# Progress — worker_m4_fix3

Last visited: 2026-10-12T19:42:00Z

- [x] Initialized DISPATCH.md and BRIEFING.md
- [x] Inspected PlayerRunner.cs and PlayerRunnerAdversarialTests.cs
- [x] Inspected tests/grasshopper_tools_list.json
- [x] Formulated concrete remediation plan
- [x] Implemented PlayerRunner.cs fixes (error collection + Rule M3 refactor)
- [x] Refreshed tests/grasshopper_tools_list.json with live reflection
- [x] Ran and verified all test suites (Bridge: 630/630, Server: 117/117, E2E: 181/181, Core: 1047/1047)
- [x] Clean Code AST verification passed (Rule C2: 276 <= 300, Rule M3: 0 violations, Q-B1: 0, Q-B2: 0)
- [ ] Produce handoff report and notify orchestrator
