Lightingsang/AddinRebar/.agents/teamwork/worker_m4_qs_layout_utils/changes.md

# Changes Report: Milestone M4 (Phase 5 - Quantity Surveying & Drawing Utilities)

**Agent**: `worker_m4_qs_layout_utils`  
**Date**: 2026-10-17  
**Scope**: Full implementation of Phase 5 (Quantity Surveying, Drawing Layout, Cad Utilities, UI, AutoCAD Controllers & Commands, Revit Services & Commands, and Solution Test Suites).

---

## 1. Summary of Changes

Milestone M4 delivers the clean-room reconstruction of KataPro Phase 5 within the unified solution `HPKata/HPKata.slnx`:
- **HPKata.Core**: Pure domain logic with 0 Autodesk dependencies, handling concrete volume takeoffs, priority intersection deductions, formwork calculations with contact deductions, ClosedXML Excel exports (`Kata_QS`, `Thong_ke_QS`), orthogonal/skewed grid axis generation, 2D shelf-packing drawing sheet layout, drawing sheet index aggregation, and 2D vector CAD utilities (dim witness line trimming, slope annotation, elevation formatting, text alignment).
- **HPKata.UI**: Reactive MVVM ViewModels (`QsTakeoffViewModel`, `DrawingUtilityViewModel`) and MaterialDesign-themed WPF Windows (`QsTakeoffWindow`, `DrawingUtilityWindow`).
- **HPKata.AutoCad**: 9 Controllers and 6 Command sets covering all 27 Phase 5 commands (`QS`, `vg`, `sbv`, `ibv`, `taomv`, `khoav`, `mokhoav`, `danhmuc`, `catdim`, `ngatdim`, `dnoi`, `sl`, `dtext`, `mcat`, `anlayer`, `hienlayer`, `doilayer`, `clean_kata`, etc.) while maintaining `GoiLenh_HPKata.lsp` exact 238-line syntax.
- **HPKata.Revit**: Pure unit conversions in `RevitUnitConverter.cs` (Rule R5), `RevitQsTakeoffService`, `RevitSheetArrangementService`, `RevitQsLayoutRunner`, and Revit external commands (`RevitQsCommands`, `RevitLayoutCommands`).
- **Test Suites**: 5 test projects expanded to **862 tests** (all 100% passing green, 0 failures, 0 skipped, exceeding $\ge 840$ target).

---

## 2. Detailed Breakdown of Implemented Files

### 2.1 `HPKata.Core` (Zero Autodesk Dependencies)
- **`QuantitySurveying/Models/`**:
  - `QsMemberType.cs`: Enum of structural element types (Footing, Column, Wall, Beam, Slab, Stair).
  - `QsDeductionRecord.cs`: Record of overlap deductions (deducted volume, intersecting element, reason).
  - `QsVolumeResult.cs`: Gross volume, deducted volume, and net volume results in $m^3$.
  - `QsFormworkResult.cs`: Gross formwork, deducted formwork, and net contact area in $m^2$.
  - `QsElementModel.cs`: Physical geometric representation of elements (Story, Mark, Dimensions, Coordinates).
  - `QsTakeoffItem.cs`: Per-element takeoff line item including gross/net volume and formwork.
  - `QsTakeoffSummary.cs`: Aggregated totals grouped by member type and story.
- **`QuantitySurveying/Calculators/`**:
  - `QsTakeoffCalculator.cs`: Calculates gross concrete volumes and initial surface formwork areas across all member types.
  - `QsIntersectionDeductionEngine.cs`: Priority deduction matrix: Footing > Column/Wall > Primary Beam > Secondary Beam > Slab. Accurately deducts overlapping volume bounding boxes.
  - `QsFormworkCalculator.cs`: Contact area deductions (beam end deducted from column sides $b \times h$, slab thickness deducted from column and beam perimeters).
- **`QuantitySurveying/Persistence/`**:
  - `QsScheduleAggregator.cs`: Aggregates takeoff items into structured summaries with total volume and formwork.
  - `QsWorkbookGenerator.cs`: Headless ClosedXML generator exporting Excel workbooks matching `Kata_QS` (columns A–J) and summary sheet `Thong_ke_QS`.
- **`DrawingLayout/Models/`**:
  - `GridBubbleOrientation.cs`: Enum for bubble placement (Start, End, Both, None).
  - `GridLineModel.cs`: Start and end points, label, and bubble orientation for single grid lines.
  - `GridSystemModel.cs`: Collection of X and Y grid lines with extents and scale.
  - `SheetSizeDefinition.cs`: Standard ISO sheet sizes A0 through A4 (in mm) with margins and title block dimensions.
  - `TitleBlockModel.cs`: Dimensions and corner placement for sheet title blocks.
  - `DrawingBlockItem.cs`: Bounding box of detail drawings to be packed into sheets.
  - `ArrangedSheetResult.cs`: Sheet pagination holding positioned drawing blocks and remaining area.
  - `DrawingIndexItem.cs`: Drawing number, title, scale, revision, and layout name.
  - `DrawingIndexTableDto.cs`: Formatted data transfer object for drawing registration tables.
- **`DrawingLayout/Calculators/`**:
  - `GridAxisGenerator.cs`: Orthogonal and skewed grid generation, ISO 128 label sequencing (skipping I, O, Q, Z), and continuous dimension strings.
  - `SheetArrangerCalculator.cs`: 2D shelf-packing algorithm with title block collision avoidance in the bottom-right corner and multi-sheet overflow pagination.
  - `DrawingIndexAggregator.cs`: Natural alphanumeric sorting (`KC-01` .. `KC-10`), gap and duplicate detection, and table formatting.
- **`CadUtilities/Models/`**:
  - `Point2D.cs`: Lightweight immutable 2D point struct with distance and addition operators.
  - `Vector2D.cs`: Lightweight 2D vector struct with dot product, cross product, normalization, and angle calculations.
  - `ElevationCalloutModel.cs`: Elevation value, leader coordinate, and formatted text string.
  - `SlopeAnnotationModel.cs`: Slope gradient ($i\%$), angle in degrees, text position, and anti-upside-down readable rotation.
- **`CadUtilities/Calculators/`**:
  - `VectorProjectionHelper.cs`: Witness line trimming projections and normal vector offsets.
  - `SlopeCalculator.cs`: Gradient computation, quadrant normalization (ensuring text reads left-to-right / bottom-to-top), and formatting (`i = 2.0%`).
  - `ElevationFormatter.cs`: TCVN architectural elevation formatting (`+3.600`, `±0.000`, `-1.200`).
  - `TextAlignmentCalculator.cs`: Horizontal and vertical text bounds alignment and equal distribution spacing.

### 2.2 `HPKata.UI`
- **`ViewModels/`**:
  - `QsTakeoffViewModel.cs`: Reactive MVVM ViewModel binding element tables, summary charts, deduction toggles, and Excel export commands.
  - `DrawingUtilityViewModel.cs`: Reactive MVVM ViewModel binding grid generation parameters, sheet size selections, 2D shelf packing, and drawing register tables.
- **`Views/`**:
  - `QsTakeoffWindow.xaml` / `.xaml.cs`: Modal WPF window using MaterialDesign styles and `Theme.xaml` dynamic resources.
  - `DrawingUtilityWindow.xaml` / `.xaml.cs`: Multi-tab WPF window for Grids, Sheet Layouts, and Drawing Indexes.

### 2.3 `HPKata.AutoCad`
- **`Controllers/`**:
  - `QsTakeoffController.cs`: Scans ModelSpace entities, executes takeoff and intersection deductions, inserts AutoCAD tables or triggers ClosedXML export.
  - `GridDrawController.cs`: Creates grid lines, circular bubbles, attribute tags, and dimension chains in AutoCAD ModelSpace.
  - `SheetLayoutController.cs`: Inserts arranged detail blocks inside sheet border polylines with title blocks.
  - `ViewportController.cs`: Creates and scales PaperSpace Viewports (`taomv`), toggles display lock state (`khoav`, `mokhoav`).
  - `DrawingIndexController.cs`: Scans TitleBlock attributes across PaperSpace layouts and builds drawing index table in ModelSpace or PaperSpace.
  - `DimensionUtilityController.cs`: Witness line trimming (`catdim`), dimension splitting (`ngatdim`), continuous dimensioning (`dnoi`), and slope annotation (`sl`).
  - `TextAnnotationController.cs`: Aligns text entities (`dtext`) and places section elevation callouts (`mcat`).
  - `LayerUtilityController.cs`: Layer visibility management (`anlayer`, `hienlayer`, `doilayer`).
  - `KataCleanController.cs`: Purges obsolete XRecords and temporary entities (`clean_kata`, `xoa_xrecord`).
- **`Commands/`**:
  - `QsCommands.cs`: Registered commands `QS`, `QS_mbkc`, `QS_tru`, `xuatQS`, `timqs`, `tkqs`.
  - `LayoutCommands.cs`: Registered commands `vg`, `ve_luoi_truc`, `sbv`, `sap_xep_ban_ve`, `ibv`, `chen_khung_ten`, `taomv`, `taomv1`, `khoav`, `mokhoav`, `danhmuc`.
  - `DimensionUtilityCommands.cs`: Registered commands `catdim`, `cat_chan_dim`, `ngatdim`, `ngat_dim`, `dnoi`, `dim_noi_tiep`, `sl`, `ghi_do_doc`.
  - `TextAnnotationCommands.cs`: Registered commands `dtext`, `can_chinh_text`, `mcat`, `cao_do_mat_cat`.
  - `LayerUtilityCommands.cs`: Registered commands `anlayer`, `an_layer`, `hienlayer`, `hien_tat_ca_layer`, `doilayer`, `doi_layer`.
  - `KataCleanCommands.cs`: Registered commands `clean_kata`, `xoa_xrecord`.
  - `UtilityCommands.cs`: Cleaned up to eliminate duplicate `ve_grid`/`vg` command stubs.
  - `GoiLenh_HPKata.lsp`: Preserved exact 238 lines, offset line 152 intact, 100% compliant with KataPro LISP aliasing.

### 2.4 `HPKata.Revit`
- **`Units/RevitUnitConverter.cs`**:
  - Isolated constant `304.8` (Rule R5). Added `CubicFeetToCubicMeters` and `SquareFeetToSquareMeters` derived strictly from `MmPerFoot`.
- **`Services/`**:
  - `RevitQsTakeoffService.cs`: Queries structural elements in Revit Document, computes geometry volumes and contact areas, and deducts overlaps.
  - `RevitSheetArrangementService.cs`: Automates `ViewSheet.Create`, title block family placement, and `Viewport.Create`.
- **`Runners/`**:
  - `RevitQsLayoutRunner.cs`: Headless execution runner for pure unit/integration testing without Revit runtime.
- **`Commands/`**:
  - `RevitQsCommands.cs`: External command for Revit QS takeoff.
  - `RevitLayoutCommands.cs`: External command for Revit sheet layout.

### 2.5 Tests Suite Expansion
- **`HPKata.Core.Tests`**: 487 passed (+8 new test fixtures).
- **`HPKata.UI.Tests`**: 59 passed (`Phase5ViewModelTests.cs`).
- **`HPKata.AutoCad.Tests`**: 67 passed (`Phase5AutoCadTests.cs`).
- **`HPKata.Revit.Tests`**: 89 passed (`Phase5RevitTests.cs`).
- **`HPKata.E2E.Tests`**: 160 passed (`Phase5E2ETests.cs`).
- **Total**: 862 tests passed (100% green, 0 failures, 0 skipped).

---

## 3. Clean Code Rule Compliance

| Rule ID | Rule Requirement | Status | Verification Result |
|---|---|---|---|
| **C2** | Max 300 physical lines per file | PASS | All 54 files $\le 196$ lines (Max: `QsIntersectionDeductionEngine.cs` = 196 lines). |
| **M3** | Max 50 physical lines per method | PASS | All methods $\le 38$ lines. |
| **Q-B1** | 0 dead/commented-out code, 0 TODOs/NotImplementedException | PASS | Verified 0 occurrences across all production files. |
| **Q-B2** | 0 unannotated empty catch blocks | PASS | All catch blocks thoroughly annotated with rationale. |
| **R5** | Constant 304.8 strictly in `RevitUnitConverter.cs` | PASS | Verified 304.8 exists ONLY in `RevitUnitConverter.cs`. |
| **Core** | Zero `Autodesk.*` references in `HPKata.Core` | PASS | Pure .NET 8 / netstandard2.0 domain library. |
