Lightingsang/AddinRebar/.agents/teamwork/worker_m4_remediation/changes.md

# M4 Remediation Implementation Report

**Milestone**: M4 (Phase 5: Quantity Surveying (QS) & Drawing Utilities, Iteration 2)  
**Agent**: `worker_m4_remediation`  
**Date**: 2026-10-17  
**Status**: COMPLETE  

---

## 1. Summary of Changes

All remediation goals specified in `DISPATCH.md` have been fully executed without any facades, stubs, or hardcoded return values. All modified files strictly adhere to Clean Code rules: $\le 300$ physical lines per file (Rule C2), $\le 50$ physical lines per method (Rule M3), 0 dead code/TODOs (Rule Q-B1), and annotated catch blocks (Rule Q-B2).

---

## 2. File Modification Details

### A. CAD Commands & Controllers (`HPKata.AutoCad`)
1. **`HPKata/HPKata.AutoCad/Commands/DimensionUtilityCommands.cs`** (41 lines):
   - Wired `[CommandMethod("dnoi")]` and `[CommandMethod("dim_noi_tiep")]` to `DimensionUtilityController.ContinueDimensionInteractive()`.
   - Wired `[CommandMethod("catdim")]` to `DimensionUtilityController.TrimDimensionInteractive()`.
   - Maintained clean separation of command dispatch from controller business logic.

2. **`HPKata/HPKata.AutoCad/Commands/LayoutCommands.cs`** (67 lines):
   - Registered `[CommandMethod("ve_grid")]` as an alias for grid layout generation on `DrawGrid()`.
   - Preserved `[CommandMethod("grid")]` and `[CommandMethod("truc")]`.

3. **`HPKata/HPKata.AutoCad/Controllers/DimensionUtilityController.cs`** (270 lines):
   - Implemented genuine `ContinueDimensionInteractive()` supporting continuous dimensioning from an existing linear or aligned dimension.
   - Decomposed into helper methods $\le 50$ lines:
     - `TryGetBaseDimensionInfo()`: extracts base dimension line, measurement angle, extension line endpoints, and text rotation.
     - `TryPromptNewBaseDimension()`: prompts the user to select an initial dimension when none is pre-selected.
     - `LoopContinuousDimensions()`: interactive prompt loop allowing user to pick points and create consecutive dimensions chained along the same dimension line.
   - Preserved genuine `TrimDimensionInteractive()` with entity intersection and dimension line trimming.

4. **`HPKata/HPKata.AutoCad/Controllers/QsTakeoffController.cs`** (289 lines):
   - Replaced simulation stubs `[C1, D1, S1]` with real ModelSpace entity queries and user selection (`PromptSelectionResult`).
   - Implemented genuine bounding box extraction (`GeometricExtents3d`) and structural element classification based on layer names, geometric aspect ratios, and dimensions.
   - Implemented genuine spatial intersection checks for contact pair deductions.
   - Replaced stubbed `FindElement` (`timqs`) with genuine `CadHighlightService.HighlightEntity()` and `CadHighlightService.ZoomToEntity()`.

---

### B. QS Core Engine (`HPKata.Core`)
5. **`HPKata/HPKata.Core/QuantitySurveying/Calculators/QsTakeoffCalculator.cs`** (105 lines):
   - Added `SanitizeDimensions()` clamping width, depth, height, and length to non-negative values (`Math.Max(0.0, ...)`).
   - Fixed defect where negative dimensions produced positive volumes or corrupted formwork calculations via double negatives (e.g., $(-0.4) \times (-0.6)$).

6. **`HPKata/HPKata.Core/QuantitySurveying/Calculators/QsFormworkCalculator.cs`** (127 lines):
   - Decomposed `EvaluateContactPair()` into modular deduction sub-methods:
     - `DeductColumnContact()`
     - `DeductBeamContact()`
     - `DeductFootingContact()`
   - All methods strictly conform to Rule M3 ($\le 50$ lines).

---

### C. Drawing Layout Engine (`HPKata.Core`)
7. **`HPKata/HPKata.Core/DrawingLayout/Calculators/SheetArrangerCalculator.cs`** (214 lines):
   - Implemented vertical bounds check (`cursorY + block.HeightMm > maxY`) in shelf placement loop to prevent placing blocks past printable boundaries.
   - Added pre-flight filter for oversized blocks exceeding printable area dimensions, routing them cleanly to unplaced blocks without spawning phantom sheets or causing infinite loops.
   - Added phantom empty sheet pruning (`sheets.RemoveAll(s => s.PlacedBlocks.Count == 0)`).
   - Added `GetNextShelfY()` to handle TitleBlock avoidance cleanly by advancing $Y$ to `sheetDef.MarginBottomMm + tb.HeightMm` when a shelf collides with the TitleBlock, unlocking the full printable width above the TitleBlock.
   - All methods adhere strictly to Rule M3 ($\le 50$ lines).

---

### D. Test Suites & Verification
8. **`HPKata/HPKata.Core.Tests/DrawingLayout/DrawingLayoutStressChallengeTests.cs`** (261 lines):
   - Updated `OversizedBlocks_LargerThanPrintableArea_HandledWithoutInfiniteLoop` and `Defect_SheetArrangerCalculator_UnplaceableBlockSpawnsEmptySheet` to verify oversized block handling and phantom sheet elimination.

9. **`HPKata/HPKata.Core.Tests/QuantitySurveying/QsTakeoffCalculatorTests.cs`** (200 lines):
   - Added unit tests:
     - `CalculateConcreteVolume_NegativeDimensions_ClampedToZeroVolume`
     - `CalculateConcreteVolume_DoubleNegativeDimensions_ClampedToZeroVolume`
     - `CalculateFormworkArea_NegativeDimensions_ClampedToZeroArea`
     - `CalculateFormworkArea_DoubleNegativeDimensions_ClampedToZeroArea`

10. **`HPKata/HPKata.Core.Tests/QuantitySurveying/QsFormworkCalculatorTests.cs`** (138 lines):
    - Added unit test: `CalculateContactDeductions_ColumnSlabContact_DeductsContactArea`.

11. **`HPKata/HPKata.AutoCad.Tests/Controllers/Phase5AutoCadTests.cs`** (195 lines):
    - Added unit tests verifying `ve_grid`, `ContinueDimensionInteractive()`, and command alias registrations.
