Lightingsang/AddinRebar/.agents/teamwork/worker_m5/changes.md

# Changes Summary — Worker M5

**Milestone**: M5 (Theme Gallery, Token Coverage Tests & Packaging Verification)  
**Date**: 2026-10-10  
**Agent**: `worker_m5`  

---

## 1. Files Modified

| File Path | Nature of Change | Rationale |
|---|---|---|
| `HPRebar/HPRebar.Core.Tests/Themes/ThemeTokenCoverageTests.cs` | Modified | Expanded XAML scanner to scan both `HPRebar/HPRebar` and `HPRebar/HPRebar.McpBridge` directories (excluding `bin`/`obj`). Added assertion for `StandardComboBox` among rebased keys in `MaterialBridge.xaml`. Expanded pack URI disk resolution to support `/HPRebar.McpBridge;component/` for both direct and linked resource dictionaries. |
| `HPRebar/tools/theme-gallery/KataElevationGallery.cs` | Modified | Updated line 149 `Support` method to pass all 7 positional constructor parameters matching `HPRebar.Core.KataExport.Models.KataSupport` record (`Kind`, `Extent`, `ElementKey`, `SectionText`, `Upper`, `CrossingBeamStationMm`, `CrossingBeamSection`). |
| `HPRebar/tools/theme-gallery/Program.cs` | Modified | Replaced `Graphics.CopyFromScreen` in `Capture` with WPF `RenderTargetBitmap` + `PngBitmapEncoder` to allow headless/CI offscreen visual captures without desktop device context handles. Modularized `Main` into clean helper methods (`ProcessTabViews`, `ProcessMcpBridgeView`, `ProcessRibbonIcons`, `SetupAssemblyResolver`, `DiscoverViews`). Added `ProcessMcpBridgeView` to host, style, and snapshot `HPRebar.McpBridge.View.McpBridgeStatusView` in dark and light modes using `GalleryBridgeRunner`. |
| `HPRebar/tools/theme-gallery/ThemeGallery.csproj` | Modified | Added ProjectReference to `..\..\..\McpShared\HPRebar.McpBridge.Core\HPRebar.McpBridge.Core.csproj` to provide types `IMcpBridgeRunner` and `McpBridgeStatusViewModel` without any Revit API dependencies. |

---

## 2. Detailed Technical Edits

### A. `ThemeTokenCoverageTests.cs`
1. **Multi-Assembly XAML Enumeration**:
   ```csharp
   var xamlFiles = Directory.EnumerateFiles(addIn, "*.xaml", SearchOption.AllDirectories)
       .Concat(Directory.EnumerateFiles(mcpBridge, "*.xaml", SearchOption.AllDirectories))
       .Where(f => !f.Contains($"{Path.DirectorySeparatorChar}bin{Path.DirectorySeparatorChar}") && !f.Contains($"{Path.DirectorySeparatorChar}obj{Path.DirectorySeparatorChar}"));
   ```
2. **Rebased Key Assertion**:
   Asserts presence of `"StandardComboBox"`, `"PrimaryButton"`, `"SecondaryButton"`, `"DangerButton"`, `"IconButton"`, `"LinkButton"`, `"StandardTextBox"`, `"NumberTextBox"`, `"SearchTextBox"` in `MaterialBridge.xaml`.
3. **Multi-Assembly Pack URI Resolution**:
   Matches `/(?<assembly>HPRebar(?:\.McpBridge)?);component/(?<path>[^""#\s]+)`. Resolves against target assembly folder or fallback linked folder (`HPRebar`).

### B. `KataElevationGallery.cs`
Fixed `KataSupport` instantiation:
```csharp
private object Support(int kind, double start, double end, (double, double)? upper = null, string? section = null) =>
    Activator.CreateInstance(_support, Enum.ToObject(_kind, kind), Interval(start, end), $"S{start}", section,
        upper is { } u ? Interval(u.Item1, u.Item2) : null, null, null)!;
```

### C. `Program.cs` & `ThemeGallery.csproj`
1. Replaced `Graphics.CopyFromScreen` with `RenderTargetBitmap`:
   ```csharp
   private static void Capture(Window window, string path)
   {
       window.UpdateLayout();
       var width = window.ActualWidth > 0 ? window.ActualWidth : window.Width;
       var height = window.ActualHeight > 0 ? window.ActualHeight : window.Height;
       if (double.IsNaN(width) || width <= 0) width = 800;
       if (double.IsNaN(height) || height <= 0) height = 600;

       var dpiX = 96.0;
       var dpiY = 96.0;
       var source = PresentationSource.FromVisual(window);
       if (source?.CompositionTarget != null)
       {
           dpiX = 96.0 * source.CompositionTarget.TransformToDevice.M11;
           dpiY = 96.0 * source.CompositionTarget.TransformToDevice.M22;
       }

       var pixelWidth = Math.Max(1, (int)Math.Round(width * (dpiX / 96.0)));
       var pixelHeight = Math.Max(1, (int)Math.Round(height * (dpiY / 96.0)));

       var rtb = new RenderTargetBitmap(pixelWidth, pixelHeight, dpiX, dpiY, PixelFormats.Pbgra32);
       rtb.Render(window);

       var encoder = new PngBitmapEncoder();
       encoder.Frames.Add(BitmapFrame.Create(rtb));
       using var stream = File.Create(path);
       encoder.Save(stream);
   }
   ```
2. Added `GalleryBridgeRunner` and `ProcessMcpBridgeView`:
   Provides genuine `IMcpBridgeRunner` implementation allowing proper initialization of `McpBridgeStatusViewModel` and `McpBridgeStatusView` so WPF's `DependencyObject` local value store initializes cleanly.
3. Added ProjectReference to `HPRebar.McpBridge.Core.csproj` in `ThemeGallery.csproj`.

---

## 3. Verification Commands & Results

1. `dotnet build tools/theme-gallery/ThemeGallery.csproj`:
   - Result: Build succeeded (0 errors, 0 warnings across `net48` and `net8.0-windows`).
2. `dotnet run --project tools/theme-gallery/ThemeGallery.csproj -f net8.0-windows -- -Dll HPRebar/bin/Debug.R26/HPRebar.dll -Out output/theme-gallery`:
   - Result: 46 runs recorded, 0 failures. All 16 tab views, `McpBridgeStatusView` (dark & light), 5 Kata elevation scenes, and 2 vector icon sets rendered and saved to PNG.
3. `dotnet build HPRebar/HPRebar.csproj -c Debug.R26 -p:DeployAddin=false`:
   - Result: Build succeeded (0 errors).
4. `dotnet build HPRebar/HPRebar.csproj -c Debug.R25 -p:DeployAddin=false`:
   - Result: Build succeeded (0 errors).
5. `dotnet build HPRebar/HPRebar.csproj -c Debug.R27 -p:DeployAddin=false`:
   - Result: Build succeeded (0 errors).
6. `dotnet build HPRebar.McpBridge/HPRebar.McpBridge.csproj -c Debug.R26 -p:DeployAddin=false`:
   - Result: Build succeeded (0 errors, ILRepack merged MaterialDesign toolkit).
7. `dotnet build HPRebar.McpBridge/HPRebar.McpBridge.csproj -c Debug.R25 -p:DeployAddin=false`:
   - Result: Build succeeded (0 errors, ILRepack merged MaterialDesign toolkit).
8. `dotnet test HPRebar.Core.Tests`:
   - Result: 1,692 passed, 0 failed (100% green).
9. `dotnet test HPRebar.Mcp.Server.Tests`:
   - Result: 118 passed, 0 failed (100% green).
