Lightingsang/AddinRebar/.agents/teamwork/worker_remediation_1/changes.md

# Changes Document — Remediation Worker 1

**Project:** HPRebar & HPRebar.McpBridge MaterialDesign Migration  
**Agent:** `worker_remediation_1`  
**Date:** 2026-10-10  
**Ownership Scope:**
- `HPRebar/HPRebar/JoinElements/Service/JoinElementService.cs`
- `HPRebar/HPRebar/JoinElements/View/JoinElementView.xaml`

---

## 1. Defect 1 Fix: Multi-Version ElementId Comparison

### File
`HPRebar/HPRebar/JoinElements/Service/JoinElementService.cs` (lines 303–311)

### Rationale
In Revit 2025 (`Debug.R25`), `Autodesk.Revit.DB.ElementId` does not implement `IComparable<ElementId>`. Invoking `id1.CompareTo(id2)` caused the Roslyn compiler to fall back to `MemoryExtensions.CompareTo(ReadOnlySpan<char>, ReadOnlySpan<char>, StringComparison)`, failing with `CS7036: There is no argument given that corresponds to the required parameter 'comparisonType'`.

To ensure canonical pair ordering across all Revit versions (R23–R27):
- For `REVIT2024_OR_GREATER` (R24, R25, R26, R27), compare numerical `long` via `id1.Value < id2.Value`.
- For earlier versions (R23), compare numerical `int` via `id1.IntegerValue < id2.IntegerValue`.
- Tagged with `// Multi-version: ElementId comparison` per AGENTS.md rules.

### Exact Diff
```csharp
<<<< ORIGINAL
    private static (ElementId, ElementId) NormalizePair(ElementId id1, ElementId id2)
    {
        return id1.CompareTo(id2) < 0 ? (id1, id2) : (id2, id1);
    }
==== REPLACEMENT
    private static (ElementId, ElementId) NormalizePair(ElementId id1, ElementId id2)
    {
        // Multi-version: ElementId comparison for canonical pair ordering (Value on R24+, IntegerValue on R23)
#if REVIT2024_OR_GREATER
        return id1.Value < id2.Value ? (id1, id2) : (id2, id1);
#else
        return id1.IntegerValue < id2.IntegerValue ? (id1, id2) : (id2, id1);
#endif
    }
>>>>
```

---

## 2. Defect 2 Fix: Eradication of Residual Custom Styles in JoinElementView

### File
`HPRebar/HPRebar/JoinElements/View/JoinElementView.xaml`

### Rationale
Audit Requirement R2 mandates the complete elimination of redundant custom styles in favor of `MaterialDesignInXamlToolkit` (v5.3.2) and the shared master theming system (`Theme.xaml`, `MaterialBridge.xaml`, `Controls.xaml`, `Typography.xaml`). `JoinElementView.xaml` had 5 local style definitions and usage sites violating R2.

### Summary of Changes:
1. **Window.Resources**: Removed 5 deprecated custom styles:
   - `SectionHeaderStyle` (TextBlock)
   - `CardBorderStyle` (Border)
   - `BadgeBorderStyle` (Border)
   - `DataGridHeaderStyle` (DataGridColumnHeader)
   - `DataGridRowStyle` (DataGridRow)
   - Preserved `<BooleanToVisibilityConverter x:Key="BoolToVis"/>` and `<ResourceDictionary Source=".../Theme.xaml"/>`.
2. **Card Borders**:
   - Header Bar (`Border Grid.Row="0"`): `Style="{DynamicResource Card}" Padding="12,10" Margin="0,0,0,12"`.
   - Left Panel Scope Card: `Style="{DynamicResource Card}" Margin="0,0,0,10"`.
   - Left Panel Options Card: `Style="{DynamicResource Card}" Margin="0,0,0,10"`.
   - Left Panel Tip Card: `Style="{DynamicResource Card}" Margin="0,0,0,10" Background="#0A2196F3" BorderBrush="#332196F3"`.
   - Right Panel Matrix Card: `Style="{DynamicResource Card}" Padding="0"`.
   - Footer Bar (`Border Grid.Row="2"`): `Style="{DynamicResource Card}" Padding="12,10" Margin="0,8,0,0"`.
3. **Badges / Tags**:
   - Replaced all 5 header badge borders with `Style="{DynamicResource Tag}" Margin="0,0,8,0"`, exactly mirroring `RebarPartitionView.xaml`.
4. **Typography**:
   - Replaced `Style="{StaticResource SectionHeaderStyle}"` on Section 1 and Section 2 titles with `Style="{DynamicResource Subheading}"`.
5. **DataGrid**:
   - Removed `ColumnHeaderStyle="{StaticResource DataGridHeaderStyle}"` and `RowStyle="{StaticResource DataGridRowStyle}"` on `<DataGrid>`, allowing the master `MaterialDesignDataGrid` implicit style in `Theme.xaml` to govern headers, row hover, and selection.
6. **Button Hierarchy Standardization**:
   - Toolbar buttons ("Chọn tất cả", "Bỏ chọn", "Chuẩn BIM"): Standardized to `Style="{DynamicResource LinkButton}"`.
   - Close button: Standardized to `Style="{DynamicResource SecondaryButton}"`.
   - Run Auto Join button: Standardized to `Style="{DynamicResource PrimaryButton}"` (removed hardcoded `Background`).
7. **Invariants Preserved**:
   - 100% of DataContext bindings, ViewModels, commands (`RunAutoJoinCommand`, `SelectAllPairsCommand`, `DeselectAllPairsCommand`, `ResetDefaultPriorityCommand`, `CloseCommand`), and Vietnamese labels/tooltips are intact.

### Exact Diff
```xml
<<<< ORIGINAL (Window.Resources)
            <BooleanToVisibilityConverter x:Key="BoolToVis"/>

            <Style x:Key="SectionHeaderStyle" TargetType="TextBlock">
                <Setter Property="FontWeight" Value="SemiBold"/>
                <Setter Property="FontSize" Value="{DynamicResource Font.Size.Body}"/>
                <Setter Property="Foreground" Value="{DynamicResource Brush.Foreground.Primary}"/>
                <Setter Property="Margin" Value="0,0,0,6"/>
            </Style>

            <Style x:Key="CardBorderStyle" TargetType="Border">
                <Setter Property="Background" Value="{DynamicResource Brush.Surface}"/>
                <Setter Property="BorderBrush" Value="{DynamicResource Brush.Border}"/>
                <Setter Property="BorderThickness" Value="1"/>
                <Setter Property="CornerRadius" Value="6"/>
                <Setter Property="Padding" Value="14"/>
                <Setter Property="Margin" Value="0,0,0,10"/>
            </Style>

            <Style x:Key="BadgeBorderStyle" TargetType="Border">
                <Setter Property="Background" Value="{DynamicResource Brush.GridLine}"/>
                <Setter Property="CornerRadius" Value="4"/>
                <Setter Property="Padding" Value="8,4"/>
                <Setter Property="Margin" Value="0,0,8,0"/>
            </Style>

            <Style x:Key="DataGridHeaderStyle" TargetType="DataGridColumnHeader">
                <Setter Property="FontWeight" Value="SemiBold"/>
                <Setter Property="Foreground" Value="{DynamicResource Brush.Foreground.Primary}"/>
                <Setter Property="Background" Value="{DynamicResource Brush.Surface}"/>
                <Setter Property="Padding" Value="8,6"/>
                <Setter Property="BorderBrush" Value="{DynamicResource Brush.GridLine}"/>
                <Setter Property="BorderThickness" Value="0,0,1,1"/>
            </Style>
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
