Lightingsang/AddinRebar/.agents/skills/fix/SKILL.md

---
name: bs:fix
description: "Fix bugs, errors, test failures, and CI/CD issues with intelligent routing. Use for type errors, lint issues, log errors, UI bugs, code problems. Invoke when there is a concrete bug, error, or CI failure. Keywords: bugfix, error, test-failure, CI, lint."
user-invocable: true
when_to_use: "Invoke when there is a concrete bug, error, or CI failure."
category: utilities
keywords: [bugfix, error, test-failure, CI, lint]
argument-hint: "[issue] --auto|--review|--quick|--parallel"
metadata:
  author: claudekit
  version: "2.1.0"
---

<!-- portable-host-contract:start -->
## Portable host contract

This skill is shared by Codex and Google Antigravity.

- Use the host's native task tracker. In Codex, use `update_plan`; in Antigravity, maintain the task-list artifact.
- Use native collaboration and user-input tools exposed by the host. Treat legacy tool names as capability descriptions, never literal calls.
- Resolve bundled resources from the project-local `.agents/skills/` tree. Do not create or write a user-global skill directory.
<!-- portable-host-contract:end -->

# Fixing

Unified skill for fixing issues of any complexity with intelligent routing.
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
