Lightingsang/AddinRebar/.agents/teamwork/explorer_gh_m5_it2_1/all_tests_dump.txt

=======================================================
FILE: Tier1_BuildAndIntegrityTests.cs (Tests found: 5)
=======================================================

--- Method: TC_T1_BLD_01_TotalToolSurfaceInvariant ---
Body (3 lines):
    var surface = GrasshopperE2EHarness.BuildToolSurfaceList();
    Assert.True(surface.Count >= GrasshopperE2EContracts.ExpectedTotalToolsCount);
    }

--- Method: TC_T1_BLD_02_InspectTypeToolSuppressionInvariant ---
Body (3 lines):
    var surface = GrasshopperE2EHarness.BuildToolSurfaceList();
    Assert.DoesNotContain(GrasshopperE2EContracts.SuppressedEngineTool, surface);
    }

--- Method: TC_T1_BLD_03_ToolNamingSnakeCaseUniformity ---
Body (7 lines):
    var surface = GrasshopperE2EHarness.BuildToolSurfaceList();
    var snakeCaseRegex = new Regex("^[a-z0-9_]+$");
    foreach (var tool in surface)
    {
    Assert.Matches(snakeCaseRegex, tool);
    }
    }

--- Method: TC_T1_BLD_04_McpSharedSingleDependencyDirection ---
Body (3 lines):
    Assert.Equal("grasshopper", GrasshopperE2EContracts.HostKey);
    Assert.Equal(2026, GrasshopperE2EContracts.DefaultHostVersion);
    }

--- Method: TC_T1_INT_01_CoreToolsCountInvariant ---
Body (4 lines):
    Assert.Equal(7, GrasshopperE2EContracts.CoreTools.Count);
    Assert.Equal(8, GrasshopperE2EContracts.RegistryMetaTools.Count);
    Assert.Equal(12, GrasshopperE2EContracts.EmbeddedSeeds.Count);
    }

=======================================================
FILE: Tier1_CanvasAndPlayerToolsTests.cs (Tests found: 10)
=======================================================

--- Method: TC_T1_RDC_01_CompleteCanvasGraphExtraction ---
Body (9 lines):
    var bridge = new GrasshopperE2EFakeBridge();
    var sample = GrasshopperE2EHarness.CreateSampleTowerGraph();
    foreach (var c in sample.Components) bridge.ActiveCanvas.Components.Add(c);
    foreach (var w in sample.Wires) bridge.ActiveCanvas.Wires.Add(w);
    var context = bridge.GetContext();
    Assert.Equal(2, context.ComponentsCount);
    Assert.Equal(1, context.WiresCount);
    Assert.Equal("ParametricTower.gh", context.ActiveDefinitionName);
    }

--- Method: TC_T1_RDC_02_IncludeParameterValuesFlag ---
Body (5 lines):
    var sample = GrasshopperE2EHarness.CreateSampleTowerGraph();
    var slider = sample.Components.First(c => c.Name == "Number Slider");
    Assert.True(slider.Properties.ContainsKey("Value"));
    Assert.Equal(10.0, Convert.ToDouble(slider.Properties["Value"]));
    }

--- Method: TC_T1_RDC_03_SelectedOnlyComponentFiltering ---
Body (12 lines):
    var bridge = new GrasshopperE2EFakeBridge();
    var c1 = GrasshopperE2EHarness.AddComponentToCanvas(bridge, "Node1", "N1", "Math", 0, 0);
    var c2 = GrasshopperE2EHarness.AddComponentToCanvas(bridge, "Node2", "N2", "Math", 100, 0);
    var selected = new List<GrasshopperComponentSpec>
    {
    c1 with { Selected = true },
    c2 with { Selected = false }
    };
    var filtered = selected.Where(c => c.Selected).ToList();
    Assert.Single(filtered);
    Assert.Equal("Node1", filtered[0].Name);
    }

--- Method: TC_T1_RDC_04_CategoryFilteringMechanism ---
Body (7 lines):
    var bridge = new GrasshopperE2EFakeBridge();
    GrasshopperE2EHarness.AddComponentToCanvas(bridge, "Addition", "Add", "Maths", 0, 0);
    GrasshopperE2EHarness.AddComponentToCanvas(bridge, "Panel", "P", "Params", 100, 0);
    var maths = bridge.ActiveCanvas.Components.Where(c => c.Category == "Maths").ToList();
    Assert.Single(maths);
    Assert.Equal("Addition", maths[0].Name);
    }

--- Method: TC_T1_RDC_05_RuntimeWarningAndErrorMessagesExtraction ---
Body (8 lines):
    var errorComp = new GrasshopperComponentSpec(
    Guid.NewGuid(), "Divide", "Div", "Maths", "Operators",
    100, 100, new[] { "A", "B" }, new[] { "R" },
    new Dictionary<string, object?>(),
    new[] { "Division by zero warning" });
    Assert.NotNull(errorComp.Messages);
    Assert.Contains("Division by zero warning", errorComp.Messages);
    }

--- Method: TC_T1_RPL_01_PlayerDefinitionExecution ---
Body (4 lines):
    var sample = GrasshopperE2EHarness.CreateSampleTowerGraph();
    Assert.Equal("ParametricTower.gh", sample.Name);
    Assert.NotEmpty(sample.Components);
    }

--- Method: TC_T1_RPL_02_ParameterInputInjection ---
Body (9 lines):
    var inputs = new Dictionary<string, object>
    {
    ["FloorCount"] = 25,
    ["FloorHeight"] = 3.8
    };
    Assert.Equal(2, inputs.Count);
    Assert.Equal(25, inputs["FloorCount"]);
    Assert.Equal(3.8, inputs["FloorHeight"]);
    }

--- Method: TC_T1_RPL_03_OutputExtractionFiltering ---
Body (11 lines):
    var outputs = new Dictionary<string, object>
    {
    ["TotalHeight"] = 95.0,
    ["TotalArea"] = 4500.0,
    ["Volume"] = 18000.0
    };
    var requestedKeys = new[] { "TotalHeight", "TotalArea" };
    var filtered = outputs.Where(kvp => requestedKeys.Contains(kvp.Key)).ToDictionary(k => k.Key, v => v.Value);
    Assert.Equal(2, filtered.Count);
    Assert.False(filtered.ContainsKey("Volume"));
    }

--- Method: TC_T1_RPL_04_HeadlessLifecycleDisposal ---
Body (6 lines):
    var bridge = new GrasshopperE2EFakeBridge();
    bridge.AttachLiveCanvas("Disposable.gh");
    Assert.True(bridge.IsLiveCanvasAttached);
    bridge.DetachLiveCanvas();
    Assert.False(bridge.IsLiveCanvasAttached);
    }

--- Method: TC_T1_RPL_05_ExecutionDurationTelemetry ---
Body (3 lines):
    var durationMs = 42L;
    Assert.True(durationMs > 0);
    }

=======================================================
FILE: Tier1_EditAndExportToolsTests.cs (Tests found: 10)
=======================================================

--- Method: TC_T1_BEC_01_BatchComponentAddition ---
Body (7 lines):
    var bridge = new GrasshopperE2EFakeBridge();
    var c1 = GrasshopperE2EHarness.AddComponentToCanvas(bridge, "Comp1", "C1", "Math", 100, 200);
    var c2 = GrasshopperE2EHarness.AddComponentToCanvas(bridge, "Comp2", "C2", "Math", 300, 200);
    Assert.Equal(2, bridge.ActiveCanvas.Components.Count);
    Assert.Contains(c1, bridge.ActiveCanvas.Components);
    Assert.Contains(c2, bridge.ActiveCanvas.Components);
    }

--- Method: TC_T1_BEC_02_BatchComponentRemoval ---
Body (7 lines):
    var bridge = new GrasshopperE2EFakeBridge();
    var c = GrasshopperE2EHarness.AddComponentToCanvas(bridge, "ToRemove", "TR", "Test", 0, 0);
    Assert.Single(bridge.ActiveCanvas.Components);
    var removed = GrasshopperE2EHarness.RemoveComponentFromCanvas(bridge, c.Id);
    Assert.True(removed);
    Assert.Empty(bridge.ActiveCanvas.Components);
    }

--- Method: TC_T1_BEC_03_WireConnectionCreation ---
Body (8 lines):
    var bridge = new GrasshopperE2EFakeBridge();
    var c1 = GrasshopperE2EHarness.AddComponentToCanvas(bridge, "Src", "S", "Math", 0, 0);
    var c2 = GrasshopperE2EHarness.AddComponentToCanvas(bridge, "Tgt", "T", "Math", 200, 0);
    var wire = GrasshopperE2EHarness.ConnectPortsOnCanvas(bridge, c1.Id, 0, c2.Id, 0);
    Assert.Single(bridge.ActiveCanvas.Wires);
    Assert.Equal(c1.Id, wire.SourceComponentId);
    Assert.Equal(c2.Id, wire.TargetComponentId);
    }

--- Method: TC_T1_BEC_04_WireDisconnection ---
Body (7 lines):
    var bridge = new GrasshopperE2EFakeBridge();
    var c1 = GrasshopperE2EHarness.AddComponentToCanvas(bridge, "Src", "S", "Math", 0, 0);
    var c2 = GrasshopperE2EHarness.AddComponentToCanvas(bridge, "Tgt", "T", "Math", 200, 0);
    GrasshopperE2EHarness.ConnectPortsOnCanvas(bridge, c1.Id, 0, c2.Id, 0);
    bridge.ActiveCanvas.Wires.Clear();
    Assert.Empty(bridge.ActiveCanvas.Wires);
    }

--- Method: TC_T1_BEC_05_TempIdInternalResolution ---
Body (8 lines):
    var tempMap = new System.Collections.Generic.Dictionary<string, Guid>
    {
    ["temp-node-1"] = Guid.NewGuid(),
    ["temp-node-2"] = Guid.NewGuid()
    };
    Assert.True(tempMap.ContainsKey("temp-node-1"));
    Assert.NotEqual(Guid.Empty, tempMap["temp-node-1"]);
    }

--- Method: TC_T1_IMG_01_Base64PngCanvasExport ---
Body (5 lines):
    var bytes = GrasshopperE2EHarness.GenerateMockPngBytes();
    var base64 = "data:image/png;base64," + Convert.ToBase64String(bytes);
    Assert.StartsWith("data:image/png;base64,", base64);
    Assert.True(base64.Length > 25);
    }

--- Method: TC_T1_IMG_02_DirectFileOutputExport ---
Body (12 lines):
    var tempFile = Path.Combine(Path.GetTempPath(), "gh_test_" + Guid.NewGuid().ToString("N") + ".png");
    try
    {
    File.WriteAllBytes(tempFile, GrasshopperE2EHarness.GenerateMockPngBytes());
    Assert.True(File.Exists(tempFile));
    Assert.True(new FileInfo(tempFile).Length > 0);
    }
    finally
    {
    if (File.Exists(tempFile)) File.Delete(tempFile);
    }
    }

--- Method: TC_T1_IMG_03_ZoomScalingAdjustment ---
Body (6 lines):
    double zoom1 = 1.0;
    double zoom2 = 2.0;
    int widthBase = 1000;
    int widthScaled = (int)(widthBase * (zoom2 / zoom1));
    Assert.Equal(2000, widthScaled);
    }

--- Method: TC_T1_IMG_04_Base64SuppressionOptimization ---
Body (4 lines):
    var returnBase64 = false;
    string base64Output = returnBase64 ? "base64data" : string.Empty;
    Assert.Empty(base64Output);
    }

--- Method: TC_T1_IMG_05_AutoDirectoryCreation ---
Body (13 lines):
    var nestedDir = Path.Combine(Path.GetTempPath(), "gh_sub_" + Guid.NewGuid().ToString("N"));
    var filePath = Path.Combine(nestedDir, "test.png");
    try
    {
    Directory.CreateDirectory(nestedDir);
    File.WriteAllBytes(filePath, GrasshopperE2EHarness.GenerateMockPngBytes());
    Assert.True(File.Exists(filePath));
    }
    finally
    {
    if (Directory.Exists(nestedDir)) Directory.Delete(nestedDir, true);
    }
    }

=======================================================
FILE: Tier1_ExecutionAndSafetyTests.cs (Tests found: 10)
=======================================================

--- Method: TC_T1_EXC_01_PureCSharpExpressionExecution ---
Body (6 lines):
    var bridge = new GrasshopperE2EFakeBridge { IsExecutionEnabled = true };
    var req = new GrasshopperExecutionRequest("int a = 10; int b = 20; var sum = a + b;");
    var result = await bridge.ExecuteAsync(req);
    Assert.True(result.Success);
    Assert.False(result.RolledBack);
    }

--- Method: TC_T1_EXC_02_StandardGlobalsAccessibility ---
Body (8 lines):
    var globals = GrasshopperE2EContracts.RequiredGlobals;
    Assert.Contains("doc", globals);
    Assert.Contains("canvas", globals);
    Assert.Contains("rhinoDoc", globals);
    Assert.Contains("revitDoc", globals);
    Assert.Contains("ct", globals);
    Assert.Contains("args", globals);
    }

--- Method: TC_T1_EXC_03_ReadOnlyTransactionModeNone ---
Body (7 lines):
    var bridge = new GrasshopperE2EFakeBridge { IsExecutionEnabled = true };
    var req = new GrasshopperExecutionRequest("var name = doc.DisplayName;", Transaction: "none");
    var result = await bridge.ExecuteAsync(req);
    Assert.True(result.Success);
    Assert.False(result.RolledBack);
    Assert.Equal(0, bridge.GetCommittedElementCount());
    }

--- Method: TC_T1_EXC_04_AutoTransactionModeAuto ---
Body (8 lines):
    var bridge = new GrasshopperE2EFakeBridge { IsExecutionEnabled = true };
    var req = new GrasshopperExecutionRequest("CreateElement();", Transaction: "auto", DryRun: false);
    var result = await bridge.ExecuteAsync(req);
    Assert.True(result.Success);
    Assert.False(result.RolledBack);
    Assert.NotEmpty(result.CreatedElementIds);
    Assert.Equal(1, bridge.GetCommittedElementCount());
    }

--- Method: TC_T1_EXC_05_ScriptArgsParameterParsing ---
Body (4 lines):
    var argsJson = "{\"Scale\": 2.5, \"Prefix\": \"GH_\"}";
    Assert.NotNull(argsJson);
    Assert.Contains("2.5", argsJson);
    }

--- Method: TC_T1_DLS_01_DryRunRevitTransactionGroupRollback ---
Body (8 lines):
    var bridge = new GrasshopperE2EFakeBridge { IsExecutionEnabled = true };
    var initialCommitted = bridge.GetCommittedElementCount();
    var req = new GrasshopperExecutionRequest("CreateElement();", DryRun: true);
    var result = await bridge.ExecuteAsync(req);
    Assert.True(result.Success);
    Assert.True(result.RolledBack);
    Assert.Equal(initialCommitted, bridge.GetCommittedElementCount());
    }

--- Method: TC_T1_DLS_02_DryRunCanvasUndoScopeCanvasRollback ---
Body (8 lines):
    var bridge = new GrasshopperE2EFakeBridge { IsExecutionEnabled = true };
    var initialComponents = bridge.ActiveCanvas.Components.Count;
    var req = new GrasshopperExecutionRequest("CreateRebar();", DryRun: true);
    var result = await bridge.ExecuteAsync(req);
    Assert.True(result.Success);
    Assert.True(result.RolledBack);
    Assert.Equal(initialComponents, bridge.ActiveCanvas.Components.Count);
    }

--- Method: TC_T1_DLS_03_CommitExecutionDualPersistence ---
Body (7 lines):
    var bridge = new GrasshopperE2EFakeBridge { IsExecutionEnabled = true };
    var req = new GrasshopperExecutionRequest("CreateRebar();", DryRun: false);
    var result = await bridge.ExecuteAsync(req);
    Assert.True(result.Success);
    Assert.False(result.RolledBack);
    Assert.Equal(1, bridge.GetCommittedElementCount());
    }

--- Method: TC_T1_DLS_04_ScriptExceptionRollbackSafety ---
Body (8 lines):
    var bridge = new GrasshopperE2EFakeBridge { IsExecutionEnabled = true };
    var initialCommitted = bridge.GetCommittedElementCount();
    var req = new GrasshopperExecutionRequest("throw new InvalidOperationException();");
    var result = await bridge.ExecuteAsync(req);
    Assert.False(result.Success);
    Assert.True(result.RolledBack);
    Assert.Equal(initialCommitted, bridge.GetCommittedElementCount());
    }

--- Method: TC_T1_DLS_05_CancellationCompensatingRollback ---
Body (9 lines):
    var bridge = new GrasshopperE2EFakeBridge { IsExecutionEnabled = true };
    using var cts = new CancellationTokenSource();
    cts.Cancel();
    var req = new GrasshopperExecutionRequest("CreateElement();");
    var result = await bridge.ExecuteAsync(req, cts.Token);
    Assert.False(result.Success);
    Assert.True(result.RolledBack);
    Assert.Equal(-32003, result.ErrorCode);
    }

=======================================================
FILE: Tier1_HostProfileAndSecurityTests.cs (Tests found: 5)
=======================================================

--- Method: TC_T1_GRD_01_HostProfileMetadataInvariants ---
Body (4 lines):
    Assert.Equal("grasshopper", GrasshopperE2EContracts.HostKey);
    Assert.Equal(2026, GrasshopperE2EContracts.DefaultHostVersion);
    Assert.Equal("hpgrasshopper-mcp-2026", GrasshopperE2EContracts.ExpectedPipeName);
    }

--- Method: TC_T1_GRD_02_LegitimateRhinoGrasshopperApiAllowance ---
Body (6 lines):
    var bridge = new GrasshopperE2EFakeBridge();
    var code = "var pt = new Rhino.Geometry.Point3d(0, 0, 0); var docName = doc.DisplayName;";
    var quality = bridge.ValidateScript(code);
    Assert.True(quality.IsValid);
    Assert.Empty(quality.Errors);
    }

--- Method: TC_T1_GRD_03_SystemIoNamespaceDenial ---
Body (6 lines):
    var bridge = new GrasshopperE2EFakeBridge();
    var code = "System.IO.File.Delete(\"test.txt\");";
    var quality = bridge.ValidateScript(code);
    Assert.False(quality.IsValid);
    Assert.Contains(quality.Errors, e => e.Contains("System.IO"));
    }

--- Method: TC_T1_GRD_04_SystemDiagnosticsProcessDenial ---
Body (6 lines):
    var bridge = new GrasshopperE2EFakeBridge();
    var code = "System.Diagnostics.Process.Start(\"calc.exe\");";
    var quality = bridge.ValidateScript(code);
    Assert.False(quality.IsValid);
    Assert.Contains(quality.Errors, e => e.Contains("System.Diagnostics.Process"));
    }

--- Method: TC_T1_GRD_05_UiPopupsDenial ---
Body (6 lines):
    var bridge = new GrasshopperE2EFakeBridge();
    var code = "System.Windows.Forms.MessageBox.Show(\"Hello\");";
    var quality = bridge.ValidateScript(code);
    Assert.False(quality.IsValid);
    Assert.Contains(quality.Errors, e => e.Contains("System.Windows.Forms"));
    }

=======================================================
FILE: Tier1_NamedPipeAndWpfTests.cs (Tests found: 10)
=======================================================

--- Method: TC_T1_NPS_01_PipeServerNameResolution ---
Body (3 lines):
    var resolved = GrasshopperE2EContracts.ResolvePipeName("grasshopper", 2026);
    Assert.Equal("hpgrasshopper-mcp-2026", resolved);
    }

--- Method: TC_T1_NPS_02_JsonRpcMethodPrefixConformance ---
Body (3 lines):
    Assert.Equal("grasshopper.", GrasshopperE2EContracts.MethodPrefix);
    Assert.True(GrasshopperE2EContracts.MethodPrefix.EndsWith('.'));
    }

--- Method: TC_T1_NPS_03_NdjsonFramingAndMessageParsing ---
Body (14 lines):
    var bridge = new GrasshopperE2EFakeBridge();
    await using var simulator = new GrasshopperPipeSimulator(bridge: bridge);
    simulator.Start();
    using var client = new NamedPipeClientStream(".", simulator.PipeName, PipeDirection.InOut);
    await client.ConnectAsync(2000);
    using var reader = new StreamReader(client, Encoding.UTF8);
    using var writer = new StreamWriter(client, new UTF8Encoding(false)) { AutoFlush = true };
    await writer.WriteLineAsync("{\"jsonrpc\":\"2.0\",\"id\":101,\"method\":\"grasshopper.ping\"}");
    var line = await reader.ReadLineAsync();
    Assert.NotNull(line);
    using var doc = JsonDocument.Parse(line);
    Assert.Equal(101, doc.RootElement.GetProperty("id").GetInt32());
    Assert.True(doc.RootElement.GetProperty("result").GetProperty("pong").GetBoolean());
    }

--- Method: TC_T1_NPS_04_RequestResponseIdCorrelation ---
Body (17 lines):
    var bridge = new GrasshopperE2EFakeBridge();
    await using var simulator = new GrasshopperPipeSimulator(bridge: bridge);
    simulator.Start();
    using var client = new NamedPipeClientStream(".", simulator.PipeName, PipeDirection.InOut);
    await client.ConnectAsync(2000);
    using var reader = new StreamReader(client, Encoding.UTF8);
    using var writer = new StreamWriter(client, new UTF8Encoding(false)) { AutoFlush = true };
    var testIds = new[] { "req-alpha", "req-beta", "req-gamma" };
    foreach (var reqId in testIds)
    {
    await writer.WriteLineAsync($"{{\"jsonrpc\":\"2.0\",\"id\":\"{reqId}\",\"method\":\"grasshopper.ping\"}}");
    var line = await reader.ReadLineAsync();
    Assert.NotNull(line);
    using var doc = JsonDocument.Parse(line);
    Assert.Equal(reqId, doc.RootElement.GetProperty("id").GetString());
    }
    }

--- Method: TC_T1_NPS_05_GracefulClientDisconnectAndReconnect ---
Body (14 lines):
    var bridge = new GrasshopperE2EFakeBridge();
    await using var simulator = new GrasshopperPipeSimulator(bridge: bridge);
    simulator.Start();
    for (int i = 0; i < 2; i++)
    {
    using var client = new NamedPipeClientStream(".", simulator.PipeName, PipeDirection.InOut);
    await client.ConnectAsync(2000);
    using var reader = new StreamReader(client, Encoding.UTF8);
    using var writer = new StreamWriter(client, new UTF8Encoding(false)) { AutoFlush = true };
    await writer.WriteLineAsync("{\"jsonrpc\":\"2.0\",\"id\":1,\"method\":\"ping\"}");
    var resp = await reader.ReadLineAsync();
    Assert.NotNull(resp);
    }
    }

--- Method: TC_T1_WPF_01_StatusViewModelInitialState ---
Body (7 lines):
    var bridge = new GrasshopperE2EFakeBridge();
    var context = bridge.GetContext();
    Assert.True(context.IsConnected);
    Assert.False(context.IsExecutionEnabled);
    Assert.True(context.IsLiveCanvasAttached);
    Assert.True(context.IsRhinoInsideActive);
    }

--- Method: TC_T1_WPF_02_ToggleListenerCommandExecution ---
Body (8 lines):
    var bridge = new GrasshopperE2EFakeBridge();
    Assert.True(bridge.IsLiveCanvasAttached);
    bridge.DetachLiveCanvas();
    Assert.False(bridge.GetContext().IsLiveCanvasAttached);
    bridge.AttachLiveCanvas("UpdatedTower.gh");
    Assert.True(bridge.GetContext().IsLiveCanvasAttached);
    Assert.Equal("UpdatedTower.gh", bridge.GetContext().ActiveDefinitionName);
    }

--- Method: TC_T1_WPF_03_OptInExecutionTogglePropertyChange ---
Body (6 lines):
    var bridge = new GrasshopperE2EFakeBridge();
    Assert.False(bridge.IsExecutionEnabled);
    bridge.IsExecutionEnabled = true;
    Assert.True(bridge.IsExecutionEnabled);
    Assert.True(bridge.GetContext().IsExecutionEnabled);
    }

--- Method: TC_T1_WPF_04_ScriptPreviewAndCopyCommand ---
Body (4 lines):
    var preview = "doc.Create.NewFamilyInstance();";
    Assert.False(string.IsNullOrWhiteSpace(preview));
    Assert.Contains("doc.Create", preview);
    }

--- Method: TC_T1_WPF_05_MaterialDesignThemeSynchronization ---
Body (7 lines):
    var themes = new[] { "Light", "Dark" };
    foreach (var theme in themes)
    {
    Assert.NotNull(theme);
    Assert.True(theme == "Light" || theme == "Dark");
    }
    }

=======================================================
FILE: Tier1_RegistryAndSeedsTests.cs (Tests found: 10)
=======================================================

--- Method: TC_T1_REG_01_SearchToolsDiscovery ---
Body (4 lines):
    var tools = GrasshopperE2EContracts.RegistryMetaTools;
    Assert.Contains("search_tools", tools);
    Assert.Equal(8, tools.Count);
    }

--- Method: TC_T1_REG_02_ProposeToolDraftRegistration ---
Body (6 lines):
    var bridge = new GrasshopperE2EFakeBridge();
    var code = "int a = 1; int b = 2; return a + b;";
    var quality = bridge.ValidateScript(code);
    Assert.True(quality.IsValid);
    Assert.True(quality.LineCount <= 300);
    }

--- Method: TC_T1_REG_03_TestToolSandboxExecution ---
Body (4 lines):
    var bridge = new GrasshopperE2EFakeBridge();
    var req = new GrasshopperExecutionRequest("return 42;", DryRun: true);
    Assert.True(req.DryRun);
    }

--- Method: TC_T1_REG_04_PublishToolPromotion ---
Body (3 lines):
    var metaTools = GrasshopperE2EContracts.RegistryMetaTools;
    Assert.Contains("publish_tool", metaTools);
    }

--- Method: TC_T1_REG_05_ManageToolRetirementLifecycle ---
Body (3 lines):
    var metaTools = GrasshopperE2EContracts.RegistryMetaTools;
    Assert.Contains("manage_tool", metaTools);
    }

--- Method: TC_T1_SED_01_SeedCatalogCompleteness ---
Body (3 lines):
    var seeds = GrasshopperE2EContracts.EmbeddedSeeds;
    Assert.Equal(12, seeds.Count);
    }

--- Method: TC_T1_SED_02_SeedToolSchemaCompleteness ---
Body (7 lines):
    var seeds = GrasshopperE2EContracts.EmbeddedSeeds;
    foreach (var seed in seeds)
    {
    Assert.False(string.IsNullOrWhiteSpace(seed));
    Assert.True(seed.Length >= 5);
    }
    }

--- Method: TC_T1_SED_03_SeedExamplesManifestValidation ---
Body (5 lines):
    var seeds = GrasshopperE2EContracts.EmbeddedSeeds;
    Assert.Contains("create_levels_grids", seeds);
    Assert.Contains("generate_columns_beams", seeds);
    Assert.Contains("facade_panelization", seeds);
    }

--- Method: TC_T1_SED_04_SeedCodeAstQualityWalkerPass ---
Body (6 lines):
    var bridge = new GrasshopperE2EFakeBridge();
    var dummySeedCode = "var res = new List<string>();\nreturn res;";
    var quality = bridge.ValidateScript(dummySeedCode);
    Assert.True(quality.IsValid);
    Assert.Empty(quality.Errors);
    }

--- Method: TC_T1_SED_05_StructuralRebarSeedsParameterCoverage ---
Body (4 lines):
    var seeds = GrasshopperE2EContracts.EmbeddedSeeds;
    Assert.Contains("generate_rebar_curves", seeds);
    Assert.Contains("generate_stirrup_distribution", seeds);
    }

=======================================================
FILE: Tier2_BuildAndIntegrityBoundariesTests.cs (Tests found: 5)
=======================================================

--- Method: TC_T2_BLD_01_ZeroDisallowedNativeAssemblyReferences ---
Body (4 lines):
    var denied = GrasshopperE2EContracts.DeniedNamespaces;
    Assert.Contains("System.IO", denied);
    Assert.Contains("System.Diagnostics.Process", denied);
    }

--- Method: TC_T2_BLD_02_ZeroNativeDependenciesInE2eTestSuite ---
Body (3 lines):
    var expectedHost = GrasshopperE2EContracts.HostKey;
    Assert.Equal("grasshopper", expectedHost);
    }

--- Method: TC_T2_BLD_03_StrictRuleC2ComplianceBoundary ---
Body (4 lines):
    int maxAllowedLines = 300;
    int targetMaxLines = 230;
    Assert.True(targetMaxLines < maxAllowedLines);
    }

--- Method: TC_T2_BLD_04_StrictRuleM3ComplianceBoundary ---
Body (4 lines):
    int maxAllowedMethodLines = 50;
    int targetMaxMethodLines = 40;
    Assert.True(targetMaxMethodLines < maxAllowedMethodLines);
    }

--- Method: TC_T2_BLD_05_HostProfileDefaultClampingInvariant ---
Body (3 lines):
    int timeout = 600;
    Assert.True(timeout <= 600);
    }

=======================================================
FILE: Tier2_CanvasAndPlayerBoundariesTests.cs (Tests found: 10)
=======================================================

--- Method: TC_T2_RDC_01_NullActiveDocumentGracefulFallback ---
Body (5 lines):
    var bridge = new GrasshopperE2EFakeBridge();
    bridge.DetachLiveCanvas();
    var ctx = bridge.GetContext();
    Assert.False(ctx.IsLiveCanvasAttached);
    }

--- Method: TC_T2_RDC_02_CompletelyEmptyCanvasBoundary ---
Body (7 lines):
    var bridge = new GrasshopperE2EFakeBridge();
    bridge.ActiveCanvas.Components.Clear();
    bridge.ActiveCanvas.Wires.Clear();
    var ctx = bridge.GetContext();
    Assert.Equal(0, ctx.ComponentsCount);
    Assert.Equal(0, ctx.WiresCount);
    }

--- Method: TC_T2_RDC_03_NonExistentCategoryFilterNegativeTest ---
Body (5 lines):
    var bridge = new GrasshopperE2EFakeBridge();
    GrasshopperE2EHarness.AddComponentToCanvas(bridge, "Node1", "N1", "Math", 0, 0);
    var filtered = bridge.ActiveCanvas.Components.Where(c => c.Category == "NonExistentCat").ToList();
    Assert.Empty(filtered);
    }

--- Method: TC_T2_RDC_04_MassiveCanvasStressBoundary ---
Body (9 lines):
    var bridge = new GrasshopperE2EFakeBridge();
    for (int i = 0; i < 500; i++)
    {
    GrasshopperE2EHarness.AddComponentToCanvas(bridge, $"Node_{i}", $"N_{i}", "Batch", i, i);
    }
    Assert.Equal(500, bridge.ActiveCanvas.Components.Count);
    var json = bridge.ActiveCanvas.ToJson();
    Assert.True(json.Length > 1000);
    }

--- Method: TC_T2_RDC_05_CircularWireTopologySafeTraversal ---
Body (7 lines):
    var bridge = new GrasshopperE2EFakeBridge();
    var c1 = GrasshopperE2EHarness.AddComponentToCanvas(bridge, "A", "A", "Math", 0, 0);
    var c2 = GrasshopperE2EHarness.AddComponentToCanvas(bridge, "B", "B", "Math", 100, 0);
    GrasshopperE2EHarness.ConnectPortsOnCanvas(bridge, c1.Id, 0, c2.Id, 0);
    GrasshopperE2EHarness.ConnectPortsOnCanvas(bridge, c2.Id, 0, c1.Id, 0);
    Assert.Equal(2, bridge.ActiveCanvas.Wires.Count);
    }

--- Method: TC_T2_RPL_01_NonExistentFilePathNegativeTest ---
Body (4 lines):
    var invalidPath = "C:\\NoSuchFile_" + Guid.NewGuid().ToString("N") + ".gh";
    var exists = File.Exists(invalidPath);
    Assert.False(exists);
    }

--- Method: TC_T2_RPL_02_CorruptedArchiveFileNegativeTest ---
Body (4 lines):
    var corruptedBytes = new byte[] { 0x00, 0x01, 0x02, 0x03 };
    var isGhHeader = (corruptedBytes.Length >= 4 && corruptedBytes[0] == 0x89);
    Assert.False(isGhHeader);
    }

--- Method: TC_T2_RPL_03_EmptyInputsObjectBoundaryTest ---
Body (3 lines):
    var inputs = new Dictionary<string, object>();
    Assert.Empty(inputs);
    }

--- Method: TC_T2_RPL_04_TypeMismatchedInputValuesNegativeTest ---
Body (7 lines):
    var inputs = new Dictionary<string, object>
    {
    ["SliderValue"] = "NotANumber"
    };
    var parsed = double.TryParse(inputs["SliderValue"]?.ToString(), out var num);
    Assert.False(parsed);
    }

--- Method: TC_T2_RPL_05_PathTraversalCharacterScrubbing ---
Body (5 lines):
    var malicious = "../../../Windows/System32/cmd.exe";
    var cleaned = Path.GetFileName(malicious);
    Assert.Equal("cmd.exe", cleaned);
    Assert.DoesNotContain("..", cleaned);
    }

=======================================================
FILE: Tier2_EditAndExportBoundariesTests.cs (Tests found: 10)
=======================================================

--- Method: TC_T2_BEC_01_BatchEditOnNullDocumentNegativeTest ---
Body (4 lines):
    var bridge = new GrasshopperE2EFakeBridge();
    bridge.DetachLiveCanvas();
    Assert.False(bridge.IsLiveCanvasAttached);
    }

--- Method: TC_T2_BEC_02_ExtremeCoordinateValuesClampingBoundary ---
Body (6 lines):
    var bridge = new GrasshopperE2EFakeBridge();
    Assert.Throws<ArgumentException>(() =>
    GrasshopperE2EHarness.AddComponentToCanvas(bridge, "NaNNode", "N", "Math", double.NaN, 100));
    Assert.Throws<ArgumentException>(() =>
    GrasshopperE2EHarness.AddComponentToCanvas(bridge, "InfNode", "I", "Math", 100, double.PositiveInfinity));
    }

--- Method: TC_T2_BEC_03_UnknownComponentTypeNameNegativeTest ---
Body (5 lines):
    var bridge = new GrasshopperE2EFakeBridge();
    var c = GrasshopperE2EHarness.AddComponentToCanvas(bridge, "Invalid.Type.Does.Not.Exist", "Inv", "Unknown", 0, 0);
    Assert.NotNull(c);
    Assert.Equal("Invalid.Type.Does.Not.Exist", c.Name);
    }

--- Method: TC_T2_BEC_04_RemoveNonExistentGuidNegativeTest ---
Body (4 lines):
    var bridge = new GrasshopperE2EFakeBridge();
    var removed = GrasshopperE2EHarness.RemoveComponentFromCanvas(bridge, Guid.NewGuid());
    Assert.False(removed);
    }

--- Method: TC_T2_BEC_05_DuplicateWireConnectionIdempotency ---
Body (9 lines):
    var bridge = new GrasshopperE2EFakeBridge();
    var c1 = GrasshopperE2EHarness.AddComponentToCanvas(bridge, "A", "A", "M", 0, 0);
    var c2 = GrasshopperE2EHarness.AddComponentToCanvas(bridge, "B", "B", "M", 100, 0);
    GrasshopperE2EHarness.ConnectPortsOnCanvas(bridge, c1.Id, 0, c2.Id, 0);
    var existing = bridge.ActiveCanvas.Wires.Any(w =>
    w.SourceComponentId == c1.Id && w.SourcePortIndex == 0 &&
    w.TargetComponentId == c2.Id && w.TargetPortIndex == 0);
    Assert.True(existing);
    }

--- Method: TC_T2_IMG_01_NullCanvasNegativeTest ---
Body (4 lines):
    var bridge = new GrasshopperE2EFakeBridge();
    bridge.DetachLiveCanvas();
    Assert.False(bridge.IsLiveCanvasAttached);
    }

--- Method: TC_T2_IMG_02_ExtremeZoomFactorLowerClamping ---
Body (4 lines):
    double inputZoom = -10.0;
    double clamped = Math.Clamp(inputZoom, 0.25, 4.0);
    Assert.Equal(0.25, clamped);
    }

--- Method: TC_T2_IMG_03_ExtremeZoomFactorUpperClamping ---
Body (4 lines):
    double inputZoom = 100.0;
    double clamped = Math.Clamp(inputZoom, 0.25, 4.0);
    Assert.Equal(4.0, clamped);
    }

--- Method: TC_T2_IMG_04_ZeroDimensionCanvasFallback ---
Body (6 lines):
    int w = 0, h = 0;
    int clampedW = Math.Max(w, 200);
    int clampedH = Math.Max(h, 200);
    Assert.Equal(200, clampedW);
    Assert.Equal(200, clampedH);
    }

--- Method: TC_T2_IMG_05_IllegalOutputFilePathCharactersNegativeTest ---
Body (4 lines):
    var illegalPath = "C:\\Invalid|Path*?\\file.png";
    var hasInvalidChars = illegalPath.IndexOfAny(Path.GetInvalidPathChars()) >= 0 || illegalPath.Contains('|') || illegalPath.Contains('*');
    Assert.True(hasInvalidChars);
    }

=======================================================
FILE: Tier2_ExecutionAndSafetyBoundariesTests.cs (Tests found: 10)
=======================================================

--- Method: TC_T2_EXC_01_CSharpSyntaxCompilationErrorNegativeTest ---
Body (5 lines):
    var bridge = new GrasshopperE2EFakeBridge();
    var code = "int a = ;";
    var quality = bridge.ValidateScript(code);
    Assert.NotNull(quality);
    }

--- Method: TC_T2_EXC_02_UnhandledRuntimeExceptionNegativeTest ---
Body (7 lines):
    var bridge = new GrasshopperE2EFakeBridge { IsExecutionEnabled = true };
    var req = new GrasshopperExecutionRequest("throw new InvalidOperationException(\"Simulation engine failure\");");
    var result = await bridge.ExecuteAsync(req);
    Assert.False(result.Success);
    Assert.True(result.RolledBack);
    Assert.Equal(-32000, result.ErrorCode);
    }

--- Method: TC_T2_EXC_03_EmptyAndWhitespaceOnlyCodeNegativeTest ---
Body (6 lines):
    var bridge = new GrasshopperE2EFakeBridge();
    var quality1 = bridge.ValidateScript("");
    var quality2 = bridge.ValidateScript("   \r\n\t  ");
    Assert.Equal(0, quality1.LineCount);
    Assert.Equal(0, quality2.LineCount);
    }

--- Method: TC_T2_EXC_04_ExecutionTimeoutExceededCancellation ---
Body (9 lines):
    var bridge = new GrasshopperE2EFakeBridge { IsExecutionEnabled = true };
    using var cts = new CancellationTokenSource();
    cts.Cancel();
    var req = new GrasshopperExecutionRequest("while(true) Thread.Sleep(100);");
    var result = await bridge.ExecuteAsync(req, cts.Token);
    Assert.False(result.Success);
    Assert.True(result.RolledBack);
    Assert.Equal(-32003, result.ErrorCode);
    }

--- Method: TC_T2_EXC_05_LargeScriptLineCountLimit301Lines ---
Body (7 lines):
    var bridge = new GrasshopperE2EFakeBridge();
    var sb = new StringBuilder();
    for (int i = 0; i < 301; i++) sb.AppendLine($"int x{i} = {i};");
    var quality = bridge.ValidateScript(sb.ToString());
    Assert.False(quality.IsValid);
    Assert.Contains(quality.Errors, e => e.Contains("exceeds 300 lines"));
    }

--- Method: TC_T2_DLS_01_PartialScriptFailureRollbackVerification ---
Body (8 lines):
    var bridge = new GrasshopperE2EFakeBridge { IsExecutionEnabled = true };
    var initial = bridge.GetCommittedElementCount();
    var req = new GrasshopperExecutionRequest("CreateElement(); throw new Exception();");
    var result = await bridge.ExecuteAsync(req);
    Assert.False(result.Success);
    Assert.True(result.RolledBack);
    Assert.Equal(initial, bridge.GetCommittedElementCount());
    }

--- Method: TC_T2_DLS_02_IdempotentDoubleRollback ---
Body (4 lines):
    var bridge = new GrasshopperE2EFakeBridge();
    var initial = bridge.GetCommittedElementCount();
    Assert.Equal(0, initial);
    }

--- Method: TC_T2_DLS_03_DisposeWithoutCommitTriggersRollback ---
Body (6 lines):
    var bridge = new GrasshopperE2EFakeBridge { IsExecutionEnabled = true };
    var req = new GrasshopperExecutionRequest("CreateElement();", DryRun: true);
    var result = await bridge.ExecuteAsync(req);
    Assert.True(result.RolledBack);
    Assert.Equal(0, bridge.GetCommittedElementCount());
    }

--- Method: TC_T2_DLS_04_ReadOnlyDocumentTransactionPrevention ---
Body (3 lines):
    bool isReadOnly = true;
    Assert.True(isReadOnly);
    }

--- Method: TC_T2_DLS_05_ZeroDocumentChangeCountOnDryRun ---
Body (8 lines):
    var bridge = new GrasshopperE2EFakeBridge { IsExecutionEnabled = true };
    var initial = bridge.GetCommittedElementCount();
    var req = new GrasshopperExecutionRequest("CreateRebar(); CreateElement();", DryRun: true);
    var res = await bridge.ExecuteAsync(req);
    Assert.True(res.Success);
    Assert.True(res.RolledBack);
    Assert.Equal(initial, bridge.GetCommittedElementCount());
    }

=======================================================
FILE: Tier2_NamedPipeAndWpfBoundariesTests.cs (Tests found: 10)
=======================================================

--- Method: TC_T2_NPS_01_CorruptedNdjsonFramingNegativeTest ---
Body (13 lines):
    var bridge = new GrasshopperE2EFakeBridge();
    await using var simulator = new GrasshopperPipeSimulator(bridge: bridge);
    simulator.Start();
    using var client = new NamedPipeClientStream(".", simulator.PipeName, PipeDirection.InOut);
    await client.ConnectAsync(2000);
    using var reader = new StreamReader(client, Encoding.UTF8);
    using var writer = new StreamWriter(client, new UTF8Encoding(false)) { AutoFlush = true };
    await writer.WriteLineAsync("{\"jsonrpc\": \"2.0\", \"method\": \"grasshopper.execute\", \"id\": 1");
    var resp = await reader.ReadLineAsync();
    Assert.NotNull(resp);
    using var doc = JsonDocument.Parse(resp);
    Assert.Equal(-32700, doc.RootElement.GetProperty("error").GetProperty("code").GetInt32());
    }

--- Method: TC_T2_NPS_02_UnknownRpcMethodNegativeTest ---
Body (13 lines):
    var bridge = new GrasshopperE2EFakeBridge();
    await using var simulator = new GrasshopperPipeSimulator(bridge: bridge);
    simulator.Start();
    using var client = new NamedPipeClientStream(".", simulator.PipeName, PipeDirection.InOut);
    await client.ConnectAsync(2000);
    using var reader = new StreamReader(client, Encoding.UTF8);
    using var writer = new StreamWriter(client, new UTF8Encoding(false)) { AutoFlush = true };
    await writer.WriteLineAsync("{\"jsonrpc\": \"2.0\", \"method\": \"grasshopper.non_existent_method\", \"id\": 2}");
    var resp = await reader.ReadLineAsync();
    Assert.NotNull(resp);
    using var doc = JsonDocument.Parse(resp);
    Assert.Equal(-32601, doc.RootElement.GetProperty("error").GetProperty("code").GetInt32());
    }

--- Method: TC_T2_NPS_03_EmptyStringAndWhitespaceMethodCall ---
Body (13 lines):
    var bridge = new GrasshopperE2EFakeBridge();
    await using var simulator = new GrasshopperPipeSimulator(bridge: bridge);
    simulator.Start();
    using var client = new NamedPipeClientStream(".", simulator.PipeName, PipeDirection.InOut);
    await client.ConnectAsync(2000);
    using var reader = new StreamReader(client, Encoding.UTF8);
    using var writer = new StreamWriter(client, new UTF8Encoding(false)) { AutoFlush = true };
    await writer.WriteLineAsync("{\"jsonrpc\": \"2.0\", \"method\": \"   \", \"id\": 3}");
    var resp = await reader.ReadLineAsync();
    Assert.NotNull(resp);
    using var doc = JsonDocument.Parse(resp);
    Assert.Equal(-32600, doc.RootElement.GetProperty("error").GetProperty("code").GetInt32());
    }

--- Method: TC_T2_NPS_04_MassivePayloadBoundaryTest ---
Body (14 lines):
    var bridge = new GrasshopperE2EFakeBridge();
    await using var simulator = new GrasshopperPipeSimulator(bridge: bridge);
    simulator.Start();
    using var client = new NamedPipeClientStream(".", simulator.PipeName, PipeDirection.InOut);
    await client.ConnectAsync(2000);
    using var reader = new StreamReader(client, Encoding.UTF8);
    using var writer = new StreamWriter(client, new UTF8Encoding(false)) { AutoFlush = true };
    var largePadding = new string('x', 64 * 1024);
    await writer.WriteLineAsync($"{{\"jsonrpc\": \"2.0\", \"method\": \"grasshopper.ping\", \"id\": 4, \"params\": {{\"data\": \"{largePadding}\"}}}}");
    var resp = await reader.ReadLineAsync();
    Assert.NotNull(resp);
    using var doc = JsonDocument.Parse(resp);
    Assert.True(doc.RootElement.GetProperty("result").GetProperty("pong").GetBoolean());
    }

--- Method: TC_T2_NPS_05_PrematureClientStreamSevering ---
Body (14 lines):
    var bridge = new GrasshopperE2EFakeBridge();
    await using var simulator = new GrasshopperPipeSimulator(bridge: bridge);
    simulator.Start();
    using (var client = new NamedPipeClientStream(".", simulator.PipeName, PipeDirection.InOut))
    {
    await client.ConnectAsync(2000);
    var buffer = Encoding.UTF8.GetBytes("{\"jsonrpc\":");
    await client.WriteAsync(buffer, 0, buffer.Length);
    client.Close();
    }
    using var client2 = new NamedPipeClientStream(".", simulator.PipeName, PipeDirection.InOut);
    await client2.ConnectAsync(2000);
    Assert.True(client2.IsConnected);
    }

--- Method: TC_T2_WPF_01_ExecutionAttemptWhenOptInDisabledGate ---
Body (7 lines):
    var bridge = new GrasshopperE2EFakeBridge { IsExecutionEnabled = false };
    var req = new GrasshopperExecutionRequest("return 1;");
    var result = await bridge.ExecuteAsync(req);
    Assert.False(result.Success);
    Assert.Equal(GrasshopperE2EContracts.OptInDisabledErrorCode, result.ErrorCode);
    Assert.Contains(GrasshopperE2EContracts.OptInDisabledMessageFragment, result.ErrorMessage);
    }

--- Method: TC_T2_WPF_02_ContextQueryAllowedEvenWhenOptInDisabled ---
Body (6 lines):
    var bridge = new GrasshopperE2EFakeBridge { IsExecutionEnabled = false };
    var ctx = bridge.GetContext();
    Assert.True(ctx.IsConnected);
    Assert.False(ctx.IsExecutionEnabled);
    Assert.NotNull(ctx.ActiveDefinitionName);
    }

--- Method: TC_T2_WPF_03_RapidMultithreadedOptInToggleFlipping ---
Body (8 lines):
    var bridge = new GrasshopperE2EFakeBridge();
    Parallel.For(0, 50, i =>
    {
    bridge.IsExecutionEnabled = (i % 2 == 0);
    });
    var finalState = bridge.IsExecutionEnabled;
    Assert.True(finalState || !finalState);
    }

--- Method: TC_T2_WPF_04_ExtremelyLongLastScriptPreviewTruncation ---
Body (5 lines):
    var longScript = new string('A', 500_000);
    var preview = longScript.Length > 2000 ? longScript.Substring(0, 2000) + "..." : longScript;
    Assert.True(preview.Length <= 2003);
    Assert.EndsWith("...", preview);
    }

--- Method: TC_T2_WPF_05_ClipboardExceptionResilience ---
Body (11 lines):
    bool clipboardHandled = false;
    try
    {
    clipboardHandled = true;
    }
    catch (Exception)
    {
    clipboardHandled = true;
    }
    Assert.True(clipboardHandled);
    }

=======================================================
FILE: Tier2_RegistryAndSeedBoundariesTests.cs (Tests found: 10)
=======================================================

--- Method: TC_T2_REG_01_ScriptExceeding300LinesRejected ---
Body (7 lines):
    var bridge = new GrasshopperE2EFakeBridge();
    var sb = new StringBuilder();
    for (int i = 0; i < 305; i++) sb.AppendLine($"int num{i} = {i};");
    var quality = bridge.ValidateScript(sb.ToString());
    Assert.False(quality.IsValid);
    Assert.Contains(quality.Errors, e => e.Contains("300"));
    }

--- Method: TC_T2_REG_02_UnannotatedEmptyCatchBlockRejected ---
Body (6 lines):
    var bridge = new GrasshopperE2EFakeBridge();
    var code = "try { int a = 0; } catch (Exception) { }";
    var quality = bridge.ValidateScript(code);
    Assert.False(quality.IsValid);
    Assert.Contains(quality.Errors, e => e.Contains("Empty catch"));
    }

--- Method: TC_T2_REG_03_CommentedOutCodeStatementRejected ---
Body (6 lines):
    var bridge = new GrasshopperE2EFakeBridge();
    var code = "// string temp = \"hello\";";
    var quality = bridge.ValidateScript(code);
    Assert.False(quality.IsValid);
    Assert.Contains(quality.Errors, e => e.Contains("Commented-out code"));
    }

--- Method: TC_T2_REG_04_PublishWithoutPriorTestingNegativeTest ---
Body (4 lines):
    var toolState = "draft";
    var canPublish = (toolState == "tested");
    Assert.False(canPublish);
    }

--- Method: TC_T2_REG_05_ToolNameCollisionNegativeTest ---
Body (5 lines):
    var seeds = GrasshopperE2EContracts.EmbeddedSeeds;
    var newToolName = "create_levels_grids";
    var collision = seeds.Contains(newToolName);
    Assert.True(collision);
    }

--- Method: TC_T2_SED_01_Exact300LineUpperBoundVerification ---
Body (5 lines):
    var bridge = new GrasshopperE2EFakeBridge();
    var validScript = "var x = 1;\nreturn x;";
    var quality = bridge.ValidateScript(validScript);
    Assert.True(quality.LineCount <= 300);
    }

--- Method: TC_T2_SED_02_MissingRequiredSeedParameterNegativeTest ---
Body (4 lines):
    var argsJson = "{}";
    var hasElevations = argsJson.Contains("elevations");
    Assert.False(hasElevations);
    }

--- Method: TC_T2_SED_03_ParameterFuzzingWithNegativeDimensions ---
Body (5 lines):
    double width = -500.0;
    double height = 0.0;
    var isValid = (width > 0 && height > 0);
    Assert.False(isValid);
    }

--- Method: TC_T2_SED_04_NullGeometryListInputNegativeTest ---
Body (4 lines):
    string[]? geom = null;
    var hasElements = geom != null && geom.Length > 0;
    Assert.False(hasElements);
    }

--- Method: TC_T2_SED_05_SolarRadiationDateTimeRangeBoundary ---
Body (7 lines):
    int hour = 25;
    int month = 13;
    var validHour = (hour >= 0 && hour <= 23);
    var validMonth = (month >= 1 && month <= 12);
    Assert.False(validHour);
    Assert.False(validMonth);
    }

=======================================================
FILE: Tier2_SecurityGuardBoundariesTests.cs (Tests found: 10)
=======================================================

--- Method: TC_T2_GRD_01_GlobalAliasNamespaceBypassNegativeTest ---
Body (6 lines):
    var bridge = new GrasshopperE2EFakeBridge();
    var code = "global::System.IO.File.WriteAllText(\"a.txt\", \"b\");";
    var quality = bridge.ValidateScript(code);
    Assert.False(quality.IsValid);
    Assert.Contains(quality.Errors, e => e.Contains("System.IO"));
    }

--- Method: TC_T2_GRD_02_HashRHashLoadPreprocessorDirectivesNegativeTest ---
Body (10 lines):
    var bridge = new GrasshopperE2EFakeBridge();
    var code1 = "#r \"RevitAPI.dll\"";
    var code2 = "#load \"helper.csx\"";
    var quality1 = bridge.ValidateScript(code1);
    var quality2 = bridge.ValidateScript(code2);
    Assert.False(quality1.IsValid);
    Assert.False(quality2.IsValid);
    Assert.Contains(quality1.Errors, e => e.Contains("#r"));
    Assert.Contains(quality2.Errors, e => e.Contains("#load"));
    }

--- Method: TC_T2_GRD_03_HostProcessTerminationCallsDenial ---
Body (6 lines):
    var bridge = new GrasshopperE2EFakeBridge();
    var code = "System.Diagnostics.Process.GetCurrentProcess().Kill();";
    var quality = bridge.ValidateScript(code);
    Assert.False(quality.IsValid);
    Assert.Contains(quality.Errors, e => e.Contains("System.Diagnostics"));
    }

--- Method: TC_T2_GRD_04_DocumentDisposeDenial ---
Body (6 lines):
    var bridge = new GrasshopperE2EFakeBridge();
    var code = "System.Reflection.Assembly.GetExecutingAssembly();";
    var quality = bridge.ValidateScript(code);
    Assert.False(quality.IsValid);
    Assert.Contains(quality.Errors, e => e.Contains("System.Reflection"));
    }

--- Method: TC_T2_GRD_05_BridgeInternalNamespaceTamperingDenial ---
Body (6 lines):
    var bridge = new GrasshopperE2EFakeBridge();
    var code = "System.Net.Http.HttpClient client = null;";
    var quality = bridge.ValidateScript(code);
    Assert.False(quality.IsValid);
    Assert.Contains(quality.Errors, e => e.Contains("System.Net"));
    }

--- Method: TC_T2_GRD_06_ReflectionEmitCodeGenerationDenial ---
Body (6 lines):
    var bridge = new GrasshopperE2EFakeBridge();
    var code = "System.Reflection.Emit.DynamicMethod dyn = null;";
    var quality = bridge.ValidateScript(code);
    Assert.False(quality.IsValid);
    Assert.Contains(quality.Errors, e => e.Contains("System.Reflection"));
    }

--- Method: TC_T2_GRD_07_NetworkSocketsNamespaceDenial ---
Body (6 lines):
    var bridge = new GrasshopperE2EFakeBridge();
    var code = "System.Net.Sockets.Socket socket = null;";
    var quality = bridge.ValidateScript(code);
    Assert.False(quality.IsValid);
    Assert.Contains(quality.Errors, e => e.Contains("System.Net"));
    }

--- Method: TC_T2_GRD_08_UnannotatedEmptyCatchBlockRejection ---
Body (6 lines):
    var bridge = new GrasshopperE2EFakeBridge();
    var code = "try { int x = 1; } catch { }";
    var quality = bridge.ValidateScript(code);
    Assert.False(quality.IsValid);
    Assert.Contains(quality.Errors, e => e.Contains("Empty catch"));
    }

--- Method: TC_T2_GRD_09_CommentedOutCodeRejection ---
Body (6 lines):
    var bridge = new GrasshopperE2EFakeBridge();
    var code = "// var x = doc.Objects;";
    var quality = bridge.ValidateScript(code);
    Assert.False(quality.IsValid);
    Assert.Contains(quality.Errors, e => e.Contains("Commented-out code"));
    }

--- Method: TC_T2_GRD_10_LegitimateProseCommentsAllowance ---
Body (6 lines):
    var bridge = new GrasshopperE2EFakeBridge();
    var code = "// calculate beam reinforcement parameters\nint span = 6000;";
    var quality = bridge.ValidateScript(code);
    Assert.True(quality.IsValid);
    Assert.Empty(quality.Errors);
    }

=======================================================
FILE: Tier3_CrossFeatureInteractionTests.cs (Tests found: 14)
=======================================================

--- Method: TC_T3_INT_01_CanvasReadAndBatchEditVerification ---
Body (9 lines):
    var bridge = new GrasshopperE2EFakeBridge();
    Assert.Equal(0, bridge.GetContext().ComponentsCount);
    var c1 = GrasshopperE2EHarness.AddComponentToCanvas(bridge, "Number Slider", "Slider", "Params", 100, 100);
    var c2 = GrasshopperE2EHarness.AddComponentToCanvas(bridge, "Panel", "Panel", "Params", 300, 100);
    GrasshopperE2EHarness.ConnectPortsOnCanvas(bridge, c1.Id, 0, c2.Id, 0);
    var ctx = bridge.GetContext();
    Assert.Equal(2, ctx.ComponentsCount);
    Assert.Equal(1, ctx.WiresCount);
    }

--- Method: TC_T3_INT_02_BatchEditParameterAndRunPlayerSolve ---
Body (8 lines):
    var sample = GrasshopperE2EHarness.CreateSampleTowerGraph();
    var slider = sample.Components.First(c => c.NickName == "FloorCount");
    slider.Properties["Value"] = 25.0;
    double floors = Convert.ToDouble(slider.Properties["Value"]);
    double computedHeight = floors * 3.8;
    Assert.Equal(25.0, floors);
    Assert.Equal(95.0, computedHeight);
    }

--- Method: TC_T3_INT_03_RunPlayerWithDryRunDualSafetyRollback ---
Body (7 lines):
    var bridge = new GrasshopperE2EFakeBridge { IsExecutionEnabled = true };
    var req = new GrasshopperExecutionRequest("CreateElement();", DryRun: true);
    var res = await bridge.ExecuteAsync(req);
    Assert.True(res.Success);
    Assert.True(res.RolledBack);
    Assert.Equal(0, bridge.GetCommittedElementCount());
    }

--- Method: TC_T3_INT_04_ToolRegistryDynamicLifecycle ---
Body (6 lines):
    var bridge = new GrasshopperE2EFakeBridge();
    var code = "int a = 10; return a * 2;";
    var quality = bridge.ValidateScript(code);
    Assert.True(quality.IsValid);
    Assert.True(quality.LineCount <= 300);
    }

--- Method: TC_T3_INT_05_DynamicRegistryToolRetirementRejection ---
Body (5 lines):
    var activeTools = GrasshopperE2EHarness.BuildToolSurfaceList().ToList();
    var toolToRetire = "custom_tool";
    var isRetired = !activeTools.Contains(toolToRetire);
    Assert.True(isRetired);
    }

--- Method: TC_T3_INT_06_ScriptGuardAstValidationAndCancellation ---
Body (8 lines):
    var bridge = new GrasshopperE2EFakeBridge { IsExecutionEnabled = true };
    using var cts = new CancellationTokenSource();
    cts.Cancel();
    var req = new GrasshopperExecutionRequest("CreateElement();");
    var res = await bridge.ExecuteAsync(req, cts.Token);
    Assert.False(res.Success);
    Assert.True(res.RolledBack);
    }

--- Method: TC_T3_INT_07_CanvasBatchEditAndUndoRollbackTopology ---
Body (7 lines):
    var bridge = new GrasshopperE2EFakeBridge { IsExecutionEnabled = true };
    var initComp = bridge.ActiveCanvas.Components.Count;
    var req = new GrasshopperExecutionRequest("CreateElement();", DryRun: true);
    var res = await bridge.ExecuteAsync(req);
    Assert.True(res.RolledBack);
    Assert.Equal(initComp, bridge.ActiveCanvas.Components.Count);
    }

--- Method: TC_T3_INT_08_ExecuteCodeWithRevitTransactionAndContext ---
Body (7 lines):
    var bridge = new GrasshopperE2EFakeBridge { IsExecutionEnabled = true };
    var req = new GrasshopperExecutionRequest("CreateElement();", DryRun: false);
    var res = await bridge.ExecuteAsync(req);
    Assert.True(res.Success);
    Assert.Equal(1, bridge.GetCommittedElementCount());
    Assert.True(bridge.GetContext().IsLiveCanvasAttached);
    }

--- Method: TC_T3_INT_09_ExportCanvasImagePostBatchEdit ---
Body (8 lines):
    var bridge = new GrasshopperE2EFakeBridge();
    GrasshopperE2EHarness.AddComponentToCanvas(bridge, "ClusterNode", "CN", "Math", 500, 500);
    var pngBytes = GrasshopperE2EHarness.GenerateMockPngBytes();
    Assert.Equal(0x89, pngBytes[0]);
    Assert.Equal(0x50, pngBytes[1]);
    Assert.Equal(0x4E, pngBytes[2]);
    Assert.Equal(0x47, pngBytes[3]);
    }

--- Method: TC_T3_INT_10_SeedPipelineChainingUnderDryRun ---
Body (7 lines):
    var bridge = new GrasshopperE2EFakeBridge { IsExecutionEnabled = true };
    var res1 = await bridge.ExecuteAsync(new GrasshopperExecutionRequest("create_levels_grids", DryRun: true));
    var res2 = await bridge.ExecuteAsync(new GrasshopperExecutionRequest("generate_columns_beams", DryRun: true));
    Assert.True(res1.RolledBack);
    Assert.True(res2.RolledBack);
    Assert.Equal(0, bridge.GetCommittedElementCount());
    }

--- Method: TC_T3_INT_11_OptInSecuritySwitchOverNamedPipe ---
Body (19 lines):
    var bridge = new GrasshopperE2EFakeBridge { IsExecutionEnabled = false };
    await using var simulator = new GrasshopperPipeSimulator(bridge: bridge);
    simulator.Start();
    using var client = new NamedPipeClientStream(".", simulator.PipeName, PipeDirection.InOut);
    await client.ConnectAsync(2000);
    using var reader = new StreamReader(client, Encoding.UTF8);
    using var writer = new StreamWriter(client, new UTF8Encoding(false)) { AutoFlush = true };
    await writer.WriteLineAsync("{\"jsonrpc\":\"2.0\",\"id\":1,\"method\":\"grasshopper.execute\",\"params\":{\"code\":\"return 1;\"}}");
    var resp1 = await reader.ReadLineAsync();
    Assert.NotNull(resp1);
    using var doc1 = JsonDocument.Parse(resp1);
    Assert.Equal(-32001, doc1.RootElement.GetProperty("error").GetProperty("code").GetInt32());
    bridge.IsExecutionEnabled = true;
    await writer.WriteLineAsync("{\"jsonrpc\":\"2.0\",\"id\":2,\"method\":\"grasshopper.execute\",\"params\":{\"code\":\"return 1;\"}}");
    var resp2 = await reader.ReadLineAsync();
    Assert.NotNull(resp2);
    using var doc2 = JsonDocument.Parse(resp2);
    Assert.True(doc2.RootElement.GetProperty("result").GetProperty("success").GetBoolean());
    }

--- Method: TC_T3_INT_12_MultiSessionIsolationWithCorrelatedCancellation ---
Body (10 lines):
    var bridge = new GrasshopperE2EFakeBridge { IsExecutionEnabled = true };
    using var ctsA = new CancellationTokenSource();
    ctsA.Cancel();
    var taskA = bridge.ExecuteAsync(new GrasshopperExecutionRequest("CreateElement();"), ctsA.Token);
    var taskB = bridge.ExecuteAsync(new GrasshopperExecutionRequest("CreateElement();", DryRun: false));
    var resA = await taskA;
    var resB = await taskB;
    Assert.False(resA.Success);
    Assert.True(resB.Success);
    }

--- Method: TC_T3_INT_13_SeedUpgradeAndScriptQualityCompliance ---
Body (6 lines):
    var bridge = new GrasshopperE2EFakeBridge();
    var seedCode = "// Facade panelization logic\nvar panels = new List<string>();\nreturn panels;";
    var quality = bridge.ValidateScript(seedCode);
    Assert.True(quality.IsValid);
    Assert.Empty(quality.Errors);
    }

--- Method: TC_T3_INT_14_WireReplacementLifoOrderingRollback ---
Body (7 lines):
    var bridge = new GrasshopperE2EFakeBridge();
    var n1 = GrasshopperE2EHarness.AddComponentToCanvas(bridge, "N1", "N1", "Math", 0, 0);
    var t = GrasshopperE2EHarness.AddComponentToCanvas(bridge, "T", "T", "Math", 200, 0);
    var initialWire = GrasshopperE2EHarness.ConnectPortsOnCanvas(bridge, n1.Id, 0, t.Id, 0);
    Assert.Single(bridge.ActiveCanvas.Wires);
    Assert.Equal(initialWire.SourceComponentId, n1.Id);
    }

=======================================================
FILE: Tier4_RealWorldWorkloadTests.cs (Tests found: 6)
=======================================================

--- Method: TC_T4_RW_01_ParametricTowerStructuralGridAndFraming ---
Body (9 lines):
    var bridge = new GrasshopperE2EFakeBridge { IsExecutionEnabled = true };
    var levelsRes = await bridge.ExecuteAsync(new GrasshopperExecutionRequest("create_levels_grids", DryRun: false));
    var framingRes = await bridge.ExecuteAsync(new GrasshopperExecutionRequest("generate_columns_beams", DryRun: false));
    var floorRes = await bridge.ExecuteAsync(new GrasshopperExecutionRequest("create_floors_slabs", DryRun: false));
    Assert.True(levelsRes.Success);
    Assert.True(framingRes.Success);
    Assert.True(floorRes.Success);
    Assert.Equal(3, bridge.GetCommittedElementCount());
    }

--- Method: TC_T4_RW_02_FacadeAdaptivePanelizationAndCladding ---
Body (14 lines):
    int uDivisions = 12;
    int vDivisions = 6;
    int expectedPanels = uDivisions * vDivisions;
    int expectedCornerPoints = expectedPanels * 4;
    Assert.Equal(72, expectedPanels);
    Assert.Equal(288, expectedCornerPoints);
    var parameters = new Dictionary<string, object>
    {
    ["UDivisions"] = uDivisions,
    ["VDivisions"] = vDivisions,
    ["GlazingRatio"] = 0.65
    };
    Assert.Equal(0.65, parameters["GlazingRatio"]);
    }

--- Method: TC_T4_RW_03_AutomatedBeamRebarDetailingAndStirrups ---
Body (11 lines):
    var bridge = new GrasshopperE2EFakeBridge { IsExecutionEnabled = true };
    var rebarCurvesRes = await bridge.ExecuteAsync(new GrasshopperExecutionRequest("generate_rebar_curves", DryRun: false));
    var stirrupsRes = await bridge.ExecuteAsync(new GrasshopperExecutionRequest("generate_stirrup_distribution", DryRun: false));
    Assert.True(rebarCurvesRes.Success);
    Assert.True(stirrupsRes.Success);
    Assert.Equal(2, bridge.GetCommittedElementCount());
    int denseCount = (1500 / 100) * 2;
    int sparseCount = 3000 / 200;
    int totalStirrups = denseCount + sparseCount;
    Assert.Equal(45, totalStirrups);
    }

--- Method: TC_T4_RW_04_DryRunDualSafetyAndCleanRollbackGuarantee ---
Body (10 lines):
    var bridge = new GrasshopperE2EFakeBridge { IsExecutionEnabled = true };
    var initialCommitted = bridge.GetCommittedElementCount();
    var initialComponents = bridge.ActiveCanvas.Components.Count;
    var req = new GrasshopperExecutionRequest("CreateElement(); CreateRebar();", DryRun: true);
    var result = await bridge.ExecuteAsync(req);
    Assert.True(result.Success);
    Assert.True(result.RolledBack);
    Assert.Equal(initialCommitted, bridge.GetCommittedElementCount());
    Assert.Equal(initialComponents, bridge.ActiveCanvas.Components.Count);
    }

--- Method: TC_T4_RW_05_AutonomousAiAgentToolLifecycle ---
Body (11 lines):
    var bridge = new GrasshopperE2EFakeBridge { IsExecutionEnabled = true };
    var draftCode = "int shadingIndex = 85; return shadingIndex;";
    var quality = bridge.ValidateScript(draftCode);
    Assert.True(quality.IsValid);
    var testRun = await bridge.ExecuteAsync(new GrasshopperExecutionRequest(draftCode, DryRun: true));
    Assert.True(testRun.Success);
    Assert.True(testRun.RolledBack);
    var prodRun = await bridge.ExecuteAsync(new GrasshopperExecutionRequest(draftCode, DryRun: false));
    Assert.True(prodRun.Success);
    Assert.False(prodRun.RolledBack);
    }

--- Method: TC_T4_RW_06_SolarRadiationAnalysisAndDirectShapeHeatmap ---
Body (10 lines):
    var bridge = new GrasshopperE2EFakeBridge { IsExecutionEnabled = true };
    double sunAlt = 65.0 * Math.PI / 180.0;
    double solarVectorZ = Math.Sin(sunAlt);
    Assert.True(solarVectorZ > 0.8);
    var solarRes = await bridge.ExecuteAsync(new GrasshopperExecutionRequest("evaluate_solar_radiation", DryRun: false));
    var bakeRes = await bridge.ExecuteAsync(new GrasshopperExecutionRequest("directshape_from_geometry", DryRun: false));
    Assert.True(solarRes.Success);
    Assert.True(bakeRes.Success);
    Assert.Equal(1, bridge.GetCommittedElementCount());
    }

=======================================================
FILE: Tier5_CancellationStressTests.cs (Tests found: 6)
=======================================================

--- Method: TC_T5_CNC_01_ImmediateCancellation_BeforeExecution ---
Body (8 lines):
    var bridge = new GrasshopperE2EFakeBridge { IsExecutionEnabled = true };
    using var cts = new CancellationTokenSource();
    cts.Cancel();
    var res = await bridge.ExecuteAsync(new GrasshopperExecutionRequest("CreateElement();"), cts.Token);
    Assert.False(res.Success);
    Assert.True(res.RolledBack);
    Assert.Equal(-32003, res.ErrorCode);
    }

--- Method: TC_T5_CNC_02_MidFlightCancellation_TransactionRollback ---
Body (8 lines):
    var bridge = new GrasshopperE2EFakeBridge { IsExecutionEnabled = true };
    var initial = bridge.GetCommittedElementCount();
    using var cts = new CancellationTokenSource();
    cts.Cancel();
    var res = await bridge.ExecuteAsync(new GrasshopperExecutionRequest("CreateElement();"), cts.Token);
    Assert.True(res.RolledBack);
    Assert.Equal(initial, bridge.GetCommittedElementCount());
    }

--- Method: TC_T5_CNC_03_CorrelatedCancellation_SessionIsolation ---
Body (10 lines):
    var bridge = new GrasshopperE2EFakeBridge { IsExecutionEnabled = true };
    using var ctsA = new CancellationTokenSource();
    ctsA.Cancel();
    var taskA = bridge.ExecuteAsync(new GrasshopperExecutionRequest("CreateElement();"), ctsA.Token);
    var taskB = bridge.ExecuteAsync(new GrasshopperExecutionRequest("CreateElement();", DryRun: false));
    var resA = await taskA;
    var resB = await taskB;
    Assert.False(resA.Success);
    Assert.True(resB.Success);
    }

--- Method: TC_T5_CNC_04_CancelOfCancel_NoDeadlock ---
Body (9 lines):
    bool cancelHandled = false;
    var cancelAction = new Action(() =>
    {
    cancelHandled = true;
    });
    cancelAction();
    cancelAction();
    Assert.True(cancelHandled);
    }

--- Method: TC_T5_CNC_05_ThreadRelease_BusyFlagHonesty ---
Body (6 lines):
    int busy = 1;
    var threadActive = (busy == 1);
    Assert.True(threadActive);
    Interlocked.Exchange(ref busy, 0);
    Assert.Equal(0, busy);
    }

--- Method: TC_T5_CNC_06_HighThroughputBurst_NoConnectionDrop ---
Body (14 lines):
    var bridge = new GrasshopperE2EFakeBridge();
    await using var simulator = new GrasshopperPipeSimulator(bridge: bridge);
    simulator.Start();
    using var client = new NamedPipeClientStream(".", simulator.PipeName, PipeDirection.InOut);
    await client.ConnectAsync(2000);
    using var reader = new StreamReader(client, Encoding.UTF8);
    using var writer = new StreamWriter(client, new UTF8Encoding(false)) { AutoFlush = true };
    for (int i = 0; i < 20; i++)
    {
    await writer.WriteLineAsync($"{{\"jsonrpc\":\"2.0\",\"id\":{i},\"method\":\"grasshopper.ping\"}}");
    var line = await reader.ReadLineAsync();
    Assert.NotNull(line);
    }
    }

=======================================================
FILE: Tier5_RoslynAstMutationTests.cs (Tests found: 10)
=======================================================

--- Method: TC_T5_AST_01_LineCount_Boundary300And301 ---
Body (11 lines):
    var bridge = new GrasshopperE2EFakeBridge();
    var sb300 = new StringBuilder();
    for (int i = 0; i < 300; i++) sb300.AppendLine($"int v{i} = {i};");
    var res300 = bridge.ValidateScript(sb300.ToString());
    Assert.True(res300.IsValid);
    var sb301 = new StringBuilder();
    for (int i = 0; i < 301; i++) sb301.AppendLine($"int v{i} = {i};");
    var res301 = bridge.ValidateScript(sb301.ToString());
    Assert.False(res301.IsValid);
    Assert.Contains(res301.Errors, e => e.Contains("300"));
    }

--- Method: TC_T5_AST_02_EmptyCatch_WithAndWithoutReasonComment ---
Body (8 lines):
    var bridge = new GrasshopperE2EFakeBridge();
    var codeBad = "try { int x = 0; } catch { }";
    var resBad = bridge.ValidateScript(codeBad);
    Assert.False(resBad.IsValid);
    var codeGood = "try { int x = 0; } catch { /* expected fallback */ }";
    var resGood = bridge.ValidateScript(codeGood);
    Assert.True(resGood.IsValid);
    }

--- Method: TC_T5_AST_03_CommentedOutCode_Detection ---
Body (8 lines):
    var bridge = new GrasshopperE2EFakeBridge();
    var codeBad = "// var x = 10;\nint y = 20;";
    var resBad = bridge.ValidateScript(codeBad);
    Assert.False(resBad.IsValid);
    var codeGood = "// calculate span deflection\nint y = 20;";
    var resGood = bridge.ValidateScript(codeGood);
    Assert.True(resGood.IsValid);
    }

--- Method: TC_T5_AST_04_SyntaxMutations_NoCompilerCrash ---
Body (13 lines):
    var bridge = new GrasshopperE2EFakeBridge();
    var mutations = new[]
    {
    "string s = \"unclosed;",
    "int a = 10",
    "void Test() { { int x = 1; }"
    };
    foreach (var m in mutations)
    {
    var res = bridge.ValidateScript(m);
    Assert.NotNull(res);
    }
    }

--- Method: TC_T5_AST_05_DeepBinaryExpression_StackOverflowDefense ---
Body (7 lines):
    var bridge = new GrasshopperE2EFakeBridge();
    var sb = new StringBuilder("int sum = 1");
    for (int i = 0; i < 200; i++) sb.Append(" + 1");
    sb.Append(';');
    var res = bridge.ValidateScript(sb.ToString());
    Assert.True(res.IsValid);
    }

--- Method: TC_T5_AST_06_ToolValidator_ReservedNames_Rejected ---
Body (5 lines):
    var reserved = new[] { "execute_grasshopper_code", "propose_tool", "publish_tool" };
    var candidate = "propose_tool";
    var isReserved = reserved.Contains(candidate);
    Assert.True(isReserved);
    }

--- Method: TC_T5_AST_07_ToolValidator_InvalidTransactionMode ---
Body (7 lines):
    var validModes = new[] { "auto", "manual", "none" };
    var invalidModes = new[] { "semi_auto", "destructive", "any" };
    foreach (var inv in invalidModes)
    {
    Assert.DoesNotContain(inv, validModes);
    }
    }

--- Method: TC_T5_AST_08_DynamicToolRegistrar_MutatingTool_InjectsDryRun ---
Body (4 lines):
    var transaction = "auto";
    var requiresDryRun = (transaction is "auto" or "manual");
    Assert.True(requiresDryRun);
    }

--- Method: TC_T5_AST_09_DynamicToolRegistrar_ReadOnlyTool_OmitsDryRun ---
Body (4 lines):
    var transaction = "none";
    var requiresDryRun = (transaction is "auto" or "manual");
    Assert.False(requiresDryRun);
    }

--- Method: TC_T5_AST_10_CompilerDirectives_LoadAndReference_Blocked ---
Body (6 lines):
    var bridge = new GrasshopperE2EFakeBridge();
    var code1 = "#r \"system.dll\"";
    var code2 = "#load \"file.cs\"";
    Assert.False(bridge.ValidateScript(code1).IsValid);
    Assert.False(bridge.ValidateScript(code2).IsValid);
    }

=======================================================
FILE: Tier5_SecurityOptInAndDenyListTests.cs (Tests found: 8)
=======================================================

--- Method: TC_T5_SEC_01_ExecutionDisabled_ReturnsMinus32001 ---
Body (7 lines):
    var bridge = new GrasshopperE2EFakeBridge { IsExecutionEnabled = false };
    var req = new GrasshopperExecutionRequest("return 1;");
    var res = await bridge.ExecuteAsync(req);
    Assert.False(res.Success);
    Assert.Equal(-32001, res.ErrorCode);
    Assert.Contains(GrasshopperE2EContracts.OptInDisabledMessageFragment, res.ErrorMessage);
    }

--- Method: TC_T5_SEC_02_NonExecutionMethods_PermittedWhenDisabled ---
Body (5 lines):
    var bridge = new GrasshopperE2EFakeBridge { IsExecutionEnabled = false };
    var ctx = bridge.GetContext();
    Assert.True(ctx.IsConnected);
    Assert.False(ctx.IsExecutionEnabled);
    }

--- Method: TC_T5_SEC_03_RapidOptInStateFlipping_ZeroLeakage ---
Body (7 lines):
    var bridge = new GrasshopperE2EFakeBridge();
    for (int i = 0; i < 100; i++)
    {
    bridge.IsExecutionEnabled = (i % 2 == 1);
    Assert.Equal(i % 2 == 1, bridge.IsExecutionEnabled);
    }
    }

--- Method: TC_T5_SEC_04_ForbiddenNamespace_SystemIO_Blocked ---
Body (6 lines):
    var bridge = new GrasshopperE2EFakeBridge();
    var code = "System.IO.File.Exists(\"test\");";
    var quality = bridge.ValidateScript(code);
    Assert.False(quality.IsValid);
    Assert.Contains(quality.Errors, e => e.Contains("System.IO"));
    }

--- Method: TC_T5_SEC_05_ForbiddenNamespace_SystemDiagnostics_Blocked ---
Body (6 lines):
    var bridge = new GrasshopperE2EFakeBridge();
    var code = "System.Diagnostics.Process.GetProcesses();";
    var quality = bridge.ValidateScript(code);
    Assert.False(quality.IsValid);
    Assert.Contains(quality.Errors, e => e.Contains("System.Diagnostics"));
    }

--- Method: TC_T5_SEC_06_DenyListEvasion_GlobalAlias_Blocked ---
Body (6 lines):
    var bridge = new GrasshopperE2EFakeBridge();
    var code = "global::System.IO.Directory.GetFiles(\".\");";
    var quality = bridge.ValidateScript(code);
    Assert.False(quality.IsValid);
    Assert.Contains(quality.Errors, e => e.Contains("System.IO"));
    }

--- Method: TC_T5_SEC_07_DenyListEvasion_ReflectionEmit_Blocked ---
Body (6 lines):
    var bridge = new GrasshopperE2EFakeBridge();
    var code = "System.Reflection.Assembly a = null;";
    var quality = bridge.ValidateScript(code);
    Assert.False(quality.IsValid);
    Assert.Contains(quality.Errors, e => e.Contains("System.Reflection"));
    }

--- Method: TC_T5_SEC_08_MalformedJsonRpc_SafetyRejection ---
Body (12 lines):
    var malformed = "{ invalid_json }";
    bool parseThrew = false;
    try
    {
    JsonDocument.Parse(malformed);
    }
    catch (JsonException)
    {
    parseThrew = true;
    }
    Assert.True(parseThrew);
    }

=======================================================
FILE: Tier5_SeedParameterFuzzingTests.cs (Tests found: 12)
=======================================================

--- Method: TC_T5_FUZZ_01_PlayerFilePathValidation ---
Body (7 lines):
    var invalidPaths = new[] { "", "   ", null, "nonexistent.gh" };
    foreach (var p in invalidPaths)
    {
    var valid = !string.IsNullOrWhiteSpace(p) && File.Exists(p);
    Assert.False(valid);
    }
    }

--- Method: TC_T5_FUZZ_02_PlayerInvalidExtensionRejection ---
Body (8 lines):
    var invalidExtensions = new[] { "file.dyn", "file.dwg", "file.txt", "file.exe" };
    foreach (var p in invalidExtensions)
    {
    var ext = Path.GetExtension(p).ToLowerInvariant();
    var isGh = (ext is ".gh" or ".ghx");
    Assert.False(isGh);
    }
    }

--- Method: TC_T5_FUZZ_03_CanvasNanInfinityCoordinatesRejection ---
Body (6 lines):
    var bridge = new GrasshopperE2EFakeBridge();
    Assert.Throws<ArgumentException>(() =>
    GrasshopperE2EHarness.AddComponentToCanvas(bridge, "NanNode", "N", "Test", double.NaN, 0));
    Assert.Throws<ArgumentException>(() =>
    GrasshopperE2EHarness.AddComponentToCanvas(bridge, "InfNode", "I", "Test", 0, double.PositiveInfinity));
    }

--- Method: TC_T5_FUZZ_04_CanvasNegativePortIndicesRejection ---
Body (8 lines):
    var bridge = new GrasshopperE2EFakeBridge();
    var id1 = Guid.NewGuid();
    var id2 = Guid.NewGuid();
    Assert.Throws<IndexOutOfRangeException>(() =>
    GrasshopperE2EHarness.ConnectPortsOnCanvas(bridge, id1, -1, id2, 0));
    Assert.Throws<IndexOutOfRangeException>(() =>
    GrasshopperE2EHarness.ConnectPortsOnCanvas(bridge, id1, 0, id2, -5));
    }

--- Method: TC_T5_FUZZ_05_CanvasCyclicSelfConnectionRejection ---
Body (5 lines):
    var bridge = new GrasshopperE2EFakeBridge();
    var id = Guid.NewGuid();
    Assert.Throws<InvalidOperationException>(() =>
    GrasshopperE2EHarness.ConnectPortsOnCanvas(bridge, id, 0, id, 1));
    }

--- Method: TC_T5_FUZZ_06_SearchToolsOversizedQueryHandling ---
Body (4 lines):
    var oversized = new string('q', 10_000);
    var truncated = oversized.Length > 200 ? oversized.Substring(0, 200) : oversized;
    Assert.Equal(200, truncated.Length);
    }

--- Method: TC_T5_FUZZ_07_SearchToolsLimitClamping ---
Body (7 lines):
    var limits = new[] { -50, 0, 500, int.MaxValue };
    foreach (var l in limits)
    {
    var clamped = Math.Clamp(l, 1, 200);
    Assert.True(clamped is >= 1 and <= 200);
    }
    }

--- Method: TC_T5_FUZZ_08_LevelsGridsEmptyElevationsRejection ---
Body (4 lines):
    var elevations = Array.Empty<double>();
    var valid = elevations.Length > 0;
    Assert.False(valid);
    }

--- Method: TC_T5_FUZZ_09_ColumnsBeamsZeroLengthRejection ---
Body (5 lines):
    double x1 = 0, y1 = 0, x2 = 0, y2 = 0;
    double len = Math.Sqrt(Math.Pow(x2 - x1, 2) + Math.Pow(y2 - y1, 2));
    var valid = len > 0.001;
    Assert.False(valid);
    }

--- Method: TC_T5_FUZZ_10_FloorsSlabsNonClosedPolygonRejection ---
Body (7 lines):
    var polygon = new List<(double X, double Y)>
    {
    (0, 0), (10, 0), (10, 10), (0, 10), (1, 1)
    };
    var isClosed = polygon.Count >= 3 && polygon.First() == polygon.Last();
    Assert.False(isClosed);
    }

--- Method: TC_T5_FUZZ_11_StirrupDistributionNonPositiveSpacingRejection ---
Body (5 lines):
    double dense = 0.0;
    double sparse = -10.0;
    var valid = (dense > 0 && sparse > 0);
    Assert.False(valid);
    }

--- Method: TC_T5_FUZZ_12_JsonSerializationNullCharResilience ---
Body (4 lines):
    var rawJson = "{\"title\": \"Node\\u0000Test\"}";
    using var doc = JsonDocument.Parse(rawJson);
    Assert.NotNull(doc.RootElement.GetProperty("title").GetString());
    }
