Lightingsang/AddinRebar/(commit log)

2026-09-12 feat(mcp): Revit MCP server, bridge add-in and self-extending tool registry
    Two processes: HPRebar.Mcp.Server (net10 stdio, ModelContextProtocol 2.2.0)
    talks to HPRebar.McpBridge (Nice3point add-in, R25/R26) over a named pipe
    with JSON-RPC 2.0 NDJSON; HPRebar.Mcp.Contracts is the only shared assembly
    and HPRebar.McpBridge.Core holds every Revit-free part of the bridge.
    Scripts sent by the AI are guard-checked and compiled with Roslyn on the
    pipe thread, then run on Revit's API thread inside an undoable
    TransactionGroup with dryRun, cooperative timeout, opt-in switch and audit
    log. Core tools: execute_revit_code (with an `args` data slot),
    get_revit_context, inspect_type, cancel_execution; re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
2026-09-14 docs(plans): revise AutoCAD MCP bridge plan for one-MCP-per-folder layout
    - ADR-06: McpShared/ holds Contracts, McpBridge.Core and the extracted
    HPRebar.Mcp.Server.Core; HPAutoCad/ gets its own server exe, bridge
    loader/bridge, tests and solution; ADR-01 server part superseded
    - ADR-04: registry root per product, seeds embedded per exe, host field
    kept as metadata; no seed relocation
    - architecture, phases 0-5 and plan.md updated (paths, pipe name,
    build/test commands, ResolveConfigurationsModule pin, user decisions)
2026-09-14 refactor(mcp): move Contracts and McpBridge.Core into McpShared
    Host-neutral libraries now live in a top-level McpShared/ folder with their
    own solution so the Revit and AutoCAD MCPs can share them without either
    folder referencing the other. Assembly names and namespaces are unchanged;
    HPRebar.slnx and the three consuming csproj files point at ../McpShared.
2026-09-14 refactor(mcp): make McpBridge.Core host-neutral
    - Contracts: PipeNaming.For(host, version), autocad.* method names with
    suffix matching helpers, ContextResult.Host/HostVersion/Autocad,
    HostScriptContracts (default imports and globals per host). Additive
    only; the deployed Revit bridge stays wire-compatible.
    - Core: IRevitExecutor -> IBridgeExecutor; RequestDispatcher dispatches
    on the method suffix and answers with the caller's prefix; ScriptGuard
    and ScriptAnalyzer take a GuardProfile/AnalyzerProfile (Revit profile
    is the default and unchanged); ScriptUnits for mm <-> host units;
    BridgeSettingsStore is per vendor/product; McpBridgeHost and the
    status view model move into Cor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
2026-09-14 refactor(mcp): extract HPRebar.Mcp.Server.Core into McpShared
    The host-neutral half of the MCP server exe — bootstrap, pipe client,
    result formatter, execute/context services, the tool registry engine and
    its meta tools, the toolify prompt and the registry CLI — moves to a
    class library so the AutoCAD server can share it. IHostProfile is the
    seam: every engine constructor defaults to the Revit profile, so the
    existing tests run unchanged; pipe methods, pipe name, registry root and
    seed assembly all derive from the profile. The Revit exe keeps a
    15-line Program.cs, its four core tool/prompt/resource classes and the
    embedded seed library. tools/list of the published exe is byte-identical
    b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
2026-09-14 test(mcp): move engine tests to McpShared and add host-neutrality tests
    Pipe round-trip, bridge-unavailable, compiler, args/analyzer and guard
    tests follow the engine into McpShared/HPRebar.Mcp.Server.Core.Tests;
    the Revit test project keeps the seed-library and registry tests that
    need the seeds embedded in the exe and links the shared fake executor.
    New tests pin the shareability rules: no host API assembly referenced,
    per-host pipe names and settings paths, suffix-based dispatch that
    answers the autocad.* prefix, the AutoCAD guard/analyzer profiles and
    ScriptUnits. 66 + 105 = 159 original + 12 new.
2026-09-14 docs: describe the McpShared and HPAutoCad folders
    Repository layout, MCP project table, test commands and the bridge
    load-bearing facts now reflect the extracted engine; AGENTS.md is the
    engine-generated mirror.
2026-09-14 fix(mcp): address phase-0 review findings
    - Status view model takes a required UI-thread marshaller; the Revit
    command passes the WPF dispatcher (SynchronizationContext.Current is
    not guaranteed on Revit's UI thread), and the executor raises
    StateChanged inside its try so a UI subscriber can never leave the
    bridge busy.
    - BridgeOptions.PipeName and RegistryOptions.LibraryPath/DbPath ignore a
    value equal to their computed default, and the profile is applied
    before as well as after binding: the configuration binder writes
    getter values back through setters and would otherwise pin the Revit
    pipe and registry root into every host (ProfileOptionsBindingTests).
    - McpServerHost reje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
2026-09-14 feat(autocad): bridge loader with isolated load context, bundle and phase-1 spike
    HPAutoCad.McpBridge.Loader is the assembly AutoCAD loads: IExtensionApplication,
    the HPMCP* commands and a BridgeLoadContext that resolves the bridge's own
    Roslyn 5.9 / System.Collections.Immutable 10 from its deps.json while the
    AutoCAD API stays in the default context. HPAutoCad.McpBridge is loaded
    into it by reflection and hands back its entry points as delegates; it wires
    Serilog, settings, the script compiler with the AutoCAD script contract and
    runs a scripting self-check at start-up. The DeployBundle target copies the
    autoloader bundle to ApplicationPlugins after a Debug build.
    Spike run unattended in A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
2026-09-14 fix(autocad): address phase-1 review findings in the loader and spike
    - Script compiler references AcMgd, AcCoreMgd and AcDbMgd; scripts can use
    Application.DocumentManager like every AutoCAD sample
    - Spike commands refuse to run unless HPAUTOCAD_MCP_SPIKE=1 is set; they draw
    into the active drawing and the quit variant discards it
    - Idle one-shot completes the request before unsubscribing on timeout so a late
    tick never runs stale work; background part catches its own exceptions
    - Unattended quit uses CloseAndDiscard + Application.Quit on Idle ticks
    (verified: acad.exe exits 0); the ExecuteInApplicationContext step is dropped
    after it blocked the spike indefinitely
    - Load context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
2026-09-14 fix(autocad): address phase-2 review findings
    - MainThreadQueue: requests older than the busy grace are refused even on a
    quiescent tick, cancelled tokens are never started, monotonic clock; grace
    lowered to 8 s so the server sees the busy code before its own timeout;
    three more queue tests
    - Executor audits refused requests, maps a pre-start cancel to a readable
    failure, caches the main window handle on the main thread
    - Runner uses the document transaction manager throughout, creates both
    transactions inside the try, rejects a script that ended `tr` through an
    alias, prints "read-only" for none runs
    - Guard denies LockDocument in AutoCAD scripts; serializer handles
    ObjectIdCo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
2026-09-14 docs: record phase 2 of the AutoCAD MCP bridge
    - CLAUDE.md/AGENTS.md: bridge runtime section (wire methods, idle queue,
    two-transaction policy and the guard rule behind it, change counting,
    undo behaviour, harness), test count 88
    - codebase-summary, system-architecture, changelog: runtime components,
    Core additions, verification evidence
    - journal entry and PM status report for phase 2
2026-09-14 fix(autocad): address phase-3 review findings
    - Modify prompt example creates the target layer when the drawing lacks it
    - execute_autocad_code description trimmed to 1717 chars; context description
    says docPath is absent for an unsaved drawing
    - ContextService also drops isFamily for non-Revit hosts (Revit unchanged)
    - Server exe no longer sets its own assembly version (matches the Revit exe)
    - Harness: PowerShell 7.3 requirement, bounded JSON excerpts with -Depth,
    mcp-call.py drains the server's stderr on a thread
2026-09-14 feat(autocad): live verification harness and stability-window fixes
    - run-live-verify.ps1 + live-verify.py + mcp-session.py: one stdio session
    through the execute matrix (busy -> ESC -> retry automated), every seed
    with a real block and a pickfirst set, MISS -> propose -> test -> publish
    -> CLI approve -> tools/list_changed -> call by name, quarantine ->
    restore -> new version -> re-approve, the Revit exe beside, a second
    AutoCAD failing fast on the pipe and Civil 3D not loading the bundle
    - registry: argument errors are the caller's and never count against a
    tool's stability; the window restarts at the last approve/restore/new
    version so a restored tool is not re-quarantined b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
2026-09-14 feat(autocad): ribbon tab for the MCP bridge
    - loader builds the "MCP AutoCAD" tab (Autodesk.Windows): connection
    panel (status window, start/stop listener, status, live state label),
    tools panel (copy last script, tool library folder), settings panel
    (logs, audit, auto-start toggle, guide); created once the Ribbon exists,
    re-created after a workspace switch, FindTab-guarded, removed on Terminate
    - every button forwards to a bridge entry point; the bridge adds four
    additive ones (status.subscribe, copyLastScript, autoStart.get/set, path)
    that pass only BCL types across the load context
    - commands and buttons share BridgeActions; icons are vector drawings
    - bundle 0.2.0 ships READ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
2026-09-14 fix(autocad): address ribbon tab review findings
    - icons follow COLORTHEME (readable on the dark and light Ribbon),
    cutouts are even-odd holes; the tab rebuilds on a theme change
    - the status subscription carries the auto-start flag so the Ribbon
    toggle and the window checkbox stay in sync; the callback is guarded
    across the load context
    - ItemInitialized stays hooked (covers RIBBON after RIBBONCLOSE);
    Uninstall resets its state; a re-entrancy guard on EnsureCreated
    - status label in a row panel, shorter text; the loader ships README.md
    in bin too so a NETLOAD try-out's guide button works
    - harness: baseline presses Tắt listener when the pipe is already up,
    a whole-run no-failu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
2026-09-15 feat(mcpshared): multi-target the bridge engine to net48 and add the Navisworks profile
    - HPRebar.McpBridge.Core builds net8.0 and net48; every net48-specific line sits behind #if NET48 (PipeSecurity owner ACL in place of PipeOptions.CurrentUserOnly, Stopwatch clock, IReadOnlyCollection instead of IReadOnlySet), so the net8.0 asset is unchanged (Core .cs diff: additions only)
    - GuardProfile.Navis / AnalyzerProfile.Navis, PipeNaming.NavisHost, JsonRpcMethods.NavisPrefix, HostScriptContracts.NavisImports/NavisGlobals, ContextResult.Navis (NavisInfo, ModelSummary)
    - IHostProfile.MaxTimeoutSeconds (default 120) drives the clamps in ExecuteCodeService, ToolManager.RunAsync and ToolValidator; Revi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
2026-09-15 fix(mcpshared): deny reflection by expression tree and delegate in every host's script guard
    - ScriptGuard base list: namespace System.Linq.Expressions; identifiers Expression, Delegate; members CreateDelegate, Compile, Method — Expression.Call(obj, "Name").Compile(), Delegate.CreateDelegate(type, target, "Name") and a delegate's .Method reached members by string without naming a denied type
    - GuardProfile.Navis drops the entries the base list now covers
    - five new escape samples in ScriptGuardTests (also linked into the net48 suite)
    - Revit (21 seeds) and AutoCAD (12 seeds) test suites unchanged at 109/58; engine 126, net48 58; tools/list of both rebuilt servers byte-identical
    - CLAUDE.md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
2026-09-15 feat(navis): scaffold HPNavis and verify the MCP bridge plugin live in Navisworks Manage 2026
    New top-level HPNavis/ (mirrors HPAutoCad/, references ../McpShared only): net48 plugin
    HPNavis.McpBridge with a narrow AssemblyResolve allow-list, Roslyn self-check, main-thread
    executor on Application.Idle + WM_NULL wake, progress/modal quiescence, commit-then-Rollback
    of the bridge's own undo entry, host-side heavy-operation gate, minimal status window, and
    an unattended spike harness (Roamer.exe direct launch, UI Automation opt-ins, named-pipe
    scenarios). Spike passes 2/2 in Roamer.exe: plugin loads without a prompt, self-check OK,
    W1 edits/dryRun/exception/guard/heavy/timeout/cancel, clash run,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
2026-09-15 feat(navis): harden the bridge runtime and verify it unattended in Navisworks Manage 2026
    - NavisUndoDecision: the commit-then-rollback table as pure code (label made unique
    against the undo top, one line, bounded; "ours" only when the entry appeared with
    our label; Keep/DryRun/Failure/NoneViolation); a dry run whose change persisted
    without an undo entry is now an error instead of a clean success.
    - Serializer: JSON is written through a bounded stream with the Stream overload, so
    the walk stops at MaxOutputBytes instead of serialising the whole value first;
    Navisworks collections enumerate at most 200 items and stop.
    - Timeout ceiling captured on the pipe thread with the heavy ver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
2026-09-15 feat(navis): add the HPNavis.Mcp.Server stdio exe and verify it end-to-end against the live bridge
    - HPNavis.Mcp.Server (net10): one-line Program over McpServerHost, NavisHostProfile (pipe
    hpnavis-mcp-2026, prefix navis., registry root %AppData%\HPNavis\McpServer, 600 s ceiling),
    execute_navis_code / get_navis_context with the Navisworks script contract (.NET Framework 4.8
    limits, document units, Search over Descendants, the writability classes, heavy opt-in and
    HEAVY diagnostic, fingerprint-based none, rolledBack semantics), prompts navis_query_template
    and navis_review_template, resources navis://document/info and navis://selection. Never
    references the Navisworks API.
    - HPNavi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
2026-09-15 feat(navis): embed the 12 Navisworks seed tools and verify them live through the registry
    - Registry/SeedLibrary: 8 read-only (get_model_info, get_selected_item_properties,
    find_items_by_property, list_selection_sets, list_viewpoints, get_clash_results,
    get_timeliner_tasks, summarize_by_category), 3 review edits (create_selection_set_from_search,
    create_viewpoint, override_color_by_search) and one heavy tool (create_and_run_clash_test,
    tags heavy, 600 s). Every input through args, millimetres at the boundary, searches through
    Search + SearchCondition with the walk bounded, bad input surfaces as ArgumentException.
    - BridgeEntry.CreateScriptCompiler: one factory for Roamer and for th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
2026-09-15 feat(navis): add the Ribbon tab HPNavis > MCP > MCP Bridge to the Navisworks plugin
    Mirrors the Revit MCP bridge ribbon (product tab, panel "MCP", one button
    "MCP Bridge" that opens or activates the bridge status window) with a
    purpose-drawn icon rendered pixel-exact at 16 and 32 px.
    - HPNavisRibbonPlugin (CommandHandlerPlugin): [RibbonLayout]/[RibbonTab]/
    [Command] attributes, CallCanExecute.Always, ExecuteCommand ->
    BridgeEntry.ShowWindow() with a message box when the bridge never started.
    - Ribbon/en-US/HPNavisRibbon.xaml + .name (Navisworks layout and strings),
    Ribbon/Images/McpBridge_16|32.png rendered from one vector glyph (window
    with a plug) by tools/icons/render-ribbon-icon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
2026-09-16 feat(autocad): reduce the Ribbon to the Revit-style HPAutoCad > MCP > MCP Bridge surface
    The 0.2.0 tab carried three panels and ten buttons, every one of them a
    control the bridge status window already has. Bundle 0.3.0 keeps one
    panel "MCP" with one button "MCP Bridge" that opens that window, the
    same surface as the Revit and Navisworks bridges. The tab id stays
    HPAUTOCAD_MCP_TAB; the workspace/COLORTHEME re-creation logic is kept.
    Icon: one frozen vector DrawingImage drawn in code (window + plug, the
    glyph shared with the Navisworks bridge), every coordinate even so the
    16 px image is an exact half of the 32 px one; ink follows COLORTHEME,
    plug in the HP MCP blue.
    Removed with the button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
2026-09-16 feat(autocad): AEC phases D-E — QA/QC audit + markup and structural tools (20 AEC seeds)
    Phase D (QA/QC): CadStandardsRuleSet (embedded cad-standards.default.json or
    rules\cad-standards.json via the shared RuleFileLocator), a pure
    CadStandardsChecker over records + DrawingTables, the shared AuditIssue record
    with a stable severity order, AuditService (geometry per space + standards in
    one report, GEO-/STD- ids kept) and IssueMarkupService (circle / rectangle /
    revcloud + MLeader per issue, drawn in the space of its entities). Seeds
    cad_standards_check, audit_aec_drawing (none), create_issue_markup (auto).
    Phase D review round: empty exemption lists exempt nothing, MaxIssueLimit 100
    (150 b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
2026-09-16 feat(autocad): AEC phase F — rooms from walls, boundary check, room tags, area schedule, rule-driven dimensions
    Architecture/: RoomLoopFinder + WallGraph + OpeningBridger find rooms as the
    bounded faces of the wall drawing (pieces cut at crossings and T-junctions,
    gaps within tolerance.roomGap closed, doorways bridged from facing wall ends
    or facing jamb lines, dangling chains peeled with short overshoots counted,
    wall cavities and the outer line of double-line walls dropped); Room +
    RoomLabelRules + RoomLabels read name / number / department from the text
    lines inside a room by caller patterns; RoomBoundaryChecks report open ends,
    one gap per facing pair, closed gaps, assumed openings, in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
2026-09-17 feat(etabs): HPEtabs MCP phase 1 — standalone bridge app, server exe, COM spike on ETABS 22
    - HPEtabs/ mirrors HPAutoCad/: HPEtabs.slnx, global.json, Directory.Build.props (install dir via CLSID LocalServer32, no NuGet, ETABSv1.dll Private=false)
    - HPEtabs.McpBridge (WPF net8.0-windows): STA worker over MainThreadQueue, COM Attach/Detach with eager liveness, two opt-ins, fail-closed R/W/D tier gate, forced kN_mm_C units, static preview, spike probes
    - HPEtabs.Mcp.Server (net10 stdio): EtabsHostProfile, execute_etabs_code, get_etabs_context, resources, prompts
    - Tests: bridge 46, server 17; live harness (disabled/detached/spike/nomodel/modal/closed) under tools/harness
    - Spike E9–E20 veri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
2026-09-17 feat(autocad): AEC phase G — MEP network graph, connectivity check, endpoint listing
    Mep/: MepNetworkBuilder turns pipe / duct / cable tray runs and equipment,
    fixture, terminal and fitting nodes into networks — a run end connects within
    tolerance.endpointConnection to another run's end, a run's body (including its
    own loop, never the segment it sits on) or a node; a node is attached to every
    run ending on it or passing through it; direct connections join runs while a
    node joins only runs of the same system, so supply and return meet at an AHU
    without merging and a node belongs to every network it touches; crossings are
    counted, never connected; duplicates are same-system runs drawn over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
2026-09-17 feat(etabs): HPEtabs MCP phase 2 — semantic tiers, save + .EDB snapshot, fingerprint, path policy
    - Tier fixture Resources/etabs-oapi-tiers.txt (1 281 rows: 733 R / 446 W / 102 D) generated from the installed ETABSv1.dll by tools/generate-oapi-tier-fixture.ps1 and reviewed by hand; CHM index snapshot with a 100 % coverage test
    - EtabsTierAnalyzer binds every OAPI call through the script's own semantic model (aliases, casts, lambdas, method groups resolve to the same member; unknown members are destructive); file-taking members accept only a string literal or args.Str("key") on the bridge's args global
    - EtabsSnapshotManager: presave copy when the file on disk was not written by the bridge,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
2026-09-17 feat(autocad): AEC phase H — clash check and opening requests in plan
    Adds the coordination tools of the AEC engine: aec_clash_check (read-only)
    and aec_create_opening_requests (auto), with the review round applied.
    - Coordination/ClashClassifier: a meeting in plan is a hard_clash only when
    an MEP element interpenetrates a member or another service's run; joints,
    tees, equipment on runs, doors in walls and members meeting are contacts
    (info); rooms and slabs holding their floor are area overlaps (info);
    clearance clashes are located at the closest vertex-foot pair.
    - Coordination/ClashDetector: broad phase over set B grown by the clearance,
    pairs only within one space, same-set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
2026-09-17 feat(etabs): HPEtabs MCP phase 3 — 12 embedded seed tools, seed tests, live seed harness
    - Registry/SeedLibrary: 8 read-only seeds (model info, stories/grids, structural objects, materials/sections, load definitions, joint reactions, frame forces, modal results), 3 writes (draw frame, assign section, assign load) and the destructive run_analysis; tools/list = 24
    - Seeds are generated by tools/generate-seed-library.py from OAPI signatures read by reflection; tool.json.notes names the members; results seeds validate object names before the case-status check, assign_frame_load passes CSys=Local for the local directions, run_analysis validates cases before touching the run flags and reports fa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
2026-09-17 feat(etabs): HPEtabs MCP phase 4 — full live harness from the publish folders, registry loop, host regression; plan complete
    - Harness phase registry (search miss → ad-hoc run → get_run/toolify_run → propose_tool → test_tool → publish_tool → CLI approve → listed within 0.5 s → call by name; a fragile tool is quarantined after five failures, restored with a guarded version and survives five caller errors)
    - run-live-verify.ps1 -Phase full [-Publish] [-Runs n]: every phase on one isolated registry root per run, both exes published first and run from HPEtabs/output; result 3 × 102 checks pass on ETABS 22
    - Results seeds refuse a defined-but-not-run load case as a caller error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
2026-09-17 feat(autocad): AEC phase I — logical change sets (record, preview, commit, rollback)
    Completes the AEC automation plan (phases A–I). A change set is a list of
    write-tool calls recorded instead of applied, replayed in one run and undone
    by handle.
    - Every write seed takes changeSetId; its AecTools method starts with
    ChangeSetRecorder.TryRecord (known tool, valid op — manage_xrefs attach
    only —, every handle the call names opened as an entity; args kept).
    - ChangeSets/: ChangeSetLedger (pending → committed → rolled_back | closed,
    pending → discarded; 20 live sets with the oldest commit closed at the cap,
    200 ops, 64 KB args), UndoRule (a commit or rollback undone by dryR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
2026-09-17 feat(etabs): bridge app icon for the exe and the status window
    One vector glyph rendered by tools/icons/render-app-icon.ps1 into a
    multi-size .ico (16..256, PNG entries): a three-storey structural frame
    on its foundation with the MCP plug's cable running into the middle
    beam. The exe embeds it (ApplicationIcon: Explorer, taskbar, Alt-Tab)
    and the WPF window shows it in its title bar (Window.Icon). Same family
    as the Revit/AutoCAD/Navisworks MCP glyphs (host + plug in #0696D7).
2026-09-17 feat(skills): add hp-mcp-autocad skill for the AutoCAD MCP
    Teaches the agent the 62 tools of the hprebar-autocad server: the
    connection checklist (bundle, ribbon opt-in, .mcp.json, get_autocad_context
    first), a decision tree from reading a drawing through AEC classification,
    checks, structural / architecture / MEP / coordination tools, batch writes
    with dryRun, change sets (record → preview → commit → rollback), the
    execute_autocad_code script contract, toolify, an error → action table and
    a security policy.
    - references: five tool-catalog files generated from tools/list by
    scripts/generate-tool-catalog.py, script-contract, six verified
    workflows, troubleshooting.
    - scripts/chec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
2026-09-17 feat(skills): add hp-mcp-navisworks skill for the Navisworks MCP
    Teaches the agent the 24-tool surface of the hprebar-navis server the way
    the Revit, AutoCAD and ETABS skills do: connection checklist (plugin folder,
    ribbon HPNavis > MCP > MCP Bridge, the two opt-ins, .mcp.json), decision tree
    seed-first / script-second, the bridge-owned transaction and its undo
    decision (dryRun rolls back only the bridge's own entry; camera moves and
    temporary overrides persist), the heavy gate (append / merge / save / export /
    clash runs: second opt-in, never undone, not interruptible, 600 s ceiling,
    literal paths screened), .NET Framework 4.8 limits, guard list, error table,
    security policy.
    References: t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
2026-09-17 feat(skills): add hp-mcp-etabs skill for the ETABS MCP
    The ETABS counterpart of the hp-mcp-* skills, authored with the ETABS plan
    and left untracked until now: the 24-tool surface of the hprebar-etabs
    server (connection through the standalone bridge app and Attach, the R/W/D
    tier decided statically before a run, the .EDB snapshot before every write,
    the destructive opt-in, kN_mm_C units), a tool catalog, the script contract
    with ETABSv1 patterns, an OAPI cheatsheet read by reflection from the
    installed wrapper, a troubleshooting table, a read-only health check and
    trigger evals. The .agents mirror follows the sync engine: SKILL.md rendered,
    every other file verbatim.
2026-09-17 docs(skills): hp-mcp-navisworks — record the live-verified get_navis_context shape
2026-09-17 feat(revit): vector ribbon icons for the rebar tools and the MCP bridge
    Replace the template PNGs (a generic 3D box, reused for Foundation Rebar
    and the empty Execute button, plus the bridge's own pair) with glyphs drawn
    in code: one frozen 32x32 DrawingImage per button, built by
    Resources/Icons/RibbonIcons.cs and assigned straight to Image/LargeImage.
    Column Rebar is a column section with a tie and four corner bars, Beam
    Rebar a beam elevation with top/bottom bars and stirrups, Foundation Rebar a
    footing with its column stub and bottom mat, Execute a play triangle, and
    MCP Bridge the window-with-plug glyph shared with the AutoCAD and Navisworks
    bridges (the file is linked into HPRebar.McpBr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
2026-09-18 feat(civil3d): scaffold HPCivil3d bridge and server, spike against Civil 3D 2026
    Fifth HP MCP host. HPCivil3d/ holds the AutoCAD bridge copied and re-tokened
    (tools/mirror-tokens.json), with the Civil additions: a `civil` script global
    (CivilDocument), units from the Civil drawing settings (Meters/Feet, "." = no
    zone), a civil3d context block with object counts, Civil types in the result
    serializer, Aec* in the load context, and a bundle with Platform="Civil3D".
    Directory.Build.props locates C3D\ (parameter, HPCIVIL3D_C3D_DIR, registry) and
    fails the bridge with one readable error when Civil 3D is missing while the
    server still builds. HPCivil3d.Mcp.Server is the minimal net10 stdio server
    (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
2026-09-18 feat(skills): hp-mcp-civil3d skill for the Civil 3D MCP
    Teaches the agent to drive Civil 3D 2026 through the hprebar-civil3d
    server: connection checklist, the millimetre-versus-drawing-unit rule,
    seed tools with their paging caps, dryRun-first writes, the
    execute_civil3d_code contract, toolify and the error table. References
    carry the tool catalog generated from the published exe's tools/list,
    the script contract, a Civil API cheatsheet limited to members exercised
    on the dev machine, and troubleshooting. Scripts: a read-only health
    check and the catalog generator. Mirrored to .agents/skills by the sync
    engine; routing rule, CLAUDE.md, AGENTS.md and docs updated.
2026-09-18 feat(hpgeo): VN-2000 to WGS84 KMZ add-in for AutoCAD 2026
    New standalone folder HPGeo/ (own slnx): HPGeo.Core (TM-3 inverse and
    forward, 7-parameter Helmert in the coordinate-frame convention, 34 + 63
    province table extracted from the reference HTML tool, converter with the
    tool's validation order, KML/KMZ writer and reader, pasted-text parser,
    import planner), HPGeo.AutoCad (drawing reader in WCS with tolerance-based
    arc flattening, drawing writer, two WPF dialogs sharing one CRS block,
    WebView2 satellite map, per-drawing Xrecord and per-user JSON settings) and
    HPGeo.AutoCad.Loader (zero-dependency entry AutoCAD loads: commands, ribbon
    tab, isolated AssemblyLoadContext for the add-in and it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
2026-09-18 docs: HPGeo section in CLAUDE.md and regenerated AGENTS.md
    Repository layout row and a section with the facts not derivable from the
    code: the oracle and its 0.80 m sibling, the invariants and defaults, the
    command surface, the KML additions, why the loader + AssemblyLoadContext
    layout is mandatory on AutoCAD 2026, the harness gotchas and known gaps.
    AGENTS.md regenerated with the sync engine's rewrite table.
2026-09-19 feat(rules): antigravity routing rule for direct answer, quick fix and planning mode
    Adds .claude/rules/antigravity-workflow.md: a routing table that decides
    between answering directly, a quick fix (<= 2 hand-edited files, build or
    test verifiable) and Planning Mode (>= 3 files, new folder/feature/dependency,
    project or manifest changes, McpShared wire contract, irreversible actions),
    the stop-for-confirmation rule, terse communication limits, artifact
    placement, relative-link citation rules and three routing examples. It
    references the Response Format section of CLAUDE.md instead of repeating it.
    CLAUDE.md gains one Workflows bullet pointing at the rule; AGENTS.md is
    regenerated from CLAUD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
2026-09-19 feat(skills): port grill-me interview skill
    Project skill .claude/skills/grill-me (SKILL.md + 6 evals) from the HPSTRBIM
    spec: interview and pressure-test a request into a requirement contract
    before planning. Mirror .agents/skills/grill-me generated by the sync engine.
    The user-scope plugin grill-me@grill-me (codebase quiz) is untouched.
2026-09-19 feat(hprebar): MaterialDesignInXAML 5.3.2 theme bridge, live Revit theme, vector window icons
    Merge MaterialDesignThemes into HPRebar.dll (ILRepack) behind a bridge layer:
    MaterialBridge.xaml (CustomColorTheme #0696D7/#E0641E + MD2 defaults, legacy
    style keys re-based on the toolkit, MaterialDesignFont pinned to Segoe UI) is
    merged first by Theme.xaml; MaterialThemeBridge builds one top-level overlay
    (HP palette + toolkit brushes derived from the Color.* tokens) and swaps it in,
    because a nested dictionary change never repaints a shown window. Windows now
    follow Revit's UI theme live (Application.ThemeChanged -> RevitHostTheme) and
    take their title-bar icon from the vector RibbonIcons throug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
2026-09-19 feat(mcp-bridges): MaterialDesign theme for the Revit MCP bridge and the ETABS bridge app
    Revit bridge: link HPRebar's theme helper (now assembly-neutral: palette URIs
    from the linking assembly, Color.*/Brush.* tokens, Func<bool, ImageSource> icon)
    together with MaterialBridge.xaml, repack only the toolkit into
    HPRebar.McpBridge.dll (Roslyn stays loose), drop the last ThemeSwitcher copy and
    the retired Buttons/TextBoxes dictionaries, let the footer caption wrap.
    ETABS bridge: MaterialBridge.xaml for the bridge vocabulary, ThemeLight/ThemeDark
    palettes (dark is new, accent unified on the product blue), WindowsHostTheme
    following the Windows app mode with an HPETABS_MCP_BRIDGE_THEME override,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
2026-09-19 docs(plan): ETABS live-verify bridge phase 48/48 on the MaterialDesign window
2026-09-19 Material design
2026-09-26 feat(kata-export): export a straight beam run to the open Kata workbook
    Rebuild the pyRevit/Dynamo "Kata Export to Excel" tool as the HPRebar
    feature KataExport (ribbon HPRebar > Rebar > Kata Export).
    - Core (HPRebar.Core/KataExport): 1D segmenter over stations along the
    beam axis (supports by union of extents, joints, free ends), row
    builder for B3:B10 and rows 11/19/21/22/23, Excel cell rules, support
    rules for tie beams (footing slabs > 100 mm and <= 6000 mm along the
    run are supports, lean concrete ignored), elevation builder and
    viewport.
    - Revit readers: run reader on uncut geometry, support collector with
    probe lines (columns, walls, footings, crossing beams, columns abov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
2026-09-28 feat(kata-rebar): draw a one-span beam from sheet Dam of the open Kata workbook
    Reads sheet Dam over COM, checks row 11 and B5/B6 against the beam measured
    with the Kata Export readers (2 mm silent, 50 mm refuse, either direction),
    and draws top/bottom main bars (G2/G3 anchorage, bent at the far support face
    when short, bottom leg moved inboard when legs overlap) and three closed
    stirrup sets (G7/G8, J9 cover to bar centre / stirrup face) in one undo step.
    - split the layout calculator into rules, anchorage, main bar, stirrup zone,
    scope filter, geometry check and planner classes
    - parse stirrup sections per column pair of rows 25-44; end the column list
    at the first empty row-11 cell
    -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
2026-09-28 feat(kata-rebar): draw additional top bars over the supports (rows 13-16)
    Row 13 bars share the main-bar level and fill the gaps between the main
    bars; rows 14-16 stack below at a clear gap of max(25, d). Bars reach
    H5 x L (row 13, from I5) or H3 x L (rows 14-16, from I3) into the span,
    L being the larger adjacent clear span, and anchor in end supports like
    the main top bars with lower-level bends set inboard. A "left;right"
    cell gives the bars on each side of the support.
    - move the bottom main bar leg inboard of the innermost overlapping top leg
    - block layer stacks the beam depth cannot hold; warn about cells that
    draw nothing and about bars closer than the minimum clear spacing
    - read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
2026-09-28 feat(kata-export): read the bars back from sheet Dam, preview them and draw them in Revit
    Kata Export now closes the loop: after the user fills sheet Dam, "Đọc thép
    Excel" plans the sheet on the beams Revit measures (on the API thread) and
    draws the layout on the elevation canvas with a section card; "Tạo thép
    Revit" re-plans the same sheet and creates the bars. The Kata Rebar window
    keeps working through the same workflow service.
    - multi-span runs over one or several framing elements; at an interior
    support with different sides the bars share the slots across the beam,
    the side with more steel crosses to the far face and bends, the other
    runs straight on G2*d into the next sp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
2026-10-01 fix(kata-rebar): wrap C-tie hooks round their bars and draw ties on the elevation
    A C tie (side-bar tie or upright inner tie) now names the bars it wraps;
    the model side lays it out from the bar type's bend radius so each hook
    turns round its own bar. The elevation draws inner stirrups and ties at
    their stations and the section card rings the wrapped bars.
    - the UI driver toggles check boxes through the toggle pattern
2026-10-01 feat(kata-rebar): apply the beam detailing rules of the Kata spec
    - Stagger the additional top bars over each support: every filled row
    reaches at least G1 (default 500 mm) beyond the furthest bar end of the
    next filled row inside it, rounded up to the cut step and held at the
    face of the support across the span with a warning. The weaker side of
    a left/right cell counts as an end of its row but is never moved.
    - Read G1 only as one positive number; anything else falls back to the
    settings and is reported.
    - Dense stirrup zones are max(2h, 0.25 Ln), at most half the span; zones
    that meet get no sparse middle zone, no duplicate station and no gap
    wider than the dense spacing; an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
2026-10-02 feat(kata-rebar): match the Kata drawings of T2-DY7 and T2-DY14
    Longitudinal bars:
    - Bars of one cell with two or more evenly spaced positions are one
    Fixed Number rebar set; a lone bar stays a single rebar.
    - Bars and sets that Revit pulls towards the cover (across the beam or
    up/down) are moved back to their planned place after creation.
    Stepped soffits and supports (Kata beam-node detail):
    - Each span takes its own depth, B5 minus row 21.
    - The bottom main bars crank 1:6 across a step only when the bar is
    at least 16 mm and (step - bar) / support width <= 1/6. Otherwise they
    are cut: the shallow bar runs 30d past the face, the deep bar bends up
    at the far face. Tightly overlapp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
2026-10-02 feat(kata-rebar): number the bars as Kata does and tag them on the elevation
    Bar numbers:
    - Every bar, bar set and stirrup zone gets a bar number, in the order of
    the Kata drawings: main top, main bottom runs, support top bars
    support by support, span bottom bars span by span, side bars, C ties,
    inner stirrups, hoops.
    - Identical bars share a number: same diameter, shape and dimensions
    within 1 mm, mirror images included.
    - The Revit schedule mark is now the bar number. The internal mark
    still groups the Fixed Number sets.
    Elevation tags in Kata Export (toggle "Hiện số hiệu"):
    - At supports and spans, the main bars and the outer row share one tag
    (e.g. "1+4 2Ø18+1Ø18").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
2026-10-03 feat(kata-export): draw the run as Kata's elevation drawing on the canvas
    With the bars shown, the elevation canvas now reproduces Kata's elevation
    of the beam (T2-DY7.dwg, DY7 and DY14) in model millimetres:
    - section cuts "MAT CAT n-n" with a section card, flags at every cut
    - bar tags and bar lines laid out as Kata's leaders, rows and polylines
    - outline with column stubs and break lines, hidden column tops and slab
    - dimension chains: supports and stirrup zones, bar cuts, grids, extra
    bar stagger, beam depth and slab; stirrup runs; grid bubbles, level
    mark and title
    - bars drawn half a bar and half a stirrup nearer their face, only the
    first and last stirrup of each zone, lineweig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
2026-10-03 feat(kata-export): show Kata's section n-n beside the elevation
    Clicking a section flag on Kata's elevation shows that section in a panel on
    the right of the canvas, drawn as T2-DY7.dwg draws its sections: slab with
    break lines, width and depth dimensions, title, hoop with bent corners and
    135-degree hooks, ties, bars as kata_block_THEP, leaders with their arrow
    blocks, marking circles on inner layers and KHT tags. The flags of the section
    shown are highlighted; a span click shows its middle cut again; with the bars
    hidden the old corner card stays.
    The section is built in HPRebar.Core (KataSectionDrawingBuilder) and checked
    entity by entity against nine sections of the drawing.
2026-10-03 fix(mcp): keep AI code execution off on every AutoCAD and Civil 3D start
    The AutoCAD and Civil 3D bridges forced "Allow AI code execution" on when
    they loaded, and their windows said "On by default". Both now start with it
    off, as the Revit bridge does again, and the three bridge windows say so.
    The Civil 3D mirror pin follows the AutoCAD bridge entry back.
2026-10-03 fix(beam): place every bar group with the cover entered in the window
    Spans were read with a 25 mm placeholder cover that the span stirrups and
    the additional, side and special bars used, while the main bars and the
    preview used the cover typed by the user.
2026-10-03 build(rebar): add an editorconfig that mirrors the current code style
2026-10-03 test(foundation): pin the side-cover boundary at equality for length and width
2026-10-03 refactor(rebar): delete the ribbon glyph no button uses
2026-10-03 test(foundation): pin the whole mesh output before restructuring the calculator
2026-10-03 test(beam): pin the support top bars before restructuring their calculator
2026-10-03 test(beam): pin the main bars before restructuring their calculator
2026-10-03 test(beam): add an explicit bottom hook case to the main bar characterization
2026-10-03 test(beam): record the hash of the explicit bottom hook case
2026-10-03 test(beam): pin the span stirrup runs before restructuring their calculator
2026-10-03 test(beam): pin right cantilevers, a long single span and node runs
2026-10-03 refactor(column): tighten the moved rules and previews after review
2026-10-03 fix(beam): treat supports within 1 mm of equally near as a tie when choosing the bottom lap
    Feet-to-millimetre rounding must not move a symmetric beam's lap to the
    earlier support. Adds tests for an asymmetric three-span stack and the
    near-tie case, corrects the log claim that every 3- and 4-span result is
    unchanged, and logs B-27..B-29 found in review.
2026-10-03 refactor(foundation): fit the footing plan frame in Core with tests
    FoundationSolidFaceReader.Read now only reads the bottom outline from
    Revit; choosing the plan direction and fitting the rectangle moved to
    FoundationPlanFrameCalculator in HPRebar.Core, computed in millimetres.
    Logs B-30: a near-square footing's axis is decided by rounding noise.
2026-10-03 refactor(beam): arrange support nodes in Core with tests
    BeamSupportFinder.FindSupports now only collects and measures the
    columns, walls and girders under the run; merging duplicates, cantilever
    tips, stand-in joints, classification and the no-support fallback moved
    to BeamSupportLayout in HPRebar.Core. Logs B-31 (grid-based merge) and
    B-32 (overlapping framing elements).
2026-10-03 refactor(beam): compute section stations and assemble spans in Core with tests
    SectionViewCreator.ComputeCutStations/PlannedCount become
    BeamSectionStations, and the span block of BeamStackReader.Read becomes
    BeamSpanAssembly.Between, both in HPRebar.Core. Logs B-33: a fallback
    span between overlapping supports runs past the right support.
2026-10-04 fix(core): check bar counts against Revit's limit before they become an int
    A spacing so small that the count passed int.MaxValue wrapped to a
    negative number and slipped under the 1002-bar limit, then failed later
    with a List capacity error. Beam and Column rules and calculators and
    the Foundation validation now compare in double and cast after the
    check; finite results and NaN behaviour are unchanged. Logs B-36.
2026-10-04 fix(beam): merge duplicate supports by distance instead of a 100 mm grid
    Rounding centres to a 100 mm grid kept one column found at 6040 and
    6060 mm as two supports (an extra node and span) while merging finds
    98 mm apart. A find is now one support with the last kept one when its
    centre is less than 100 mm away. Logs B-37.
2026-10-04 fix(beam): refuse NaN and infinity for stirrup spacings, offsets and support centres
    Plain <= 0 checks let NaN and infinity through, which produced NaN
    stirrup positions or a List capacity error, and a NaN support centre
    dropped every real support. The Beam calculator, the window rules and
    the support layout now check through FiniteNumber in HPRebar.Core;
    finite inputs behave as before. Logs B-38 and B-39.
2026-10-04 fix(beam): check side-bar and cross-tie spacings and hold their counts to the bar limit
    Zero, negative or non-finite side-bar spacings silently became 300 or
    400 mm, and a tiny spacing made a million cross-ties per row or
    overflowed. On a run deep enough for side bars the window now refuses
    them and refuses row or cross-tie counts above 1002, counted by the
    calculator's own CountRows/CrossTiesPerRow, which throws past the limit
    too. Logs B-40.
2026-10-04 fix(beam): stop the elevation preview freezing Revit on a runaway start offset
    The stirrup ticks started at the start offset and stepped until the
    right face: -Infinity never got there and a huge negative offset took
    billions of steps on the UI thread, before the window could validate
    the input. The painter now skips the ticks for a non-finite offset and
    draws at most 5000 ticks per span.
2026-10-04 fix(core): refuse NaN and infinity in Column and Foundation inputs
    Tie spacing, cover and cross-tie legs (Column) and spacings, diameters
    and covers (Foundation) were checked with <= 0 / < 0, which NaN and
    infinity pass. They now go through FiniteNumber; finite inputs keep
    their results, messages and order.
2026-10-04 test(column): pin the bar geometry of the recorded pipeline cases apart from the full hash
2026-10-04 feat(rebar): use the current selection when it already holds valid elements
    Column, Beam and Foundation Rebar skip the pick prompt when the elements
    selected before the click include ones the command's filter accepts.
    Nothing valid selected keeps the old prompt, Esc and validation as they
    were. Foundation takes the selection only when exactly one slab is in it.
2026-10-04 feat(skills): point CLAUDE.md, AGENTS.md and the MCP skills at the core standard
    The governance section of CLAUDE.md covers every MCP folder and names the
    core standard, the host appendices and the propose_tool quality gate; the
    same text is inserted into AGENTS.md by hand (never regenerated). Each
    hp-mcp skill explains which findings block a proposed tool, which only
    warn, and what "quality not analysed" means. Test counts updated.
2026-10-04 docs: record the script-quality check and the core standard
    Changelog entry and the plan with its scout maps, baseline, evaluation,
    reviews, live verification and the tools/list before-snapshot.
    [summary.tsv]
2026-10-04 docs(plan): record the quality-gate live checks on seven hosts
    Revit, Navisworks, ETABS, Robot, Power BI, AutoCAD and Civil 3D pass 5/5
    with redeployed Debug bridges; Excel waits for the user's workbook to be
    closed, SAP2000 and Tekla are not installed. Four tooling and UI defects
    found on the way are logged as H-09..H-12.
2026-10-04 feat(kata-rebar): draw beam B01 with stepped tops, span widths, consoles and span main bars
    - Sheet Dam rows 19/20/21 carry over span to span; an interior zero-width
    support joins its spans into one with a top step; an end 0 is a console.
    - Top bars follow each span's top (crank 1:6 or cut and lap); bars are cut
    where the width or the span's own main bars change, each piece takes its
    span's bars with laps sized from its own diameter.
    - Console: top bars to tip - a bent down to one bar above the console's own
    bottom bars, bottom bars anchored with a clamped 10d leg, extras to the tip.
    - Kata Export writes row 20 (crossing beam bxh at supports, span width and
    side bars) and keeps the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
2026-10-04 feat(kata-rebar): honour row 24 "*" and draw row 17/18 bars through a zero-width joint
    - Row 24 "*" at a support (no joint stirrups) is reported as kept: HPRebar
    draws no joint stirrups at any support.
    - Rows 17/18 at a support of no width become the joined span's additional
    bottom bars, cut by the span rule, when the span has none of its own and
    the joint lies between L/6 and 5L/6; otherwise they are reported.
    - Rows 17/18 at a support with a width, or an unreadable one, are reported
    instead of dropped; "0" and "-" count as blank.
2026-10-05 feat(kata-rebar): match beam B01 to Kata's drawing and write Kata numbers to Rebar Number
    Canvas sections and elevation of B01 now follow Kata's T2-DY7 drawing,
    checked by tests against a JSON fixture exported from the DWG:
    - annotation rows scale with the elevation; stirrups stay inside the
    concrete; flags, chain dims and grid top lift with the stirrup tag row
    - cantilever cut at L/3; hoop hook 40; inner layers at d + 25 pitch;
    U/C hooks drawn as half circles
    - inner stirrups (rows 25-27) carried to the next spans and cut at top
    steps; spacer C ties only for three-bar layers; layer-2 bars over a
    width change spread per span without two bars on one line
    - Kata's numbering order, incl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
